effibot/thesis_latex/img/setup.jpeg

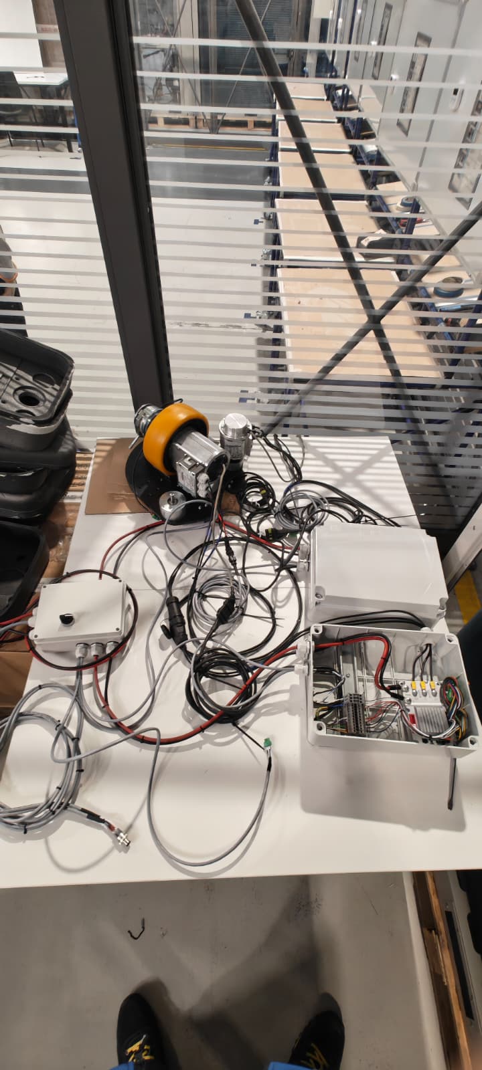
img/setup.jpeg
