effibot/thesis_latex/img/daikin/daikin_factory_ext.jpg

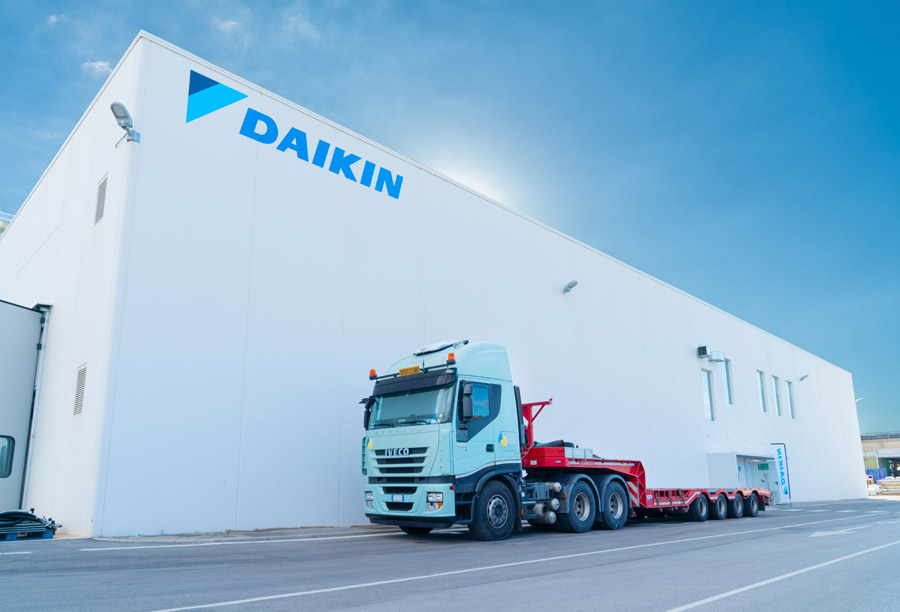
img/daikin/daikin_factory_ext.jpg
