effibot/thesis_latex/README.md

# master_thesis
 Repo for my Master Thesis in Robotics and Automation Engineering
