effibot/thesis_latex/sections/section2.tex

% Sezione 2: Robot Mobili e Algoritmi di Navigazione
\section{Stato dell'arte: robot mobili, navigazione e protocolli}

% Slide 1: Classificazione
\begin{frame}
    \frametitle{Classificazione dei Robot Mobili}

    \begin{block}{AMR vs AGV}
        \begin{itemize}
            \item \textbf{AGV}: Percorsi fissi, infrastruttura dedicata, bassa flessibilità.
            \item \textbf{AMR}: Navigazione autonoma, adattabilità, nessuna infrastruttura.
        \end{itemize}
    \end{block}

    \textbf{Tipologie di Locomozione}
    \begin{itemize}
        \item \textbf{Ruote}: Differential drive, omnidirezionali.
        \item \textbf{Cingoli}: Terreni irregolari.
        \item \textbf{Zampe}: Ambienti complessi.
        \item \textbf{Volanti}: Droni/UAV.
    \end{itemize}

\end{frame}

% Slide 2: Algoritmi di Navigazione
\begin{frame}
    \frametitle{Algoritmi di Navigazione}
    \begin{columns}
        \column{0.5\textwidth}
        \textbf{Path Planning (Globale)}
        \begin{itemize}
            \item \textbf{A*}: Ricerca ottima su griglia.
            \item \textbf{Dijkstra}: Ricerca esaustiva.
            \item \textbf{RRT}: Esplorazione probabilistica.
        \end{itemize}

        \column{0.5\textwidth}
        \textbf{Obstacle Avoidance (Locale)}
        \begin{itemize}
            \item \textbf{VFH}: Istogramma polare ostacoli.
            \item \textbf{DWA}: Ottimizzazione velocità ($v, \omega$).
            \item \textbf{Potential Fields}: Campi di forze.
        \end{itemize}
    \end{columns}
    \begin{block}{Localizzazione}
        Tecniche per stimare la posizione del robot nell'ambiente.
        \begin{itemize}
            \item \textbf{Odometry}: Basata su encoder e IMU, soggetta a deriva.
            \item \textbf{Beaconing}: Utilizzo di segnali esterni (es. RFID).
            \item \textbf{SLAM}: Simultaneous Localization and Mapping.
        \end{itemize}
    \end{block}
\end{frame}

% Slide 3: SLAM e FAST-LIO 2
\begin{frame}
    \frametitle{SLAM: FAST-LIO 2}
    \textbf{Problema}: Stimare posa e mappa simultaneamente in assenza di GPS.

    \vspace{0.5cm}
    \begin{block}{Perché FAST-LIO 2?}
        Algoritmo LiDAR-Inertial Odometry (LIO) allo stato dell'arte\footnote{Xu et al. "FAST-LIO2: Fast Direct LiDAR-Inertial Odometry", 2022;}.
        \begin{itemize}
            \item \textbf{Robustezza}: Funziona in ambienti spogli (corridoi lunghi) grazie alla \textit{registrazione diretta} (no feature extraction).
            \item \textbf{Efficienza}: Struttura \textbf{ikd-Tree} per aggiornamento mappa veloce ($>100$ Hz).
            \item \textbf{Accuratezza}: Fusione sensoriale (tightly-coupled) LiDAR + IMU.
            \item \textbf{Testato}: Già validato sul sensore acquistato (Livox Mid-360).
        \end{itemize}
    \end{block}
\end{frame}

% Slide 4: Architettura FAST-LIO 2
% \begin{frame}
%     \frametitle{Architettura FAST-LIO 2}
%     \begin{figure}[htbp]
%         \centering
%         \includegraphics[width=\textwidth]{2/fastlio2_block_diagram.png}
%         \caption{Schema semplificato: IMU $\to$ Predizione $\to$ Correzione (LiDAR) $\to$ Mappa.}
%     \end{figure}
% \end{frame}

% Slide 5: Protocolli Industriali - bus CAN
\begin{frame}
    \frametitle{Protocolli di Comunicazione: CAN Bus}
    \textbf{Controller Area Network (CAN)}: bus seriale multi-master per autoveicoli.
    \begin{block}{Caratteristiche Principali}
        \begin{itemize}
            \item \textbf{Architettura Multi-Master}: Tutti i nodi possono trasmettere.
            \item \textbf{Arbitraggio Non-Distruttivo}: Priorità basata su ID messaggio.
            \item \textbf{Rilevamento Errori}: CRC, bit stuffing, monitoraggio ACK.
            \item \textbf{Velocità}: Fino a 1 Mbps su brevi distanze.
        \end{itemize}
    \end{block}

    \begin{block}{Applicazioni Industriali}
        Utilizzato in automotive, automazione industriale, robotica mobile.
    \end{block}
\end{frame}
% Slide 5: Protocolli Industriali - CANopen
\begin{frame}
    \frametitle{Protocolli di Comunicazione: CANopen}
    \textbf{CANopen}: protocollo applicativo su CAN per automazione industriale.\\

    \begin{columns}
        \column{0.5\textwidth}
        \textbf{Componenti Principali}
        \begin{itemize}
            \item \textbf{Object Dictionary (OD)}: dizionario parametri dispositivo.
            \item \textbf{PDO}: messaggi real-time (velocità, encoder).
            \item \textbf{SDO}: configurazione parametri (client-server).
            \item \textbf{NMT}: gestione stati nodi.
        \end{itemize}

        \column{0.4\textwidth}
        \begin{block}{Estensione: Profilo CiA 402}
            \begin{itemize}
                \item Standard per azionamenti elettrici
                \item Macchina a stati
                \item Modalità: Velocity, Position, Torque
            \end{itemize}
        \end{block}
    \end{columns}
\end{frame}
% \begin{frame}
%     \frametitle{Protocolli di Comunicazione: CANopen}
%     \begin{block}{Scelta per il Progetto}
%         \begin{itemize}
%             \item Standardizzazione CiA 402 (driver Mini-Traction Power)
%             \item Determinismo temporale (PDO sincronizzati)
%             \item Diagnostica integrata (heartbeat, emergency)
%             \item Interoperabilità (batteria + driver compatibili)
%         \end{itemize}
%     \end{block}
% \end{frame}

% Slide 6: Panoramica Altri Protocolli
% \begin{frame}
%     \frametitle{Altri Protocolli Industriali}
%     \textbf{Alternative valutate} (non adottate per il progetto):

%     \vspace{0.3cm}
%     \begin{table}[htbp]
%         \centering
%         \small
%         \begin{tabular}{|l|p{6cm}|p{4cm}|}
%             \hline
%             \textbf{Protocollo} & \textbf{Caratteristiche}                             & \textbf{Limitazioni}                    \\
%             \hline
%             \textbf{EtherCAT}   & Ethernet industriale, latenze $<$ 1 ms, master-slave & Hardware dedicato, maggiore complessità \\
%             \hline
%             \textbf{PROFINET}   & Ethernet Siemens, alta integrazione IT               & Meno diffuso in robotica mobile         \\
%             \hline
%             \textbf{Modbus TCP} & Semplice, su TCP/IP                                  & Latenze non deterministiche             \\
%             \hline
%         \end{tabular}
%     \end{table}

%     \vspace{0.3cm}
%     \begin{alertblock}{Motivazione Scelta CANopen}
%         Miglior compromesso tra prestazioni, standardizzazione (profili CiA 402), disponibilità componenti compatibili e costi contenuti.
%     \end{alertblock}
% \end{frame}
