effibot/thesis_latex/chapters/frontespizio.tex

% Frontespizio - Template Università di Roma Tor Vergata
\begin{titlepage}
    \centering

    % Intestazione università e facoltà
    {\Large\bfseries UNIVERSITÀ DEGLI STUDI DI ROMA TOR VERGATA}\\[0.3cm]
    {\large MACROAREA DI INGEGNERIA}

    \vspace{1cm}

    % Logo università (inserisci il file logo_torvergata.png in img/)
    

    \vspace{1cm}

    % Corso di studio
    {\large\bfseries CORSO DI LAUREA MAGISTRALE IN}\\
    {\itshape Ingegneria dell'Automazione}

    \vspace{0.8cm}

    % Tesi di laurea
    {\large\bfseries TESI DI LAUREA IN}\\
    {\itshape Analisi e Sintesi di Sistemi Non Lineari}

    \vspace{0.8cm}

    % Titolo
    {\large\bfseries TITOLO}\\
    {\itshape Progettazione e Realizzazione di un \\Veicolo da Trasporto Teleoperato in CANOpen}

    \vspace{1.5cm}

    % Relatore e Laureando affiancati
    \begin{minipage}[t]{0.48\textwidth}
        \raggedright
        \textbf{Relatore:}\\
        Chiar.mo Prof.\\
        \textit{Daniele Carnevale}\\[0.8cm]
        \textbf{Correlatore:}\\
        \textit{Roberto Masocco}, Ph.D.\\
        Ing. \textit{Moreno Mattia}
    \end{minipage}
    \hfill
    \begin{minipage}[t]{0.48\textwidth}
        \raggedleft
        \textbf{Laureando:}\\
        \textit{Andrea Efficace}\\
        Matricola: 0300125
    \end{minipage}

    \vfill
    {\large\bfseries Anno Accademico 2024/2025}
\end{titlepage}
