effibot/thesis_latex/on_progress.pdf

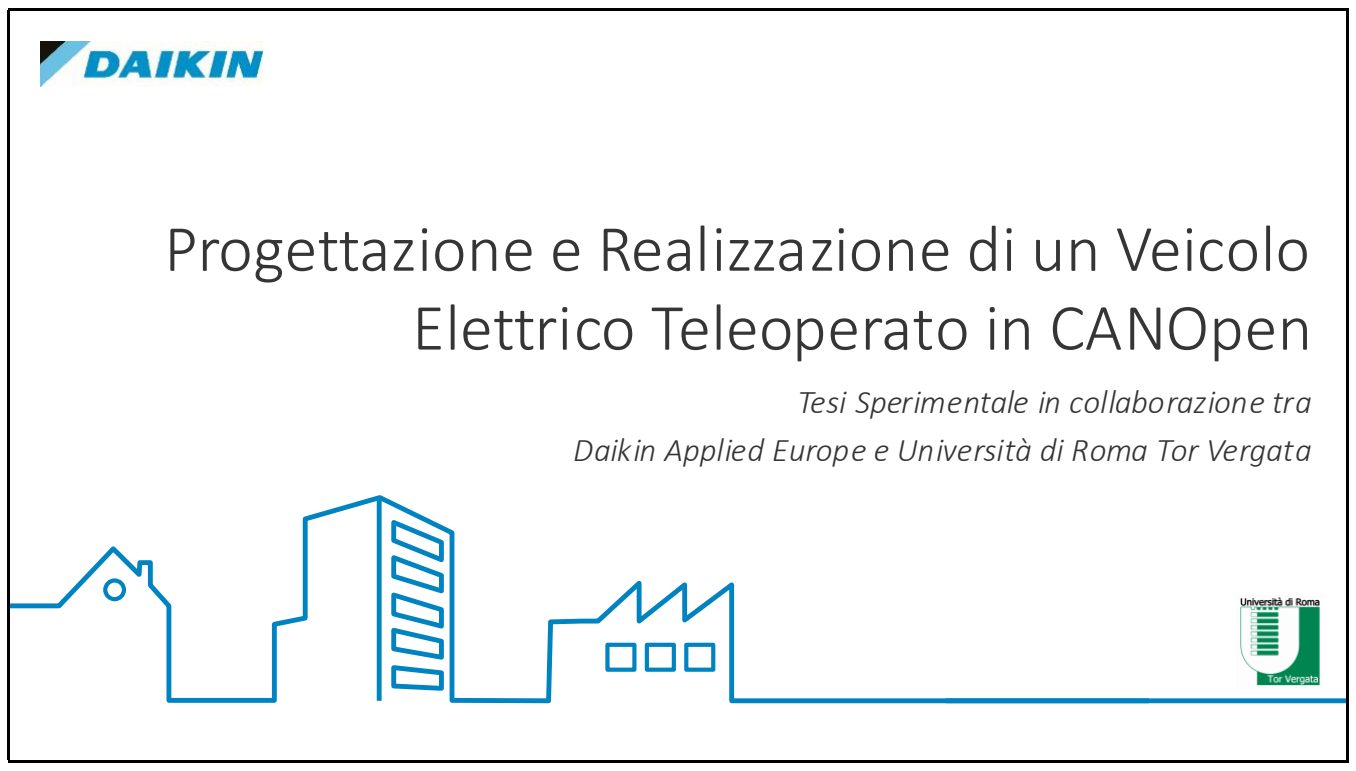
[picture p3: figure]
Top secret Secret Internal use only Public; Elettrico Teleoperato in CANOpen; Tesi Sperimentale in collaborazione tra

# Progettazione e Realizzazione di un Veicolo

Daikin Applied Europe e Università di Roma Tor Vergata

## 1. Introduzione

## 2. Definizione del Problema

## 3. Obiettivi di Progetto e Design

## 4. Selezione Componenti

## 5. Architettura di Comunicazione e Controllo

## 6. Stato dei Lavori

3

# Introduzione

## La realtà di DAE e l’importanza dell’automazione

1.

4 Introduzione

- Produzione di macchinari industriali per la climatizzazione
- Produzione Make-to-Order e poco standardizzata
- Forte crescita della domanda
- Espansione della produzione e del personale
- Scarsa digitalizzazione dei processi produttivi (non R&D)
- Grande necessità di automatizzazione:
- Gestione documenti
- Tracciabilità dei componenti
- Logistica

La Realtà di Daikin Applied Europe - Cecchina

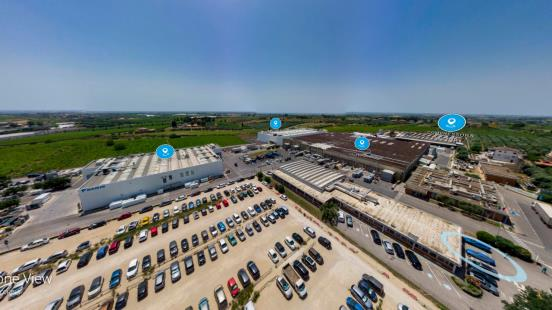
[picture p4: figure]

Fig. 1: Stabilimento di Cecchina (RM)

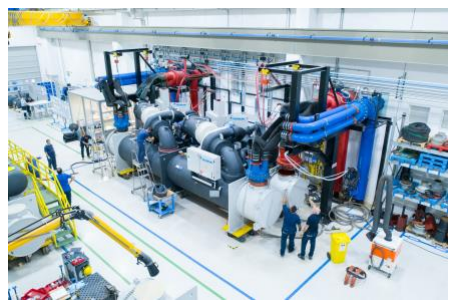
[picture p5: figure]

Fig. 2: Banco Prova Chiller

5 Introduzione

Tipologia di movimentazione ad Oggi:
- Manuale
- O tramite muletti
- Basata su richieste giornaliere dei responsabili di produzione
- Ad alto costo per la mano d’opera
- Con notevoli ritardi e rallentamenti di produzione dovuti alla ricerca del pezzo

Tipologia di Movimentazione Futura:
- Attuata con una flotta di veicoli elettrici
- Controllati tramite sistemi di guida autonoma / controllo remoto
- Mediante un sistema centralizzato di schedulazione e gestione della logistica
- Con un costo ammortizzabile negli anni
- Permettendo ottimizzazioni nei processi produttivi, dalla supply chain fino alla delivery

L’idea di un Veicolo Autonomo per il trasporto di sottoassiemi e semilavorati

6

# Definizione del Problema

# Realizzare da zero un veicolo autonomo

2.

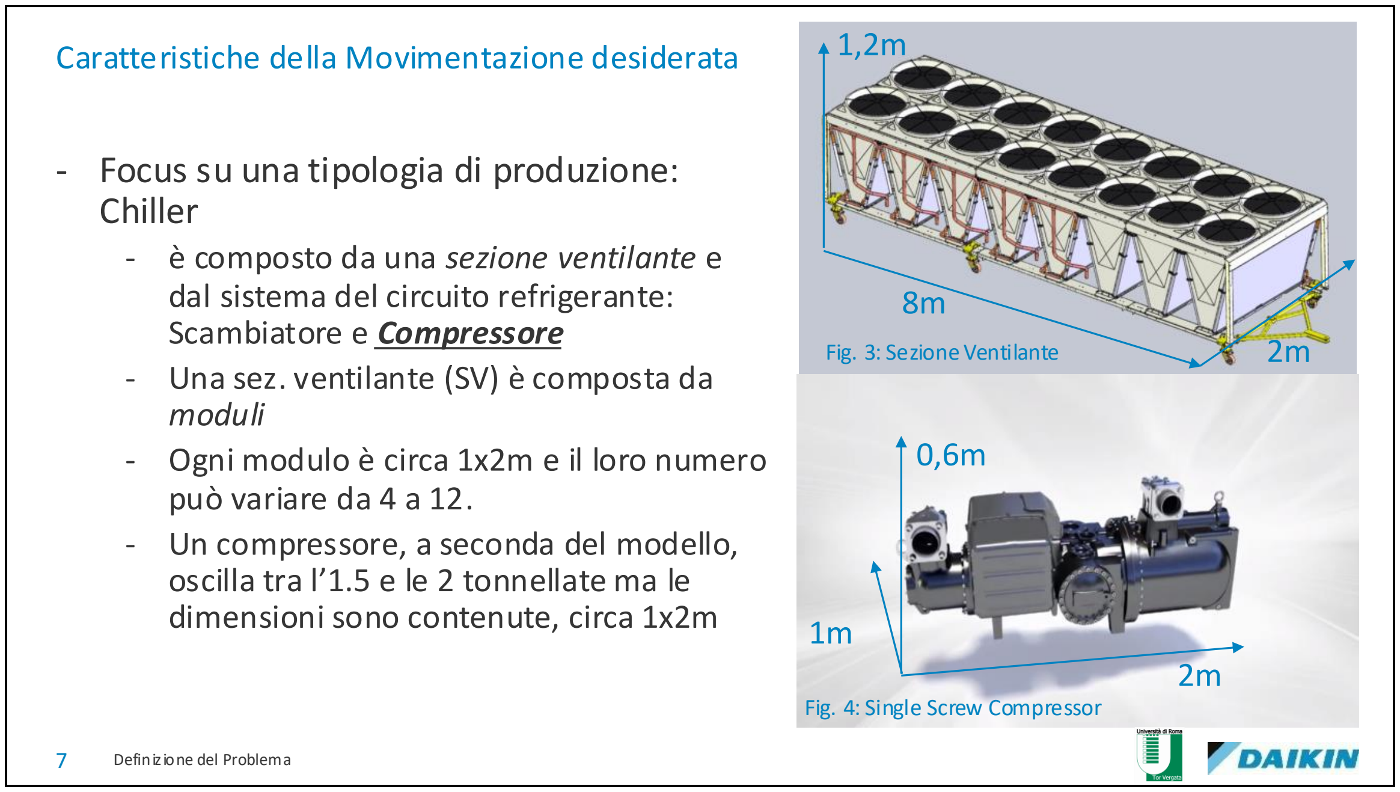
[picture p6: figure]
Definizione del Problema; Caratteristiche della Movimentazione desiderata; - Focus su una tipologia di produzione: Chiller; dal sistema del circuito refrigerante: Scambiatore e Compressore; moduli; può variare da 4 a 12.; dimensioni sono contenute, circa 1x2m; Fig. 3: Sezione Ventilante; Fig. 4: Single Screw Compressor

- è composto da una sezione ventilante e
- Una sez. ventilante (SV) è composta da
- Ogni modulo è circa 1x2m e il loro numero
- Un compressore, a seconda del modello, oscilla tra l’1.5 e le 2 tonnellate ma le

8 Definizione del Problema

Caratteristiche della Movimentazione desiderata

## - Focus su una tipologia di produzione: Chiller - Focus su un particolare sottoassieme: Compressore

- Supporti di appoggio standard con pedana
- Dimensioni contenute e fisse
- Carico elevato ma non eccessivo
- Semplice da caricare sul veicolo

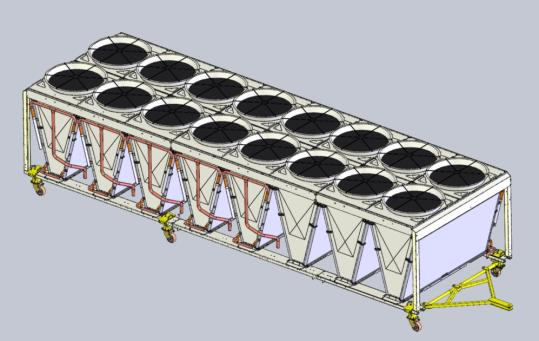
[picture p7: figure]

Fig. 3: Sezione Ventilante

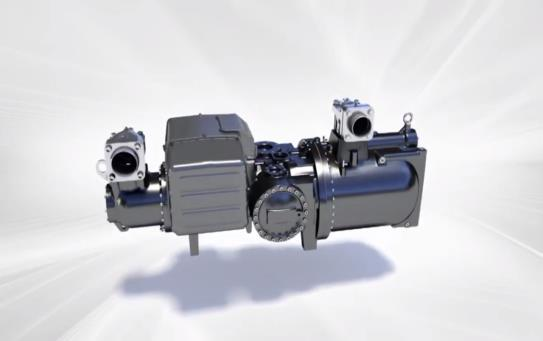
[picture p8: figure]

Fig. 4: Single Screw Compressor

9 Definizione del Problema

Caratteristiche della Movimentazione desiderata

- Focus su una tipologia di produzione: Chiller
- Focus su un particolare sottoassieme: Compressore
- Trasporto dalla piazza di stoccaggio fino alla linea:
1. Una volta prodotto viene stoccato all’aperto in una piazzola
2. Deve essere caricato sul veicolo
3. Trasportato verso il capannone Chiller, affrontando un percorso in esterna con dislivelli leggeri sotto i 10°
4. Posizionato nella stazione di montaggio per essere scaricato dal veicolo
5. Ritorno del veicolo alla stazione di attesa

Fig. 3: Sezione Ventilante

Fig. 4: Single Screw Compressor

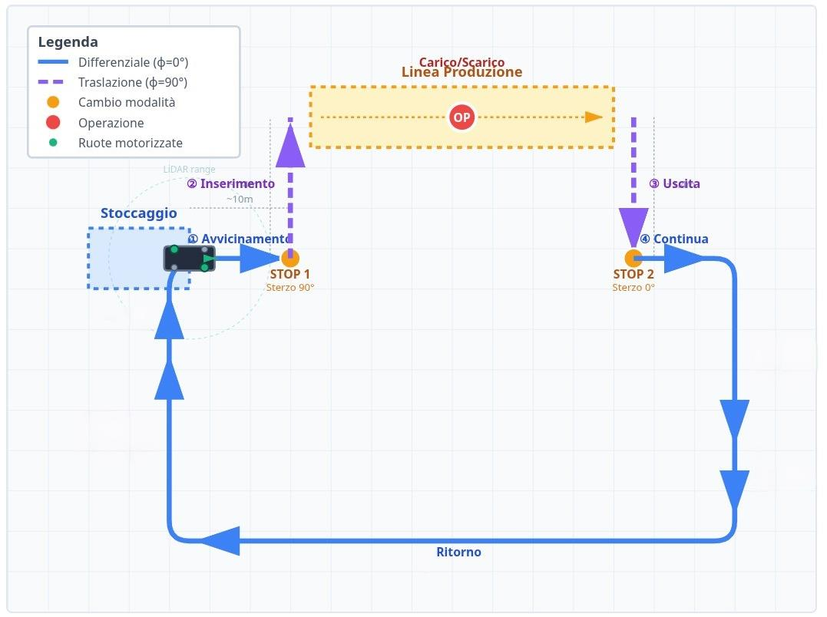
[picture p9: figure]

### 1. Avvicinamento dalla piattaforma di stoccaggio alla stazione della linea di produzione 2. Inserimento nella stazione di produzione mediante traslazione rigida 3. Uscita dalla stazione di produzione mediante stazione rigida 4. Proseguimento e/o ritorno alla piattaforma di stoccaggio

10 Design della Soluzione

Percorso Operativo previsto per il prototipo

11 Design della Soluzione

Requisiti di alto livello

- Intelaiatura adatta al trasporto di carichi elevati - Punti di ancoraggio per il payload - Motori con coppia sufficiente a trasportare i carichi richiesti - Meccanismi di sterzo - Rilevazione degli ostacoli e localizzazione - No telecamere (privacy) - Batteria ad alta capacità per offrire servizio continuativo - Velocità di crociera bassa (max 3 km/h) - Mantenere i costi più bassi possibili

12

# Obiettivi di progetto e Design

## Il prototipo, come farlo muovere e con cosa equipaggiarlo

3.

13 Obiettivi e Design

Obiettivi di progetto

### 1. Selezione Hardware 2. Modellazione Matematica 3. Progettazione Meccanica 4. Progettazione Elettrica 5. Progettazione Architettura di Controllo 6. Progettazione Architettura di Comunicazione 7. Selezione dei Fornitori 8. Messa in opera (in corso)

14 Obiettivi e Design

Design del Prototipo – Selezione Componenti
- Telaio con profilati in acciaio
- Ruote motorizzate sterzanti
- Solo 2 attuazioni, ognuna con motore di trazione e sterzo
- 4 driver per motori elettrici
- Encoder per ciascun motore
- Gomme in poliuretano
- LiDAR + IMU
- SLAM, feedback posa
- Batteria con chimica LiFePO4
- Sicurezza, alta efficienza e capacità
- On-Board PC con CPU x86
- Compatibilità con OS moderni
- Flessibilità per sviluppi futuri

15 Obiettivi e Design

- Biciclo con ruote attuate sulla diagonale del robot
- Gestione degli sterzi indipendente
- Gestione delle velocità tangenziali delle ruote indipendenti
- Vengono trascurati i disturbi causati dalle ruote passive
- Formulazione puramente cinematica
- Con alcune criticità

Design del Prototipo – Modellazione Matematica

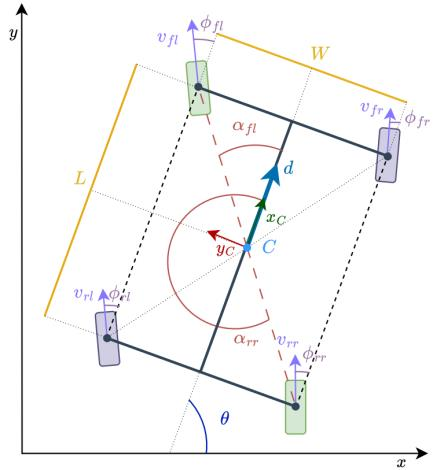
[picture p10: figure]

Fig. 7a: Schematizzazione del prototipo. In verde le ruote attuate

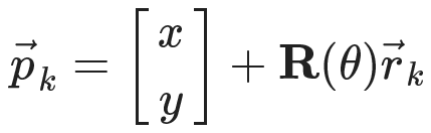
[picture p11: figure]

16 Obiettivi e Design

- Posizione del centro di una ruota

Design del Prototipo – Modellazione Matematica

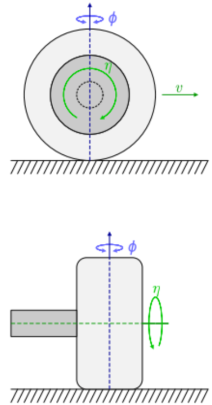
[picture p12: figure]

Fig. 7b: Cinematica di
una ruota sterzante
- Velocità del centro di una ruota

17 Obiettivi e Design

Design del Prototipo – Modellazione Matematica

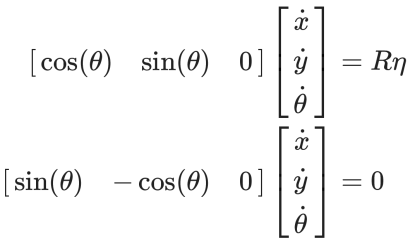
[picture p13: figure]

- Imponendo i vincoli | - Cinematica Diretta
- Vincoli:

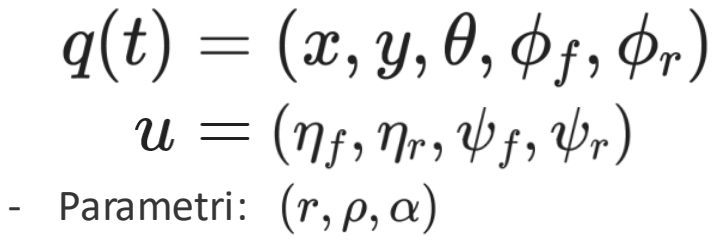
[picture p14: figure]
- Parametri:

18 Obiettivi e Design

Design del Prototipo – Modellazione Matematica

Fig. 7a: Schematizzazione del prototipo. In verde le ruote attuate

- Stato con due ruote
- Assunzioni:

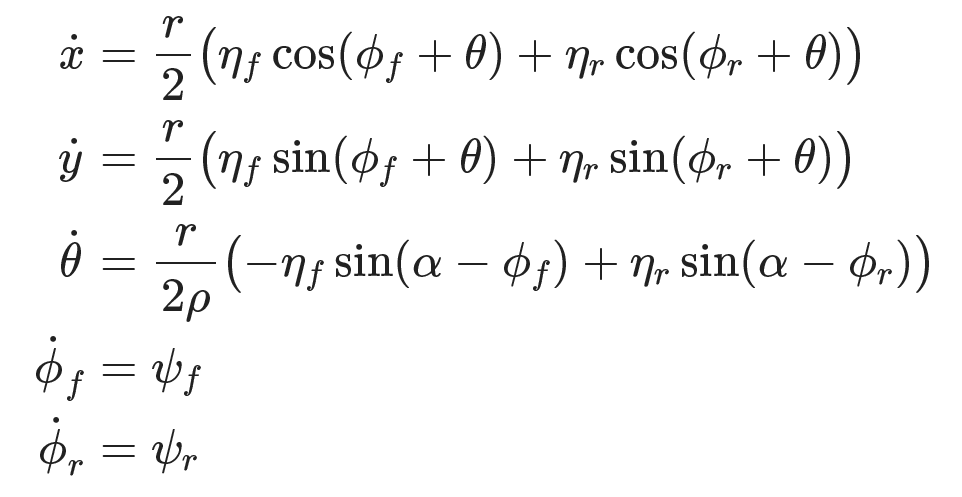
[picture p15: figure]

19 Obiettivi e Design

Design del Prototipo – Modellazione Matematica

Fig. 7a: Schematizzazione del prototipo. In verde le ruote attuate

- Rappresentazione nello spazio di stato

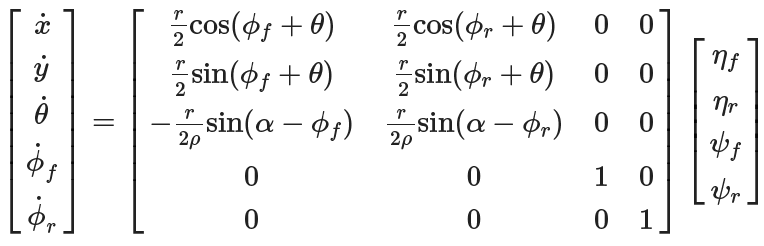
[picture p16: figure]

20 Obiettivi e Design

Design del Prototipo – Modellazione Matematica

Fig. 7a: Schematizzazione del prototipo. In verde le ruote attuate

- Equivalentemente
- E’ stata eseguita analisi della controllabilità costruendo l’algebra di Lie, impilando:
- E’ stata verificata la controllabilità con rango 5

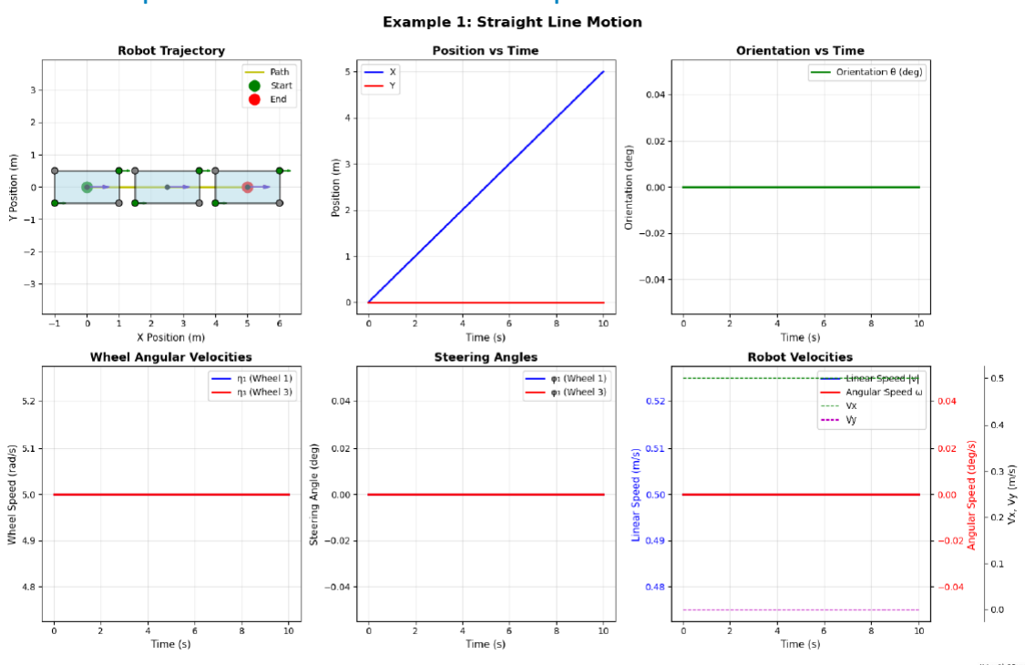
[picture p17: figure]

21 Obiettivi e Design

Design del Prototipo – Simulazione in Catena Aperta

Fig. 7c: Moto Rettilineo

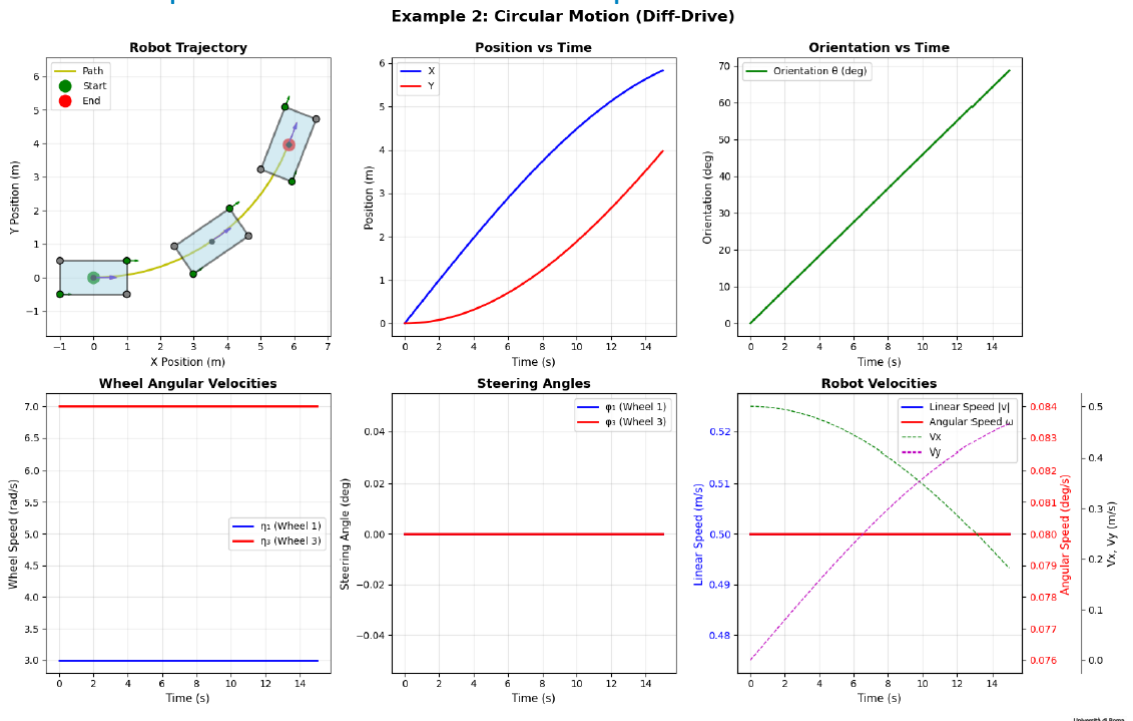
[picture p18: figure]

22 Obiettivi e Design

Design del Prototipo – Simulazione in Catena Aperta

Fig. 7d: Moto Curvilineo

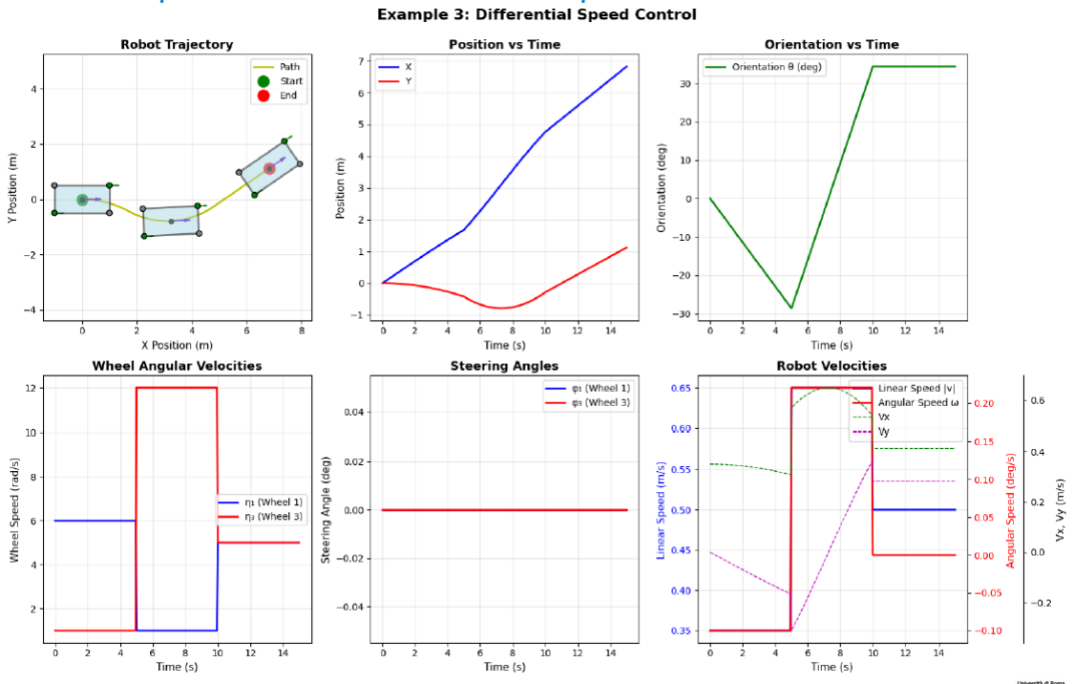
[picture p19: figure]

23 Obiettivi e Design

Design del Prototipo – Simulazione in Catena Aperta

Fig. 7e: Moto misto

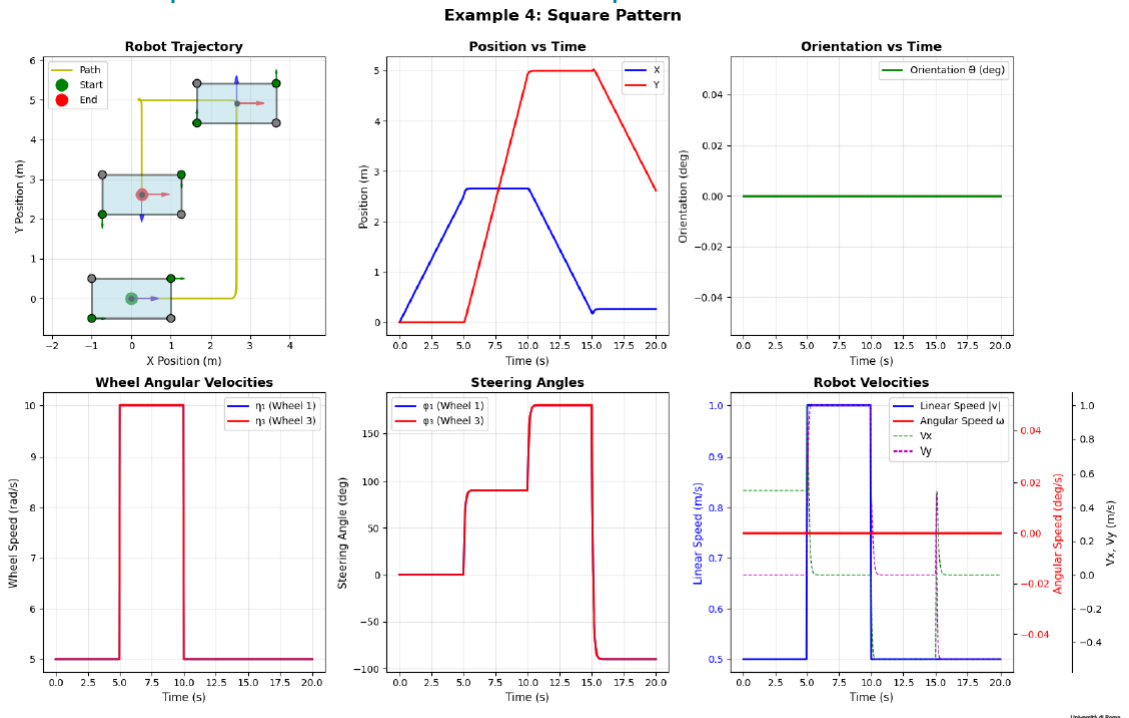
[picture p20: figure]

24 Obiettivi e Design

Design del Prototipo – Simulazione in Catena Aperta

Fig. 7f: Moto su traiettoria rettangolare

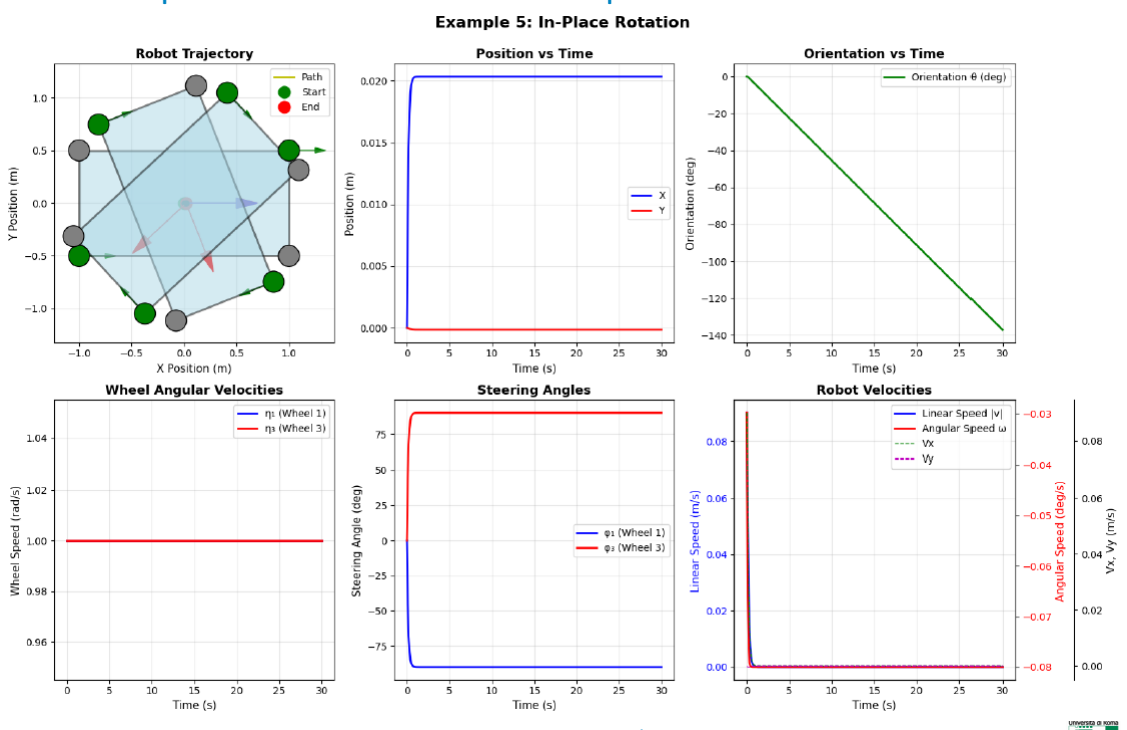
[picture p21: figure]

25 Obiettivi e Design

Design del Prototipo – Simulazione in Catena Aperta

Fig. 7g: Rotazione sul posto

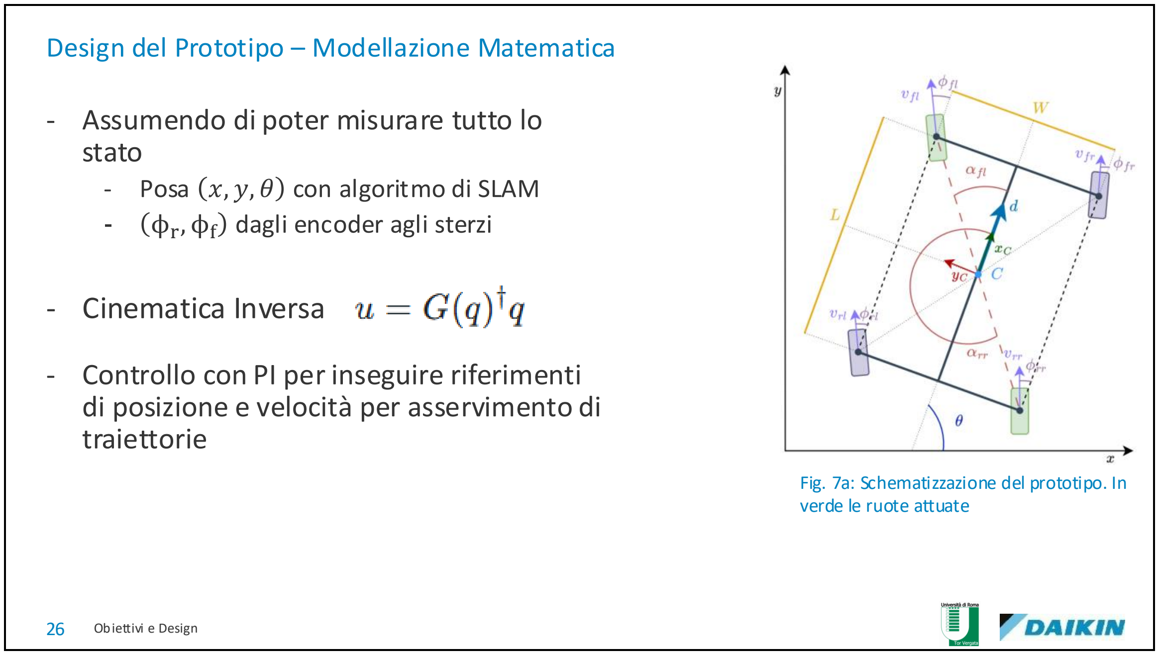
[picture p22: figure]
Obiettivi e Design; verde le ruote attuate; - Cinematica Inversa; - Assumendo di poter misurare tutto lo stato - Posa x, y, θ con algoritmo di SLAM - ϕr; , ϕf dagli encoder agli sterzi; traiettorie

Design del Prototipo – Modellazione Matematica

Fig. 7a: Schematizzazione del prototipo. In

- Controllo con PI per inseguire riferimenti di posizione e velocità per asservimento di

27 Obiettivi e Design

Design del Prototipo – Modellazione Matematica - Criticità

- I vincoli di non-slittamento non vengono sempre rispettati
- Non sono considerati limiti sulle variabili di controllo
- Non è tenuto conto di eventuali errori di misura
- Se la dimensione orizzontale del corpo è molto elevata rispetto quella verticale, il modello perde di senso
- Dinamiche degli sterzi semplificata
- E’ in corso lo sviluppo di un’approssimazione al primo ordine per considerare un ritardo di tempo
- Ci sono alcune configurazioni singolari non mappate (es: angoli uguali, velocità contrarie)
- Risolvendole in cinematica inversa: problemi di ottimizzazione vincolata su velocità di rotazione delle ruote e valore degli sterzi
- Risolvendole in cinematica diretta: modificare il modello cinematico inserendo sterzo di Ackermann o vincolando a priori le velocità tangenziali e gli orientamenti degli sterzi
- Risolvendole in generazione di traiettorie con ottimizzazione di vincoli
- Si assume che le condizioni operative non rientrino in queste casistiche

28 Obiettivi e Design

Design del Prototipo – Progettazione Meccanica

- Progettazione virtuale in 3D con Solidworks
- Caratteristiche principali:
- Dimensioni: 1x2x0.4 m
- Realizzato con profilati in acciaio a sez. quadrata da 20mm, saldati
- Peso complessivo di circa 500 kg
- Supporti extra:
- Lamiere per alloggiamento componenti
- Regolabili per l’alloggiamento del payload
- Progetto validato al sostegno dei carichi mediante analisi FEM
- Lavorazioni in acciaio realizzate da ditta fornitrice specializzata

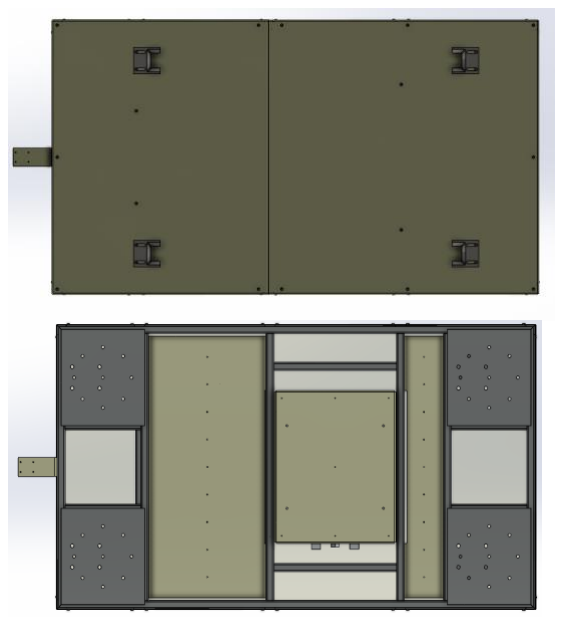
[picture p23: figure]

Obiettivi e Design

Fig. 5a 5b: Vista dall’alto e dal basso del telaio

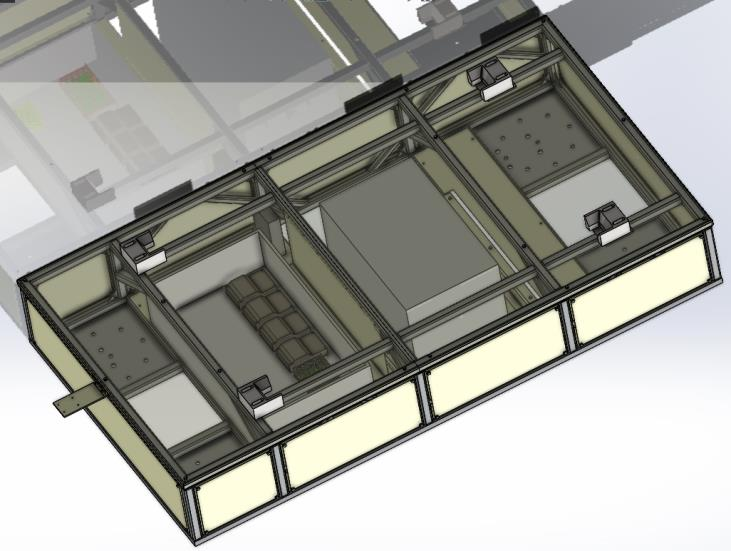
[picture p24: figure]

Fig. 6: Vista di taglio, senza i pannelli superiori. Si possono osservare la batteria e il quadro elettrico contente i driver e il computer di bordo

29

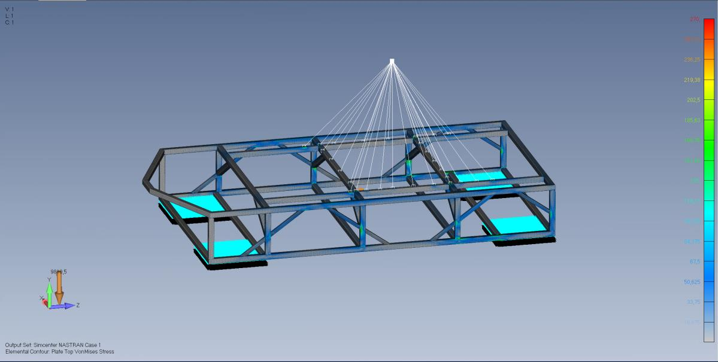
[picture p25: figure]

Obiettivi e Design

Fig. 6b: Simulazione FEM del telaio

30

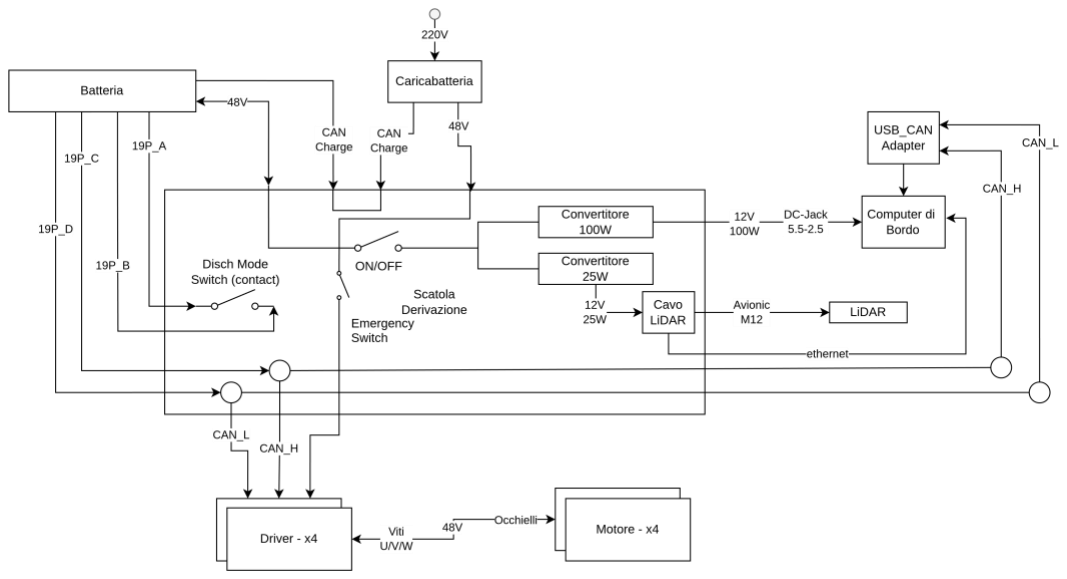
[picture p26: figure]

31 Obiettivi e Design

Design del Prototipo – Progettazione Elettrica

32

# 4. Selezione Componenti

33 Selezione Componenti

## - Compatte - Facilmente installabili sul telaio

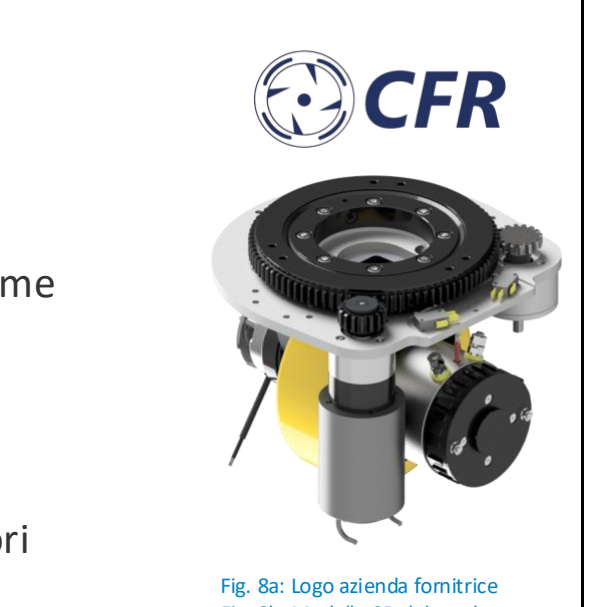
[picture p27: figure]
Fig. 8a: Logo azienda fornitrice

## - Un solo fornitore per attuatori e gomme - Encoder SIN/COS su ogni motore - Termoresistenze su ogni motore - Fine corsa per limiti di sterzo

### - Flessibilità di posizionamento attuatori

## per sperimentazioni future

Selezione Componenti – Motoruote

Fig. 8b: Modello 3D del prodotto

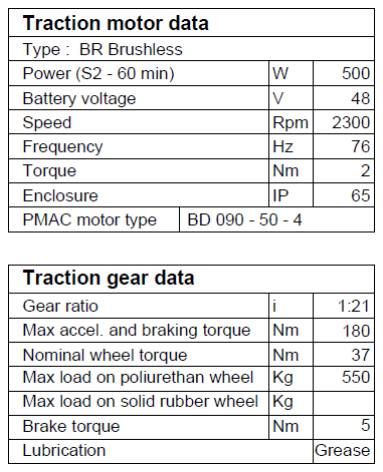
[picture p28: figure]

34 Selezione Componenti

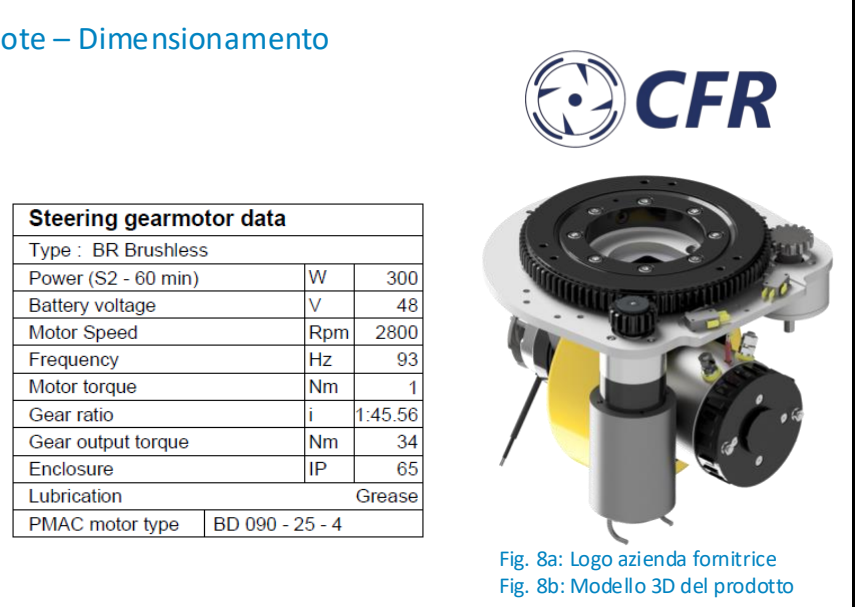
[picture p29: figure]
Fig. 8a: Logo azienda fornitrice Fig. 8b: Modello 3D del prodotto

Selezione Componenti – Motoruote – Dimensionamento

35 Selezione Componenti

## - Compatto: 65x48x60mm - Costo medio-basso - Field of View: 360° x 59 °

- Dotato di IMU
- SDK open source, attivamente sviluppato e integrato in algoritmi di SLAM

## - Cono cieco

- Posizionato verso il basso

Selezione Componenti – LiDAR

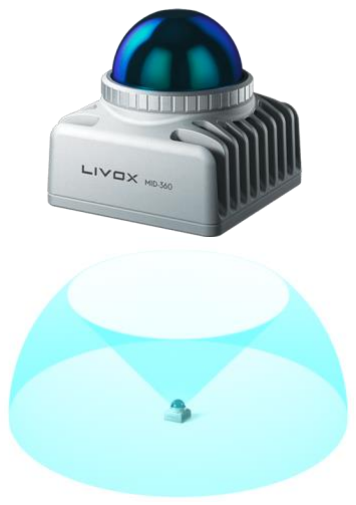
[picture p30: figure]

Fig. 10a: Dji LIVOX MID 360
Fig. 10b: Rappresentazione del campo visivo del sensore

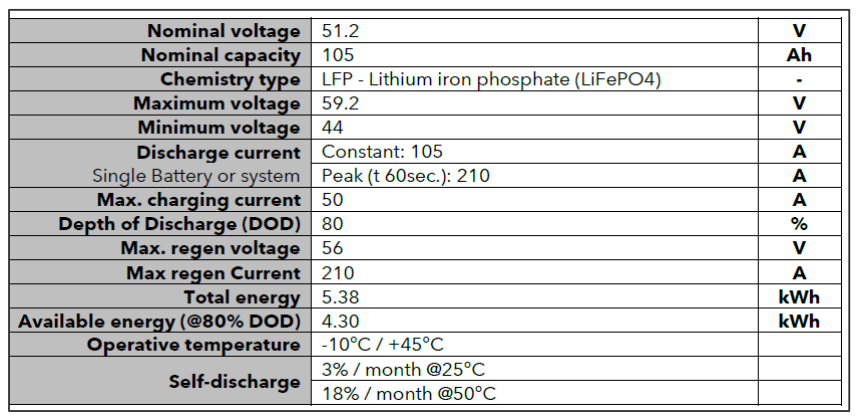
[picture p31: figure]

36 Selezione Componenti

- Batteria LiFePO4
- Agli ioni di litio
- Più sicuro delle normali batterie industriali
- Con Battery Management System comunicante in CANOpen
- Prodotta da una della aziende leader in Italia del settore

Selezione Componenti – Alimentazione

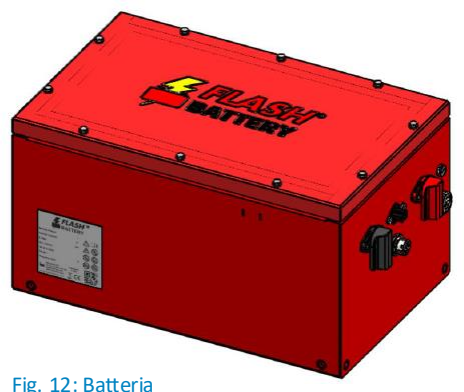
[picture p32: figure]

Fig. 12: Batteria

37 Selezione Componenti

- Alimentazione a 48V in linea con le specifiche
- Configurabili per accettare encoder Sin/Cos come segnali di ingresso
- Controllati ad alto livello tramite protocollo CANOpen
- Controllo delle fasi dei motori tramite PID
- Tuning effettuato dalla ditta in fase di acquisto

Selezione Componenti – Driver MicroPHASE Mini-Traction PWR

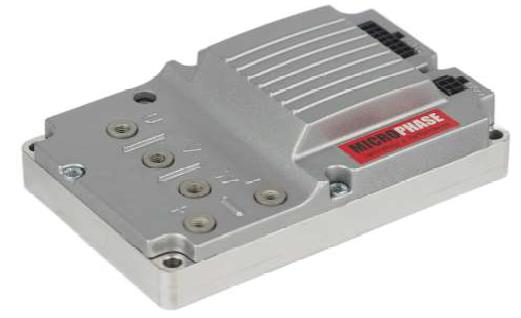
[picture p33: figure]

Fig. 11: Driver Microphase

38 Ricerca ed Acquisto Componenti

- LattePanda Sigma:
- Dimensioni contenute
- CPU x86, Intel Core i5-1340P: 12 core, 16 thread fino a 4.6Ghz
- 16 GB RAM
- Development board con GPIO
- Alimentazione contenuta tra i 12 e i 20V. Consumi medi attorno i 90W
- Compatibile con Windows e Linux
- Microcontrollore Arduino Mega accoppiato

Selezione Componenti – Computer di Bordo

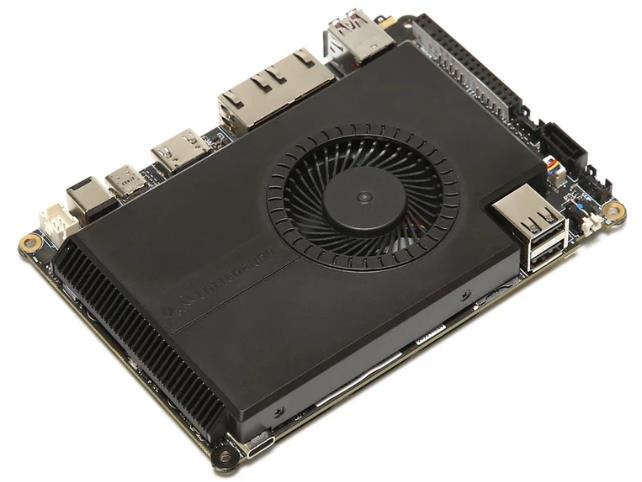
[picture p34: figure]

Fig. 13: Single board computer Lattepanda Sigma

39 Selezione Componenti

- Soluzione commerciale a basso costo
- Rapidamente reperibile

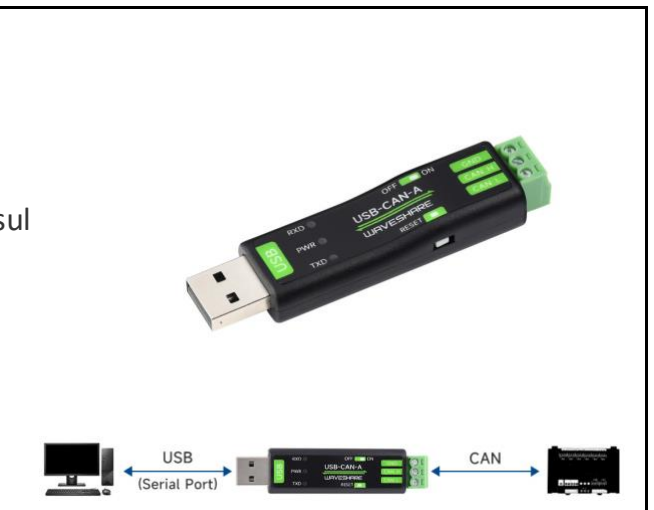
[picture p35: figure]

- Traduce messaggi seriali in segnali analogici sul bus di campo
- Non implementa protocollo CANOpen
- Non implementa il driver per il protocollo SocketCAN del kernel Linux

Adattatore USB-CANBus

Fig. 13a: Adattatore USB-CAN-A
Fig. 13b: Schema di connessione PC – Dispositivo CAN

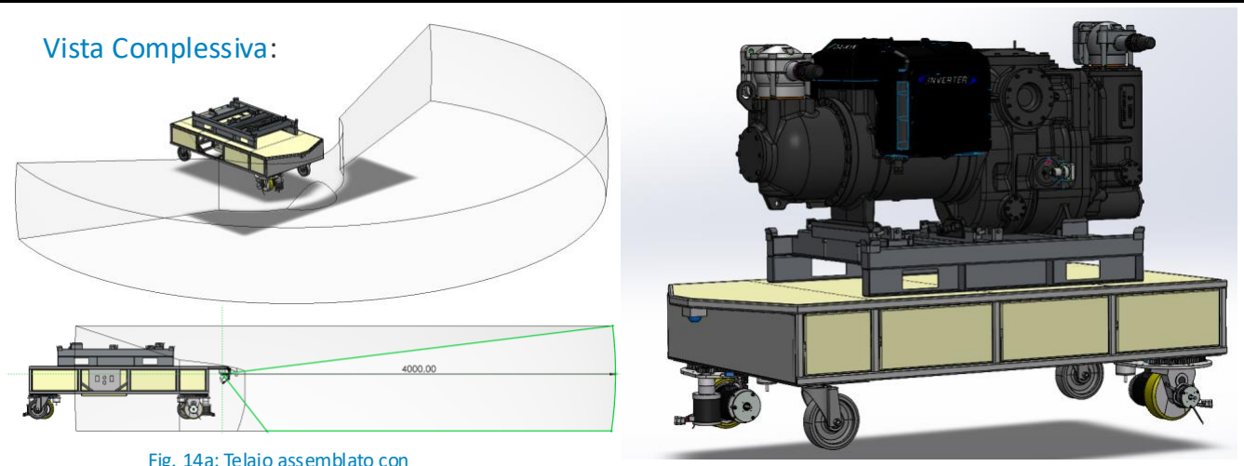
[picture p36: figure]
Vista Complessiva:

40 Title - Internal use only

Fig. 14a: Telaio assemblato con
motoruote e LiDAR montato.
Simulazione del campo visivo | Fig. 14b: Telaio assemblato con motoruote e LiDAR montato.
| Al di sopra, compressore con la sua pedana di stoccaggio

41

# Architettura di 5. Comunicazione e Controllo

### (un «file» sotto file-system Linux, disponibile sotto /dev/ttyUSB*)

42 Architettura di Comunicazione

Architettura di Comunicazione – Layer di Comunicazione

- Diversi device, con diverse interfacce:
- Driver: CANOpen, protocollo CIA 301 e CIA 402
- LiDAR: SDK, ROS2 wrapper. Connesso in sottorete con il PC
- USB-CAN-A adapter: Char Device, con protocollo proprietario ma integrabile
- BMS Batteria: CANOpen con implementazione parziale (solo errori e stato carica)
- Setup software sul SBC:
- Linux (Ubuntu 24.04)
- ROS2 come gestore dei task e dello strato applicativo
- Docker per lo sviluppo e il deployment in ambiente isolato
- Possibilità di integrazione di web-server per operazioni remote data la potenza della board

- Object Dictionary (OD): ad albero (id e sub-id) contenente i parametri del dispositivo, le configurazioni, i comandi e gli errori - Process Data Object (PDO): pacchetti per messaggi senza overhead per trasmissioni rapide (es. letture sensori, assorbimento corrente) per controllo real-time - Service Data Object (SDO): pacchetti per leggere/scrivere nelle aree di

memoria dell’OD, per configurazione, diagnostica e tuning.

### - Network Management (NMT): monitora lo stato dei nodi - Heartbeat: per la verifica della presenza di un nodo nella rete

43 Architettura di Comunicazione

- CAN (Controller Area Network): livello fisico e data-link del modello ISO/OSI, sviluppato da Bosch per il settore automotive.
- Garantisce alta affidabilità e velocità di comunicazione
- Fino a 1Mbit/s con protocollo classico, più elevate per le versioni avanzate (CAN FD)
- Multi-Master con auto arbitraggio per evitare collisioni basate su ID dei pacchetti
- Non contiene specifiche applicative
- Auto rilevamento e gestione degli errori con CRC e ACK
- Il protocollo CANOpen descrive lo strato applicativo sopra il CAN.
- Elementi fondamentali:
- Object Dictionary (OD)
- Process Data Object (PDO)
- Service Data Object (SDO)
- Network Management (NMT)
- Heartbeat
- Standardizza i profili di dispositivo:
- Con protocolli aggiuntivi (CiA 402 per i driver elettrici)
- Definendo gli Electrical Datasheets (EDS) che descrivono la mappatura degli indirizzi di memoria delle entry dell’OD

Architettura di Comunicazione – CAN vs CANOpen

44 Architettura di Comunicazione

- Framework software open-source per lo sviluppo di sistemi robotici
- Funzionamento distribuito tramite architettura a nodi e protocollo pub/sub
- Gestione di architetture più complesse come servizi
request/response e action server
- Gestione completa della
comunicazione

Architettura di Comunicazione – ROS2

Fig. 15: Logo ROS2

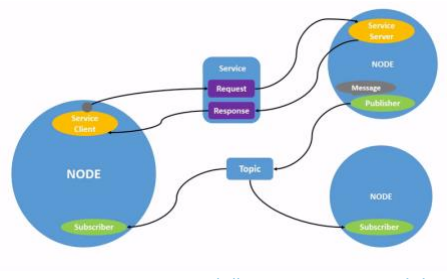
[picture p37: figure]

Fig. 16: Animazione della comunicazione di base tra nodi tramite topic mediante protocollo pub-sub

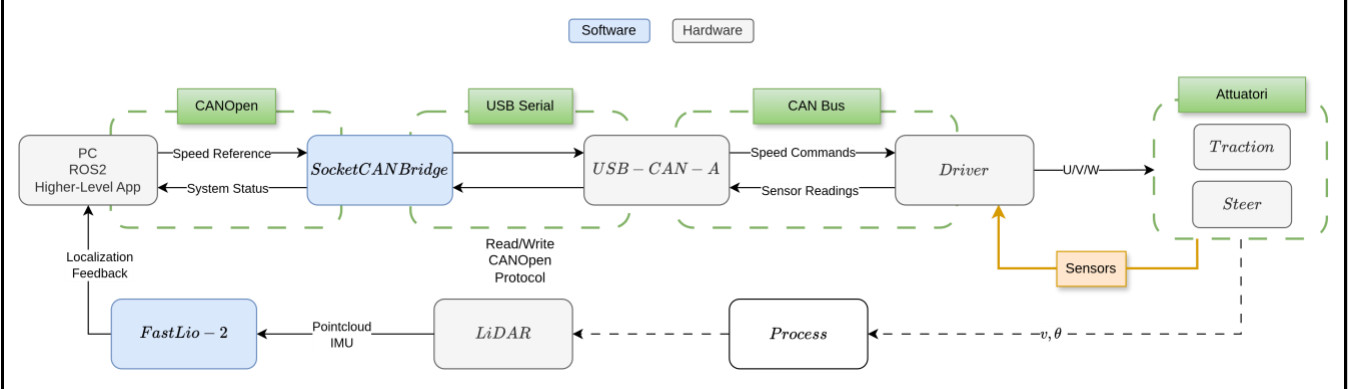
[picture p38: figure]

# - Il computer di bordo apre una CAN virtual network e si connette ad essa tramite il SocketCAN Bridge - Il bridge apre e gestisce in modo concorrente la porta seriale dove è collegato l’adattatore USB - Il computer, conoscendo la mappatura del driver, genera

messaggi usando protocollo CANOpen (CIA 301,

CIA402) che vengono «semplicemente» tradotti in un flusso di byte e inviati al driver tramite canale fisico - Il LiDAR produce misurazioni pointcloud e le invia al computer assieme alle rilevazioni inerziali dell’IMU interna - Driver e motori sono collegati tramite cavi di potenza e cavi per la lettura dei sensori

45 Architettura di Comunicazione

Architettura di Comunicazione – Vista ad alto livello

Fig. 17: Schema ad alto livello dell’architettura del sistema

- Il Driver riceve segnali di riferimento in protocollo CANOpen e li traduce in segnali di corrente per controllare le fasi dei motori elettrici - Le rilevazioni di velocità e di orientamento vengono usate dalla rappresentazione del modello per generare ulteriori riferimenti di velocità e orientamento

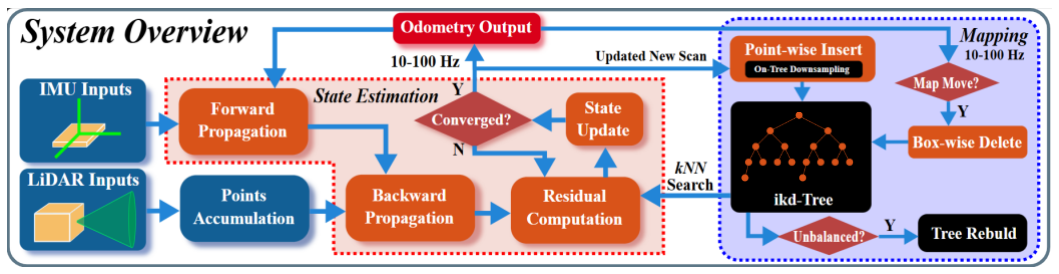
[picture p39: figure]

### Uso diretto delle feature del lidar: no identificazione geometrie

Durante la fase di Forward Propagation vengono integrate le misure dell’IMU per fare predizione sulla posa e la velocità del SDR del sensore, da un’istante t_k all’istante t_k+1. Viene letta accelerazione e velocità angolare tra i 200 e i 1000Hz ed eseguito un passo di integrazione usando un adeguato modello cinematico continuo, poi viene aggiornata la matrice della covarianza usando un modello

dinamico lineare.

Durante la fase di Backward Propagation si associano le predizioni grezze della posa a ogni punto rilevato in quel k-esimo istante e viene fatta un’operazione di motion-compensation facendo delle trasformazioni all’indietro per sincronizzare tutti i punti prodotti dall’ultima scansione prodotta dal LiDAR

### I punti vengono quindi registrati nell’albero, sul quale viene fatto kNN search per determinare per ogni punto quali sono i suoi vicini e identificare delle superfici

planari. Se necessario, viene aggiornato l’albero per bilanciarlo.

### Dopo la ricerca, vengono prodotte le informazioni necessarie al filtro di kalmann per stimare lo stato

46 Architettura di Controllo

- Algoritmo di LiDAR-Inertial Odometry per posa 3D, agnostico rispetto al sensore utilizzato
- No feature extraction
- Output fino a 100Hz
- Implementazione in ROS2 disponibile
- Adatto ad applicazione indoor e outdoor
- Con filtro di Kalman interno per correggere distorsione di movimento
- Ottimizzazione della memoria con struttura dati ad albero bilanciata
- Sviluppato dal laboratorio HKU-MARS dell’università di Hong-Kong

Architettura di Controllo - FastLIO-2

Fig. 20b: Pipeline di SLAM

Fig. 20a: Logo del
laboratorio

47 Architettura di Comunicazione

- SocketCAN: modulo del kernel Linux che implementa
- Un driver per un controller CAN
- Un’interfaccia di comunicazione basata su socket
- Strumenti user-space per e API comuni a ogni linguaggio di programmazione moderno
- Supporta protocolli più alti come CANOpen
- le cui librerie userspace usano gestiscono il canale come una socket
- L’adattatore utilizza un protocollo proprietario basato su frame
- ConfigFrame: per setup dei parametri seriali, del CANBus e del formato dati.
- DataFrame: per scambio dati, possono essere:
- Fixed: taglia di 20 byte, richiede calcolo checksum per l’integrità
- Variable: taglia variabile tra 5 e i 15 byte per scambio dati più veloce, accorpa più informazioni in un byte e ha un carattere di inizio e fine.
- Richiede configurazione diretta della porta seriale mediante librerie di sistema operativo

Architettura di Comunicazione – SocketCAN e Waveshare Protocol

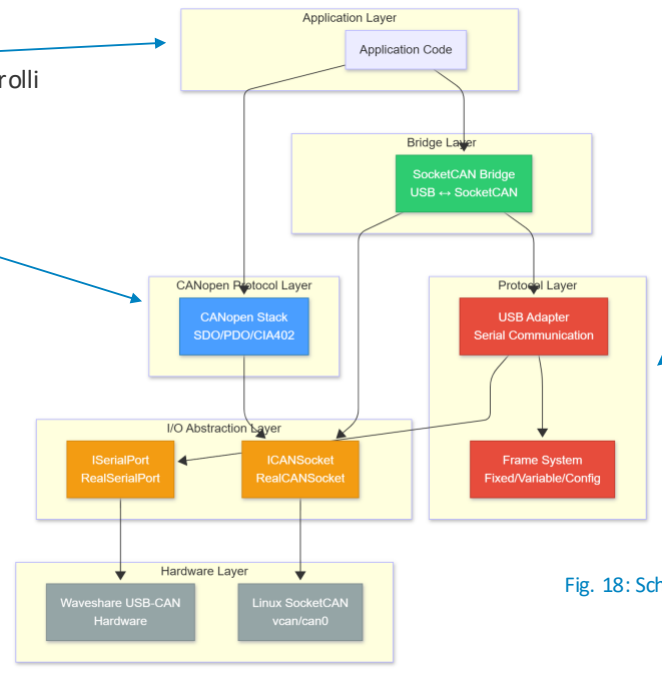
[picture p40: figure]

- Interamente sviluppato da zero a partire dal protocollo Waveshare, riscrivendo in C++ delle librerie per la gestione dei singoli frame - Gestisce una singola porta seriale in modo concorrente con un solo scrittore e molteplici lettori - Apre una socket alla rete CAN virtuale (VCAN) ed effettua un forwarding doppio: - USB -> VCAN - VCAN -> USB - Permette di rendere trasparente a qualsiasi programma user-space l’adattatore seriale e far diventare il PC a cui è connesso un nodo della rete CAN - Implementato con un’architettura che fa astrazione sia della porta fisica che della socket per opportuno unit-testing delle singole funzionalità - Sfrutta un sistema di callback per un’implementazione agnostica della gestione dei messaggi, lasciando all’utilizzatore la scelta di cosa fare quando si vuole inviare un messaggio e quando si vuole gestire un messaggio in arrivo - Wrappata in un nodo ROS2 che ne gestisce il lifecycle e attivando una serie di servizi e topic per il monitoraggio della rete CAN e per inviare e leggere messaggi - I comandi di controllo ai driver vengono inviati mediante opportuni nodi di

48 Architettura di Comunicazione

Architettura di Comunicazione – SocketCAN Bridge

Fig. 18: Schema strutturale del bridge

Altre applicazioni generiche
Es: radiocomando che invia controlli

Strato gestito dal Kernel

Implementazione
Protocollo
Waveshare

- interfaccia che forwardano ulteriormente i messaggi inviati a /cmd_vel (topic standard per l’invio di riferimento di velocità), trasformandoli in messaggi CAN - Una serie di nodi viene lanciata in automatico all’avvio del sistema, che interrogano la rete per recuperare stato e letture del singolo driver e pubblicarle secondo le convenzioni scelte da ROS2 (es: catena cinematica con /tf)

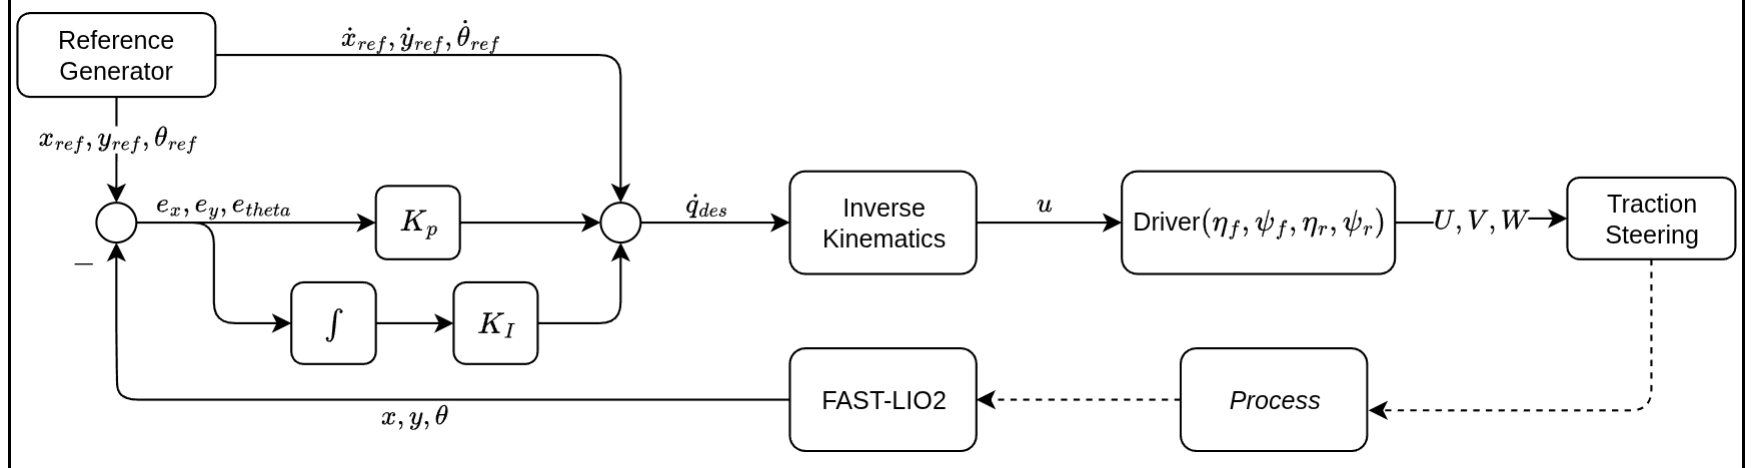
[picture p41: figure]

49 Architettura di Controllo

Architettura di Controllo – Trajectory Tracking con PI + FeedForward

Fig. 19: Diagramma a blocchi Architettura di Controllo

Obiettivo: Risolvere un problema di inseguimento di traiettorie

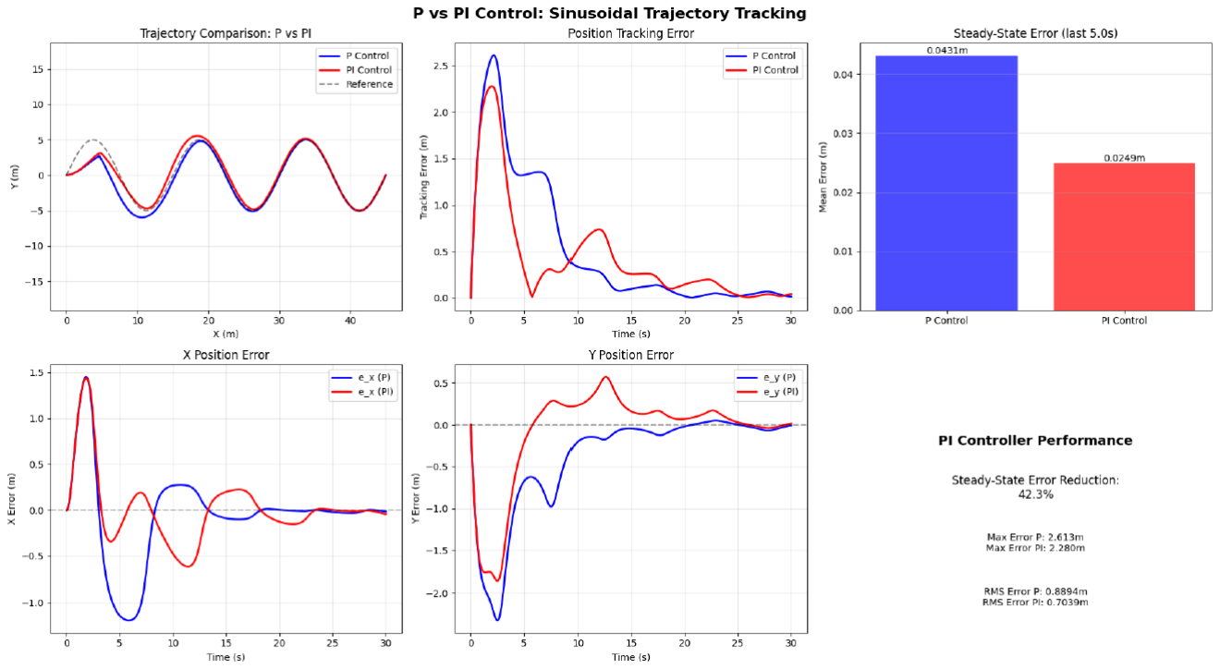
[picture p42: figure]

50 Architettura di Controllo

Architettura di Controllo – Trajectory Tracking con PI + FeedForward

Fig. 19: Inseguimento Traiettoria sinusoidale

51

# Stato dei Lavori

## Cosa è stato realizzato e target a breve termine

6.

52 Stato dei Lavori

- Progettazione meccanica in 3D con simulazioni FEM
- Progettazione schemi elettrici per il cablaggio
- Verificato il funzionamento dell’algoritmo FastLIO2 con LiDAR MID 360
- Implementazione di architettura di controllo su SBC

Cosa è stato realizzato fino ad ora

53 Stato dei Lavori

- Libreria waveshare_cpp per implementare il protocollo Waveshare in C++
- Libreria SocketCANBridge per fornire API per l’apertura e la gestione modulare del forwarding tra la CAN network del virtuale e il mezzo fisico
- Libreria che mappa la configurazione del file EDS (fornito dall’azienda) del driver per caricamento a run-time delle informazioni necessarie all’invio di messaggi

Cosa è stato realizzato fino ad ora

54 Stato dei Lavori

- Testata la comunicazione su CANBus tramite la libreria sviluppata, per il retrieving dello stato dei driver sia con messaggi CAN semplici che tramite SDO
- Testato l’invio di comandi ai driver per:
- Cambiare configurazione dello stato del driver da inattivo ad operativo
- Invio di set-point di posizione per angolo di sterzo, in open-loop
- Invio di set-point di velocità ai motori, in open-loop

Cosa è stato realizzato fino ad ora

55 Stato dei Lavori

- Debugging del meccanismo di controllo e raccolta del feedback mediante PDO
- Monitoraggio stato batteria in tempo reale
- Risoluzione criticità del modello
- Implementazione di un meccanismo di controllo del veicolo mediante l’invio di comandi da joystick e/o tastiera

Cosa è in lavorazione

56 Stato dei Lavori

- Integrare effettivamente meccanismi per la navigazione autonoma
- SLAM con FastLIO2
- EKF che fonde encoder e odometria da SLAM
- Path-planning
- Map-relocalization
- Obstacle-Avoidance
- Integrazione di sistemi di Visual-SLAM accoppiando telecamere al LiDAR e/o l’utilizzo di più LiDAR per coprire maggiore campo visivo
- Meccanismi di Safety e policy di recovery
- Controllo remoto tramite Web App
- Ottimizzazione del design
- Sviluppo di un sistema accoppiato di rover per il trasporto della sezione ventilante e/o dell’intera macchina con aggancio frontale e posteriore o sitema di Kart/Trail
- Integrazione nei processi aziendali per il trasporto materiali dai depositi di magazzino alla linea mediante sistemi MES (Manufacturing Execution System) e di schedulazione della produzione

Sviluppi Futuri

57

Grazie per l’attenzione

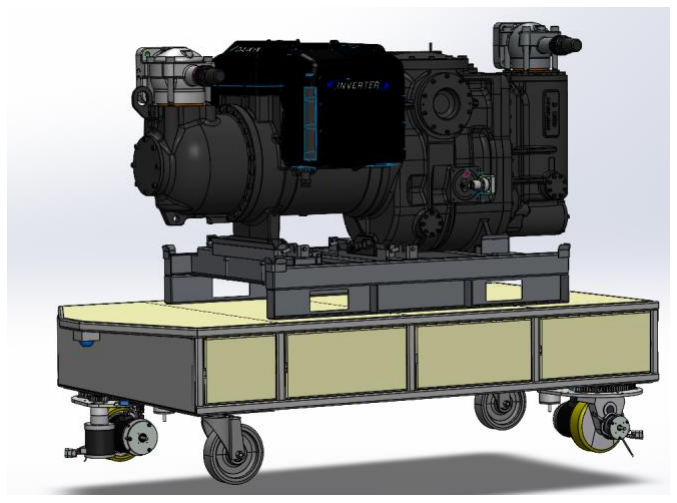
[picture p43: figure]
