effibot/thesis_latex/Datasheets/calcoli_traction.png

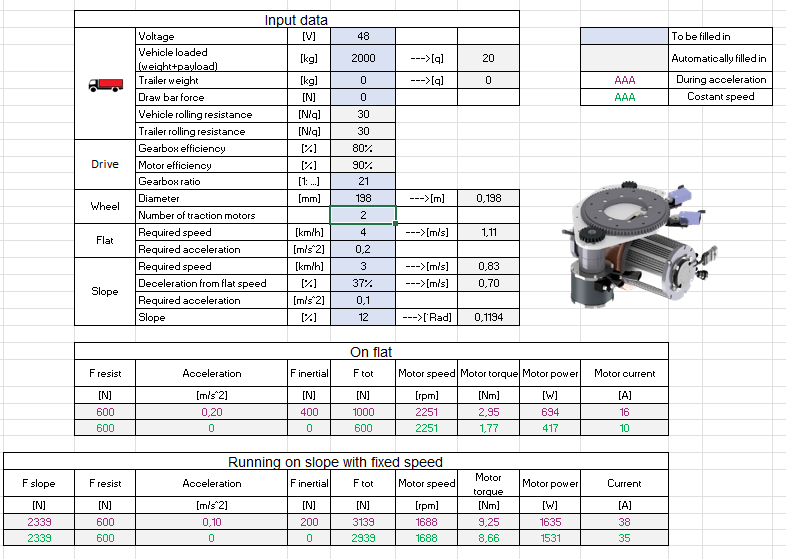
Datasheets/calcoli_traction.png
