effibot/thesis_latex/img/2/compressore_screw.png

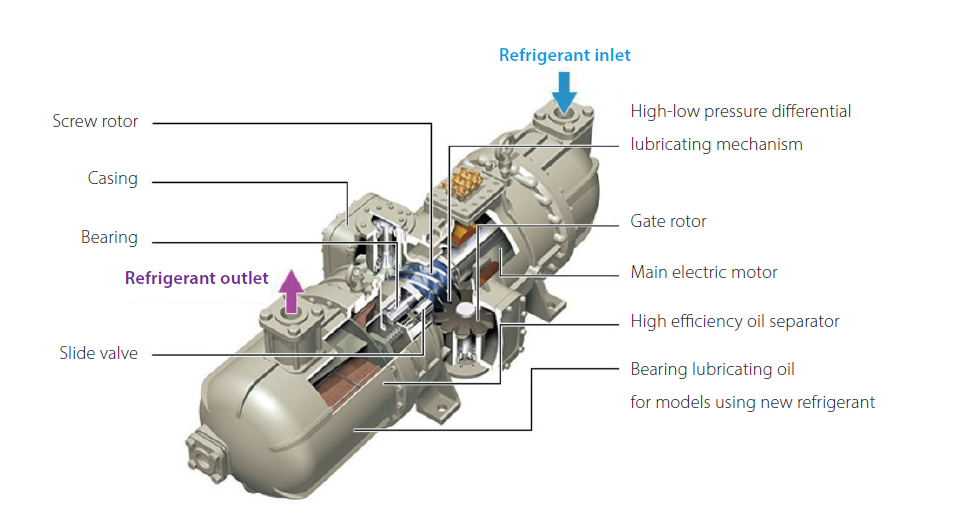
img/2/compressore_screw.png
