effibot/thesis_latex/img/2/fastlio2_block_diagram.png

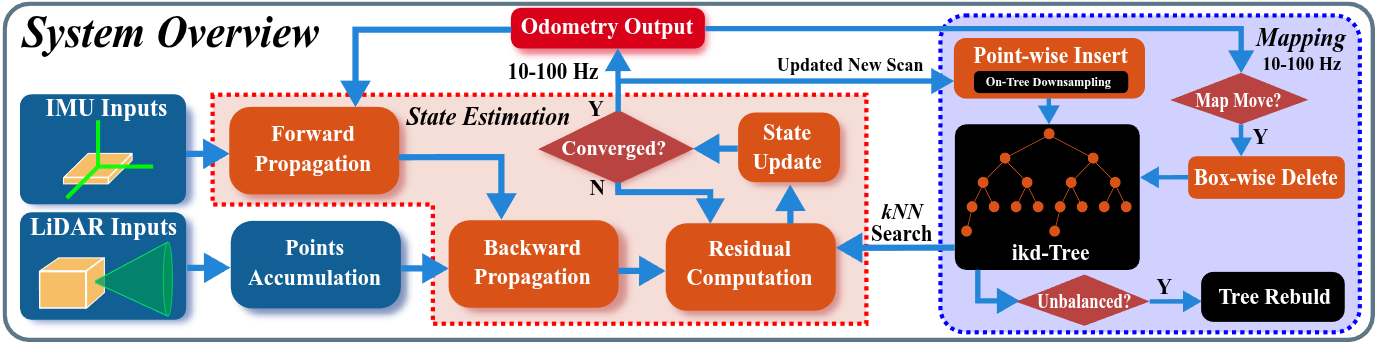
img/2/fastlio2_block_diagram.png
