effibot/thesis_latex/img/2/sv_chiller.png

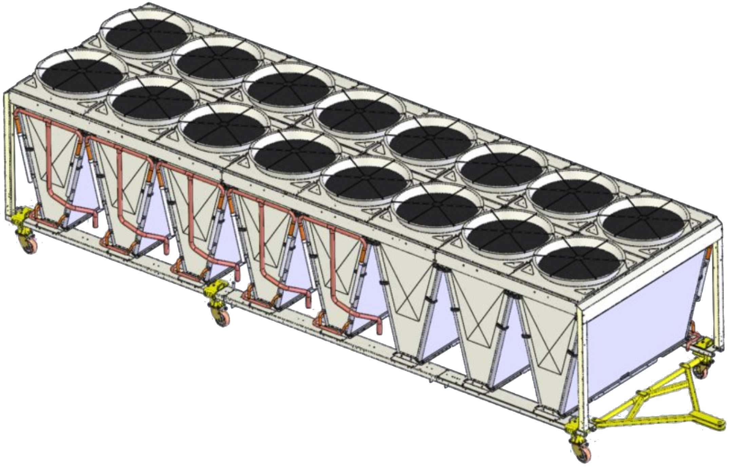
img/2/sv_chiller.png
