effibot/thesis_latex/img/2wd_steering.png

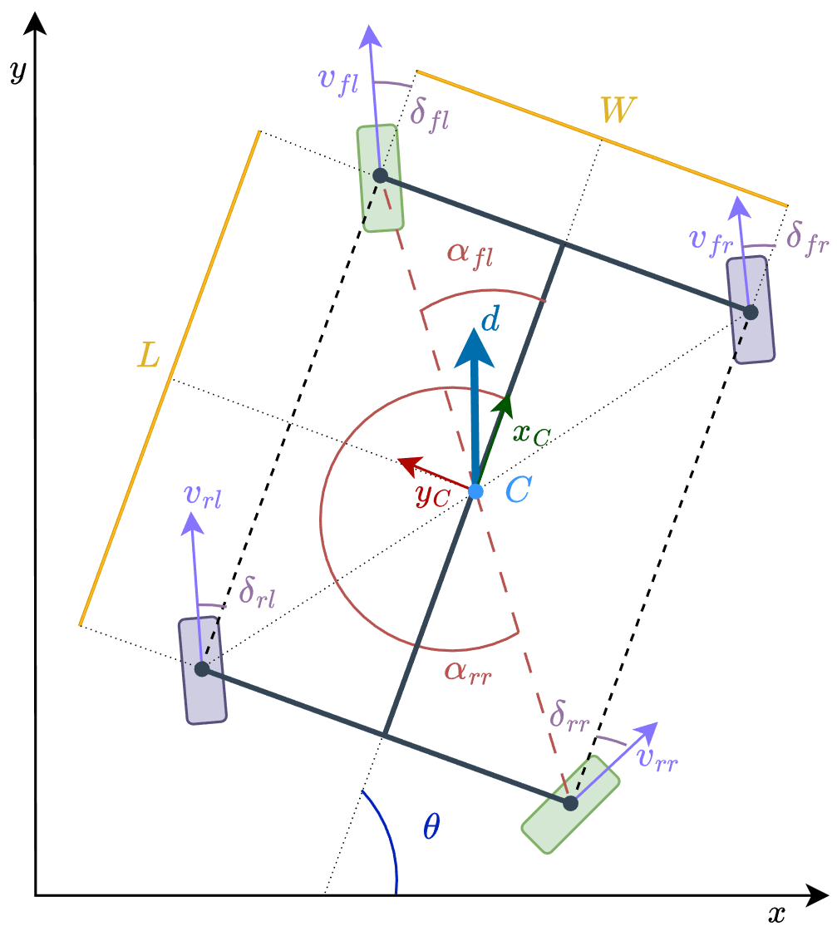
img/2wd_steering.png
