effibot/thesis_latex/img/3/lattepanda_sigma2.png

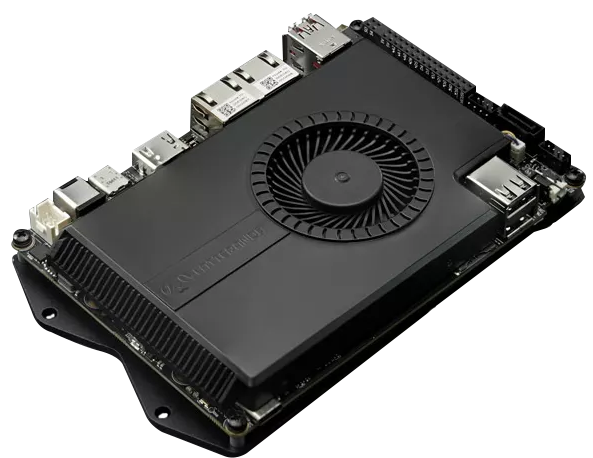
img/3/lattepanda_sigma2.png
