effibot/thesis_latex/img/3/lattepanda_sigma.png

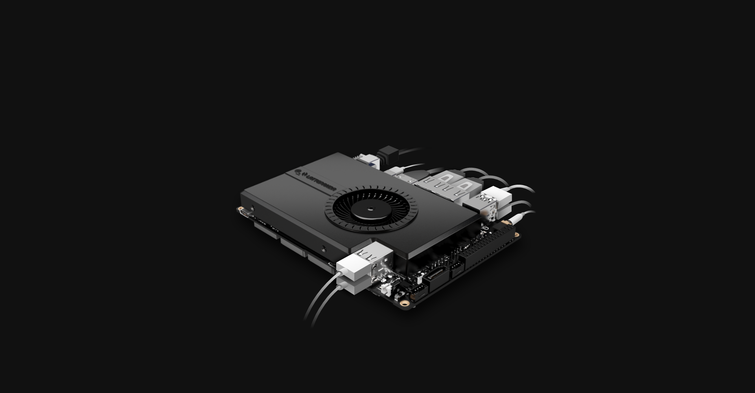
img/3/lattepanda_sigma.png
