effibot/thesis_latex/img/3/livox_mid360.png

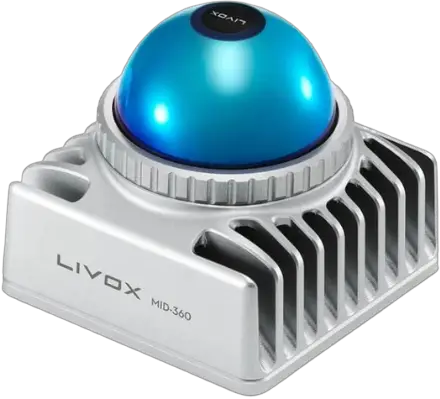
img/3/livox_mid360.png
