effibot/thesis_latex/img/3/livox_mid360_FOV.png

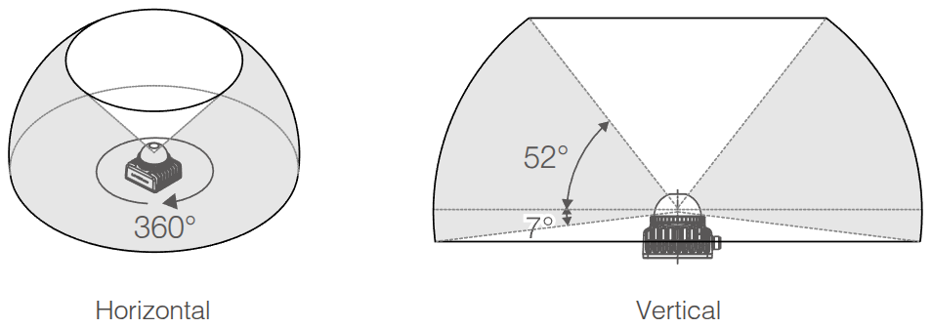
img/3/livox_mid360_FOV.png
