effibot/thesis_latex/img/3/mini-traction-power.png

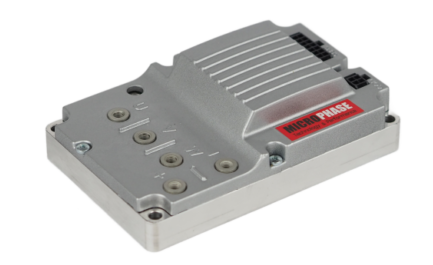
img/3/mini-traction-power.png
