effibot/thesis_latex/img/3/mockup_agv.jpeg

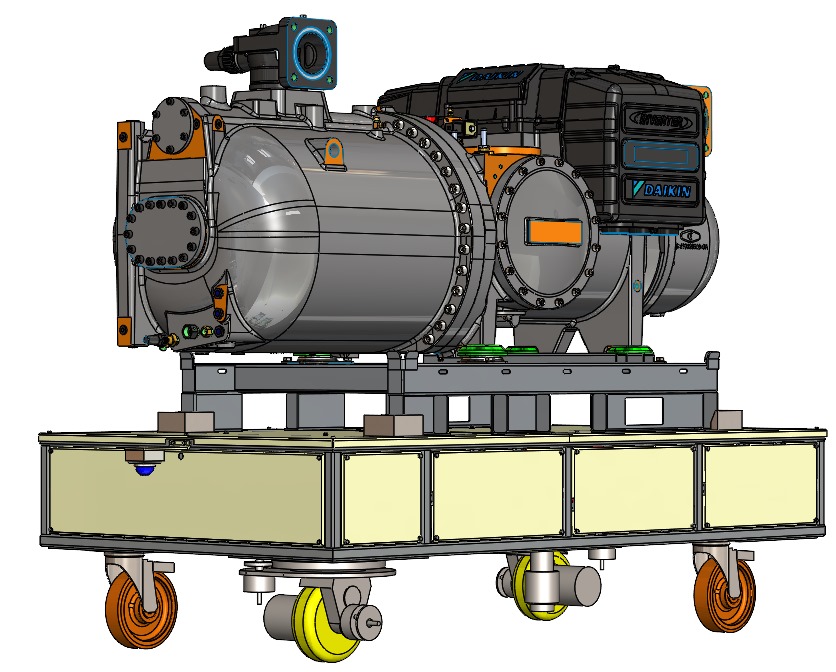
img/3/mockup_agv.jpeg
