effibot/thesis_latex/img/3/mockup_intern.jpeg

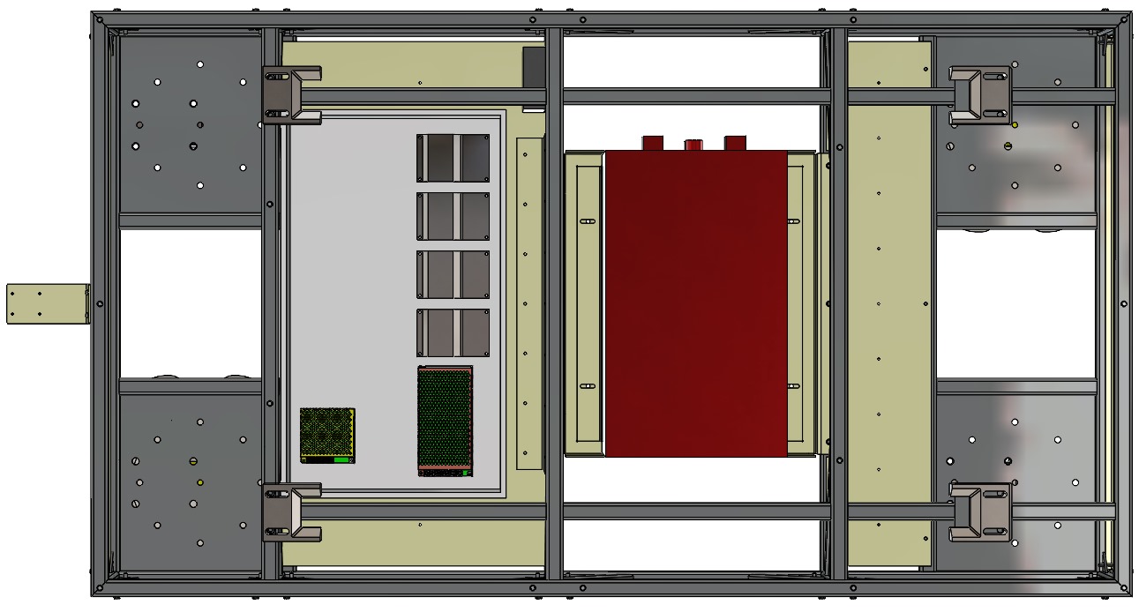
img/3/mockup_intern.jpeg
