effibot/thesis_latex/img/3/MRT05_render.png

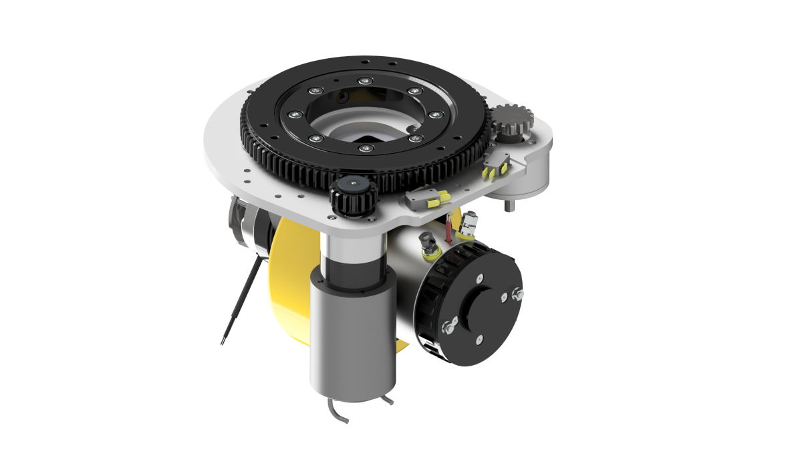
img/3/MRT05_render.png
