effibot/thesis_latex/img/3/mrt_connection_scheme.png

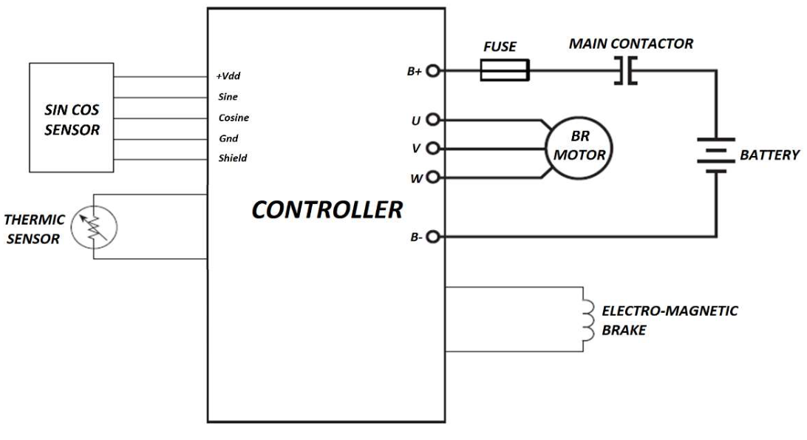
img/3/mrt_connection_scheme.png
