effibot/thesis_latex/img/3/piastra_supporto batteria.png

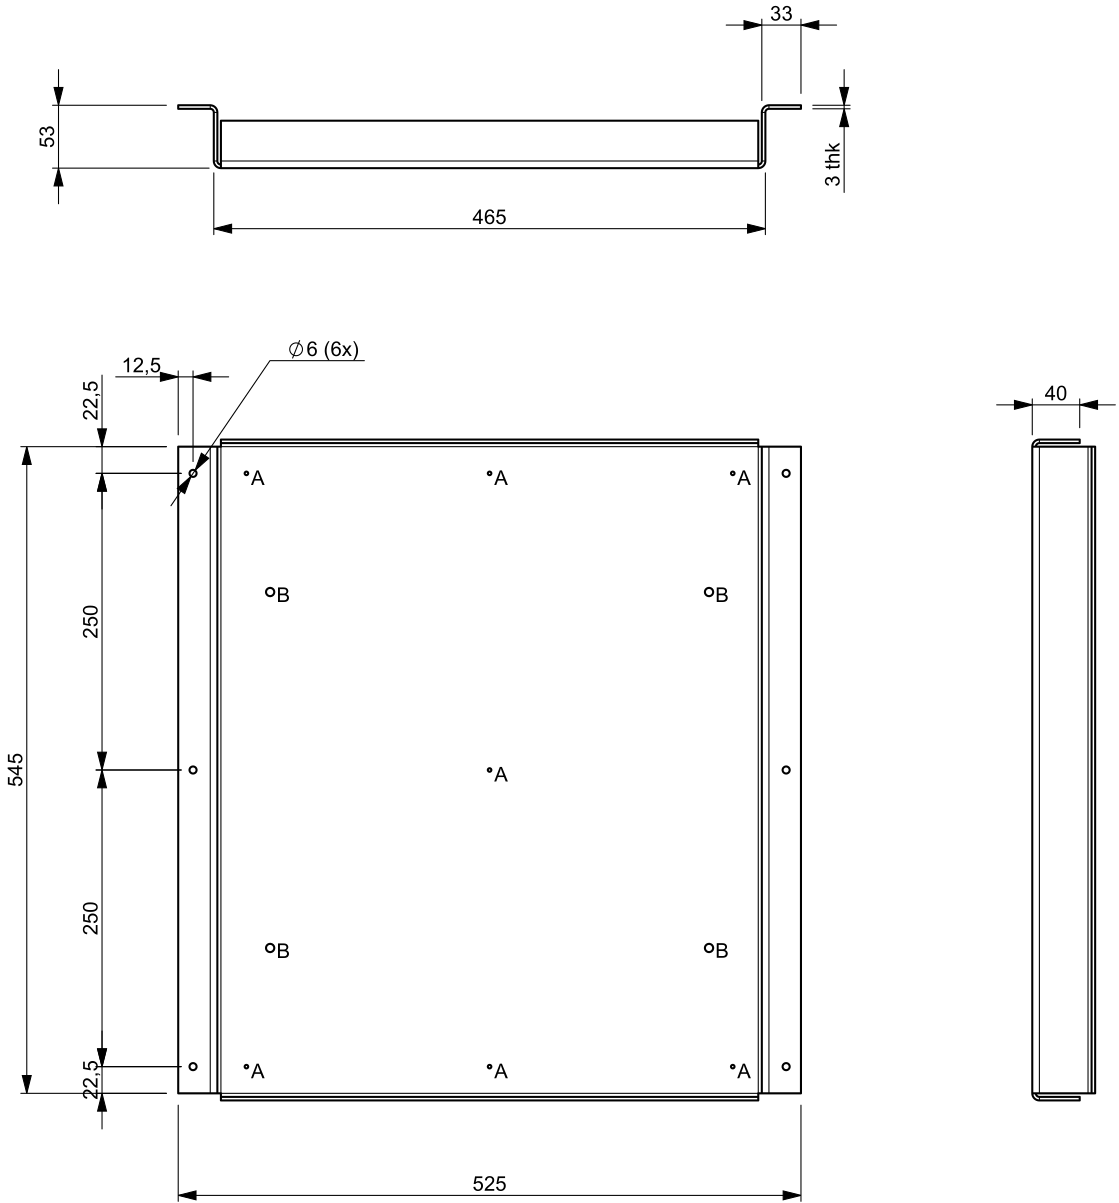
img/3/piastra_supporto batteria.png
