effibot/thesis_latex/img/3/piastra_supporto_lidar.png

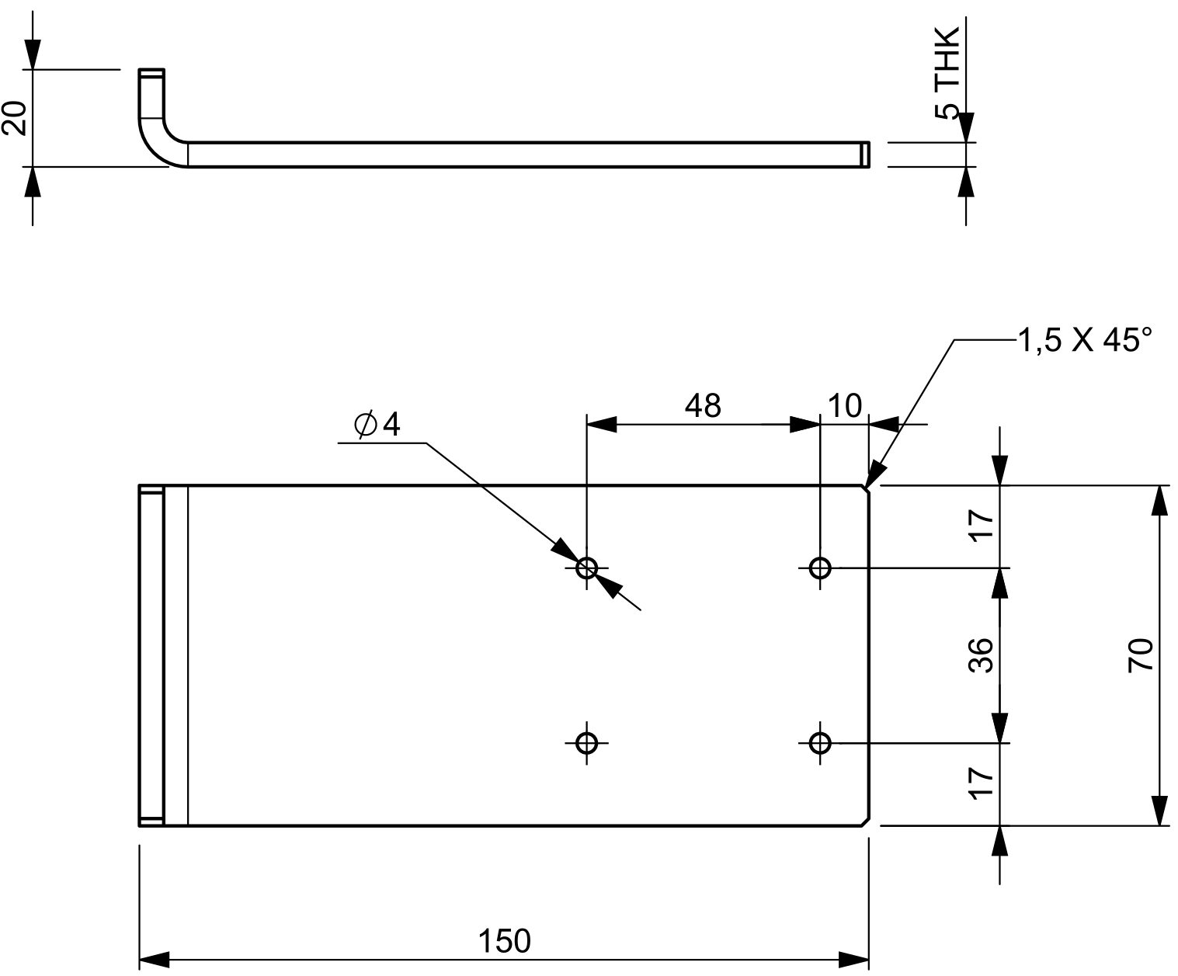
img/3/piastra_supporto_lidar.png
