effibot/thesis_latex/img/4/crabbing_north_feedforward_bicycle.png

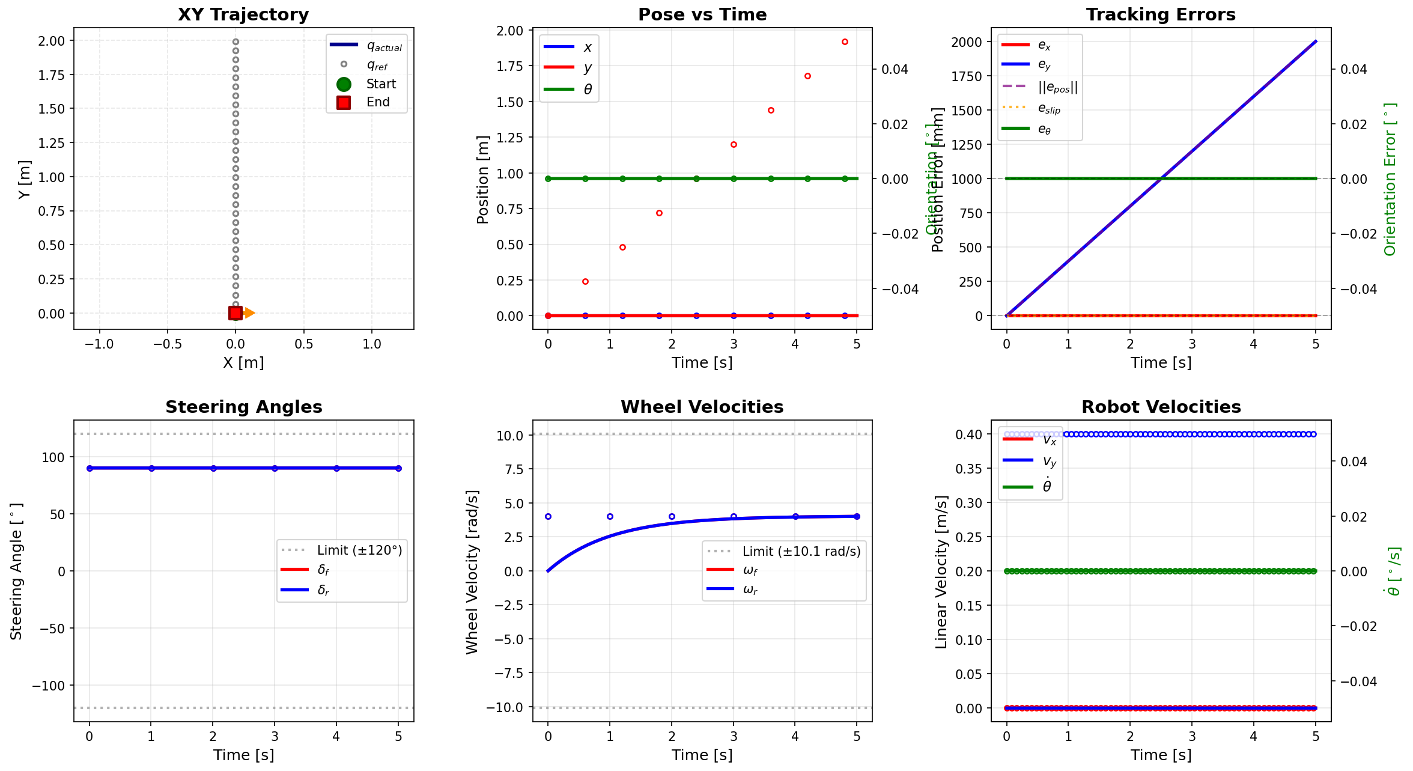
img/4/crabbing_north_feedforward_bicycle.png
