effibot/thesis_latex/img/4/curved_east_to_north_pid_bicycle.png

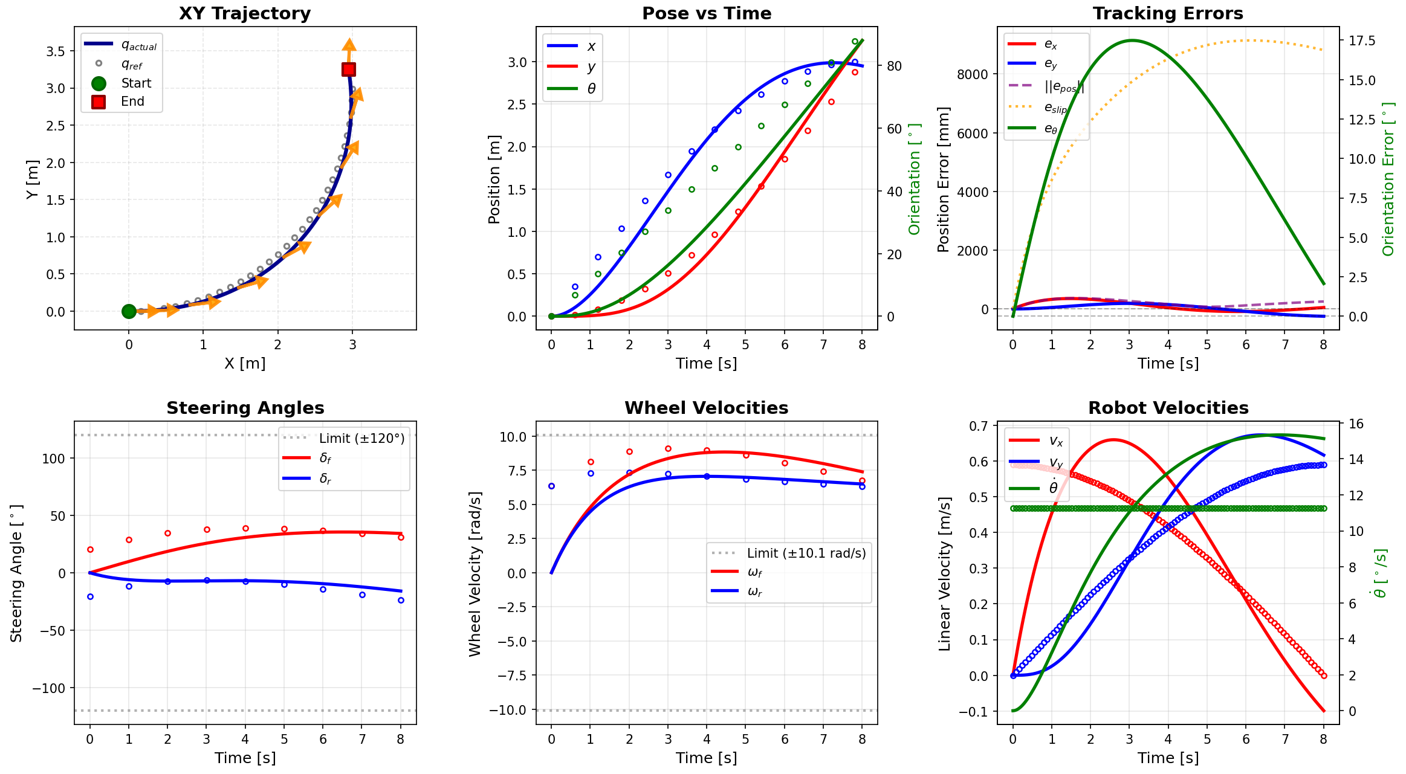
img/4/curved_east_to_north_pid_bicycle.png
