effibot/thesis_latex/img/4/spin_in_place_feedforward_bisteer.png

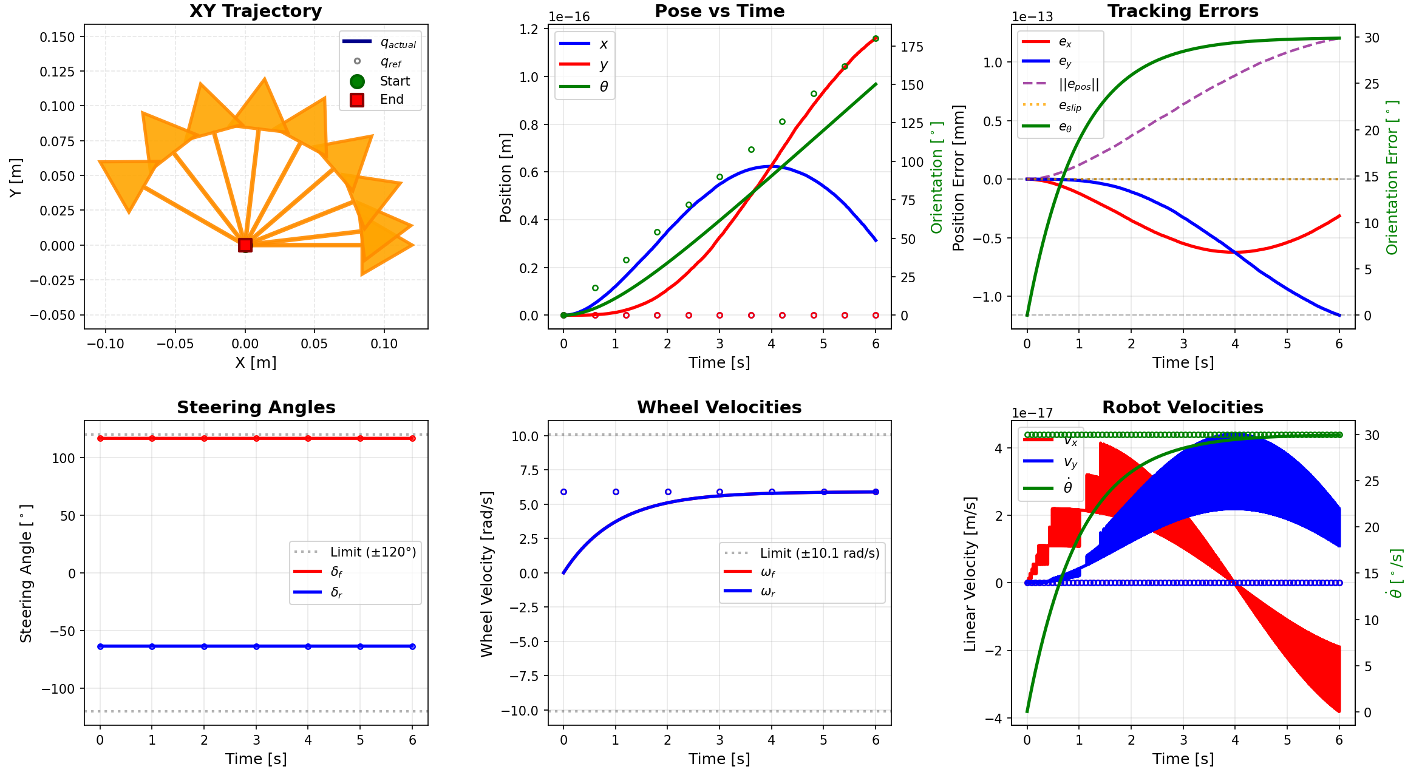
img/4/spin_in_place_feedforward_bisteer.png
