effibot/thesis_latex/img/4/straight_east_feedforward_bicycle.png

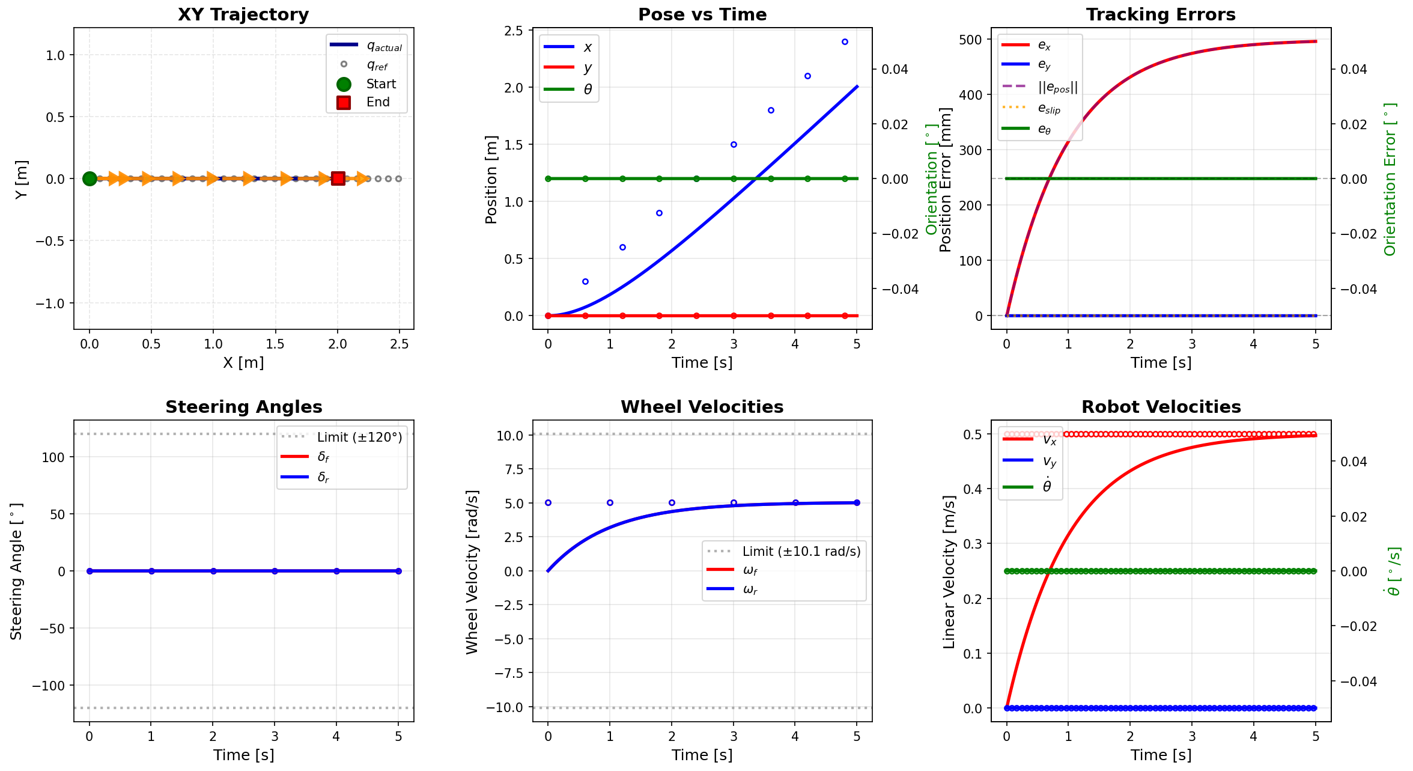
img/4/straight_east_feedforward_bicycle.png
