effibot/thesis_latex/img/4/straight_east_pid_bicycle.png

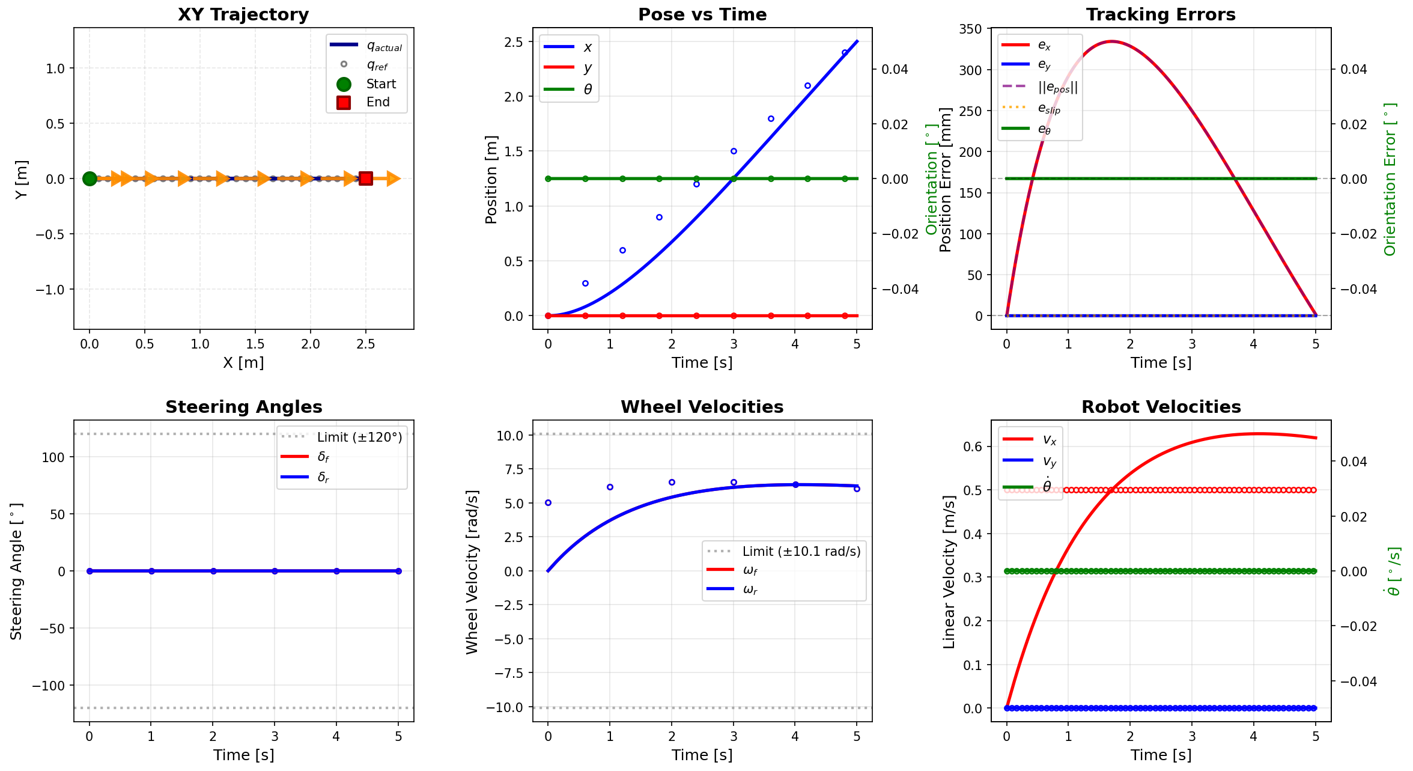
img/4/straight_east_pid_bicycle.png
