effibot/thesis_latex/img/5/comm_arch_sol_crop.png

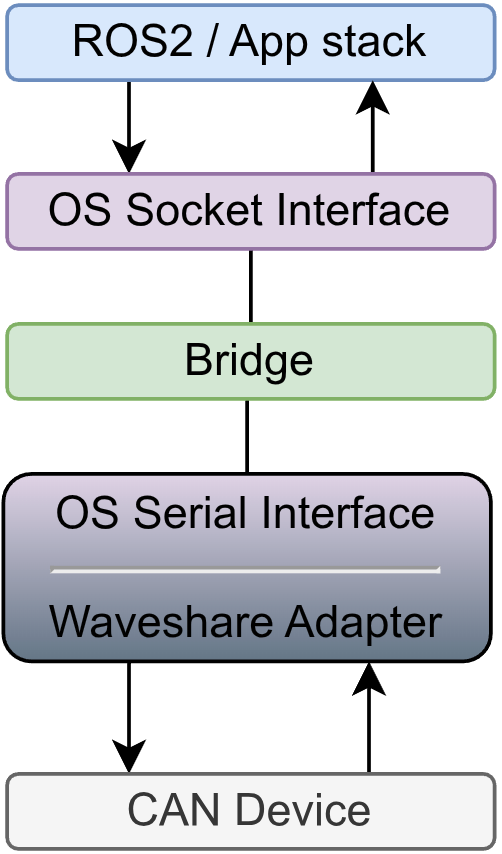
img/5/comm_arch_sol_crop.png
