effibot/thesis_latex/img/banco_prova.jpeg

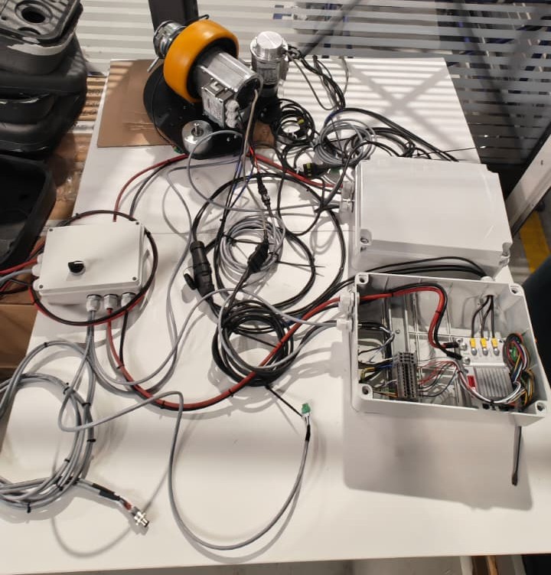
img/banco_prova.jpeg
