effibot/thesis_latex/img/batteria/front_view.jpeg

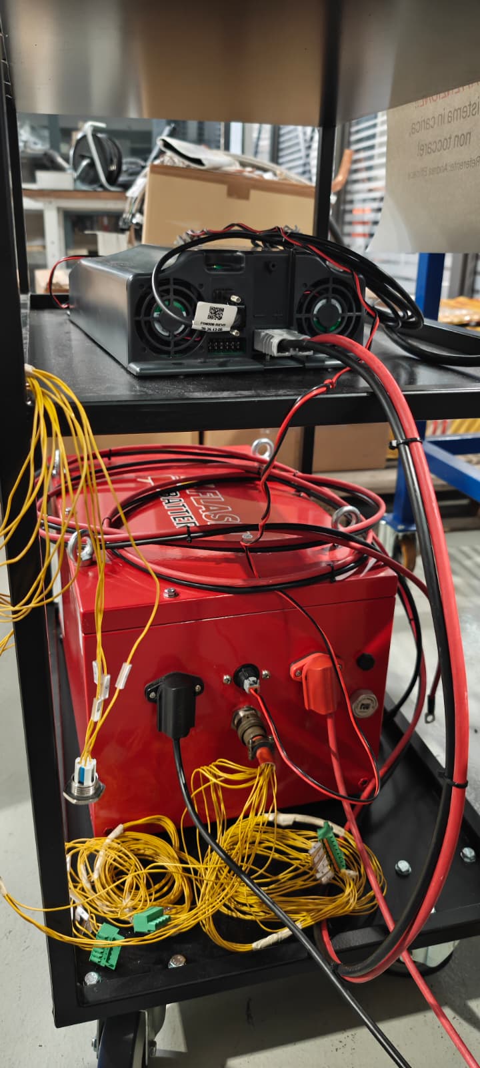
img/batteria/front_view.jpeg
