effibot/thesis_latex/img/biciclo.png

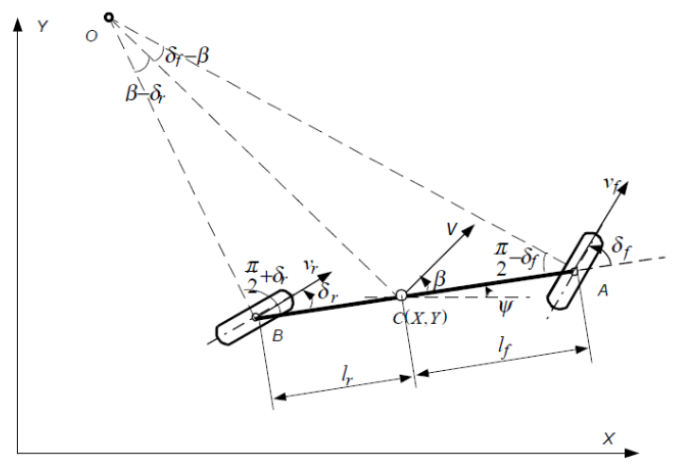
img/biciclo.png
