effibot/thesis_latex/img/carrello.jpeg

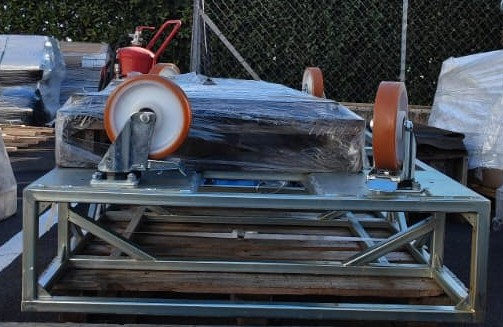
img/carrello.jpeg
