effibot/thesis_latex/img/daikin/35-A-CO1005.jpeg

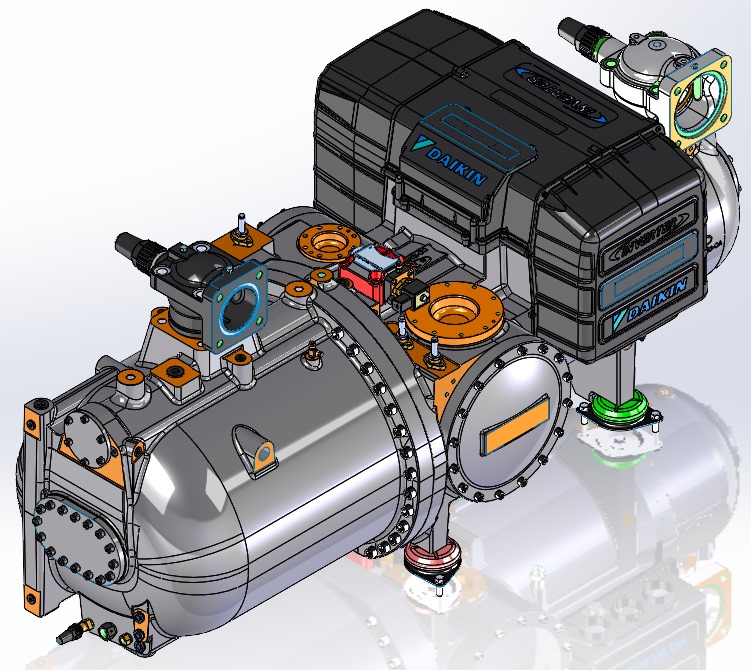
img/daikin/35-A-CO1005.jpeg
