effibot/thesis_latex/img/daikin/daikin_factory_intern.jpg

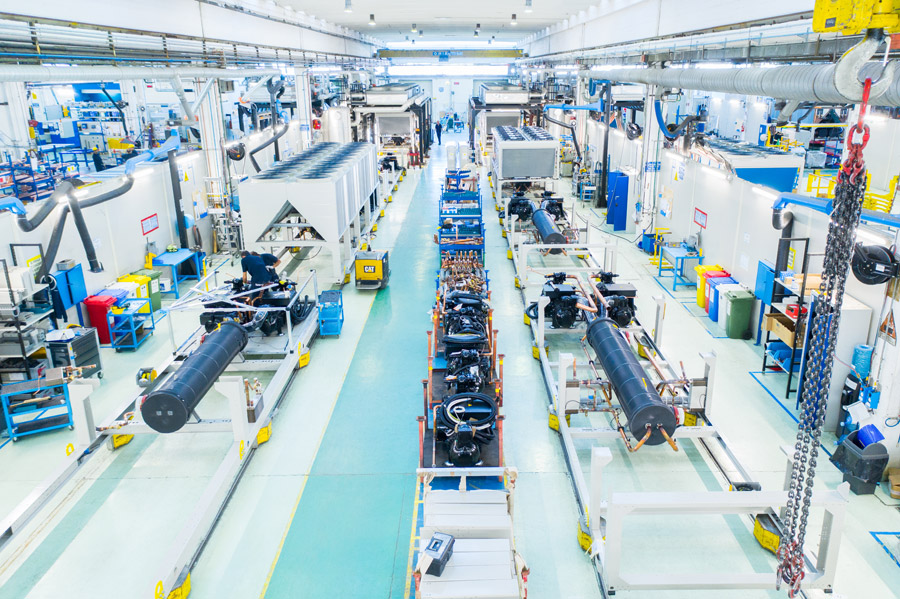
img/daikin/daikin_factory_intern.jpg
