effibot/thesis_latex/img/daikin/daikin_factory_intern_2.jpg

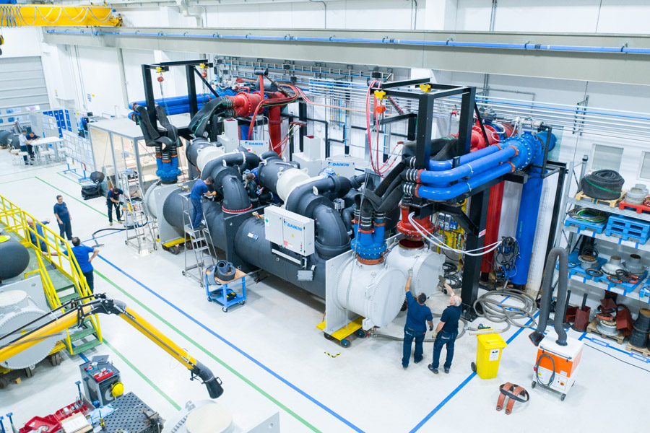
img/daikin/daikin_factory_intern_2.jpg
