effibot/thesis_latex/img/motore/front_view.jpeg

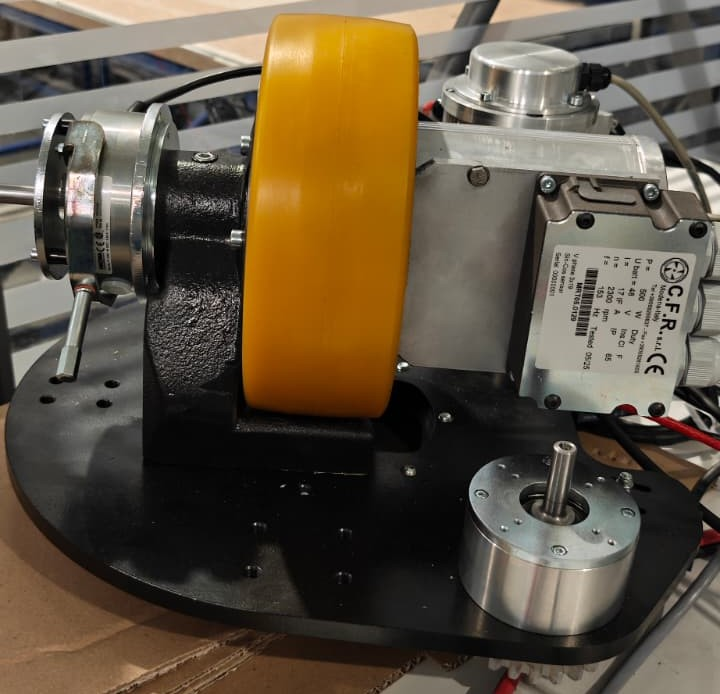
img/motore/front_view.jpeg
