effibot/thesis_latex/img/motore/side_view_1.jpeg

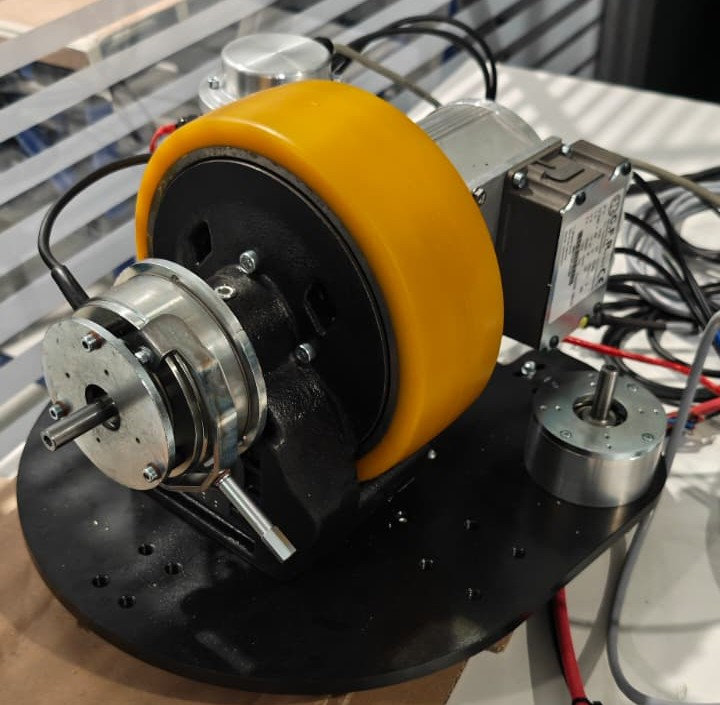
img/motore/side_view_1.jpeg
