effibot/thesis_latex/img/motore/side_view_2.jpeg

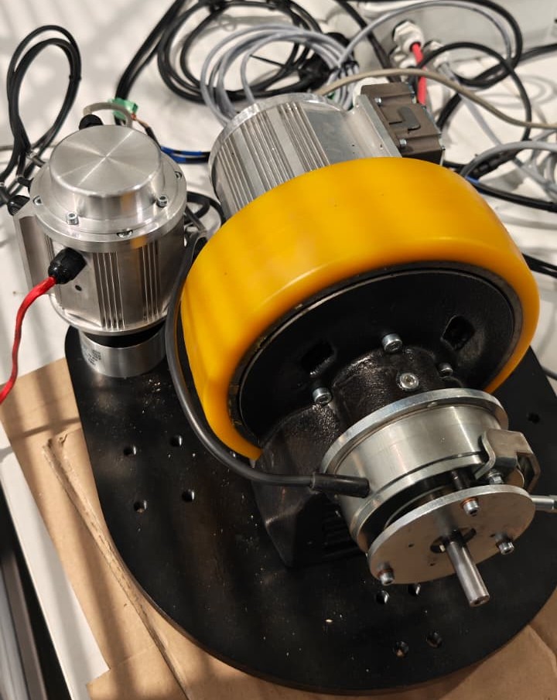
img/motore/side_view_2.jpeg
