effibot/thesis_latex/img/motore/top_view.jpeg

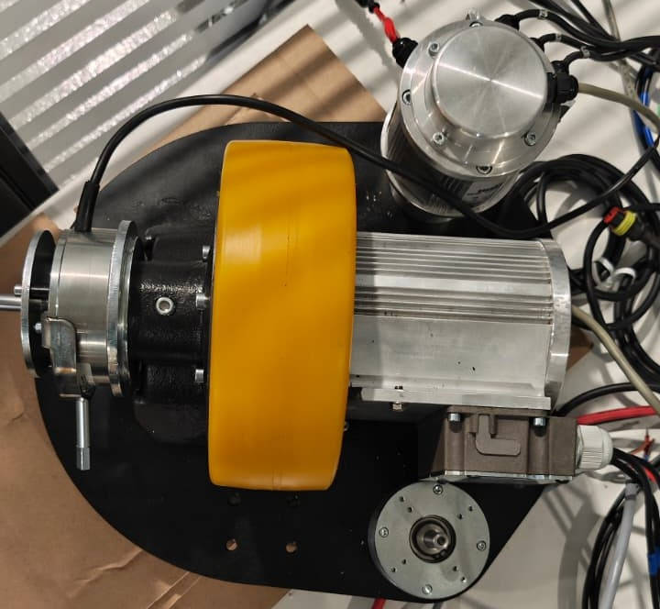
img/motore/top_view.jpeg
