effibot/thesis_latex/img/telaio/disegno_front_horiz.png

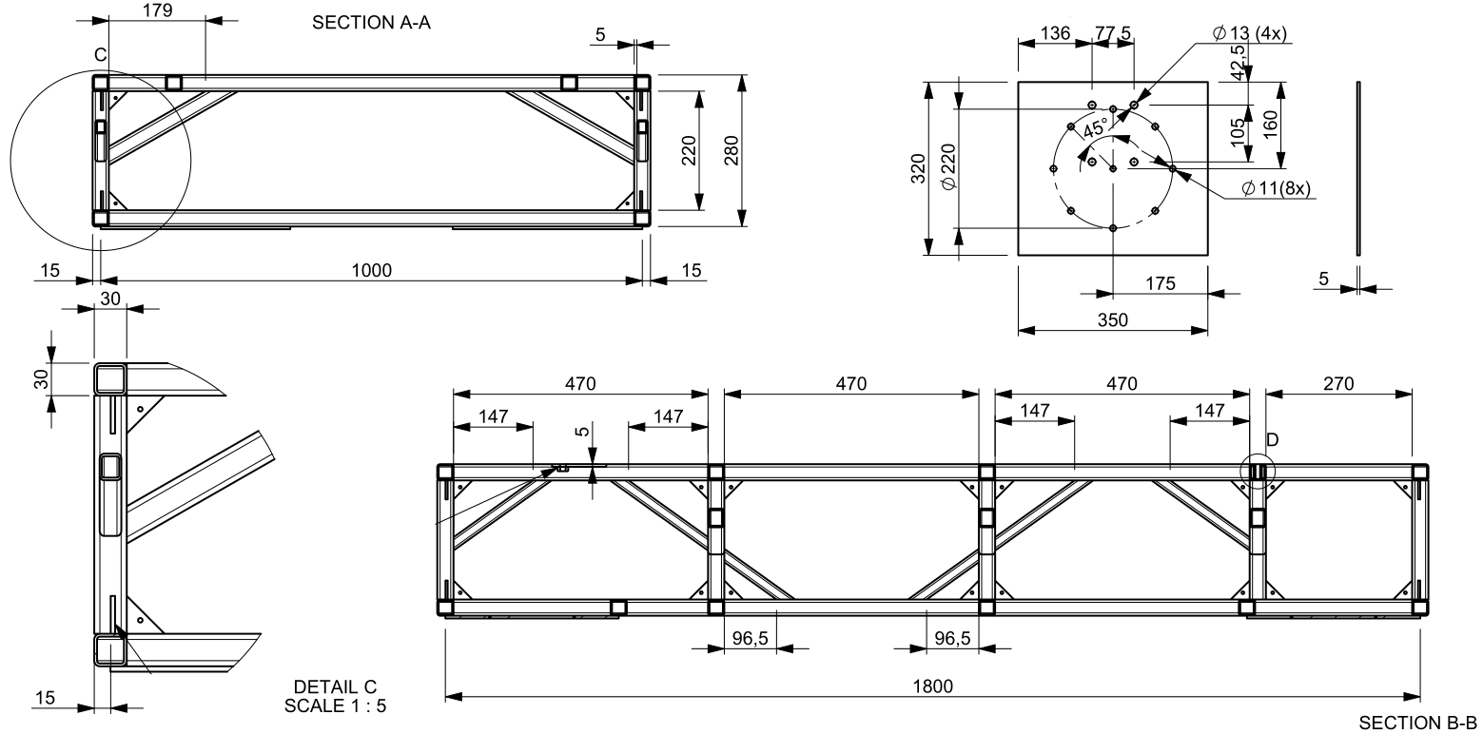
img/telaio/disegno_front_horiz.png
