effibot/thesis_latex/img/telaio/disegno_side.png

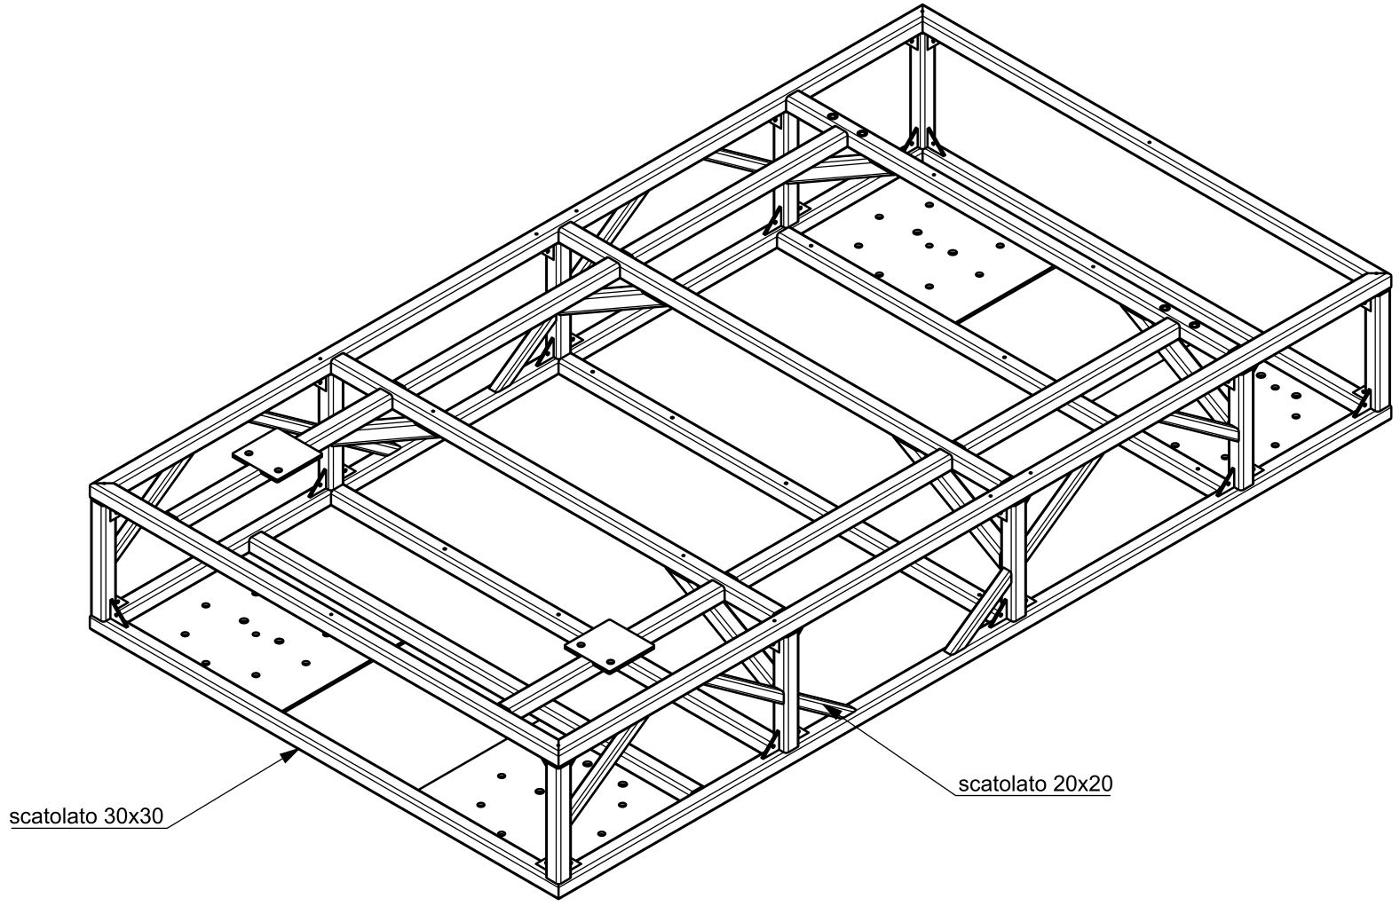
img/telaio/disegno_side.png
