effibot/thesis_latex/img/telaio/fem_telaio.png

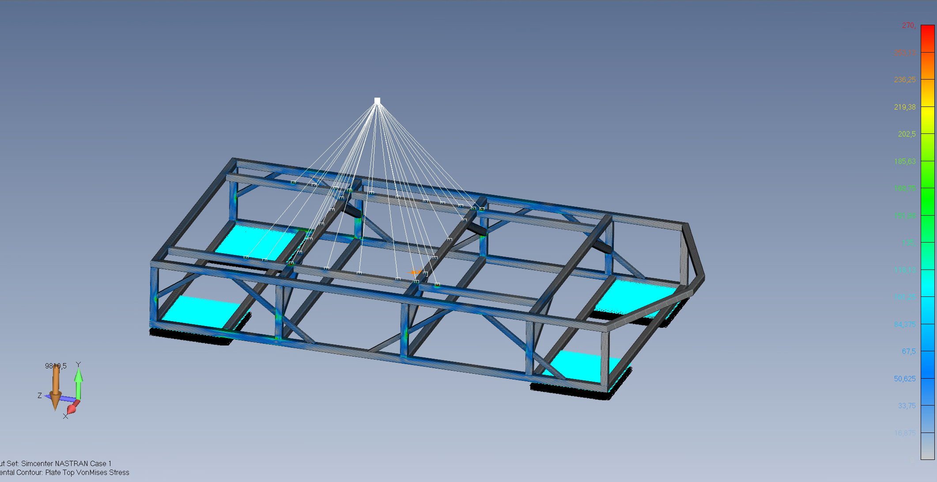
img/telaio/fem_telaio.png
