effibot/thesis_latex/img/telaio/fem_telaio_dettaglio_1.png

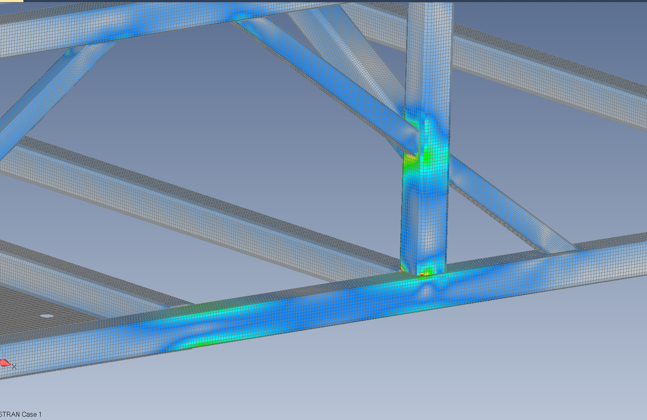
img/telaio/fem_telaio_dettaglio_1.png
