effibot/thesis_latex/img/telaio/fem_telaio_dettaglio_2.png

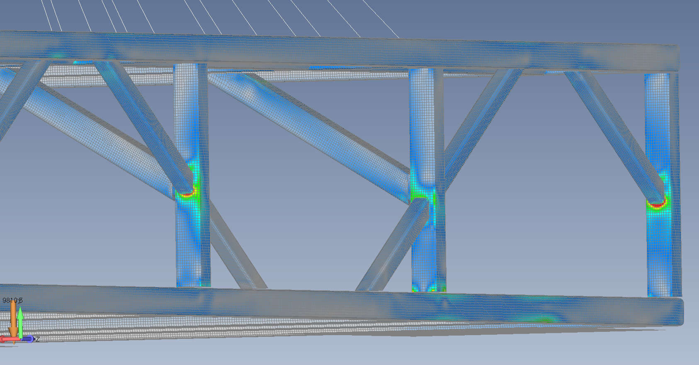
img/telaio/fem_telaio_dettaglio_2.png
