effibot/thesis_latex/img/telaio/fem_telaio_dettaglio_3.png

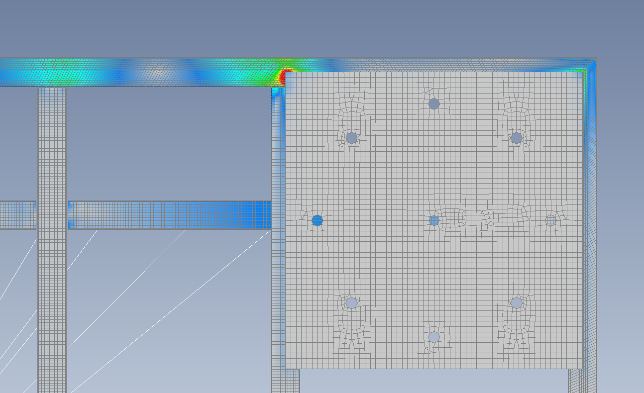
img/telaio/fem_telaio_dettaglio_3.png
