effibot/thesis_latex/img/telaio/front_view.jpeg

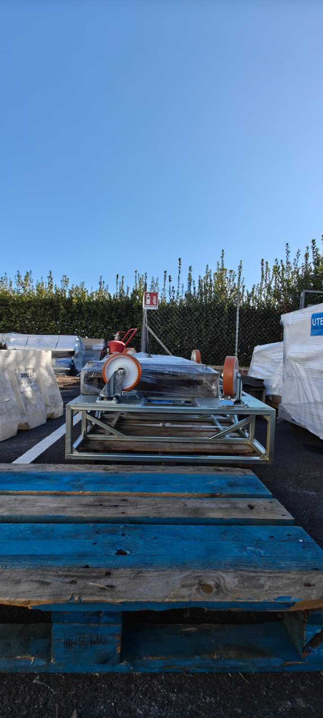
img/telaio/front_view.jpeg
