effibot/thesis_latex/img/telaio/side_view.jpeg

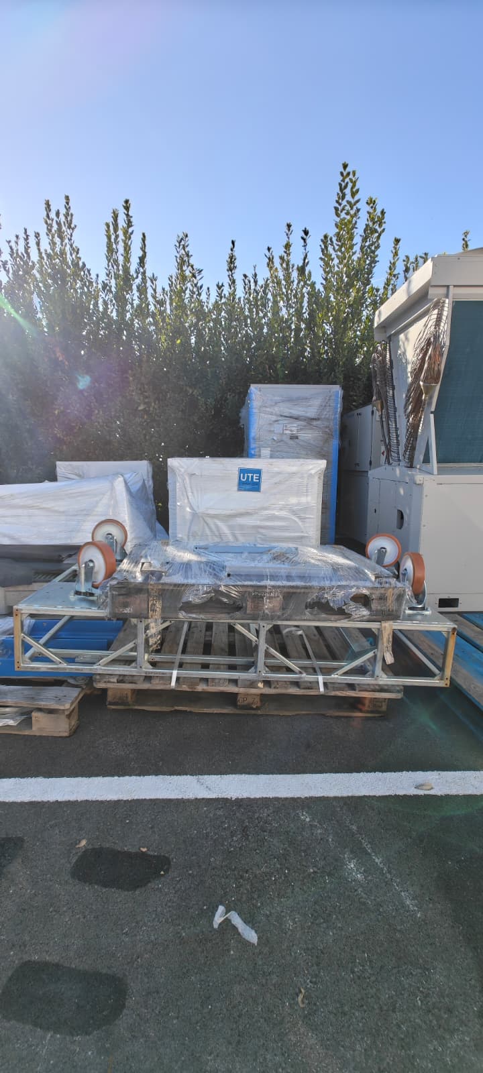
img/telaio/side_view.jpeg
