effibot/thesis_latex/img/telaio/top_view.jpeg

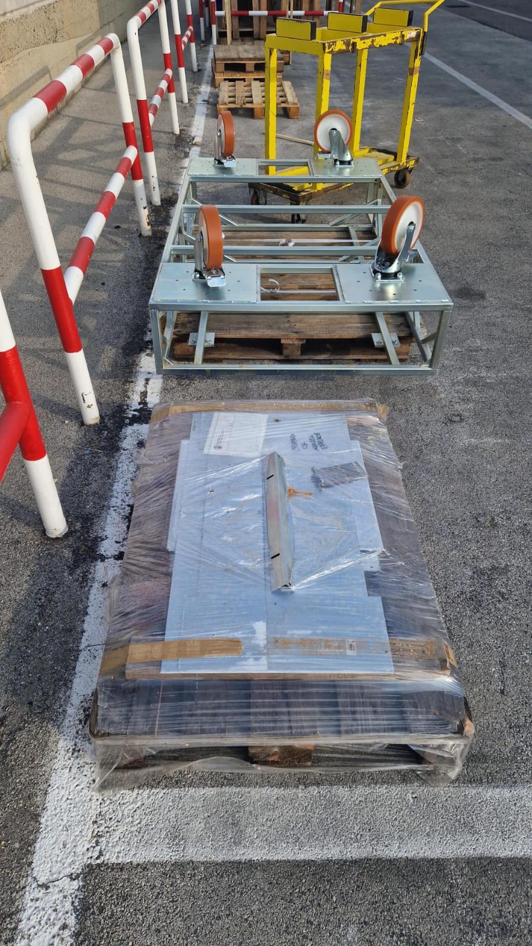
img/telaio/top_view.jpeg
