effibot/thesis_latex/img/telaio/vista_esplosa.png

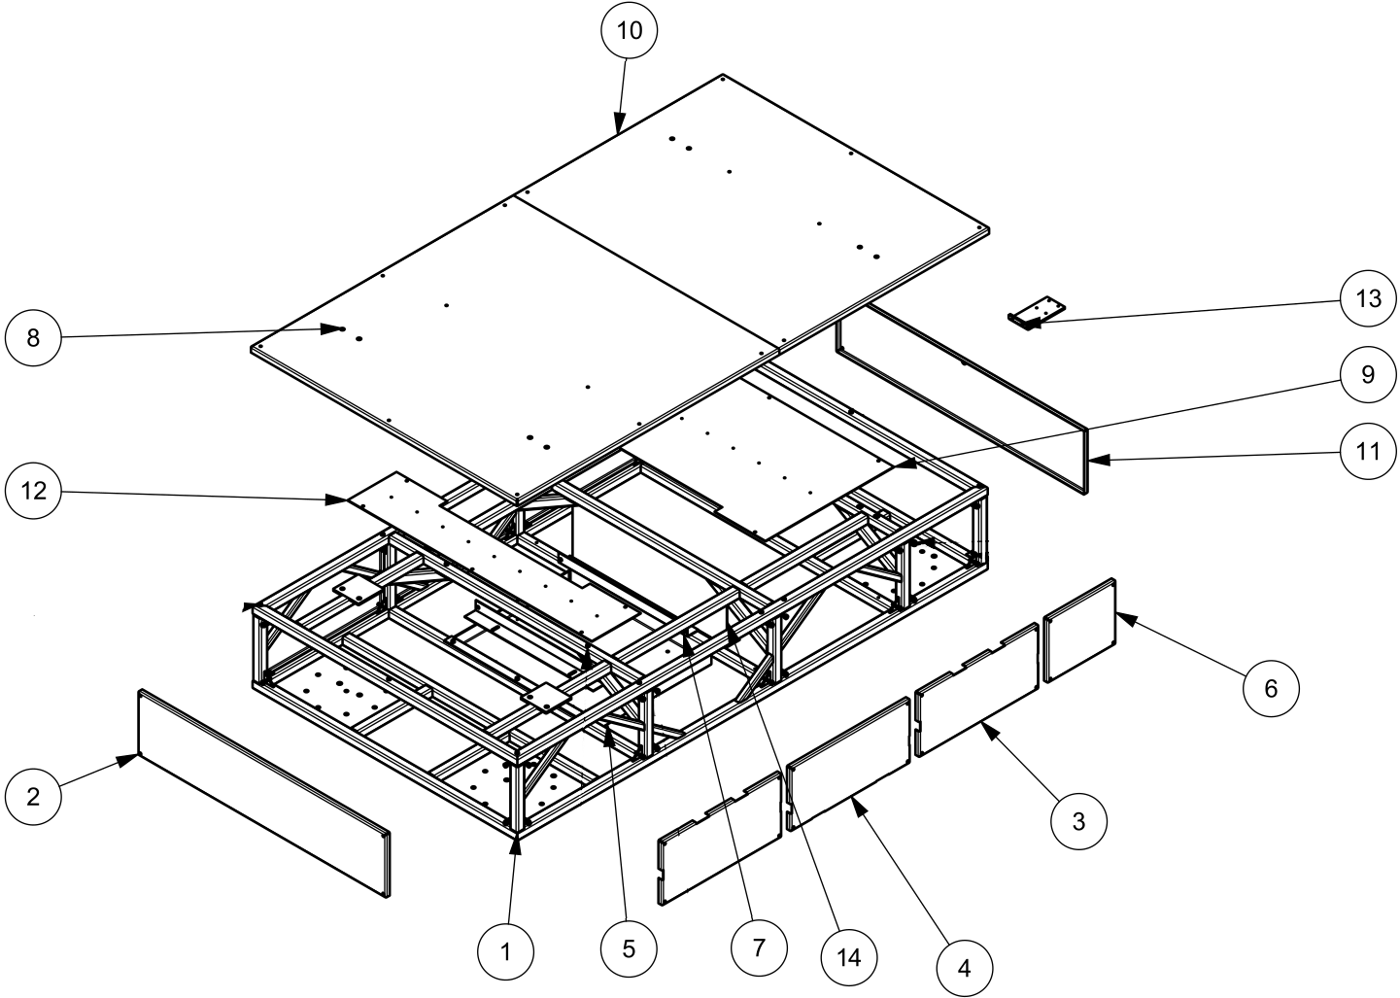
img/telaio/vista_esplosa.png
