effibot/thesis_latex/Solidworks/AGV/body.SLDASM

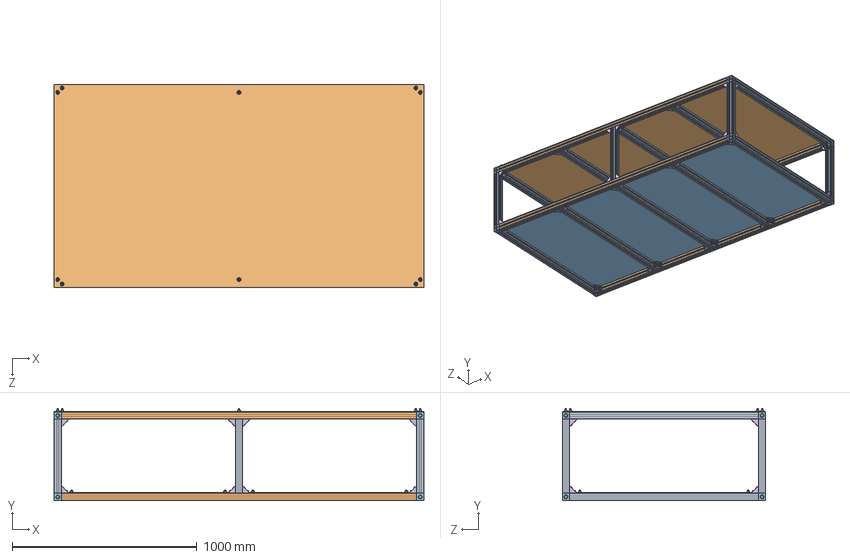
[picture p91: CAD file, 2025-12-09, last stored version]
Solidworks/AGV/body.SLDASM
2000.0 x 498.7 x 1100.0 mm
profilato_1020 x 10
profilato_1920 x 4
cubic_joint_3 x 8
CORE_SCREW_S12X30_T50 x 24
T_BOLT x 36
bracket_40_40 x 60
FLANGE_NUT_M8 x 144
T_BOLT_short x 120
profilato_400 x 6
lastra
lastra_down
