effibot/thesis_latex/Solidworks/Bosch Basics/Bracket/Assieme/Bracket_40_40_set_long.SLDASM

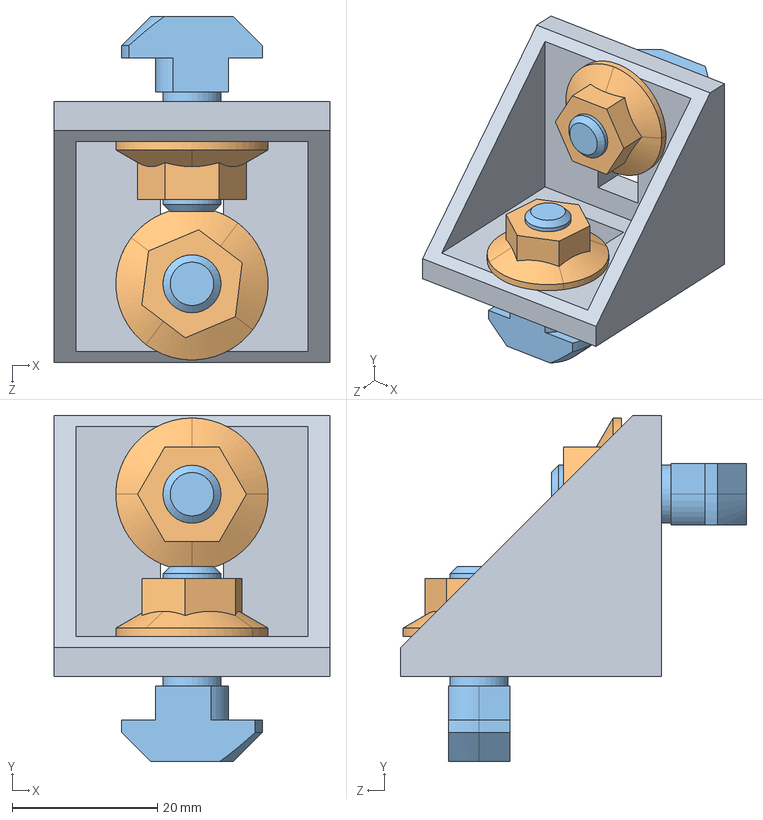
[picture p92: CAD file, 2025-12-09, last stored version]
Solidworks/Bosch Basics/Bracket/Assieme/Bracket_40_40_set_long.SLDASM
38.0 x 47.7 x 47.7 mm
bracket_40_40
FLANGE_NUT_M8 x 2
T_BOLT_short x 2
