effibot/thesis_latex/Solidworks/Bosch Basics/Profilati/Assieme/longherone_h.SLDASM

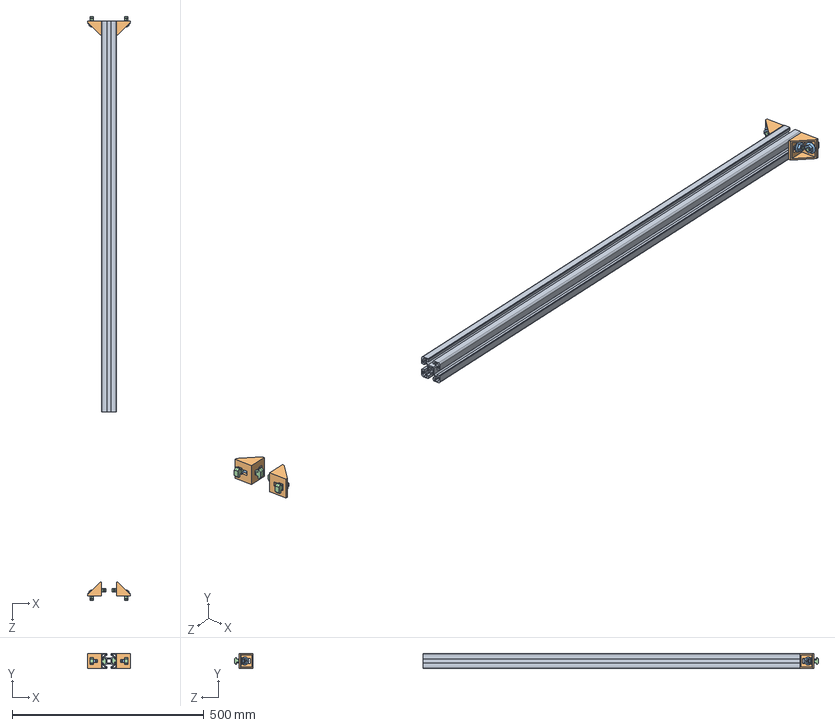
[picture p93: CAD file, 2025-12-09, last stored version]
Solidworks/Bosch Basics/Profilati/Assieme/longherone_h.SLDASM
112.0 x 40.0 x 1523.4 mm
profilato_1020
bracket_40_40 x 4
FLANGE_NUT_M8 x 8
T_BOLT_short x 8
