effibot/thesis_latex/Solidworks/Final Version/robot_body.SLDASM

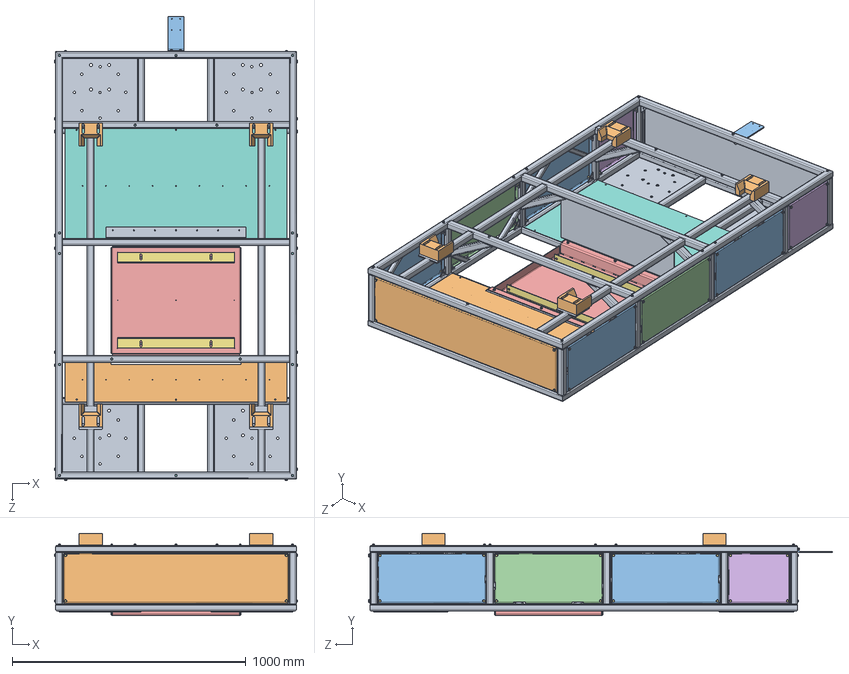
[picture p94: CAD file, 2025-12-09, last stored version]
Solidworks/Final Version/robot_body.SLDASM
1042.2 x 351.5 x 1986.1 mm
00-P-PT0151_Default_A macchina_.step
00-P-PT0177.step
00-P-PT0153.step x 4
00-P-PT0169.step x 2
00-P-PT0154.step
00-P-PT0168.step x 2
00-A-PT0167.step x 2
00-P-PT0173.step
00-p-pt0152.step
00-P-PT0175.step
00-p-pt0176.step
Rosetta Piana UNI6592_130909006.step x 37
Rosetta Piana UNI6592_130909005.step x 28
V.T.E. Zinc UNI 5739_130328056.step x 10
V.T.E. Zinc UNI 5739_130328089.step x 36
V.T.E. Zinc UNI 5739 M5_Vite TE M5X16.step x 18
00-P-PT0178.step
cuneo_pedana x 4
