effibot/thesis_latex/Solidworks/Mockup/agv_assembly.SLDASM

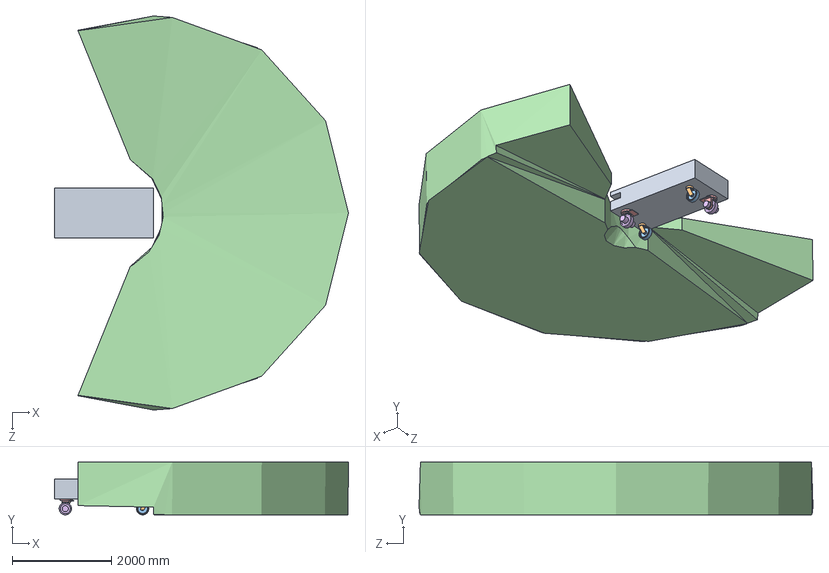
[picture p95: CAD file, 2025-12-09, last stored version]
Solidworks/Mockup/agv_assembly.SLDASM
5937.7 x 1065.3 x 7955.2 mm
base
castor_staff x 2
castor_wheel x 2
lidar
steer_motor_support x 2
traction_motor_wheel x 2
