effibot/thesis_latex/Solidworks/test_kart/LAG_20017FR.SLDASM

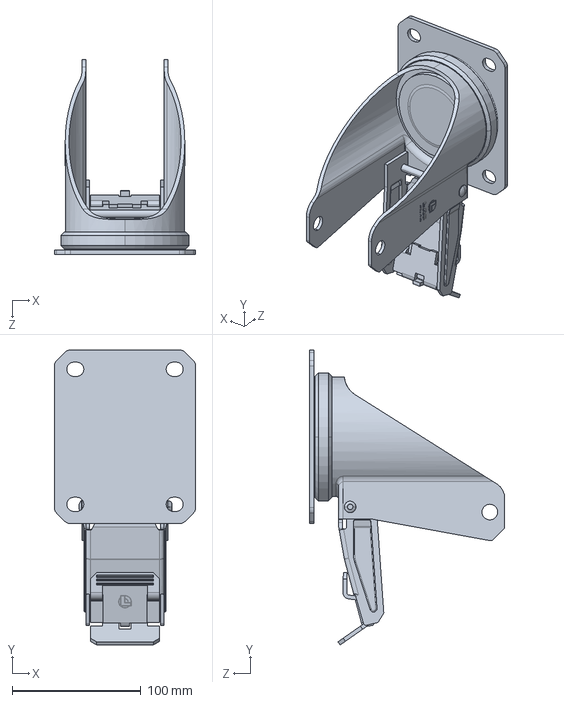
[picture p96: CAD file, 2025-12-09, last stored version]
Solidworks/test_kart/LAG_20017FR.SLDASM
110.0 x 229.4 x 152.0 mm
