effibot/thesis_latex/Solidworks/Bosch Basics/Profilati/Assieme/Piano_base.SLDASM

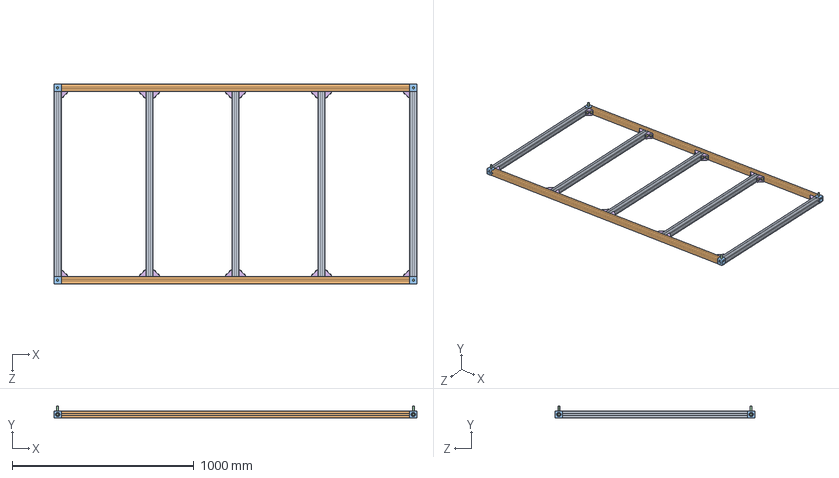
[picture p97: CAD file, 2025-12-09, last stored version]
Solidworks/Bosch Basics/Profilati/Assieme/Piano_base.SLDASM
2000.0 x 66.8 x 1100.0 mm
profilato_1020 x 5
profilato_1920 x 2
cubic_joint_3 x 4
CORE_SCREW_S12X30_T50 x 12
T_BOLT x 6
bracket_40_40 x 16
FLANGE_NUT_M8 x 32
T_BOLT_short x 32
