effibot/thesis_latex/Solidworks/Motore/mockup/Assieme.SLDASM

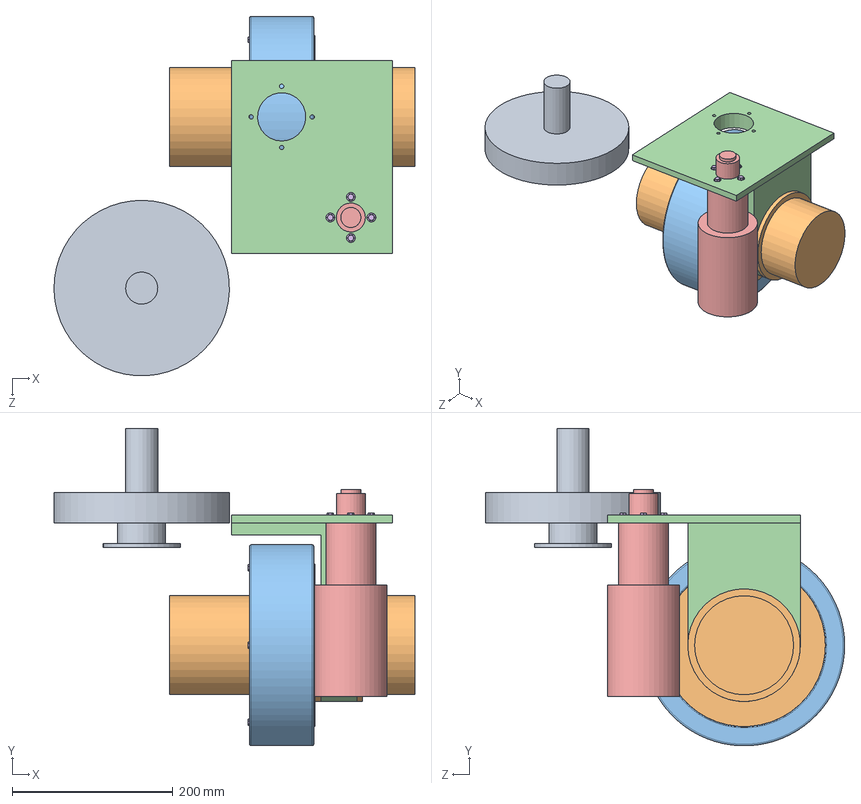
[picture p98: CAD file, 2025-12-09, last stored version]
Solidworks/Motore/mockup/Assieme.SLDASM
448.6 x 394.5 x 446.6 mm
trazione
wheel2
supporto_sterzo
sterzo
supporto_base
hex flange bolt small_iso x 8
