effibot/thesis_latex/Solidworks/Bosch Basics/Profilati/Assieme/body_skeleton.SLDASM

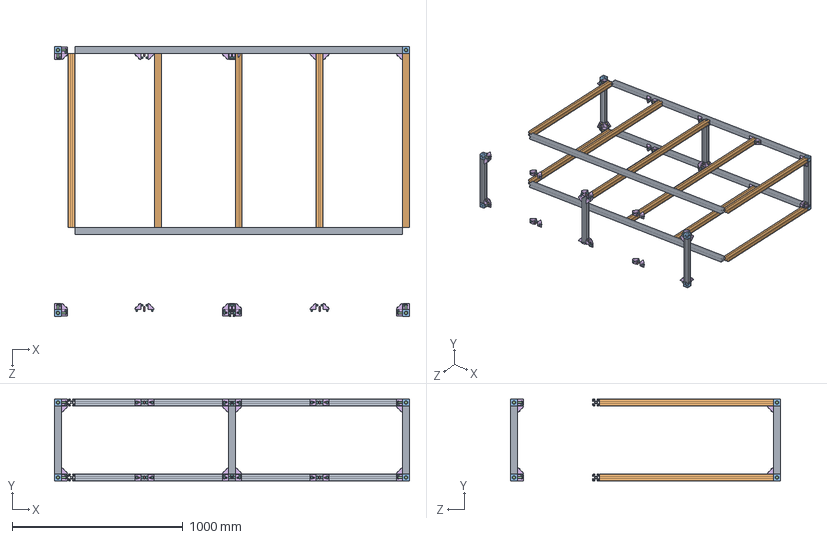
[picture p99: CAD file, 2025-12-09, last stored version]
Solidworks/Bosch Basics/Profilati/Assieme/body_skeleton.SLDASM
2080.0 x 480.0 x 1580.0 mm
profilato_1020 x 10
profilato_1920 x 4
cubic_joint_3 x 8
CORE_SCREW_S12X30_T50 x 24
T_BOLT x 12
bracket_40_40 x 60
FLANGE_NUT_M8 x 120
T_BOLT_short x 120
profilato_400 x 6
