effibot/thesis_latex/Solidworks/Mockup/castor/castor.SLDASM

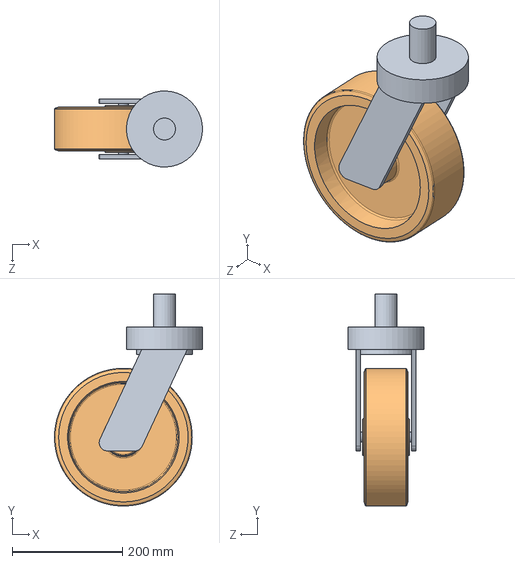
[picture p100: CAD file, 2025-12-09, last stored version]
Solidworks/Mockup/castor/castor.SLDASM
268.6 x 384.7 x 137.9 mm
castor_staff
castor_wheel
