effibot/thesis_latex/Solidworks/Mockup/FRS240/frs240v2.SLDASM

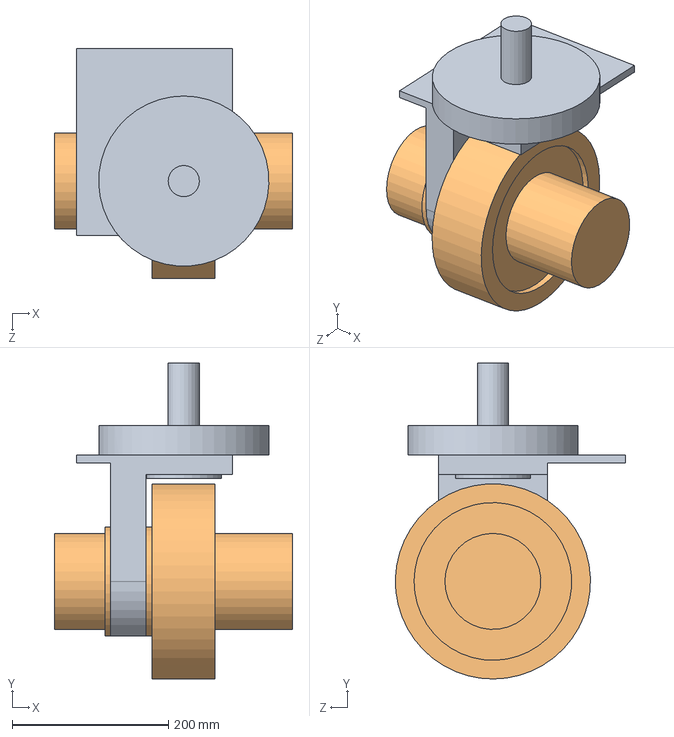
[picture p101: CAD file, 2025-12-09, last stored version]
Solidworks/Mockup/FRS240/frs240v2.SLDASM
305.0 x 404.8 x 294.9 mm
steer_motor_support
traction_motor_wheel
