effibot/thesis_latex/Solidworks/Final Version/MRT05.SLDASM

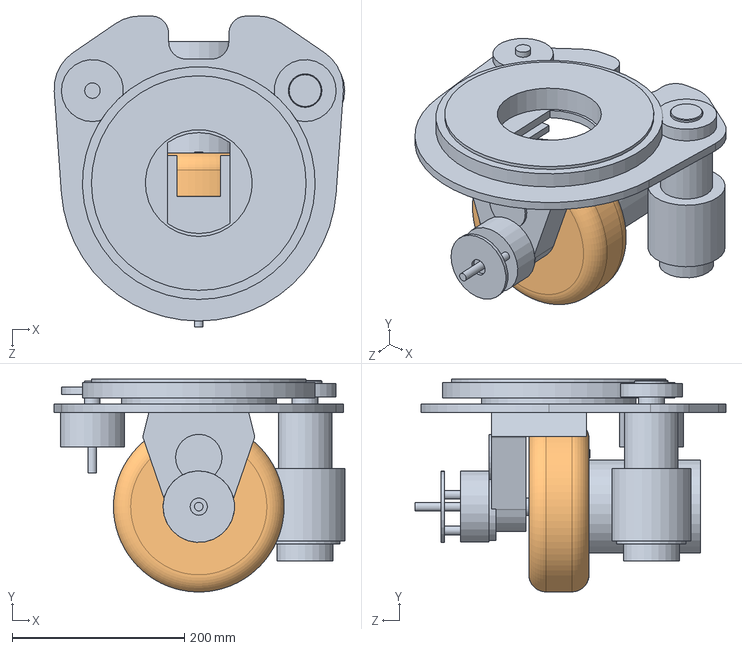
[picture p102: CAD file, 2025-12-09, last stored version]
Solidworks/Final Version/MRT05.SLDASM
337.1 x 246.9 x 360.8 mm
MRT05
MRT05_wheel
