effibot/thesis_latex/Solidworks/test_kart/castor.SLDASM

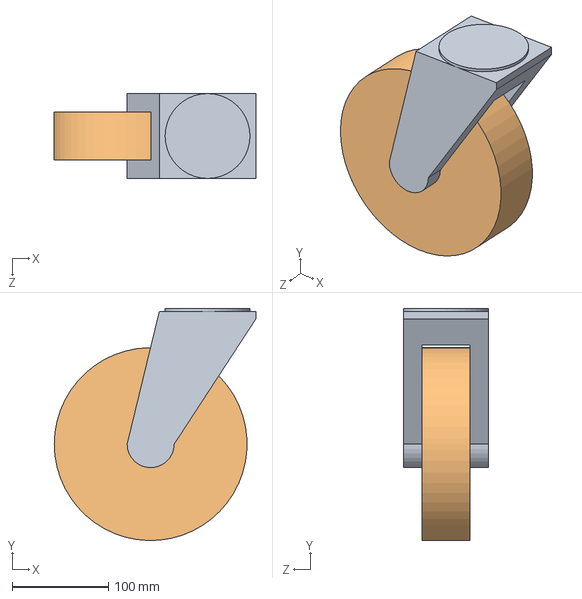
[picture p103: CAD file, 2025-12-09, last stored version]
Solidworks/test_kart/castor.SLDASM
209.0 x 240.6 x 88.0 mm
pivot
wheel
