effibot/thesis_latex/Solidworks/Final Version/SD-25C-12.SLDASM

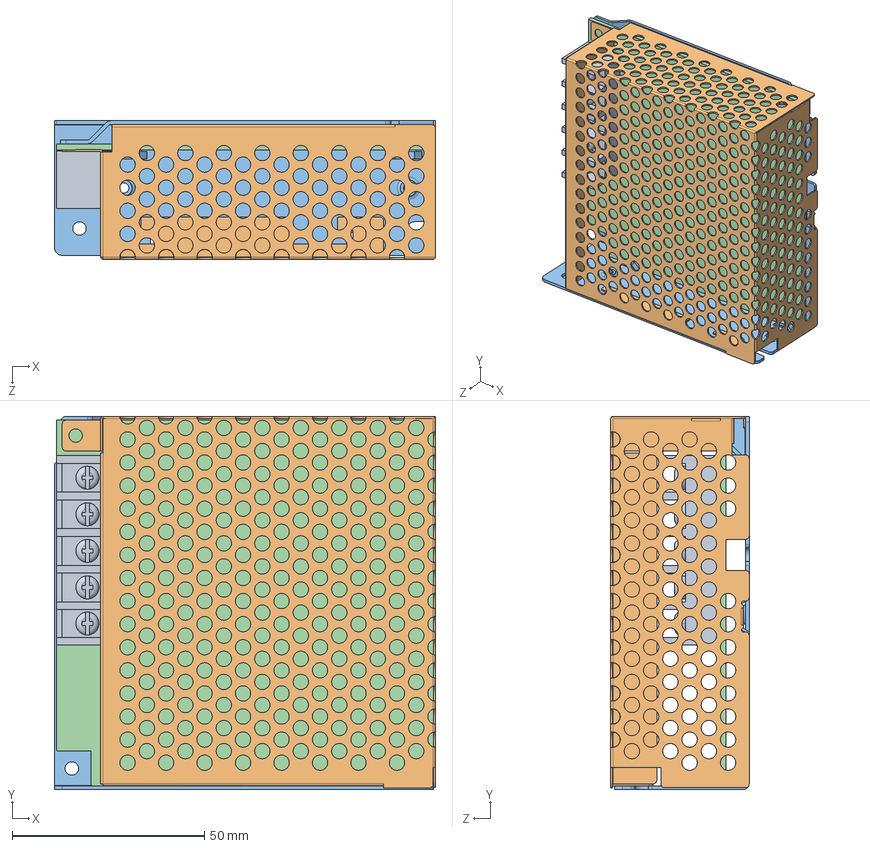
[picture p104: CAD file, 2025-12-09, last stored version]
Solidworks/Final Version/SD-25C-12.SLDASM
99.0 x 97.0 x 36.0 mm
TN1_2.PRT.stp
RS-50-CASE-T_21.PRT.stp
RS-50-CASE-D_28.PRT.stp
RS-50-PCB_2.PRT.stp
