effibot/thesis_latex/Solidworks/Mockup/FRS240/frs240.SLDASM

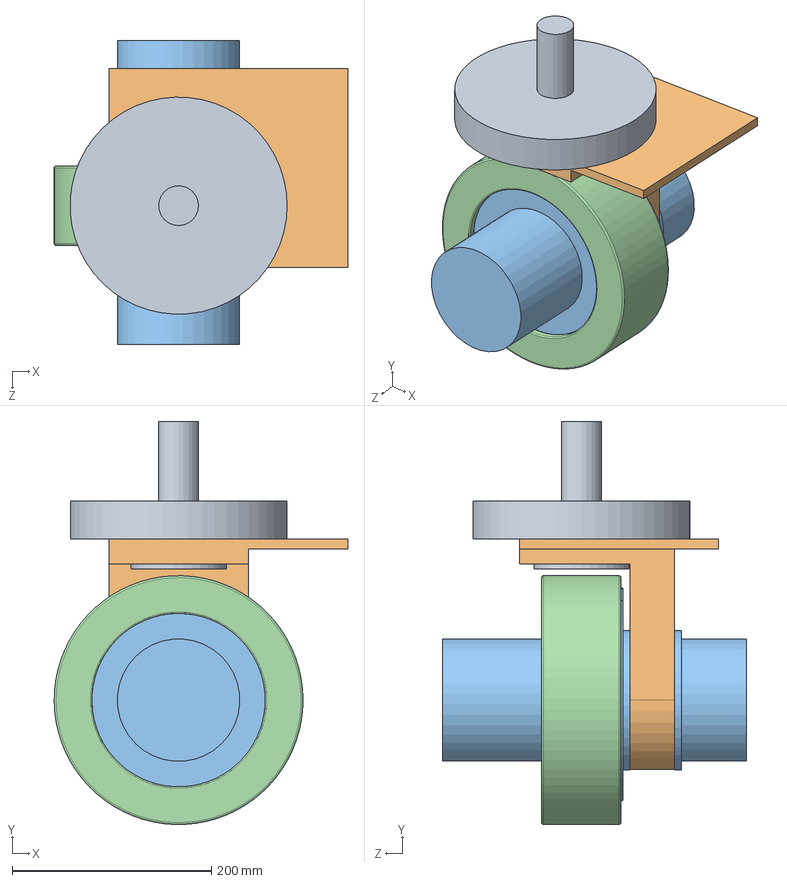
[picture p105: CAD file, 2025-12-09, last stored version]
Solidworks/Mockup/FRS240/frs240.SLDASM
295.0 x 404.7 x 305.0 mm
steer_fake_motor
steer_support
traction_motor
wheel
