effibot/thesis_latex/Solidworks/wheels/castor_250_manual.SLDASM

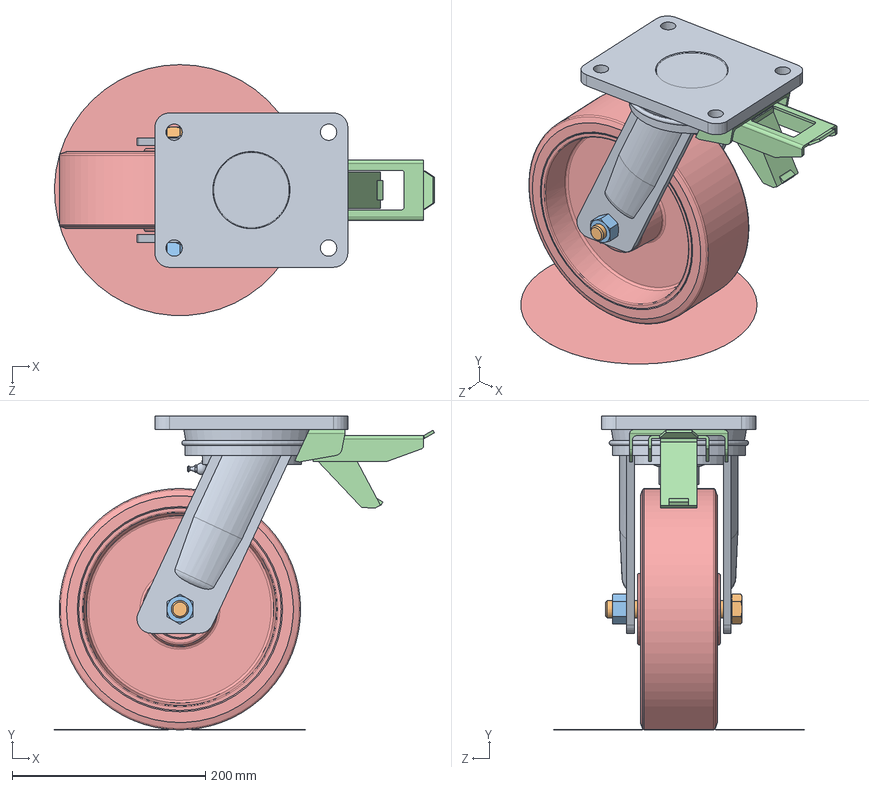
[picture p106: CAD file, 2025-12-09, last stored version]
Solidworks/wheels/castor_250_manual.SLDASM
393.7 x 325.0 x 259.8 mm
staffa
Bolt M18-130
Nut M18
freno
Mould-on polyurethane wheels RE.F4-250-RSL.stp
