effibot/thesis_latex/Solidworks/wheels/Mould-on polyurethane wheels RE.F4-250-SSF-WEH.stp.SLDASM

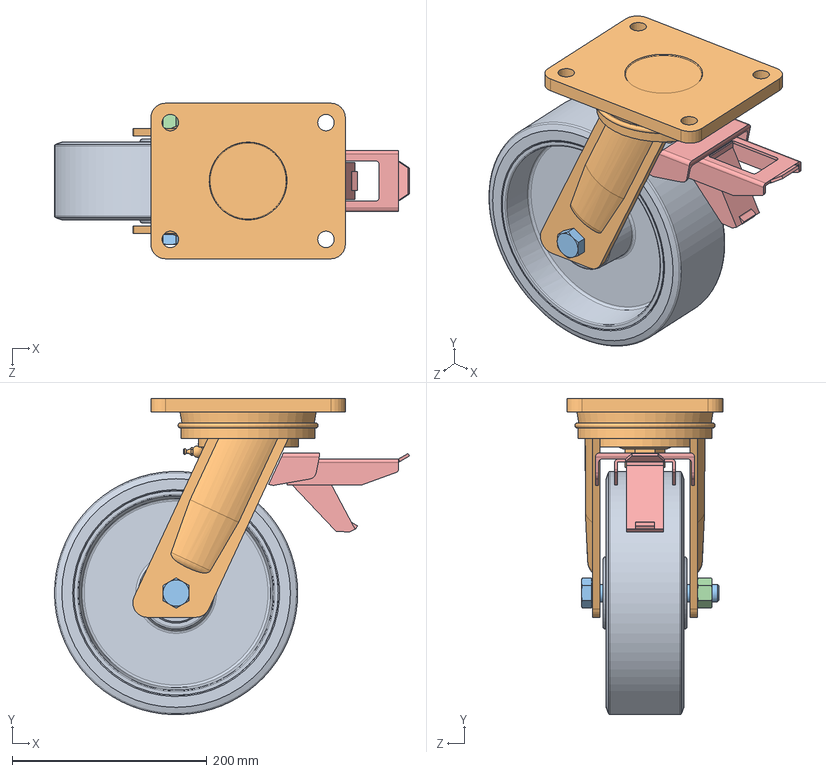
[picture p107: CAD file, 2025-12-09, last stored version]
Solidworks/wheels/Mould-on polyurethane wheels RE.F4-250-SSF-WEH.stp.SLDASM
364.9 x 324.9 x 160.0 mm
Mould-on polyurethane wheels RE.F4-250-RSL.stp
SRP_EE HD 250-80-200x160-b.stp
Bolt M18-130(GREY).stp
Nut M18(GREY).stp
re_f4_weh_20080-3-br.stp
