effibot/thesis_latex/Solidworks/Final Version/inverter_box.SLDASM

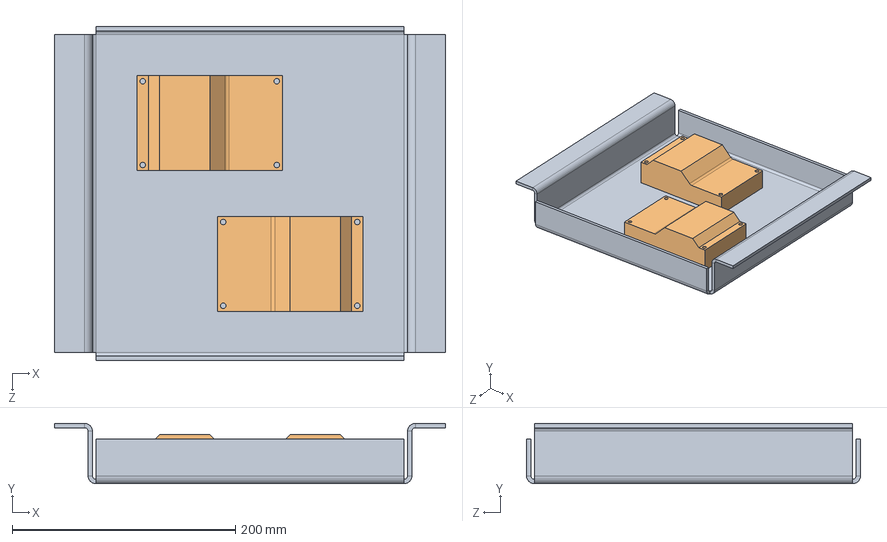
[picture p108: CAD file, 2025-12-09, last stored version]
Solidworks/Final Version/inverter_box.SLDASM
350.0 x 54.0 x 299.0 mm
00-P-PT0154-2
minitraction_power_mockup x 2
