effibot/thesis_latex/Solidworks/Final Version/LAG_19871.SLDASM

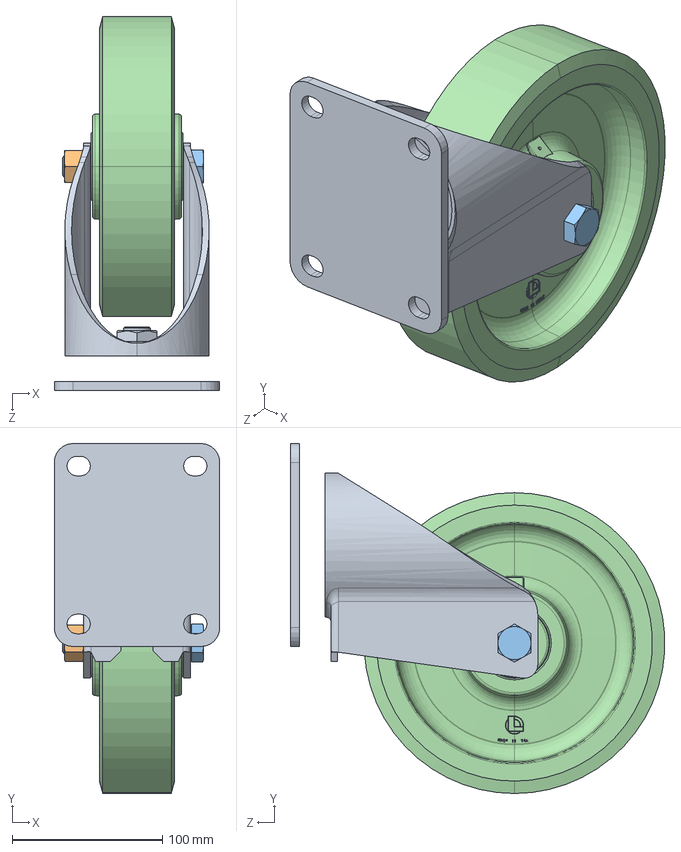
[picture p109: CAD file, 2025-12-09, last stored version]
Solidworks/Final Version/LAG_19871.SLDASM
110.0 x 232.7 x 248.8 mm
19871_CL.2^LAG_19871(2)_LAG_19871
19871_CL.4^LAG_19871(2)_LAG_19871
19871_CL.3^LAG_19871(2)_LAG_19871
19871_CL.1^LAG_19871(2)_LAG_19871
