effibot/thesis_latex/Solidworks/Final Version/LAG_21142FR.SLDASM

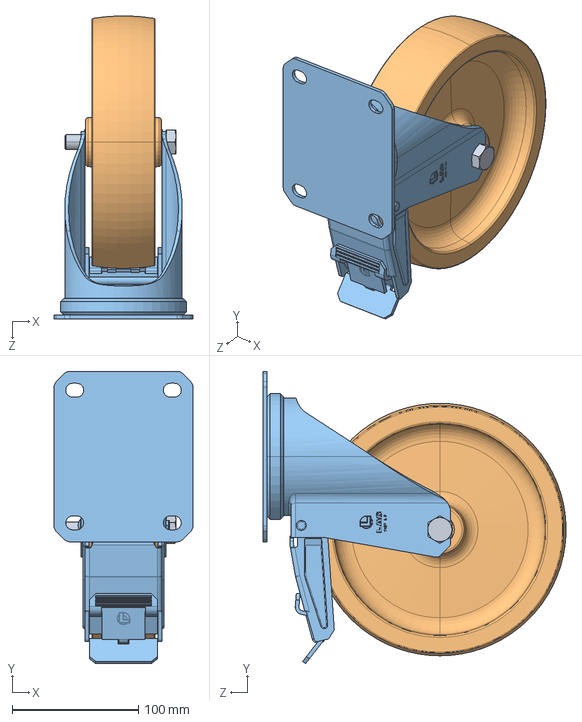
[picture p110: CAD file, 2025-12-09, last stored version]
Solidworks/Final Version/LAG_21142FR.SLDASM
110.0 x 231.5 x 239.8 mm
21142FR_CL.4.stp
21142FR_CL.2.stp
