effibot/thesis_latex/Solidworks/Final Version/castor_wheel.SLDASM

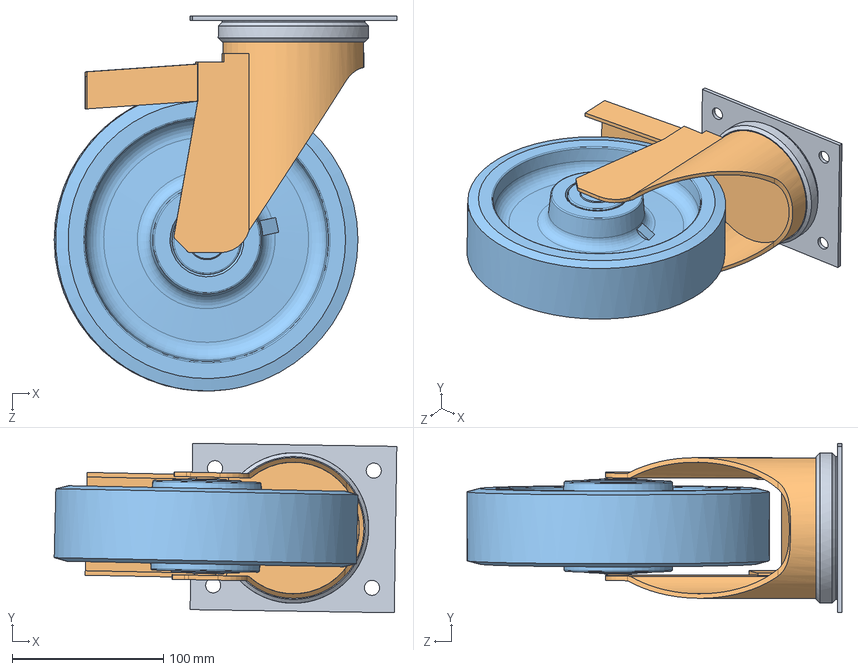
[picture p111: CAD file, 2025-12-09, last stored version]
Solidworks/Final Version/castor_wheel.SLDASM
226.6 x 112.1 x 247.9 mm
piastra_pivot
pivot
wheel_200
