effibot/thesis_latex/Solidworks/Final Version/castor_pivot.SLDASM

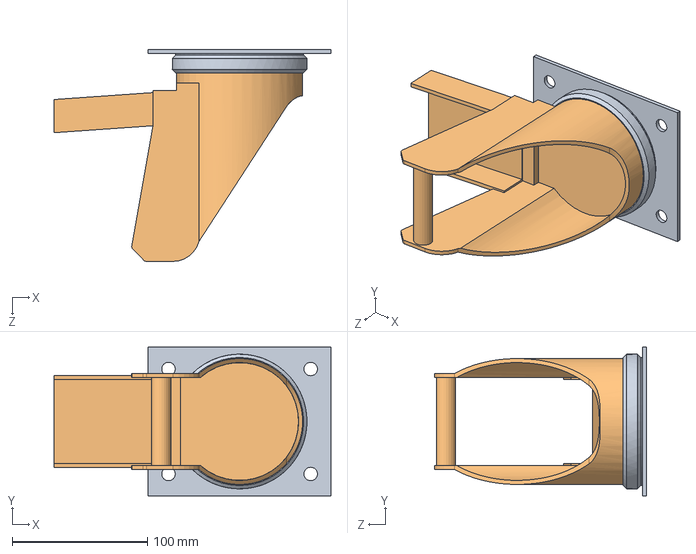
[picture p112: CAD file, 2025-12-09, last stored version]
Solidworks/Final Version/castor_pivot.SLDASM
204.6 x 110.0 x 156.5 mm
piastra_pivot
pivot
