effibot/thesis_latex/kart_urdf/meshes/wheel_br_link.STL

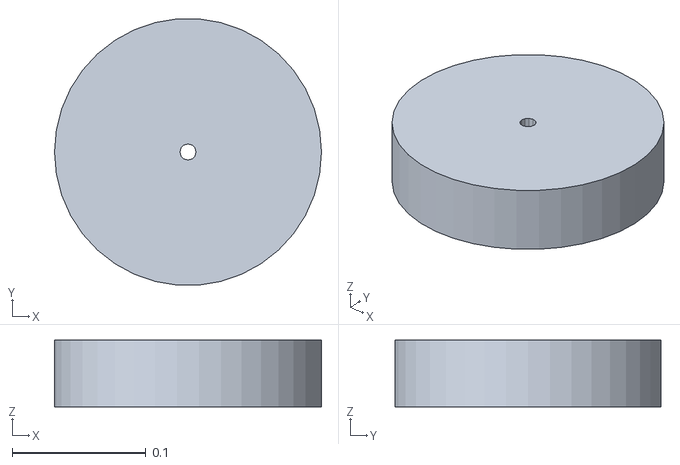
[picture p113: CAD file, 2025-12-09, last stored version]
kart_urdf/meshes/wheel_br_link.STL
0.2 x 0.199 x 0.05
