effibot/thesis_latex/Solidworks/Bosch Basics/Bracket/bracket_40_40.SLDPRT

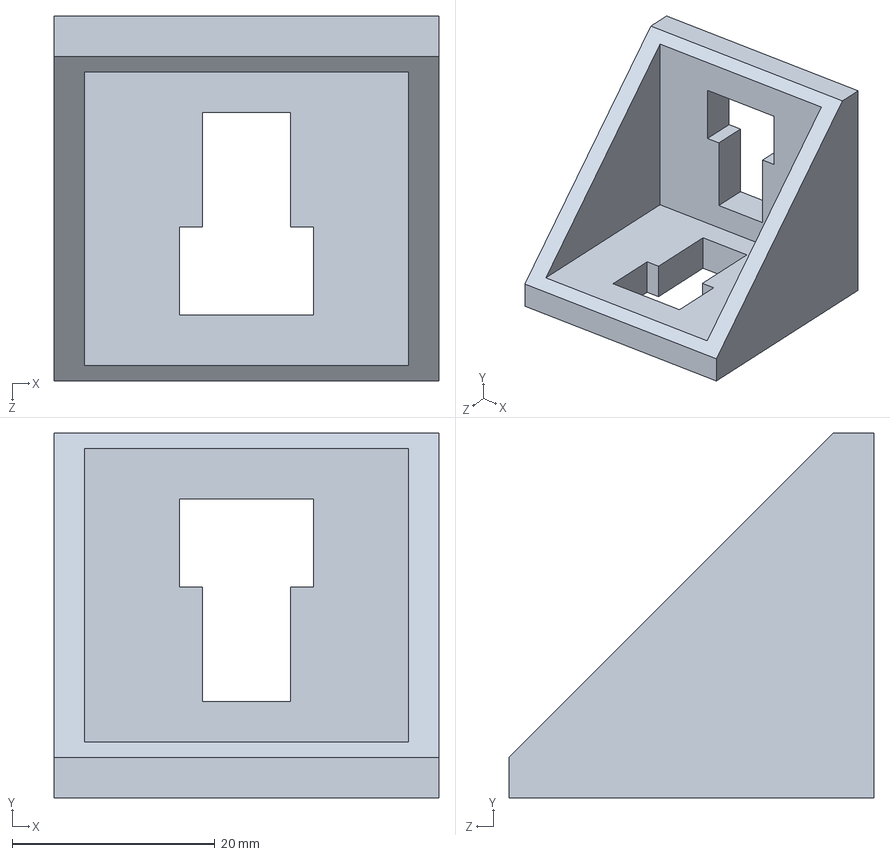
[picture p114: CAD file, 2025-12-09, last stored version]
Solidworks/Bosch Basics/Bracket/bracket_40_40.SLDPRT
38.0 x 36.0 x 36.0 mm
