effibot/thesis_latex/Solidworks/Bosch Basics/Dadi&Viti&Giunti/cubic_joint_3.SLDPRT

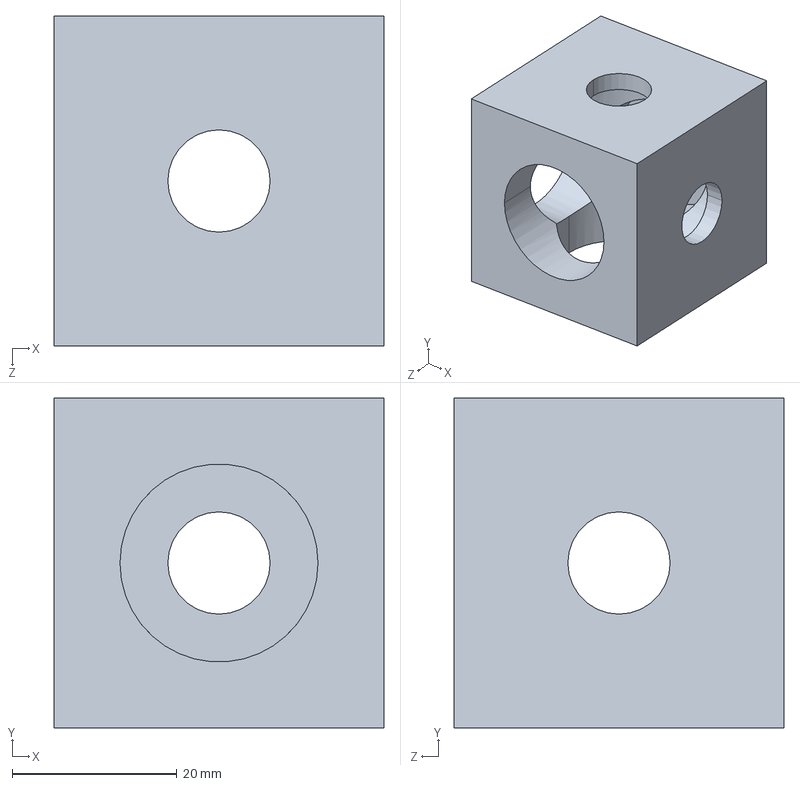
[picture p115: CAD file, 2025-12-09, last stored version]
Solidworks/Bosch Basics/Dadi&Viti&Giunti/cubic_joint_3.SLDPRT
40.0 x 40.0 x 40.0 mm
