effibot/thesis_latex/Solidworks/Bosch Basics/Lamiere/supporto_motore.SLDPRT

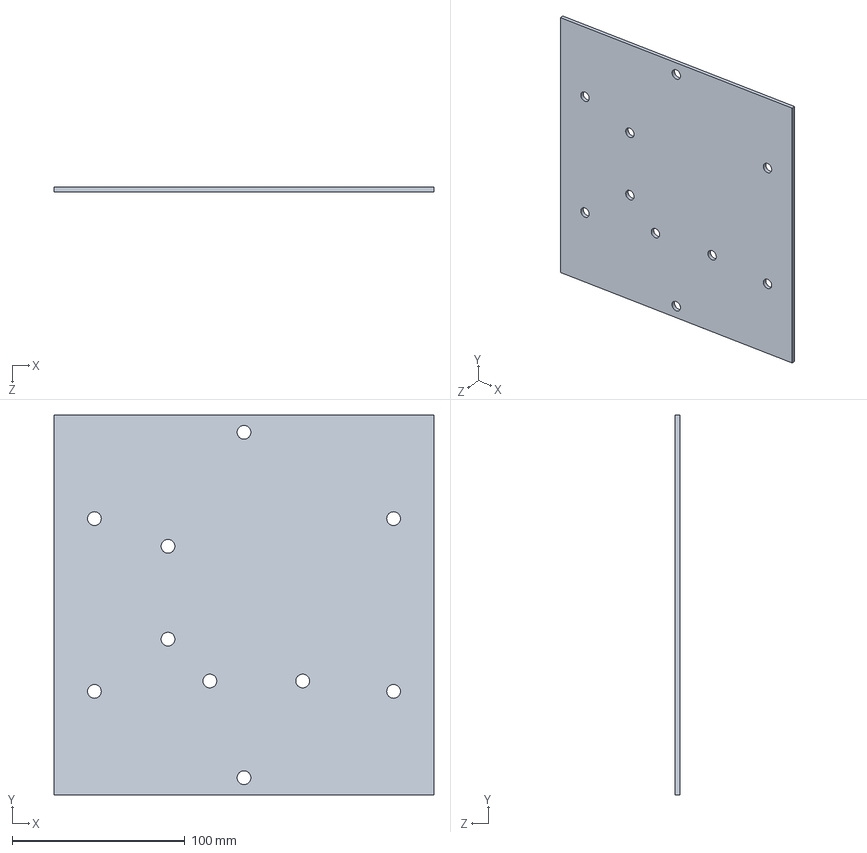
[picture p116: CAD file, 2025-12-09, last stored version]
Solidworks/Bosch Basics/Lamiere/supporto_motore.SLDPRT
220.0 x 220.0 x 3.00 mm
