effibot/thesis_latex/Solidworks/Bosch Basics/Profilati/profilato_1020.SLDPRT

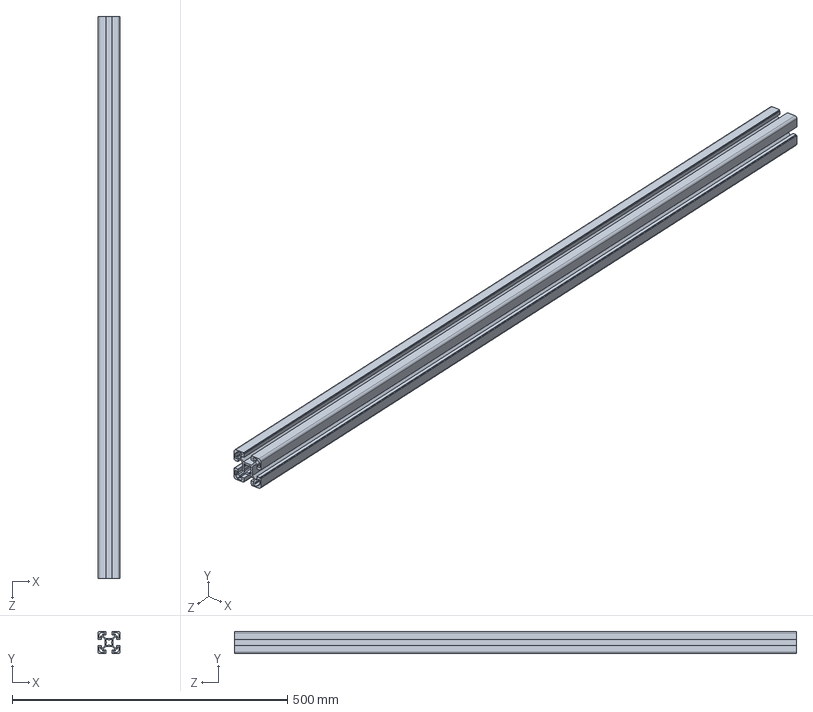
[picture p117: CAD file, 2025-12-09, last stored version]
Solidworks/Bosch Basics/Profilati/profilato_1020.SLDPRT
40.0 x 40.0 x 1020.0 mm
