effibot/thesis_latex/Solidworks/Mockup/agv_urdf/meshes/castor_b_w_link.STL

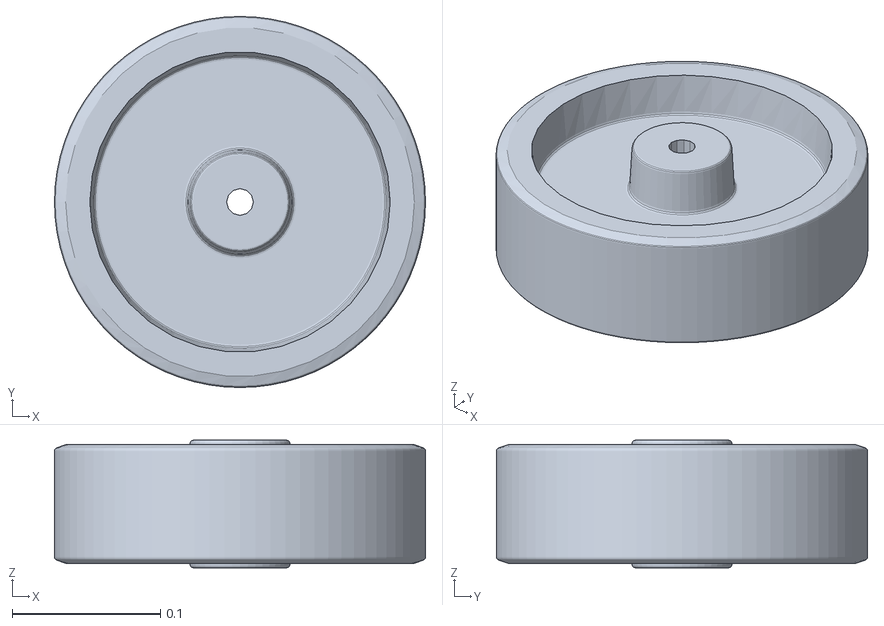
[picture p118: CAD file, 2025-12-09, last stored version]
Solidworks/Mockup/agv_urdf/meshes/castor_b_w_link.STL
0.25 x 0.25 x 0.086
