effibot/thesis_latex/Solidworks/Mockup/castor/castor_wheel.SLDPRT

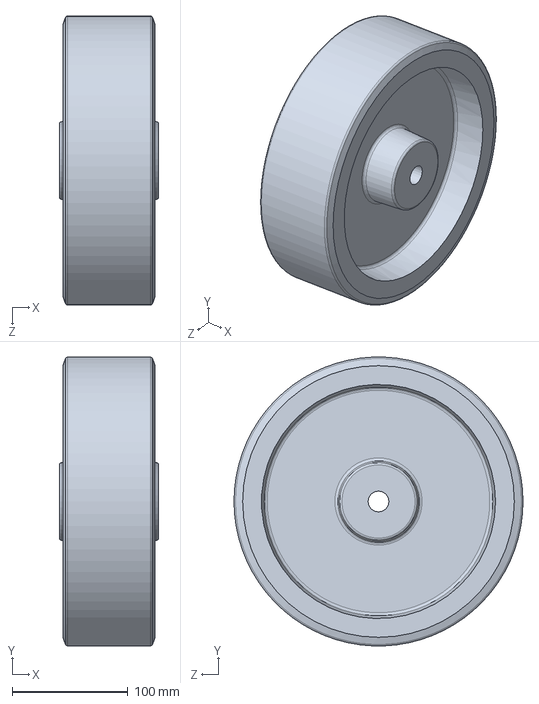
[picture p119: CAD file, 2025-12-09, last stored version]
Solidworks/Mockup/castor/castor_wheel.SLDPRT
86.0 x 249.8 x 250.0 mm
