effibot/thesis_latex/Solidworks/Mockup/FRS240/steer_motor_support.SLDPRT

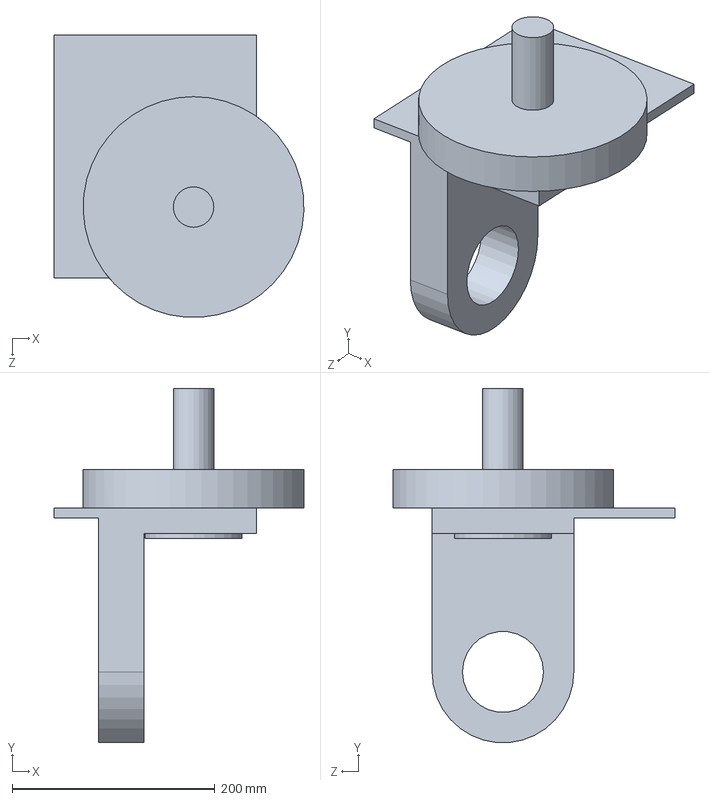
[picture p120: CAD file, 2025-12-09, last stored version]
Solidworks/Mockup/FRS240/steer_motor_support.SLDPRT
246.6 x 349.5 x 278.7 mm
