effibot/thesis_latex/Solidworks/Mockup/Mid360/lidar_fov.SLDPRT

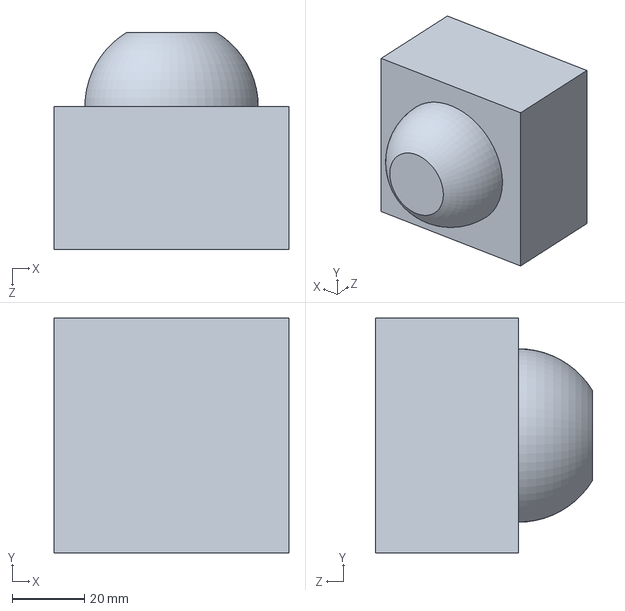
[picture p121: CAD file, 2025-12-09, last stored version]
Solidworks/Mockup/Mid360/lidar_fov.SLDPRT
65.0 x 65.0 x 60.0 mm
