effibot/thesis_latex/Solidworks/Mockup/v2/base_v2.SLDPRT

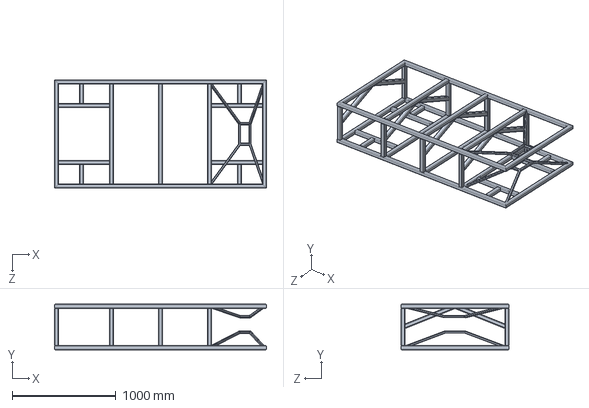
[picture p122: CAD file, 2025-12-09, last stored version]
Solidworks/Mockup/v2/base_v2.SLDPRT
2040.0 x 440.0 x 1040.0 mm
