effibot/thesis_latex/Solidworks/Motore/mockup/wheel.SLDPRT

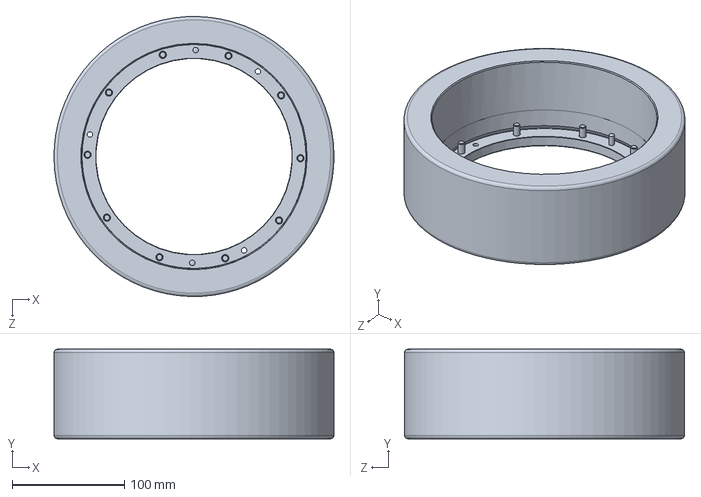
[picture p123: CAD file, 2025-12-09, last stored version]
Solidworks/Motore/mockup/wheel.SLDPRT
250.0 x 80.0 x 249.9 mm
