effibot/thesis_latex/Solidworks/Motore/sterzo.SLDPRT

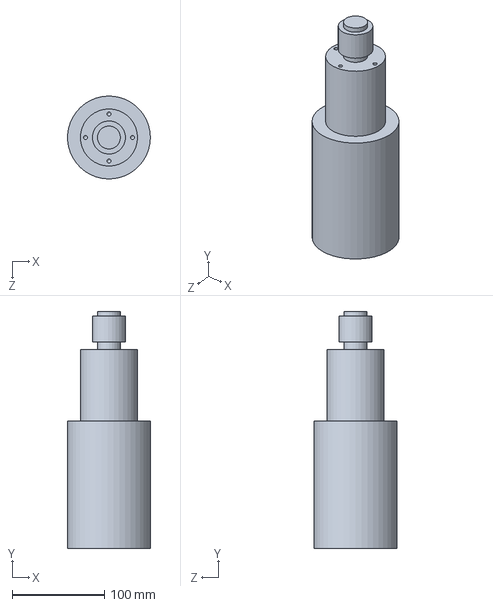
[picture p124: CAD file, 2025-12-09, last stored version]
Solidworks/Motore/sterzo.SLDPRT
89.9 x 257.3 x 89.9 mm
