effibot/thesis_latex/kart_urdf/meshes/battery_link.STL

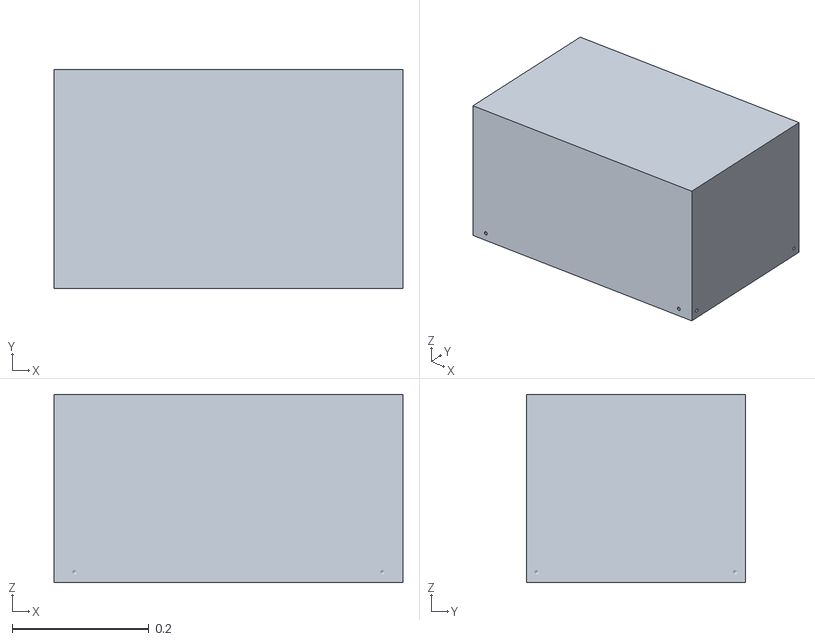
[picture p125: CAD file, 2025-12-09, last stored version]
kart_urdf/meshes/battery_link.STL
0.51 x 0.32 x 0.275
