effibot/thesis_latex/Solidworks/Bosch Basics/Lamiere/lastra_down.SLDPRT

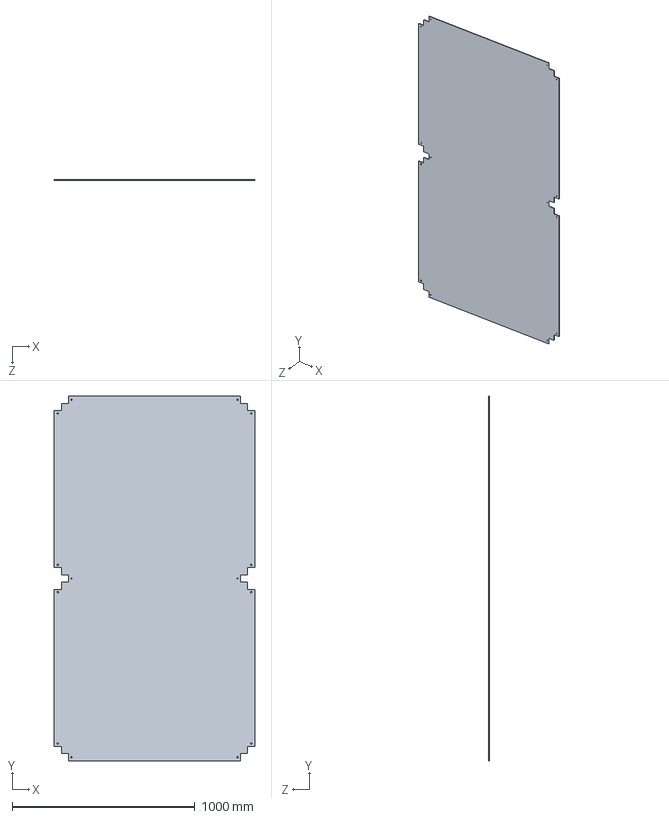
[picture p126: CAD file, 2025-12-09, last stored version]
Solidworks/Bosch Basics/Lamiere/lastra_down.SLDPRT
1100.0 x 2000.0 x 3.00 mm
