effibot/thesis_latex/Solidworks/Final Version/00-P-PT0154-2.SLDPRT

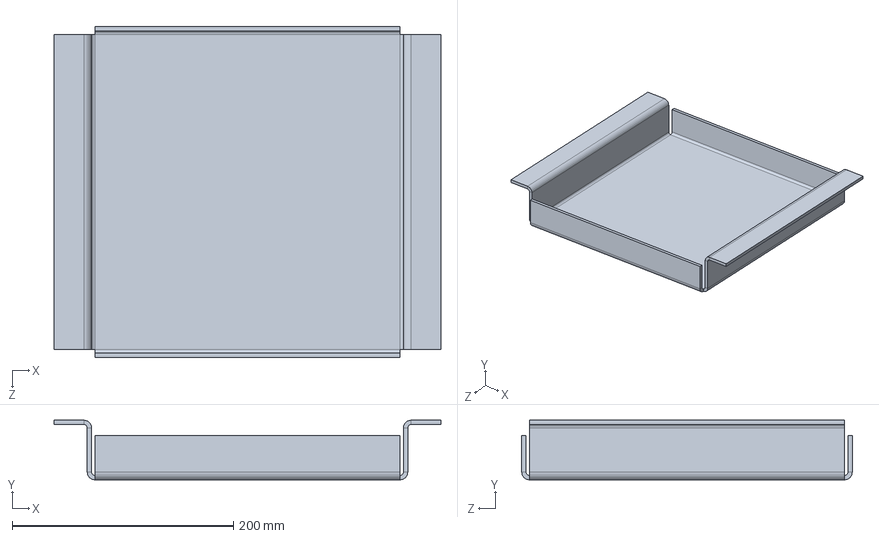
[picture p127: CAD file, 2025-12-09, last stored version]
Solidworks/Final Version/00-P-PT0154-2.SLDPRT
350.0 x 54.0 x 299.0 mm
