effibot/thesis_latex/Solidworks/Mockup/base.SLDPRT

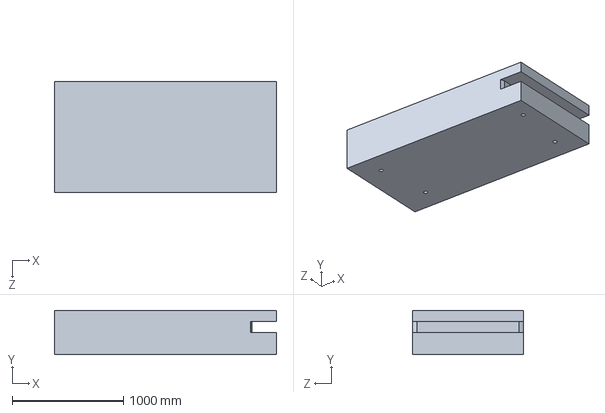
[picture p128: CAD file, 2025-12-09, last stored version]
Solidworks/Mockup/base.SLDPRT
2000.0 x 400.0 x 1000.0 mm
