effibot/thesis_latex/Solidworks/Mockup/castor/castor_base.SLDPRT

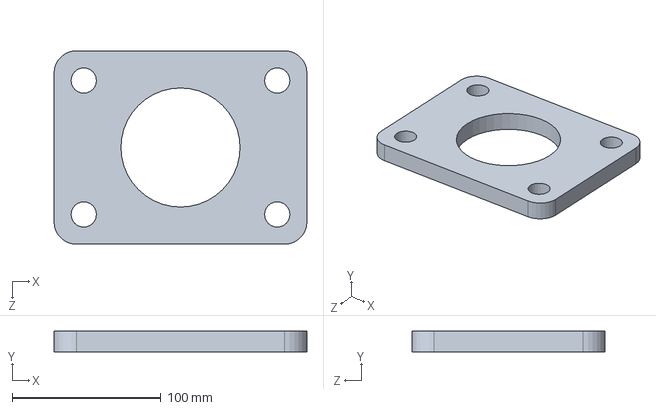
[picture p129: CAD file, 2025-12-09, last stored version]
Solidworks/Mockup/castor/castor_base.SLDPRT
170.0 x 14.0 x 130.0 mm
