effibot/thesis_latex/Solidworks/Mockup/Mid360/lidar.SLDPRT

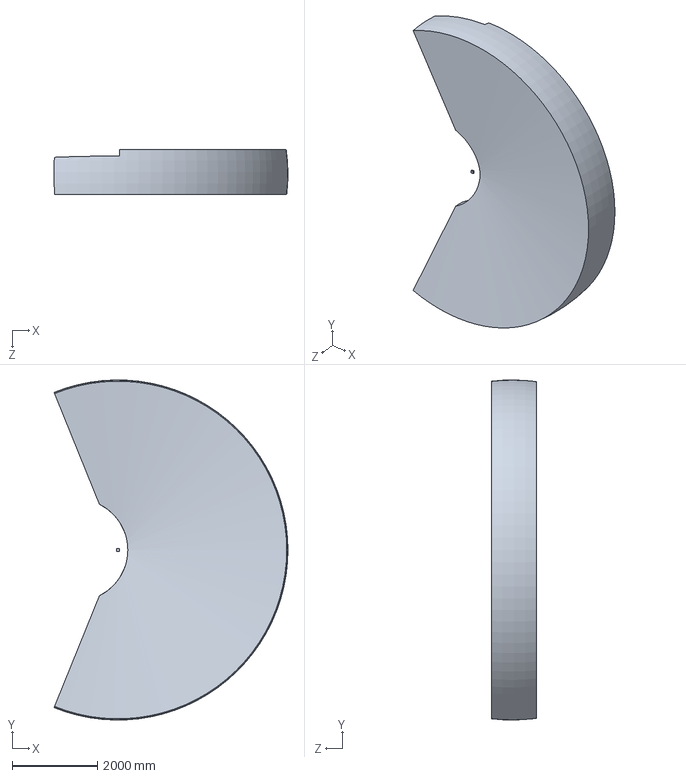
[picture p130: CAD file, 2025-12-09, last stored version]
Solidworks/Mockup/Mid360/lidar.SLDPRT
5502.3 x 7997.4 x 1065.3 mm
