effibot/thesis_latex/Solidworks/Motore/trazione.SLDPRT

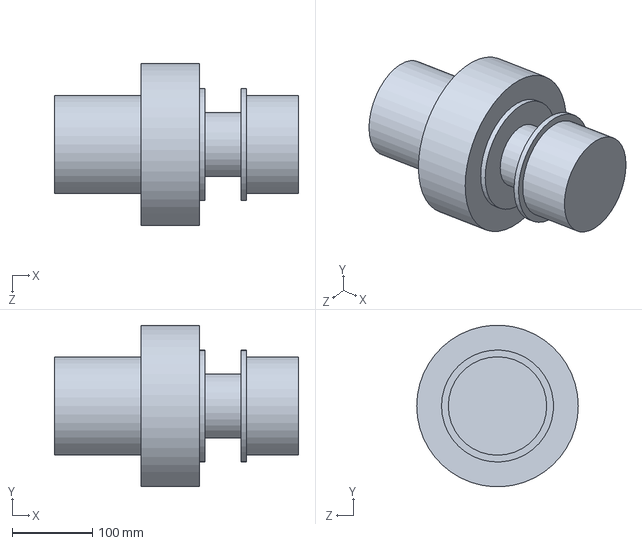
[picture p131: CAD file, 2025-12-09, last stored version]
Solidworks/Motore/trazione.SLDPRT
305.0 x 201.5 x 202.0 mm
