effibot/thesis_latex/Solidworks/test_kart/wheel.SLDPRT

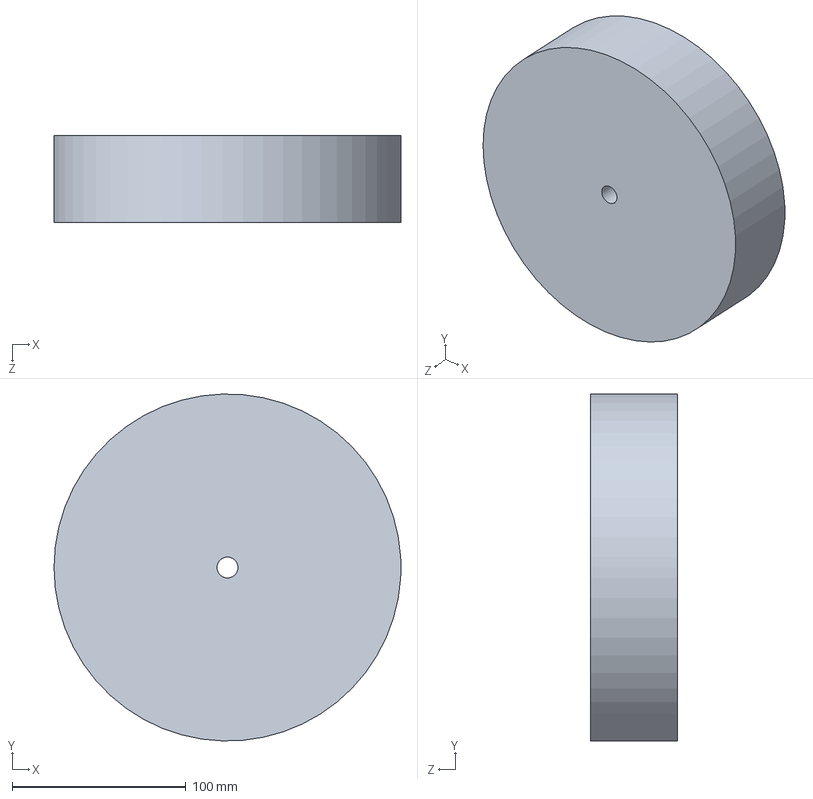
[picture p132: CAD file, 2025-12-09, last stored version]
Solidworks/test_kart/wheel.SLDPRT
200.0 x 199.9 x 50.0 mm
