effibot/thesis_latex/kart_urdf/meshes/pivot_fr_link.STL

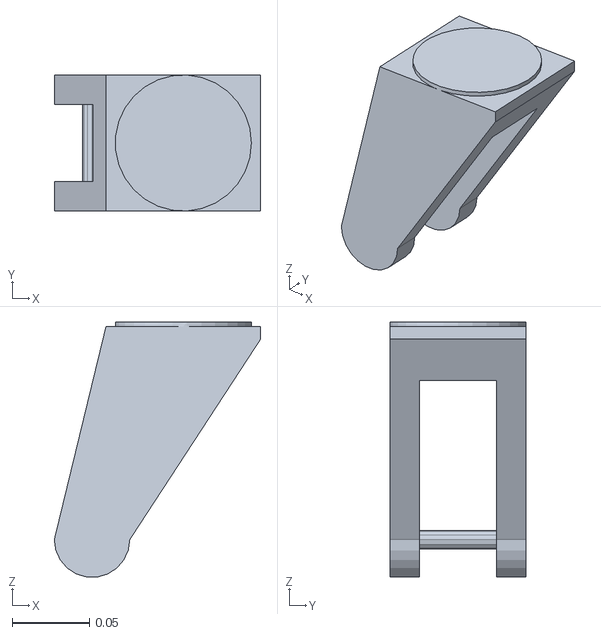
[picture p133: CAD file, 2025-12-09, last stored version]
kart_urdf/meshes/pivot_fr_link.STL
0.133 x 0.088 x 0.165
