effibot/thesis_latex/Solidworks/Bosch Basics/Dadi&Viti&Giunti/distanziale.SLDPRT

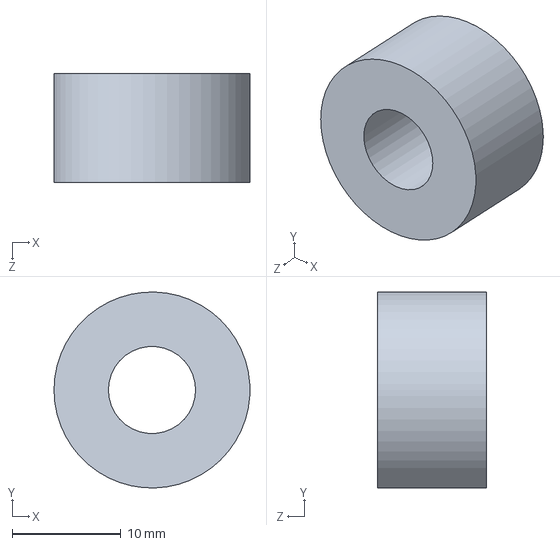
[picture p134: CAD file, 2025-12-09, last stored version]
Solidworks/Bosch Basics/Dadi&Viti&Giunti/distanziale.SLDPRT
18.0 x 18.0 x 10.0 mm
