effibot/thesis_latex/Solidworks/Bosch Basics/Profilati/profilato_400.SLDPRT

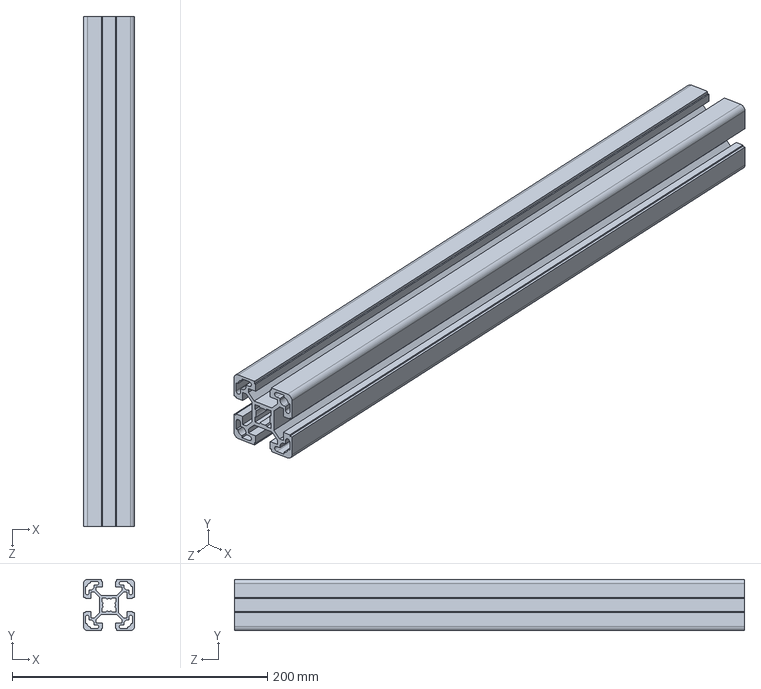
[picture p135: CAD file, 2025-12-09, last stored version]
Solidworks/Bosch Basics/Profilati/profilato_400.SLDPRT
40.0 x 40.0 x 400.0 mm
