effibot/thesis_latex/Solidworks/Final Version/00-P-PT0152.SLDPRT

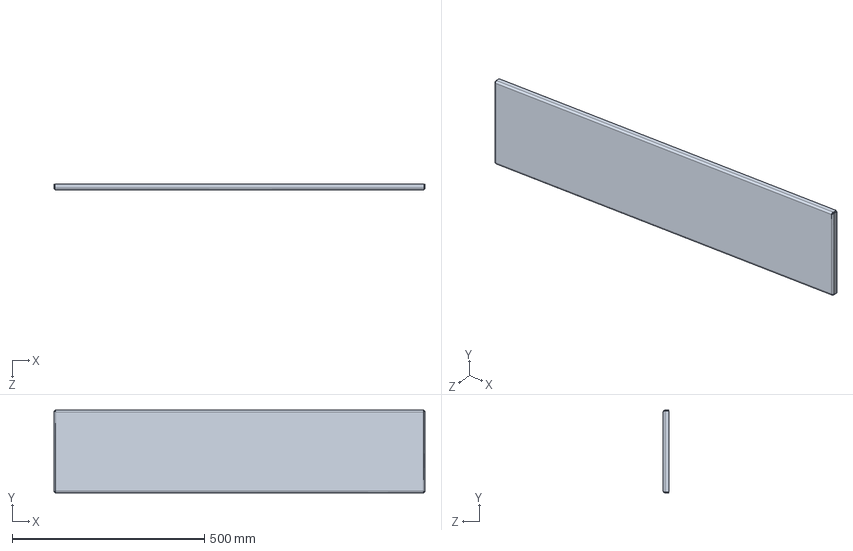
[picture p136: CAD file, 2025-12-09, last stored version]
Solidworks/Final Version/00-P-PT0152.SLDPRT
965.0 x 215.0 x 15.0 mm
