effibot/thesis_latex/Solidworks/Mockup/agv_urdf/meshes/steer_f_link.STL

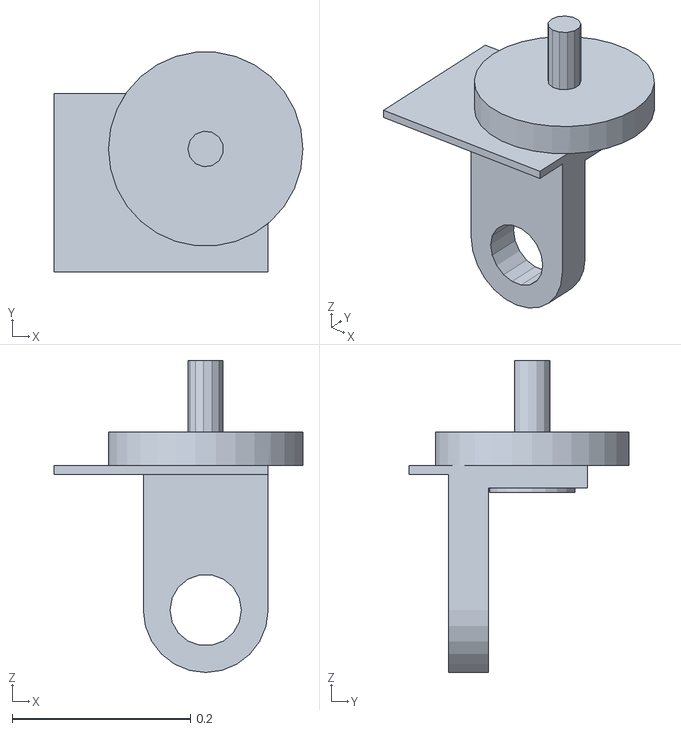
[picture p137: CAD file, 2025-12-09, last stored version]
Solidworks/Mockup/agv_urdf/meshes/steer_f_link.STL
0.279 x 0.246 x 0.35
