effibot/thesis_latex/Solidworks/Motore/mockup/supporto_base.SLDPRT

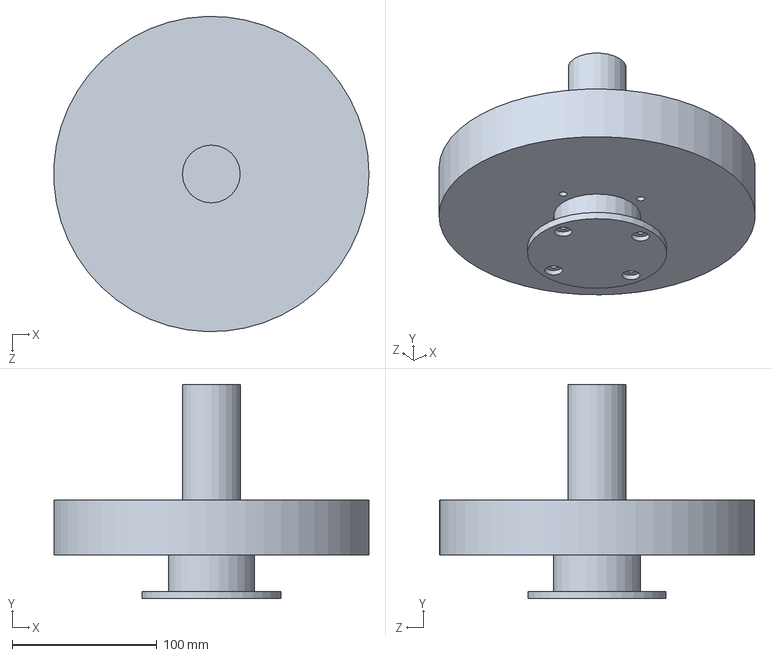
[picture p138: CAD file, 2025-12-09, last stored version]
Solidworks/Motore/mockup/supporto_base.SLDPRT
217.8 x 148.0 x 217.9 mm
