effibot/thesis_latex/Solidworks/test_kart/lidar.SLDPRT

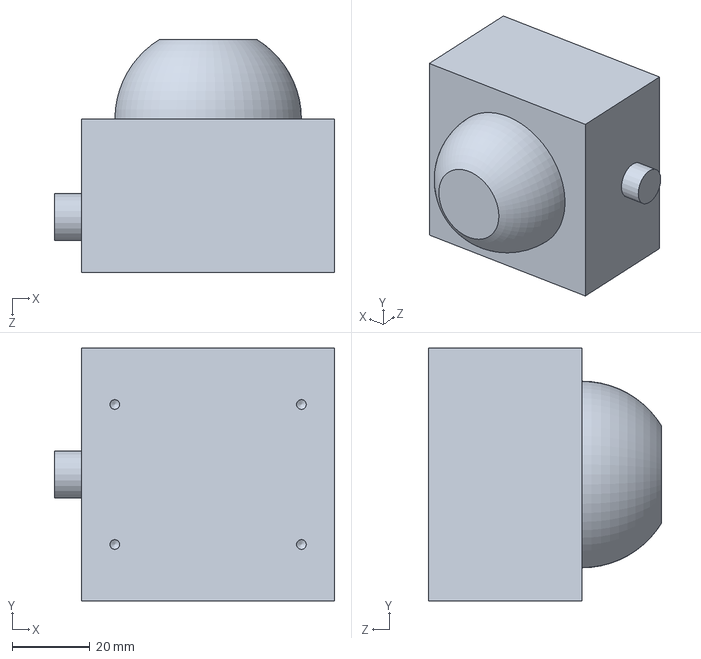
[picture p139: CAD file, 2025-12-09, last stored version]
Solidworks/test_kart/lidar.SLDPRT
72.0 x 65.0 x 60.0 mm
