effibot/thesis_latex/Solidworks/wheels/staffa.SLDPRT

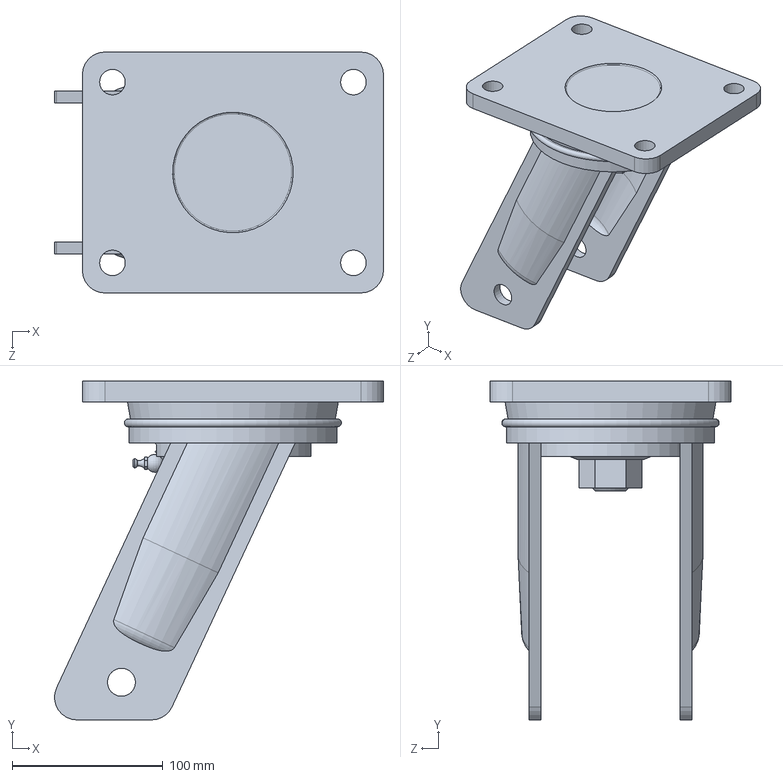
[picture p140: CAD file, 2025-12-09, last stored version]
Solidworks/wheels/staffa.SLDPRT
218.5 x 225.0 x 160.0 mm
