effibot/thesis_latex/kart_urdf/meshes/plate_r_link.STL

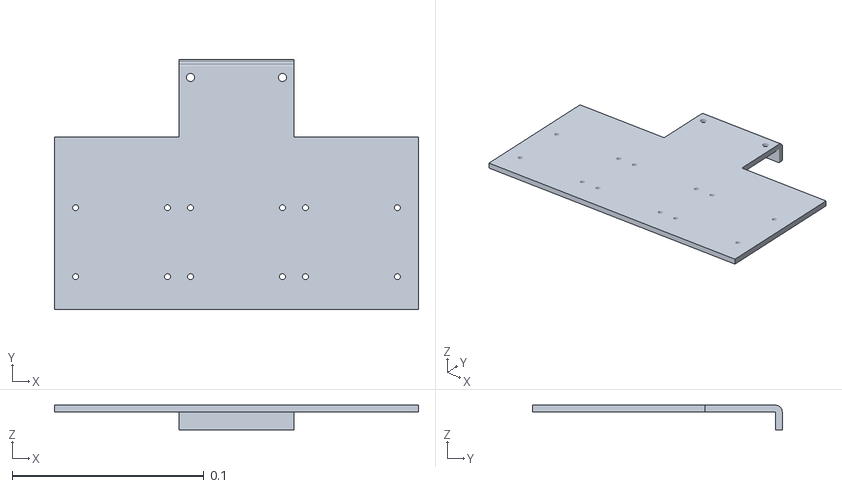
[picture p141: CAD file, 2025-12-09, last stored version]
kart_urdf/meshes/plate_r_link.STL
0.19 x 0.13 x 0.013
