effibot/thesis_latex/Solidworks/Bosch Basics/Profilati/profilato_2000.SLDPRT

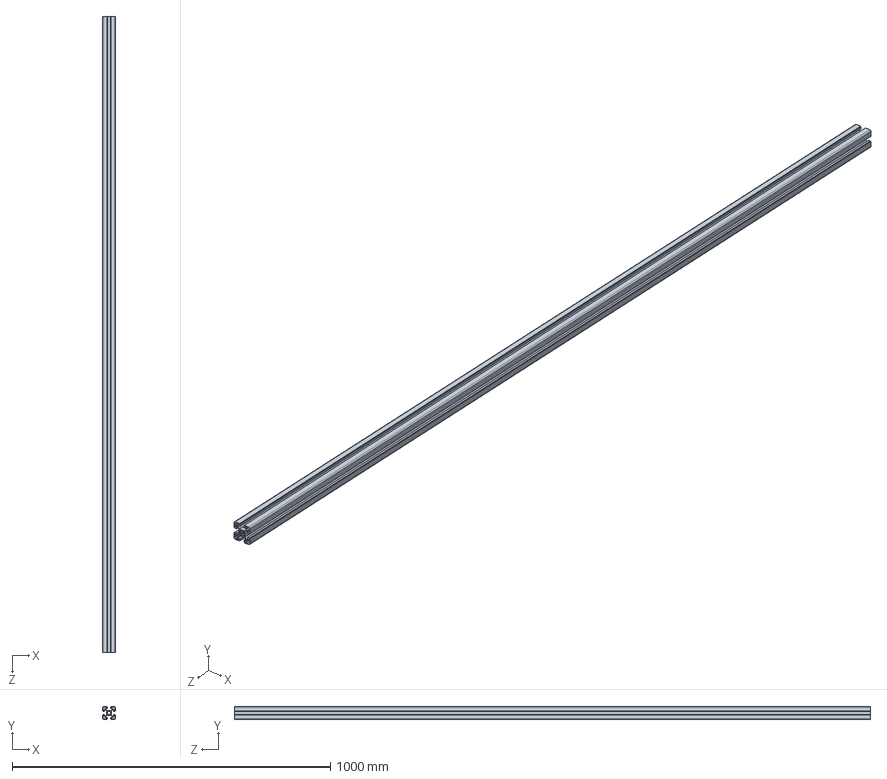
[picture p142: CAD file, 2025-12-09, last stored version]
Solidworks/Bosch Basics/Profilati/profilato_2000.SLDPRT
40.0 x 40.0 x 2000.0 mm
