effibot/thesis_latex/Solidworks/Final Version/00-P-PT0172.step.SLDPRT

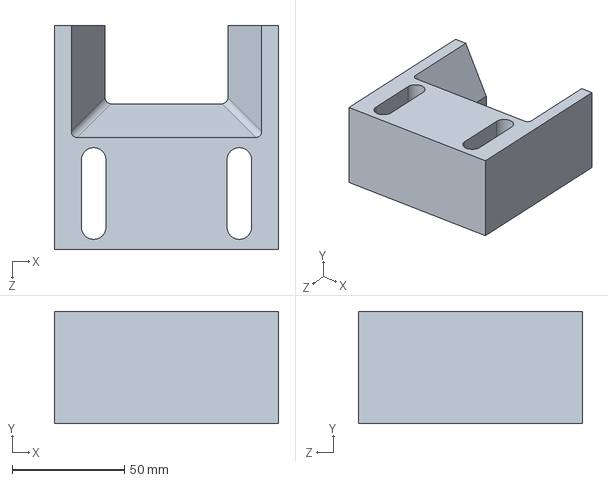
[picture p143: CAD file, 2025-12-09, last stored version]
Solidworks/Final Version/00-P-PT0172.step.SLDPRT
100.0 x 50.0 x 100.0 mm
