effibot/thesis_latex/Solidworks/Mockup/agv_urdf/meshes/lidar_link.STL

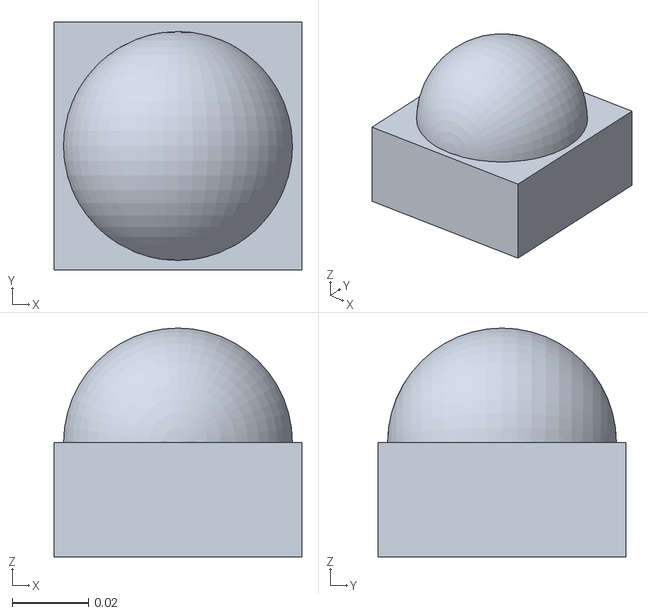
[picture p144: CAD file, 2025-12-09, last stored version]
Solidworks/Mockup/agv_urdf/meshes/lidar_link.STL
0.065 x 0.065 x 0.06
