effibot/thesis_latex/Solidworks/Mockup/castor/castor_staff.SLDPRT

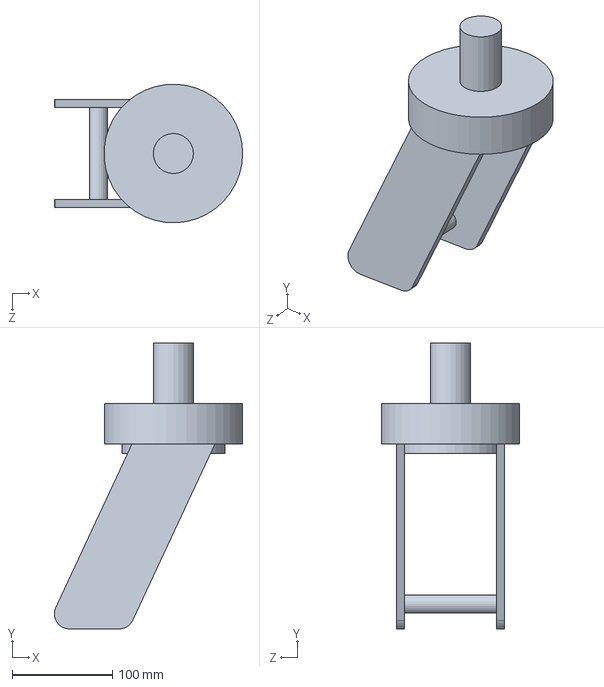
[picture p145: CAD file, 2025-12-09, last stored version]
Solidworks/Mockup/castor/castor_staff.SLDPRT
187.5 x 284.8 x 137.9 mm
