effibot/thesis_latex/Solidworks/Mockup/FRS240/steer_support.SLDPRT

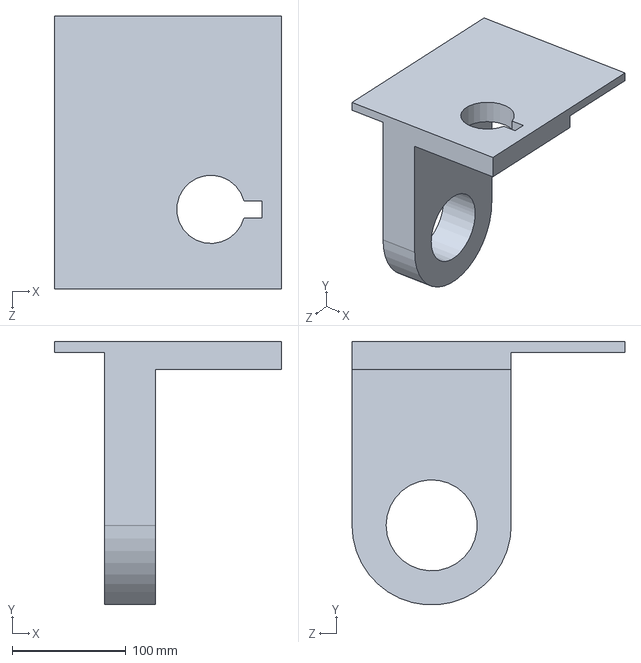
[picture p146: CAD file, 2025-12-09, last stored version]
Solidworks/Mockup/FRS240/steer_support.SLDPRT
200.0 x 231.6 x 240.0 mm
