effibot/thesis_latex/Solidworks/Motore/mockup/wheel2.SLDPRT

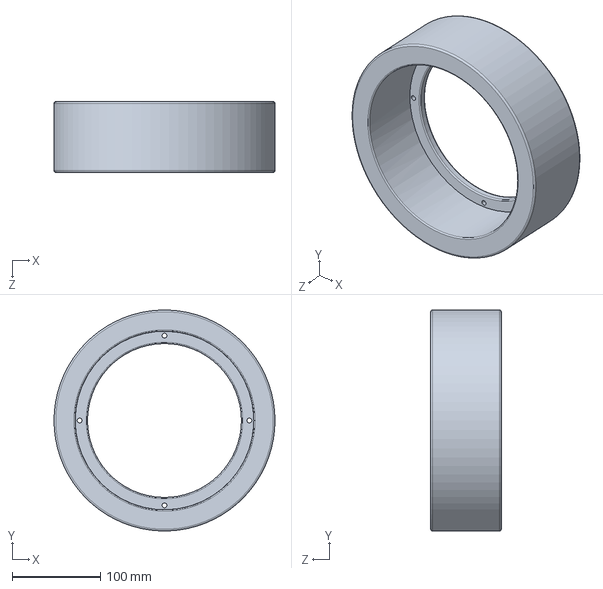
[picture p147: CAD file, 2025-12-09, last stored version]
Solidworks/Motore/mockup/wheel2.SLDPRT
250.0 x 249.8 x 80.0 mm
