effibot/thesis_latex/Solidworks/test_kart/lidar_plate_T.SLDPRT

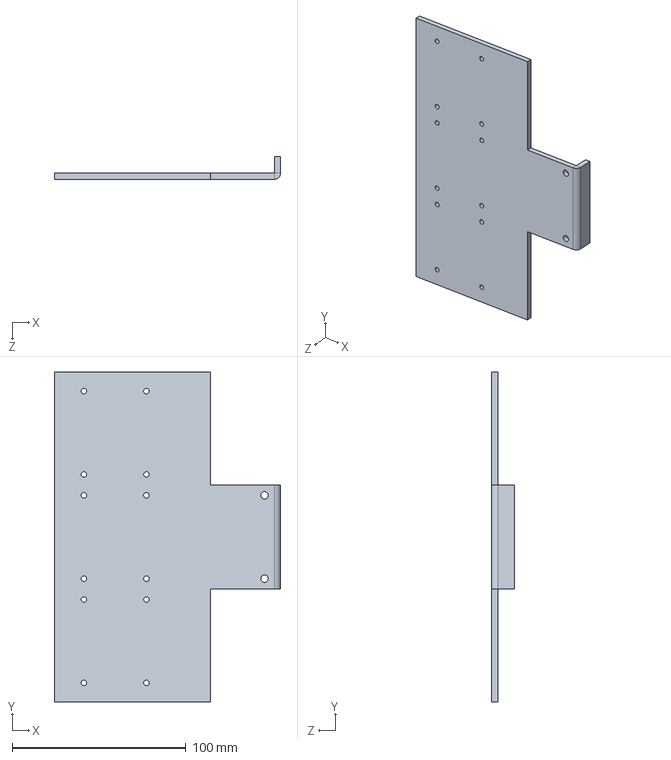
[picture p148: CAD file, 2025-12-09, last stored version]
Solidworks/test_kart/lidar_plate_T.SLDPRT
130.3 x 190.0 x 13.0 mm
