effibot/thesis_latex/Solidworks/wheels/Mould-on polyurethane wheels RE.F4-250-RSL.stp.SLDPRT

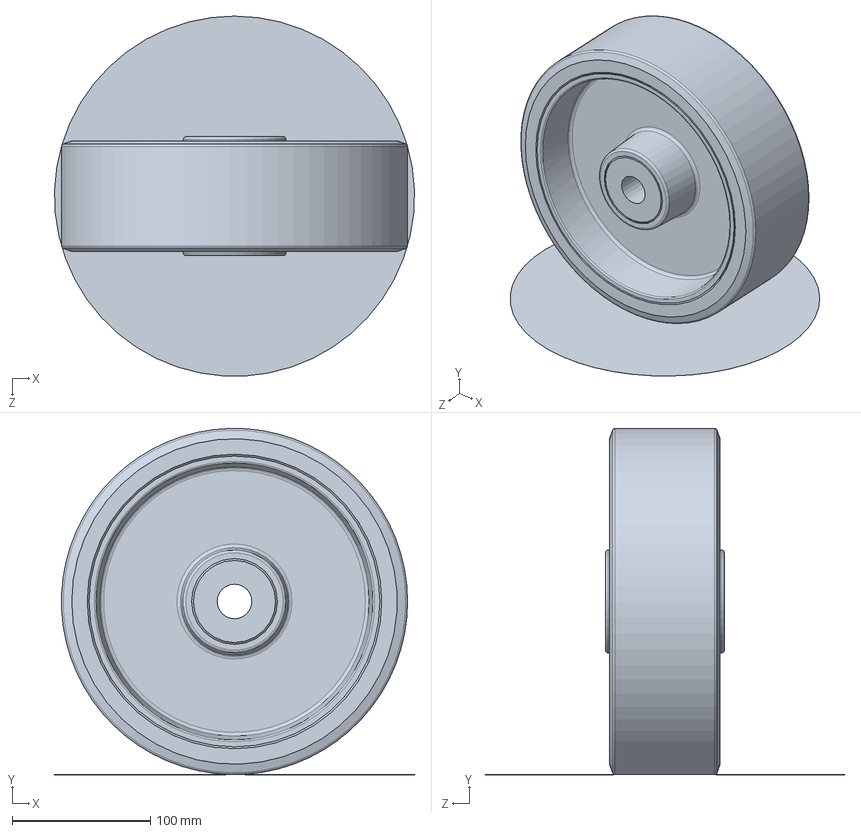
[picture p149: CAD file, 2025-12-09, last stored version]
Solidworks/wheels/Mould-on polyurethane wheels RE.F4-250-RSL.stp.SLDPRT
260.0 x 250.0 x 259.8 mm
