effibot/thesis_latex/Solidworks/Bosch Basics/Profilati/profilato_base.SLDPRT

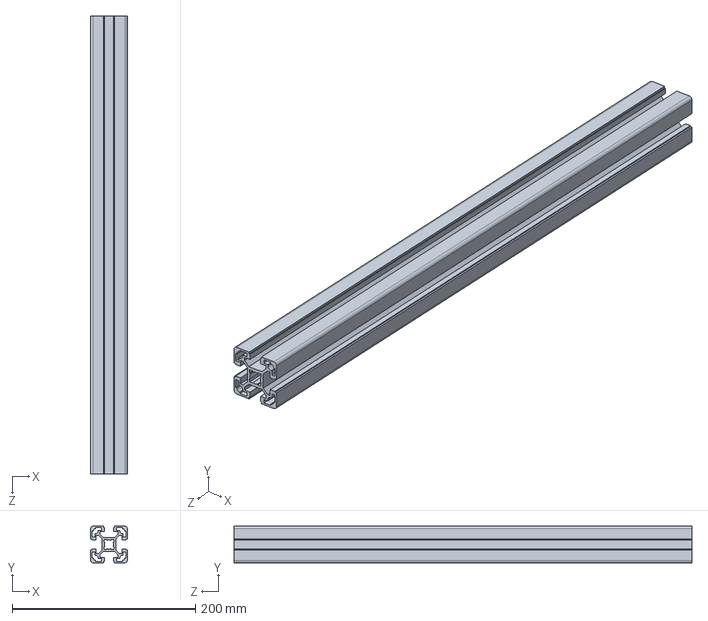
[picture p150: CAD file, 2025-12-09, last stored version]
Solidworks/Bosch Basics/Profilati/profilato_base.SLDPRT
40.0 x 40.0 x 500.0 mm
