effibot/thesis_latex/Solidworks/Mockup/agv_urdf/meshes/castor_b_link.STL

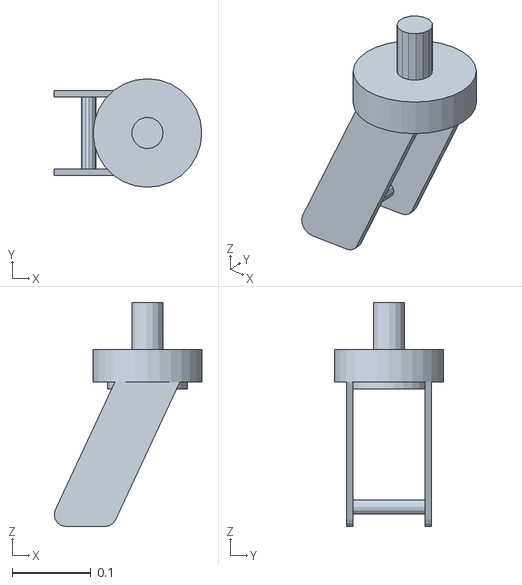
[picture p151: CAD file, 2025-12-09, last stored version]
Solidworks/Mockup/agv_urdf/meshes/castor_b_link.STL
0.188 x 0.138 x 0.285
