effibot/thesis_latex/Solidworks/Mockup/FRS240/motorwheel_base.SLDPRT

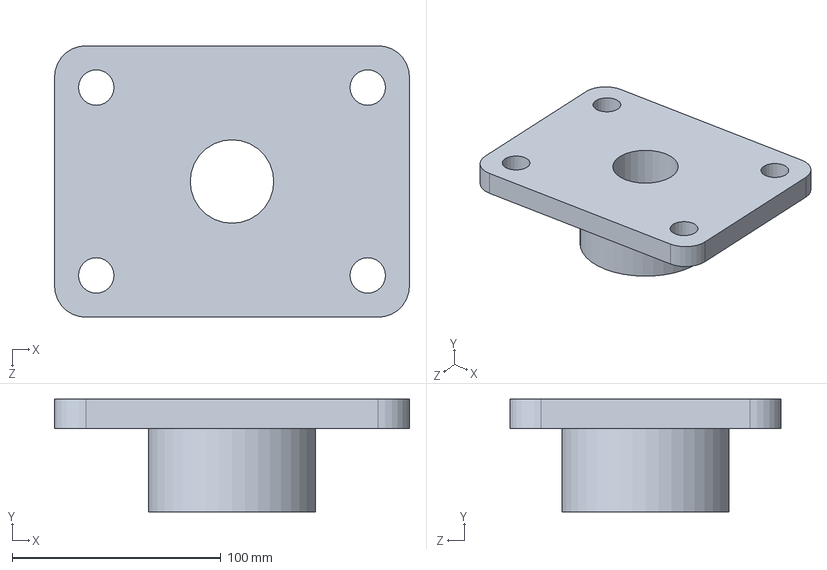
[picture p152: CAD file, 2025-12-09, last stored version]
Solidworks/Mockup/FRS240/motorwheel_base.SLDPRT
170.0 x 54.0 x 130.0 mm
