effibot/thesis_latex/Solidworks/test_kart/battery_mockup.SLDPRT

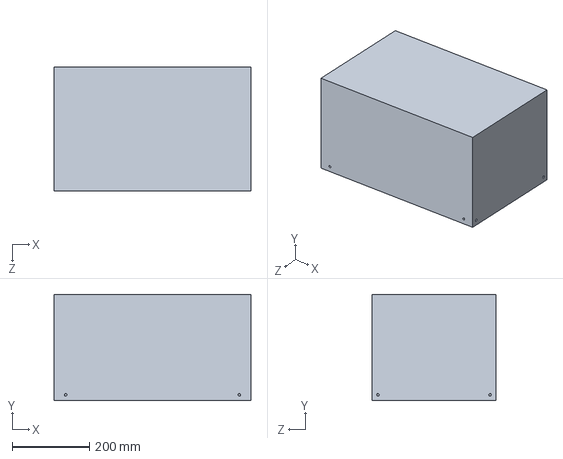
[picture p153: CAD file, 2025-12-09, last stored version]
Solidworks/test_kart/battery_mockup.SLDPRT
510.0 x 275.0 x 320.0 mm
