effibot/thesis_latex/Solidworks/Bosch Basics/Profilati/profilato_1920.SLDPRT

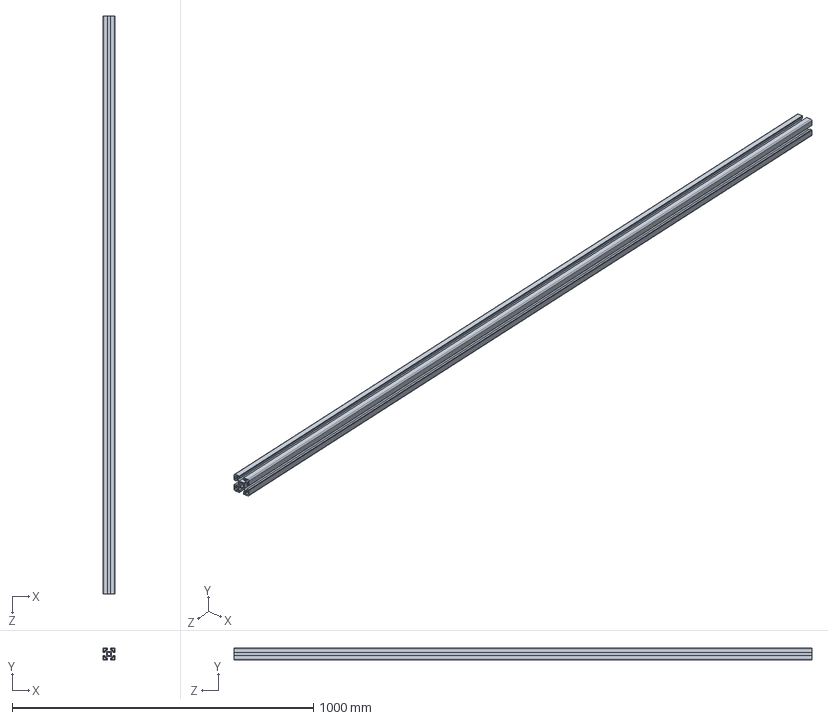
[picture p154: CAD file, 2025-12-09, last stored version]
Solidworks/Bosch Basics/Profilati/profilato_1920.SLDPRT
40.0 x 40.0 x 1920.0 mm
