effibot/thesis_latex/Solidworks/Final Version/Parte13.SLDPRT

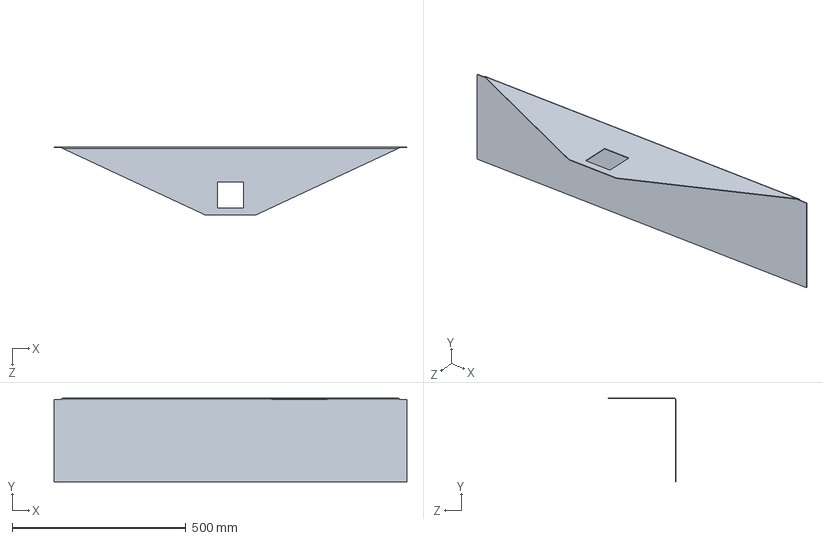
[picture p155: CAD file, 2025-12-09, last stored version]
Solidworks/Final Version/Parte13.SLDPRT
1015.0 x 241.5 x 195.0 mm
