effibot/thesis_latex/Solidworks/Motore/mockup/supporto_sterzo.SLDPRT

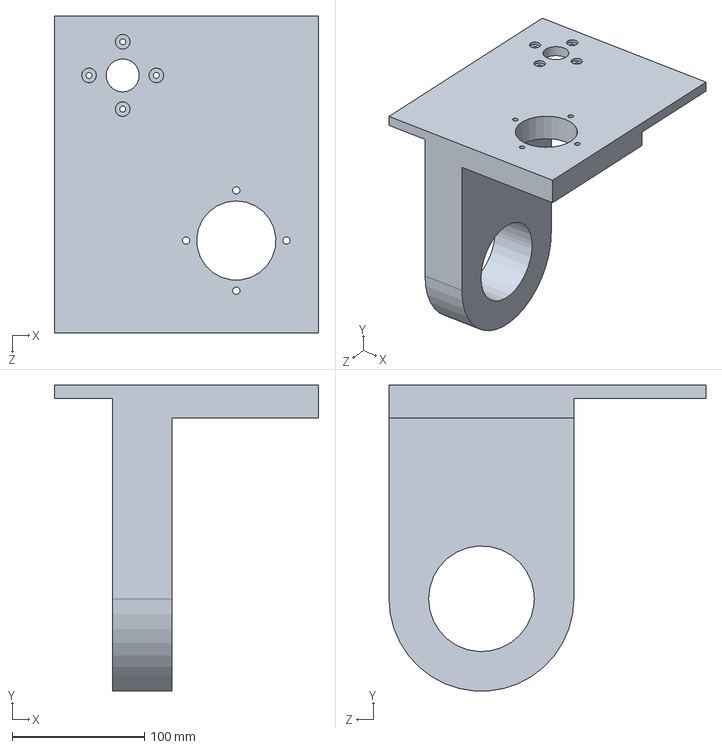
[picture p156: CAD file, 2025-12-09, last stored version]
Solidworks/Motore/mockup/supporto_sterzo.SLDPRT
200.0 x 231.6 x 240.0 mm
