effibot/thesis_latex/kart_urdf/meshes/pivot_br_link.STL

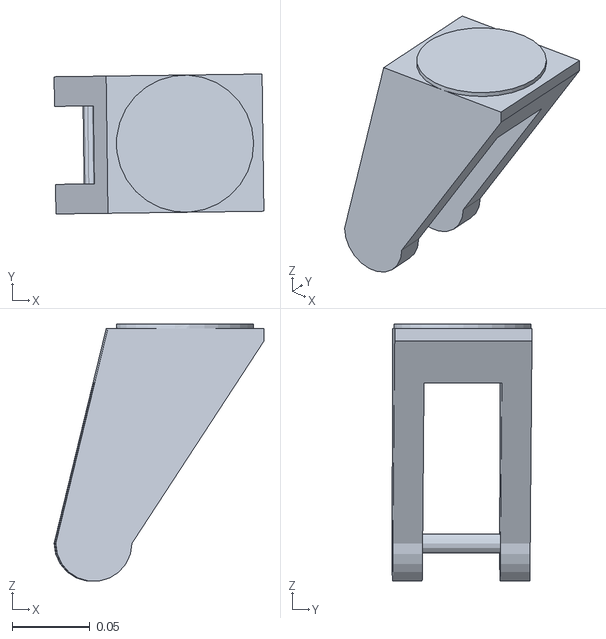
[picture p157: CAD file, 2025-12-09, last stored version]
kart_urdf/meshes/pivot_br_link.STL
0.135 x 0.0898 x 0.165
