effibot/thesis_latex/Solidworks/Mockup/agv_urdf/meshes/base_link.STL

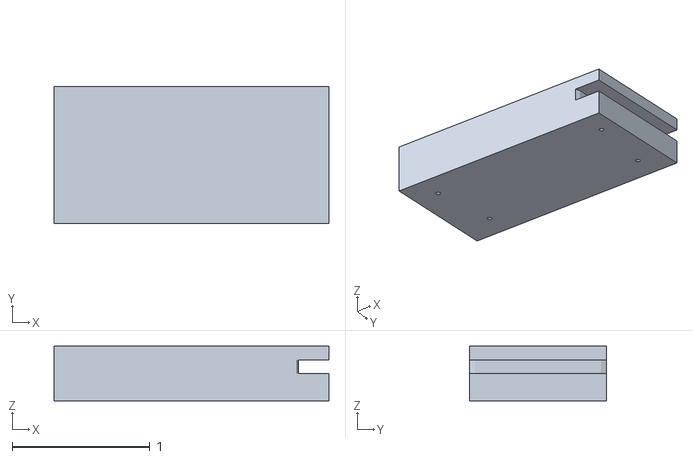
[picture p158: CAD file, 2025-12-09, last stored version]
Solidworks/Mockup/agv_urdf/meshes/base_link.STL
2.00 x 1.00 x 0.4
