effibot/thesis_latex/Solidworks/Mockup/FRS240/traction_motor.SLDPRT

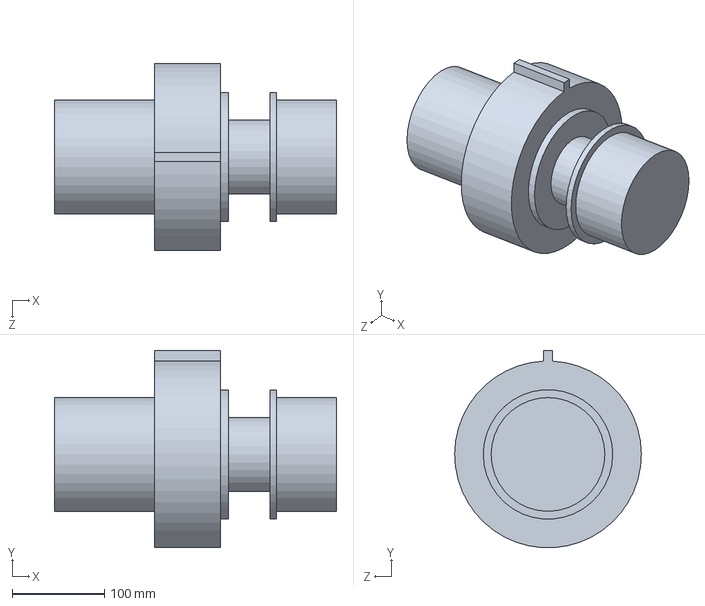
[picture p159: CAD file, 2025-12-09, last stored version]
Solidworks/Mockup/FRS240/traction_motor.SLDPRT
305.0 x 213.3 x 202.0 mm
