effibot/thesis_latex/Solidworks/test_kart/pivot.SLDPRT

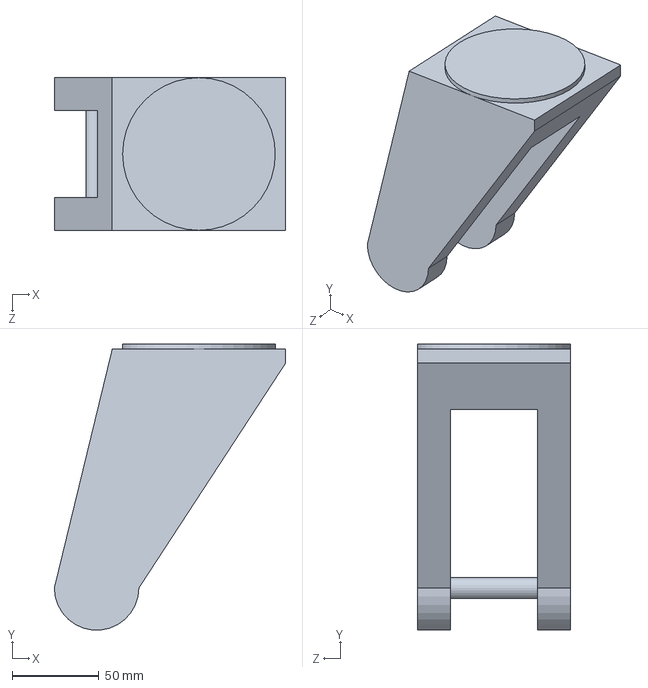
[picture p160: CAD file, 2025-12-09, last stored version]
Solidworks/test_kart/pivot.SLDPRT
133.4 x 164.9 x 88.0 mm
