effibot/thesis_latex/kart_urdf/meshes/base_link.STL

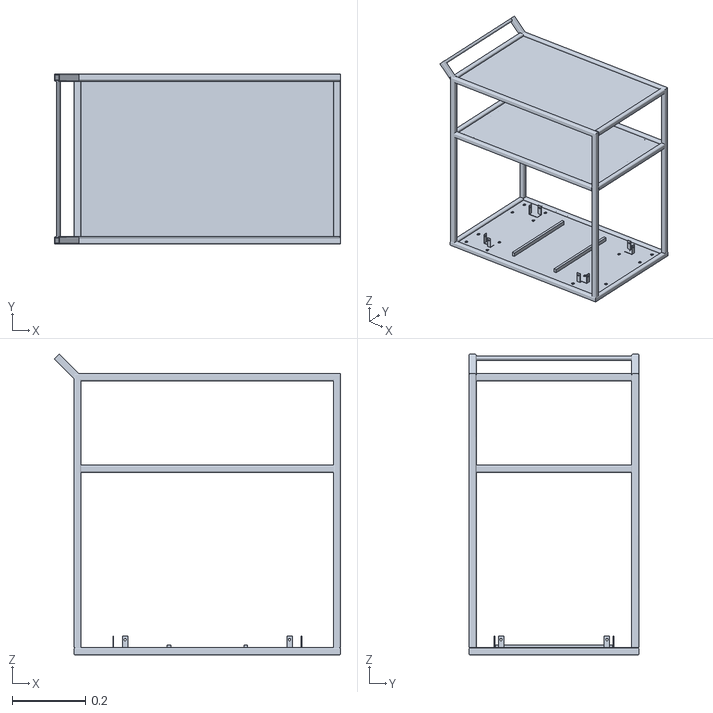
[picture p161: CAD file, 2025-12-09, last stored version]
kart_urdf/meshes/base_link.STL
0.784 x 0.465 x 0.824
