effibot/thesis_latex/Solidworks/Mockup/agv_urdf/meshes/traction_f_link.STL

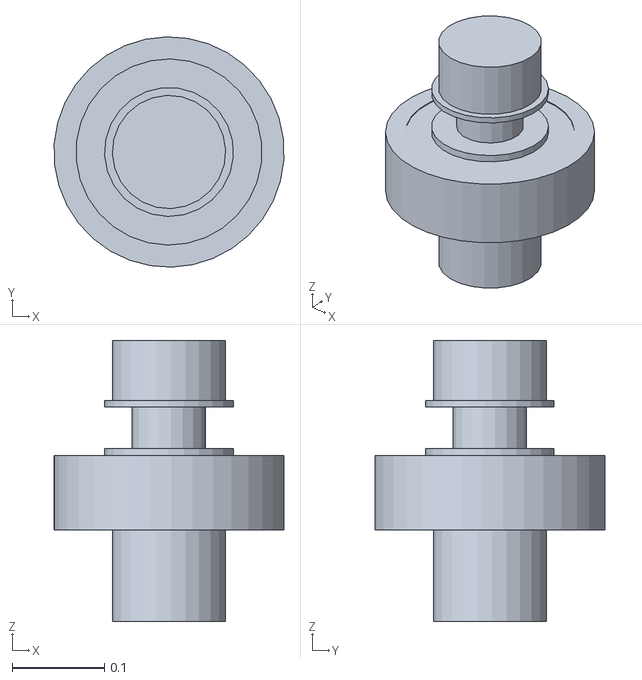
[picture p162: CAD file, 2025-12-09, last stored version]
Solidworks/Mockup/agv_urdf/meshes/traction_f_link.STL
0.249 x 0.25 x 0.305
