effibot/thesis_latex/Solidworks/test_kart/kart_skeleton.STEP

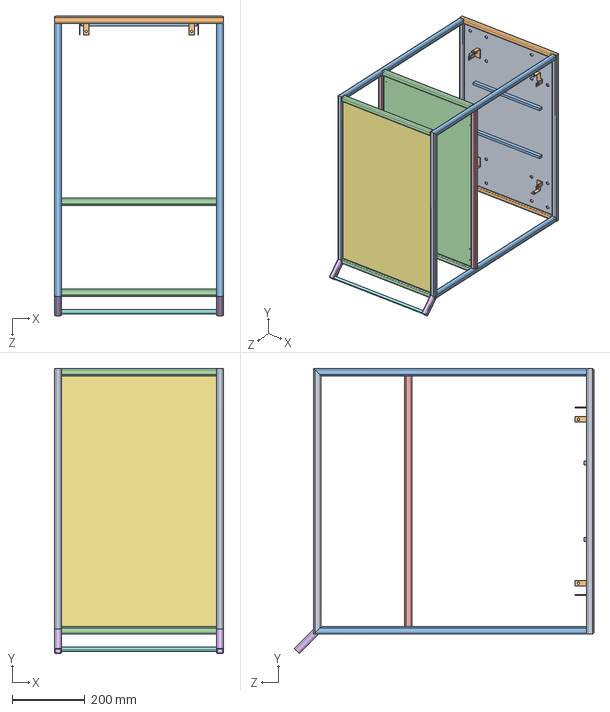
[picture p163: CAD file, 2025-12-09, last stored version]
Solidworks/test_kart/kart_skeleton.STEP
465.5 x 783.6 x 823.6 mm
