effibot/thesis_latex/Solidworks/wheels/freno.SLDPRT

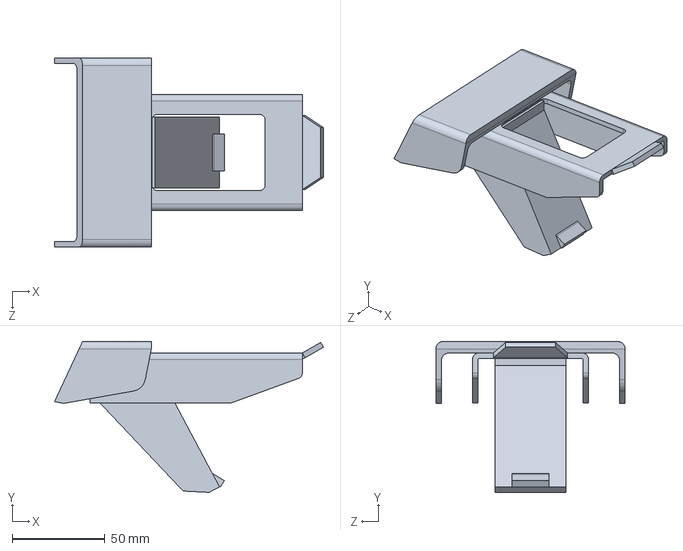
[picture p164: CAD file, 2025-12-09, last stored version]
Solidworks/wheels/freno.SLDPRT
144.8 x 81.4 x 102.0 mm
