effibot/thesis_latex/Solidworks/Final Version/batteria.SLDPRT

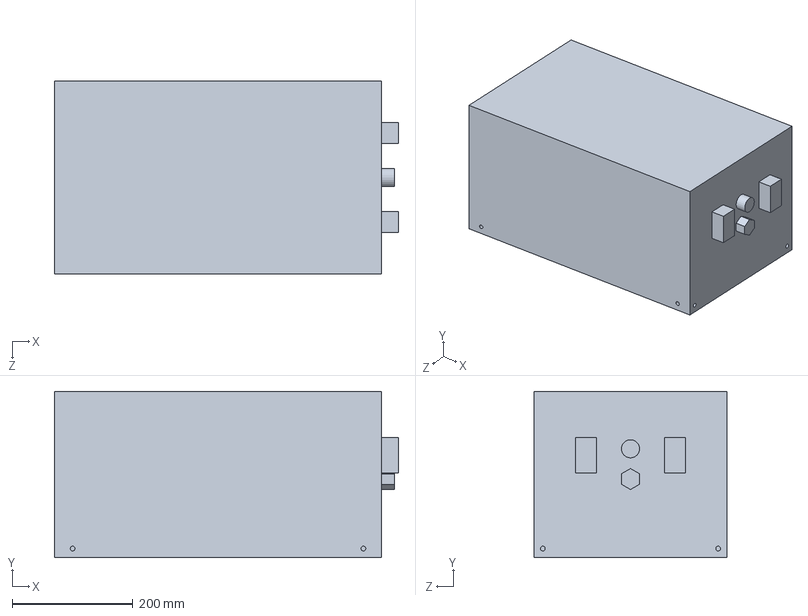
[picture p165: CAD file, 2025-12-09, last stored version]
Solidworks/Final Version/batteria.SLDPRT
569.0 x 275.0 x 320.0 mm
