effibot/thesis_latex/Solidworks/test_kart/kart_battery_staff.SLDPRT

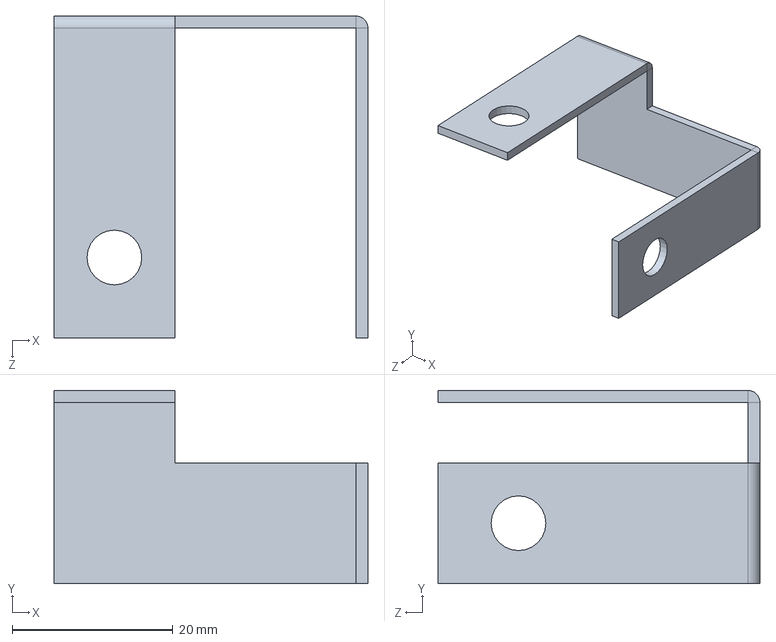
[picture p166: CAD file, 2025-12-09, last stored version]
Solidworks/test_kart/kart_battery_staff.SLDPRT
39.0 x 24.0 x 40.0 mm
