effibot/thesis_latex/Solidworks/Final Version/wheel_200.SLDPRT

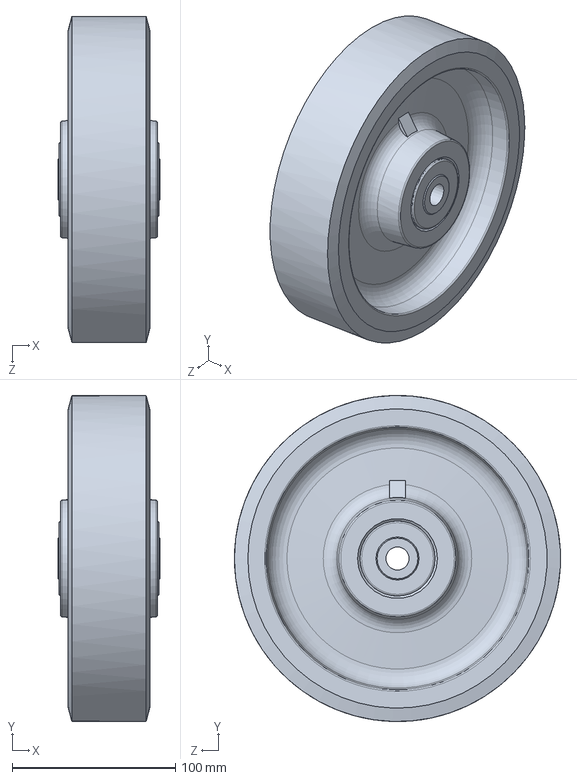
[picture p167: CAD file, 2025-12-09, last stored version]
Solidworks/Final Version/wheel_200.SLDPRT
62.5 x 199.9 x 200.0 mm
