effibot/thesis_latex/Solidworks/Mockup/FRS240/traction_motor_wheel.SLDPRT

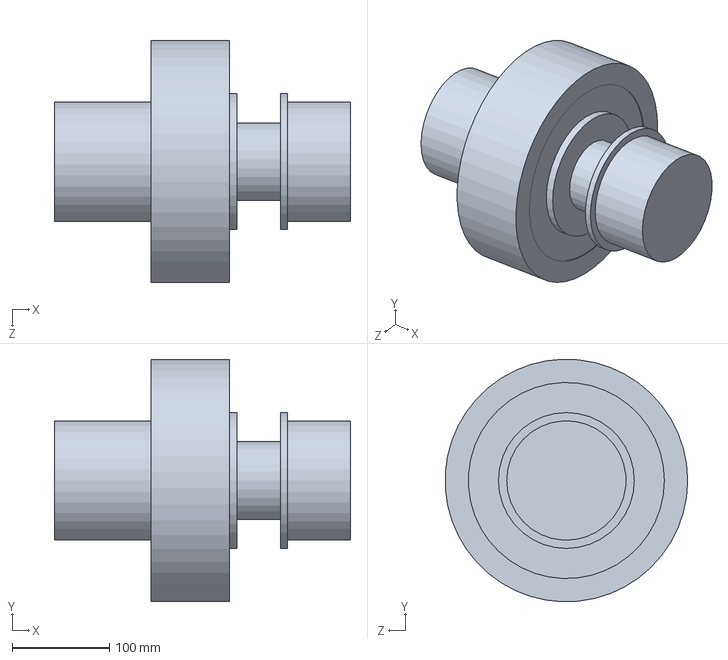
[picture p168: CAD file, 2025-12-09, last stored version]
Solidworks/Mockup/FRS240/traction_motor_wheel.SLDPRT
305.0 x 249.9 x 249.7 mm
