effibot/thesis_latex/kart_urdf/meshes/lidar_link.STL

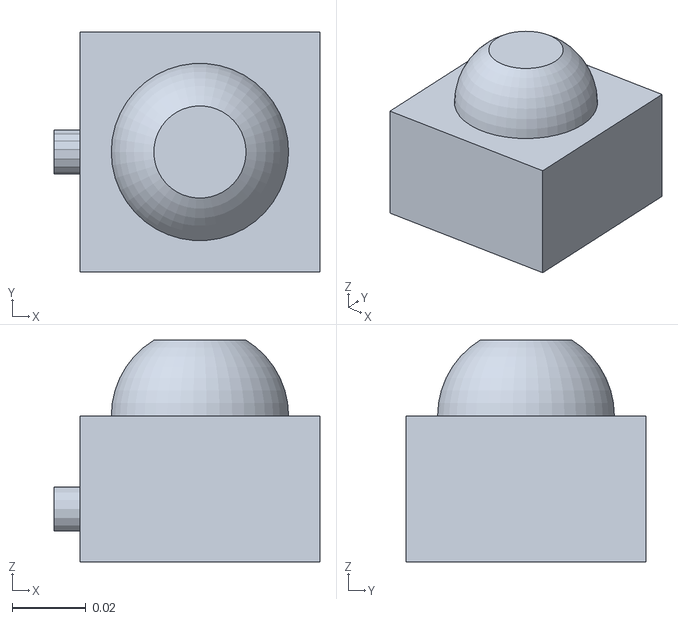
[picture p169: CAD file, 2025-12-09, last stored version]
kart_urdf/meshes/lidar_link.STL
0.072 x 0.065 x 0.06
