effibot/thesis_latex/Solidworks/Final Version/00-P-PT0153.SLDPRT

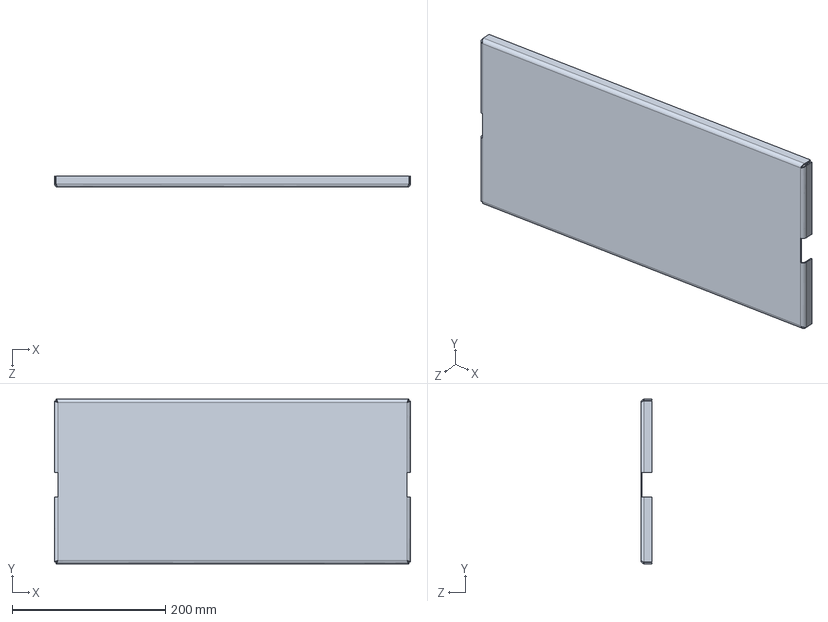
[picture p170: CAD file, 2025-12-09, last stored version]
Solidworks/Final Version/00-P-PT0153.SLDPRT
465.0 x 215.0 x 15.0 mm
