effibot/thesis_latex/Solidworks/Final Version/panda_mockup.SLDPRT

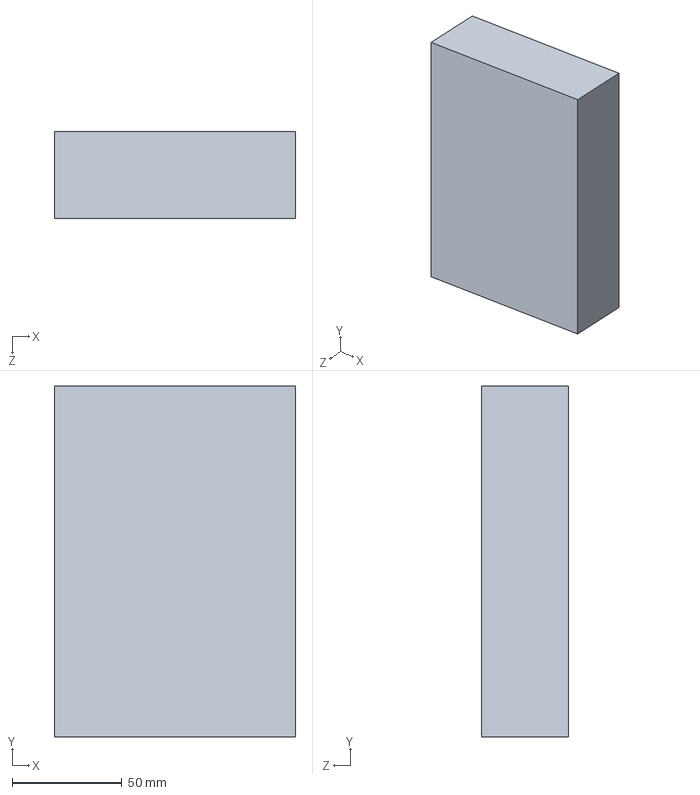
[picture p171: CAD file, 2025-12-09, last stored version]
Solidworks/Final Version/panda_mockup.SLDPRT
110.0 x 160.0 x 39.6 mm
