effibot/thesis_latex/Solidworks/Final Version/quadro_elettrico.SLDPRT

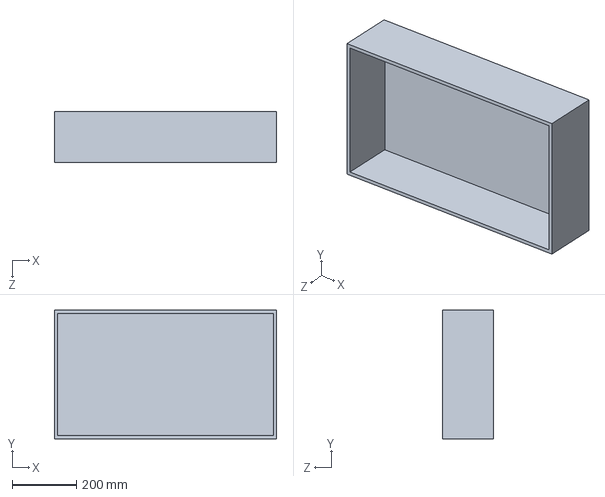
[picture p172: CAD file, 2025-12-09, last stored version]
Solidworks/Final Version/quadro_elettrico.SLDPRT
690.0 x 400.0 x 160.0 mm
