effibot/thesis_latex/Solidworks/Final Version/minitraction_power_mockup.SLDPRT

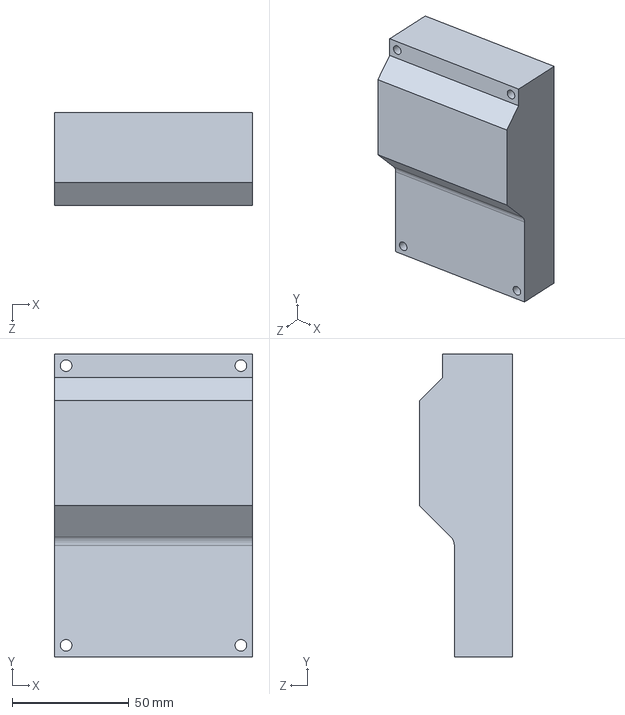
[picture p173: CAD file, 2025-12-09, last stored version]
Solidworks/Final Version/minitraction_power_mockup.SLDPRT
85.0 x 130.0 x 40.0 mm
