effibot/thesis_latex/Solidworks/Final Version/pivot.SLDPRT

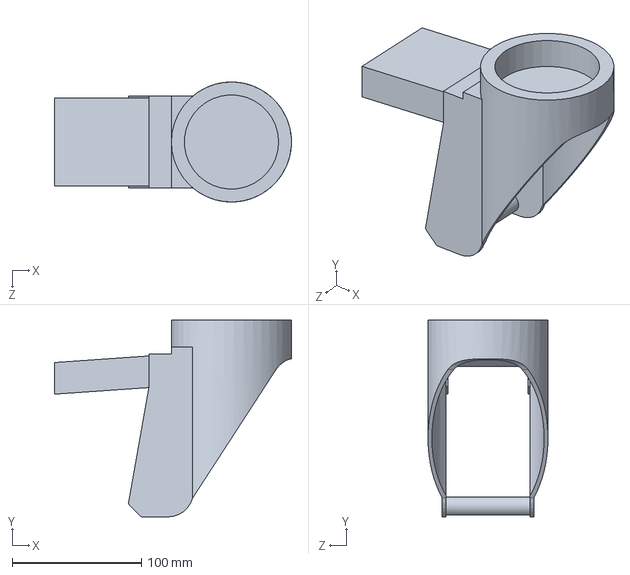
[picture p174: CAD file, 2025-12-09, last stored version]
Solidworks/Final Version/pivot.SLDPRT
183.6 x 152.5 x 92.9 mm
