effibot/thesis_latex/Solidworks/Final Version/00-P-PT0154-3.SLDPRT

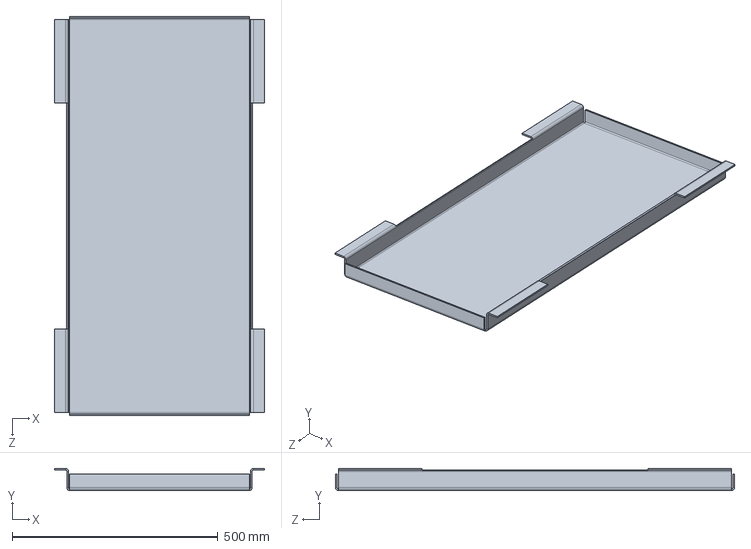
[picture p175: CAD file, 2025-12-09, last stored version]
Solidworks/Final Version/00-P-PT0154-3.SLDPRT
510.0 x 54.0 x 969.0 mm
