effibot/thesis_latex/Solidworks/Final Version/MRT05_wheel.SLDPRT

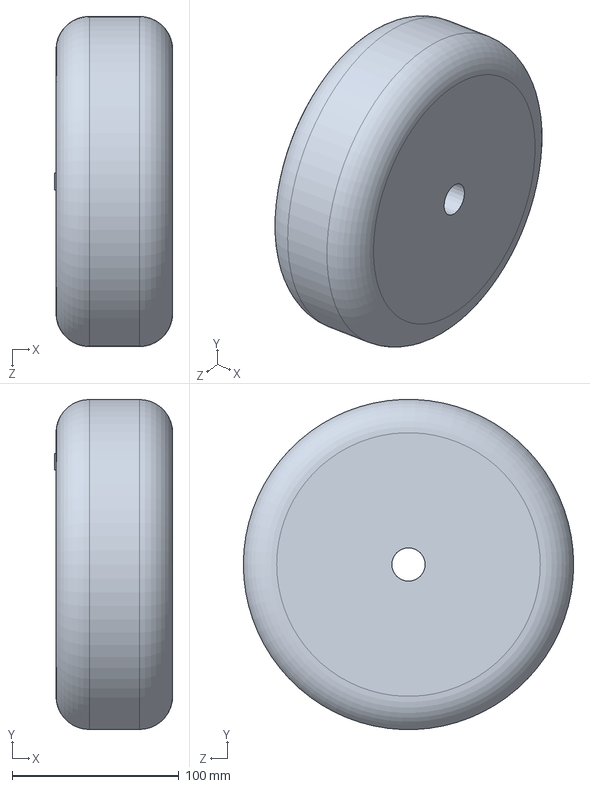
[picture p176: CAD file, 2025-12-09, last stored version]
Solidworks/Final Version/MRT05_wheel.SLDPRT
71.0 x 197.8 x 198.0 mm
