effibot/thesis_latex/Solidworks/Final Version/Parte17.SLDPRT

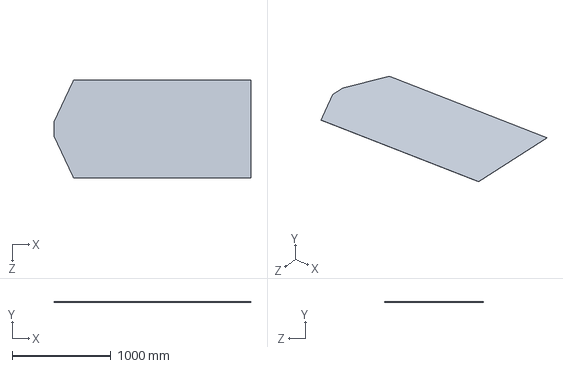
[picture p177: CAD file, 2025-12-09, last stored version]
Solidworks/Final Version/Parte17.SLDPRT
2000.0 x 1.50 x 1000.0 mm
