effibot/thesis_latex/Solidworks/Final Version/00-P-PT0151.SLDPRT

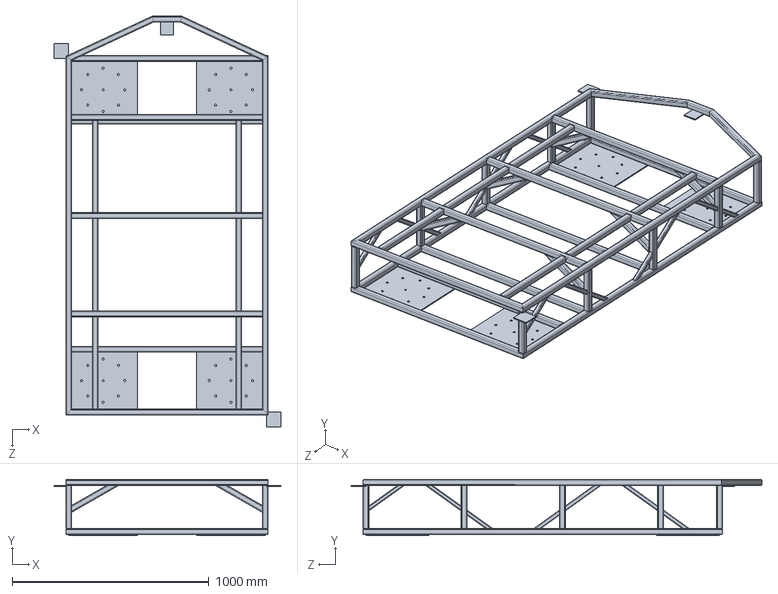
[picture p178: CAD file, 2025-12-09, last stored version]
Solidworks/Final Version/00-P-PT0151.SLDPRT
1155.0 x 285.0 x 2090.0 mm
