effibot/thesis_latex/Solidworks/Final Version/00-P-PT0154.SLDPRT

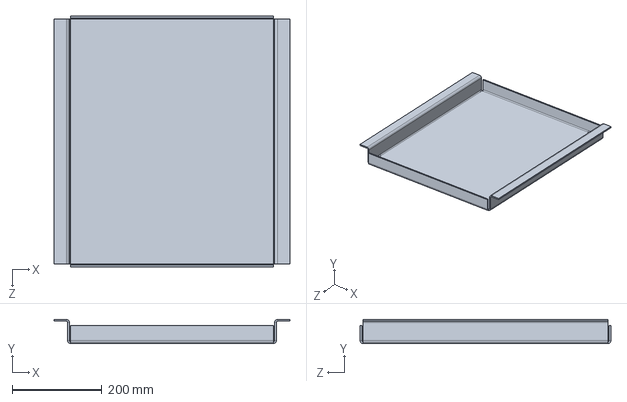
[picture p179: CAD file, 2025-12-09, last stored version]
Solidworks/Final Version/00-P-PT0154.SLDPRT
525.0 x 54.0 x 559.0 mm
