effibot/thesis_latex/Solidworks/Final Version/Parte14.SLDPRT

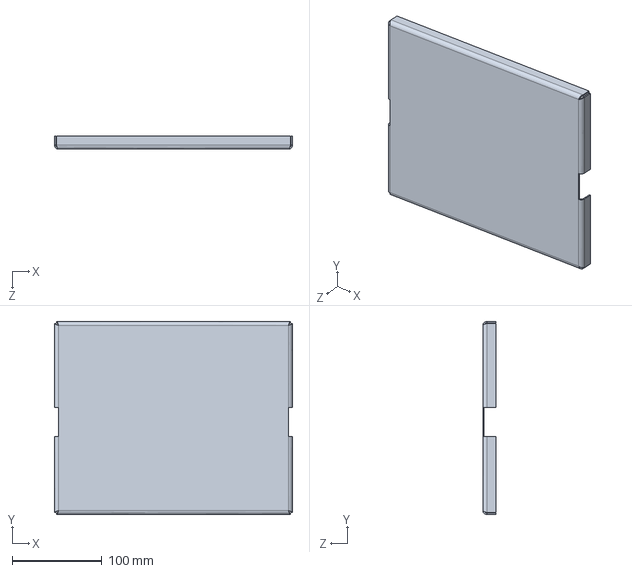
[picture p180: CAD file, 2025-12-09, last stored version]
Solidworks/Final Version/Parte14.SLDPRT
265.0 x 215.0 x 15.0 mm
