effibot/thesis_latex/Solidworks/Final Version/lidar.SLDPRT

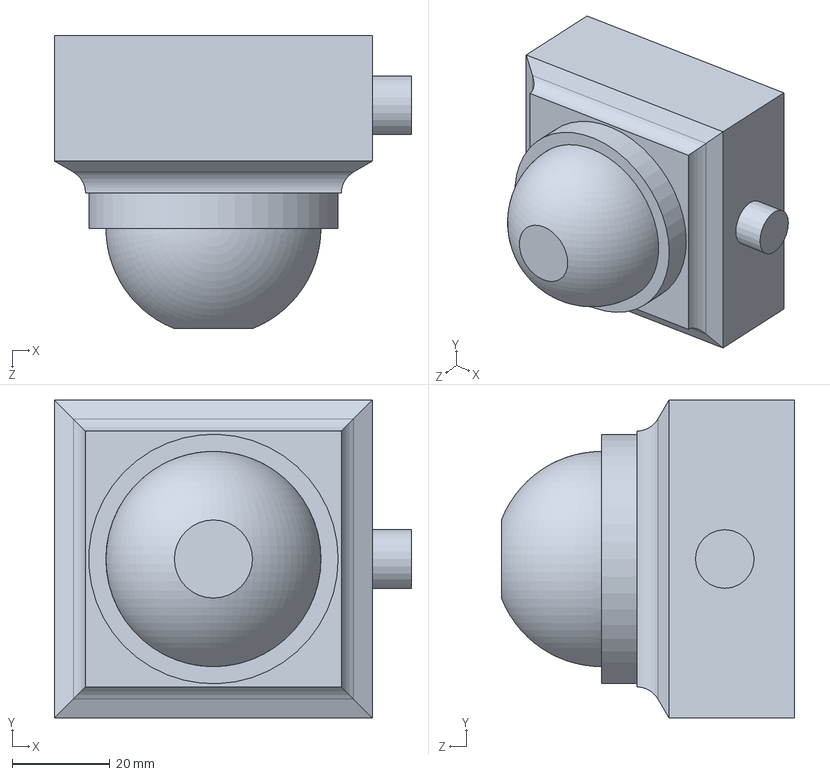
[picture p181: CAD file, 2025-12-09, last stored version]
Solidworks/Final Version/lidar.SLDPRT
73.0 x 65.0 x 60.0 mm
