effibot/thesis_latex/Solidworks/Final Version/piastra_pivot.SLDPRT

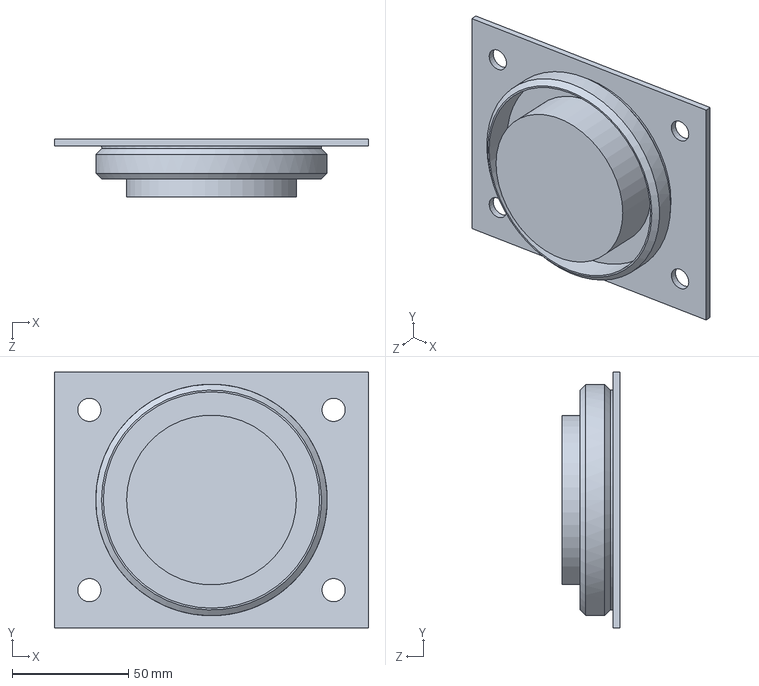
[picture p182: CAD file, 2025-12-09, last stored version]
Solidworks/Final Version/piastra_pivot.SLDPRT
135.0 x 110.0 x 24.8 mm
