effibot/thesis_latex/(list of files, cad)

Other CAD files:
Solidworks/Bosch Basics/Bracket/Assieme/Bracket_40_40_set.SLDASM
Solidworks/wheels/castor_250.SLDASM
Solidworks/LAG_19871FR.stp/disegni3d/LAG_19871FR.stp
Solidworks/wheels/re_f4_weh_20080-3-br.stp.SLDPRT
Solidworks/Bosch Basics/Profilati/profilato_1500.SLDPRT
Solidworks/Mockup/FRS240/steer_motor.SLDPRT
Solidworks/Mockup/v2/lamiera_ext_test.SLDPRT
Solidworks/Bosch Basics/Lamiere/lastra.SLDPRT
kart_urdf/meshes/plate_f_link.STL
kart_urdf/meshes/pivot_fl_link.STL
Solidworks/Mockup/agv_urdf/meshes/steer_b_link.STL
Solidworks/Mockup/FRS240/steer_fake_motor.SLDPRT
Solidworks/wheels/SRP_EE HD 250-80-200x160-b.stp.SLDPRT
Solidworks/Final Version/cuneo_pedana.SLDPRT
kart_urdf/meshes/pivot_bl_link.STL
Solidworks/Mockup/agv_urdf/meshes/traction_b_link.STL
Solidworks/Mockup/FRS240/wheel.SLDPRT
kart_urdf/meshes/wheel_fr_link.STL
kart_urdf/meshes/wheel_fl_link.STL
Solidworks/Final Version/AGV_no_piastre_superiori.DWG
kart_urdf/meshes/wheel_bl_link.STL
Solidworks/Final Version/LAG_19871FR.stp
Solidworks/Final Version/AGV_body.DWG
Solidworks/Bosch Basics/Dadi&Viti&Giunti/Assieme/cubic_joint_screws.SLDASM
Solidworks/Bosch Basics/Dadi&Viti&Giunti/Assieme/cubuc_joint_screws.SLDASM
Solidworks/Bosch Basics/Dadi&Viti&Giunti/CORE_SCREW_S12X30_T50.SLDPRT
Solidworks/Bosch Basics/Dadi&Viti&Giunti/FLANGE_NUT_M8.SLDPRT
Solidworks/Bosch Basics/Dadi&Viti&Giunti/T_BOLT.SLDPRT
Solidworks/Bosch Basics/Dadi&Viti&Giunti/T_BOLT_60.SLDPRT
Solidworks/Bosch Basics/Dadi&Viti&Giunti/T_BOLT_short.SLDPRT
Solidworks/Final Version/D001562-OB_pEDANA COMPRESSORE.SLDASM
Solidworks/Final Version/MRT05.SLDPRT
Solidworks/Mockup/castor/castor_wheel.SLDDRW
Solidworks/Motore/mockup/wheel.SLDDRW
Solidworks/test_kart/LAG_20017FR.SLDDRW
Solidworks/test_kart/kart_skeleton.SLDDRW
Solidworks/test_kart/kart_skeleton.SLDPRT
Solidworks/test_kart/lidar_plate_T.SLDDRW
Solidworks/wheels/Bolt M18-130(GREY).stp.SLDPRT
Solidworks/wheels/Bolt M18-130.SLDPRT
Solidworks/wheels/Bolt M18-130SLDPRT.SLDPRT
Solidworks/wheels/Nut M18(GREY).stp.SLDPRT
Solidworks/wheels/Nut M18.SLDPRT
Solidworks/wheels/Nut M18SLDPRT.SLDPRT
Solidworks/wheels/staffa.SLDDRW
