effibot/thesis_latex/build/beamer_template.pdf

### Progettazione e Realizzazione di un Veicolo da Trasporto Teleoperato in CANopen

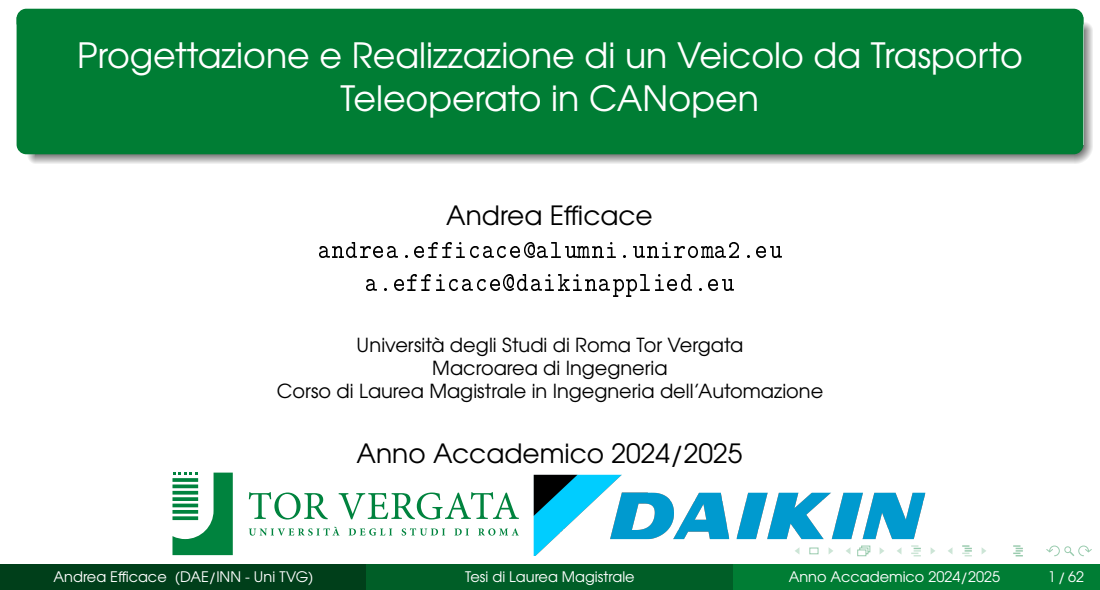
[picture p183: page 1]
Andrea Efficace; Anno Accademico 2024/2025; Andrea Efficace (DAE/INN - Uni TVG); Tesi di Laurea Magistrale

andrea.efficace@alumni.uniroma2.eu
a.efficace@daikinapplied.eu

Università degli Studi di Roma Tor Vergata

Macroarea di Ingegneria

Corso di Laurea Magistrale in Ingegneria dell’Automazione

### Roadmap

1 | Introduzione
2 | Stato dell’arte: robot mobili, navigazione e protocolli
3 | Requisiti e Componenti
4 | Modellazione Cinematica e Controllo
5 | Architettura Software e Comunicazione
6 | Conclusioni e Sviluppi Futuri
Andrea Efficace (DAE/INN - Uni TVG) | Tesi di Laurea Magistrale | Anno Accademico 2024/2025 | 2 / 62

### Roadmap

1 | Introduzione
2 | Stato dell’arte: robot mobili, navigazione e protocolli
3 | Requisiti e Componenti
4 | Modellazione Cinematica e Controllo
5 | Architettura Software e Comunicazione
6 | Conclusioni e Sviluppi Futuri
Andrea Efficace (DAE/INN - Uni TVG) | Tesi di Laurea Magistrale | Anno Accademico 2024/2025 | 3 / 62

### Contesto Aziendale: Daikin Applied Europe

Daikin Applied Europe (DAE):
- Sede di Ariccia (Roma).


Leader nel settore HVAC (Heating, Ventilation, Air Conditioning).

Produzione Make-to-Order:
- Unità Trattamento Aria (UTA) e Chiller.
- Prodotti personalizzati per il mercato europeo.

Driver: Crescente domanda per soluzioni in ambiti industriali rilevanti nel momento
storico attuale (es: datacenter).
Andrea Efficace (DAE/INN - Uni TVG) | Tesi di Laurea Magistrale | Anno Accademico 2024/2025 | 4 / 62

### Il Reparto Industrial Innovation

Obiettivo: Ottimizzazione dei processi produttivi verso l’Industria 5.0.

Progetti Chiave
MES (Manufacturing Execution System): Monitoraggio produzione in tempo reale.

Test-bench automatici: Collaudo sottoassiemi e prodotti finiti.

Visione Artificiale: Controllo qualità e ispezione.

Robotica Mobile: Integrazione robot per movimentazione materiali.

Andrea Efficace (DAE/INN - Uni TVG) | Tesi di Laurea Magistrale | Anno Accademico 2024/2025 | 5 / 62

### Motivazioni e Problematiche

Attualmente la movimentazione è manuale (muletti, carrelli), con costi elevati in termini di tempo e risorse.

Sfide della Produzione Make-to-Order
Percorsi Variabili: Destinazioni cambiano in base alle esigenze giornaliere.

Layout Dinamico: Disposizione spazi variabile per necessità logistiche.

Ostacoli Dinamici: Presenza costante di operatori e altri mezzi.

Andrea Efficace (DAE/INN - Uni TVG) | Tesi di Laurea Magistrale | Anno Accademico 2024/2025 | 6 / 62

### Obiettivo della Tesi

Progettazione e realizzazione di un Veicolo Autonomo (AMR) per lo stabilimento di Ariccia.
Dimostratore Tecnologico:
- Realizzazione di un prototipo a basso costo.
- Valutazione fattibilità in ambiente industriale reale, all’aperto e poco strutturato.

Transizione all’Automazione:
- Sostituzione movimentazione manuale.
- Integrazione futura con sistemi WMS (Warehouse Management System) ed ERP (Enterprise Resource Planning).
Andrea Efficace (DAE/INN - Uni TVG) | Tesi di Laurea Magistrale | Anno Accademico 2024/2025 | 7 / 62

### Roadmap

1 | Introduzione
2 | Stato dell’arte: robot mobili, navigazione e protocolli
3 | Requisiti e Componenti
4 | Modellazione Cinematica e Controllo
5 | Architettura Software e Comunicazione
6 | Conclusioni e Sviluppi Futuri
Andrea Efficace (DAE/INN - Uni TVG) | Tesi di Laurea Magistrale | Anno Accademico 2024/2025 | 8 / 62

### Classificazione dei Robot Mobili

AMR vs AGV
AGV: Percorsi fissi, infrastruttura dedicata, bassa flessibilità.

AMR: Navigazione autonoma, adattabilità, nessuna infrastruttura.

Tipologie di Locomozione
Ruote: Differential drive, omnidirezionali.

Cingoli: Terreni irregolari.

Zampe: Ambienti complessi.

Volanti: Droni/UAV.

Andrea Efficace (DAE/INN - Uni TVG) | Tesi di Laurea Magistrale | Anno Accademico 2024/2025 | 9 / 62

### Algoritmi di Navigazione

Path Planning (Globale)
A*: Ricerca ottima su griglia.

Dijkstra: Ricerca esaustiva.

RRT: Esplorazione probabilistica.

Obstacle Avoidance (Locale)
VFH: Istogramma polare ostacoli.

DWA: Ottimizzazione velocità (v, ω).

Potential Fields: Campi di forze.

Localizzazione
Tecniche per stimare la posizione del robot nell’ambiente. Odometry: Basata su encoder e IMU, soggetta a deriva.

Beaconing: Utilizzo di segnali esterni (es. RFID).

SLAM: Simultaneous Localization and Mapping.

Andrea Efficace (DAE/INN - Uni TVG) | Tesi di Laurea Magistrale | Anno Accademico 2024/2025 | 10 / 62

### SLAM: FAST-LIO 2

Problema: Stimare posa e mappa simultaneamente in assenza di GPS.

Perché FAST-LIO 2?
Algoritmo LiDAR-Inertial Odometry (LIO) allo stato dell’artea. Robustezza: Funziona in ambienti spogli (corridoi lunghi) grazie alla registrazione diretta (no feature extraction).

Efficienza: Struttura ikd-Tree per aggiornamento mappa veloce (> 100 Hz).

Accuratezza: Fusione sensoriale (tightly-coupled) LiDAR + IMU.

Testato: Già validato sul sensore acquistato (Livox Mid-360).

aXu et al. "FAST-LIO2: Fast Direct LiDAR-Inertial Odometry", 2022;

Andrea Efficace (DAE/INN - Uni TVG) | Tesi di Laurea Magistrale | Anno Accademico 2024/2025 | 11 / 62

### Protocolli di Comunicazione: CAN Bus

Controller Area Network (CAN): bus seriale multi-master per autoveicoli.

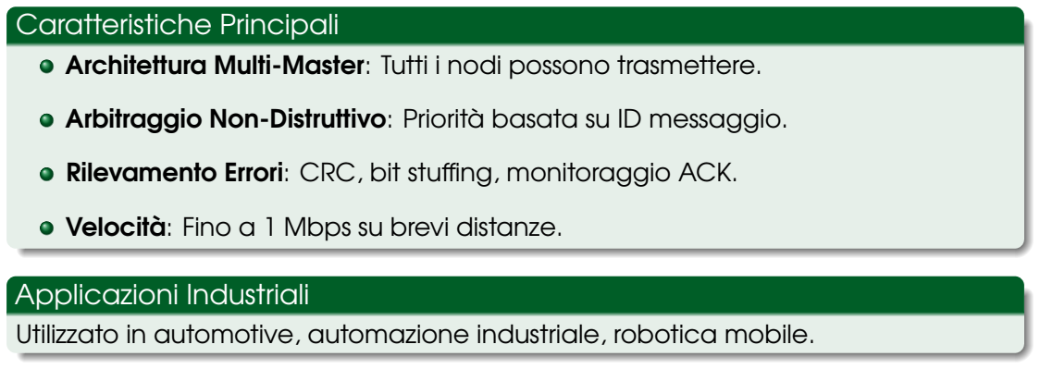
[picture p184: figure]
Caratteristiche Principali; Applicazioni Industriali

Architettura Multi-Master: Tutti i nodi possono trasmettere.

Arbitraggio Non-Distruttivo: Priorità basata su ID messaggio.

Rilevamento Errori: CRC, bit stuffing, monitoraggio ACK.

Velocità: Fino a 1 Mbps su brevi distanze.

Utilizzato in automotive, automazione industriale, robotica mobile.

Andrea Efficace (DAE/INN - Uni TVG) | Tesi di Laurea Magistrale | Anno Accademico 2024/2025 | 12 / 62

### Protocolli di Comunicazione: CANopen

CANopen: protocollo applicativo su CAN per automazione industriale. Componenti Principali
Object Dictionary (OD): dizionario
parametri dispositivo.

PDO: messaggi real-time (velocità, encoder).

SDO: configurazione parametri (client-server).

NMT: gestione stati nodi.

Estensione: Profilo CiA 402 Standard per azionamenti
elettrici

Macchina a stati

Modalità: Velocity, Position, Torque

Andrea Efficace (DAE/INN - Uni TVG) | Tesi di Laurea Magistrale | Anno Accademico 2024/2025 | 13 / 62

### Roadmap

1 | Introduzione
2 | Stato dell’arte: robot mobili, navigazione e protocolli
3 | Requisiti e Componenti
4 | Modellazione Cinematica e Controllo
5 | Architettura Software e Comunicazione
6 | Conclusioni e Sviluppi Futuri
Andrea Efficace (DAE/INN - Uni TVG) | Tesi di Laurea Magistrale | Anno Accademico 2024/2025 | 14 / 62

### Selezione Payload

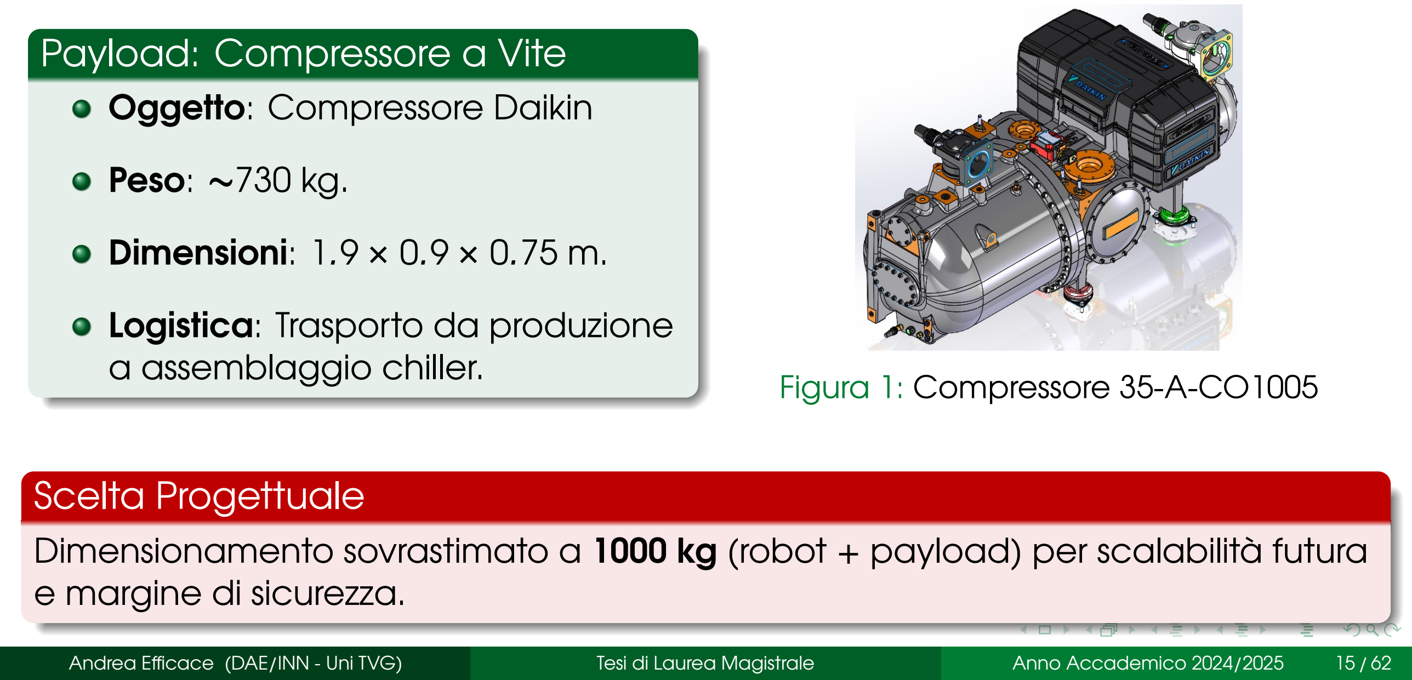
[picture p185: figure]
Payload: Compressore a Vite; Oggetto: Compressore Daikin; Peso: ∼730 kg.; Dimensioni: 1.9 × 0.9 × 0.75 m.; Logistica: Trasporto da produzione; a assemblaggio chiller.; Figura 1: Compressore 35-A-CO1005; Scelta Progettuale; e margine di sicurezza.

Dimensionamento sovrastimato a 1000 kg (robot + payload) per scalabilità futura

Andrea Efficace (DAE/INN - Uni TVG) | Tesi di Laurea Magistrale | Anno Accademico 2024/2025 | 15 / 62

### Requisiti Veicolo

Requisiti Veicolo
Capacità Carico: 1000 kg.

Velocità Max: 1 m/s (sicurezza).

Autonomia: 4 ore operative.

Ambiente: Indoor/Outdoor (asfalto, cemento).

Manovrabilità: Omnidirezionale (parcheggio parallelo).

Economico: Costo contenuto per dimostratore tecnologico.

Andrea Efficace (DAE/INN - Uni TVG) | Tesi di Laurea Magistrale | Anno Accademico 2024/2025 | 16 / 62

### Dimensionamento Potenza

Calcolo forza di trazione necessaria (m = 1000 kg, vmax = 1 m/s):
Parametri: μr = 0.03 (attrito volvente), μs = 0.5 (attrito statico), a = 0.333 m/s²

In Piano:

Fr = μr

- m · g = 294 N
Fa = m · a = 333 N
Ftot = 627 N

Ppiano ≈ 627 W

Pendenza 10% (θ = 5.7

◦
):

F∥ = mg sin θ = 974 N
Fr = μrmg cos θ = 293 N
Fa = 333 N
Ftot = 1600 N

Psalita ≈ 1.6 kW

Andrea Efficace (DAE/INN - Uni TVG) | Tesi di Laurea Magistrale | Anno Accademico 2024/2025 | 17 / 62

### Selezione Batteria

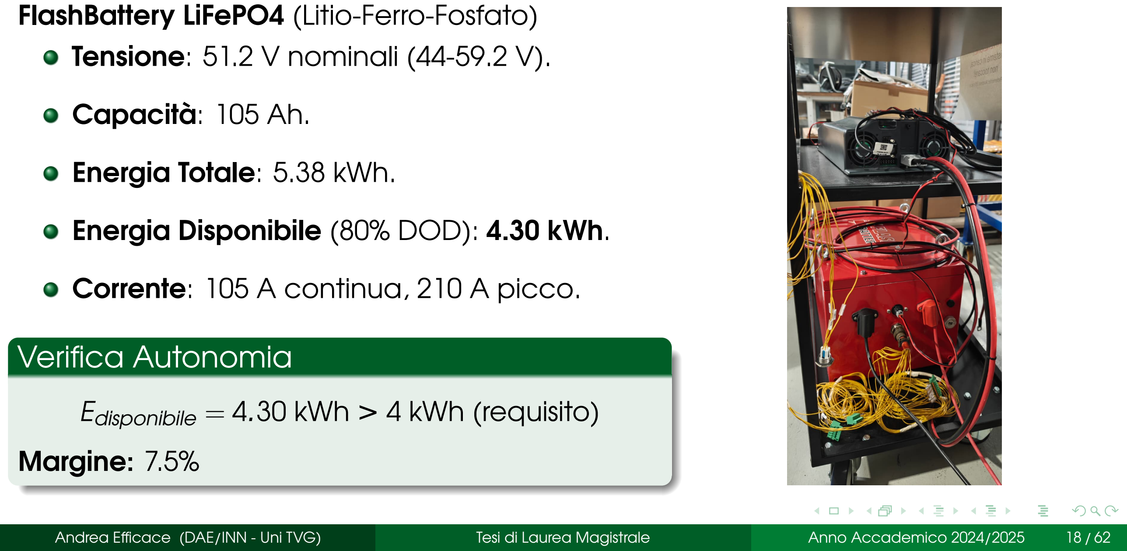
[picture p186: figure]
FlashBattery LiFePO4 (Litio-Ferro-Fosfato); Tensione: 51.2 V nominali (44-59.2 V).; Capacità: 105 Ah.; Energia Totale: 5.38 kWh.; Corrente: 105 A continua, 210 A picco.; Verifica Autonomia; Margine: 7.5%

Energia Disponibile (80% DOD): 4.30 kWh.

Edisponibile = 4.30 kWh > 4 kWh (requisito)

Andrea Efficace (DAE/INN - Uni TVG) | Tesi di Laurea Magistrale | Anno Accademico 2024/2025 | 18 / 62

### Selezione Motori: CFR MRT05

Configurazione: 2 Ruote Motrici Sterzanti (Motorwheels) + 2 Caster (diagonali). Specifiche per ruota:
Trazione:
- Potenza: 500 W (S2-60min)
- Coppia Nom.: 37 Nm
- Coppia Picco: 180 Nm
- Rapporto riduzione: 1:21

Sterzo:
- Potenza: 300 W
- Coppia: 34 Nm
- Rapporto riduzione: 1:45.56

Encoder: SIN/COS (FTS1)

Verifica Coppia

Raggio ruota: r = 0.099 m
Piano:
τtot = Ftot · r ≈ 62 Nm

τruota = τtot/2 ≈ 31 Nm

τnom = 37 Nm ⇒ Margine 18%

Salita 10%:
τtot ≈ 159 Nm

τruota ≈ 79.5 Nm

τpicco = 180 Nm ⇒ OK

Andrea Efficace (DAE/INN - Uni TVG) | Tesi di Laurea Magistrale | Anno Accademico 2024/2025 | 19 / 62

### Selezione Motori: CFR MRT05

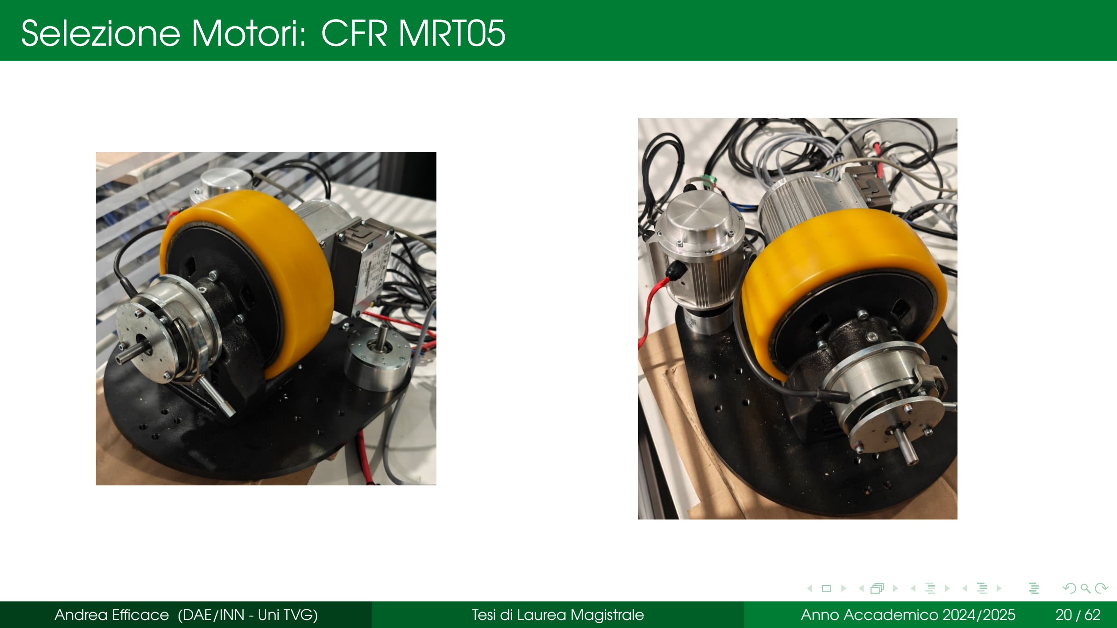
[picture p187: page 20]

Andrea Efficace (DAE/INN - Uni TVG) | Tesi di Laurea Magistrale | Anno Accademico 2024/2025 | 20 / 62

### Architettura Hardware: Computazione e Sensoristica

Computer di Bordo: LattePanda Sigma
- Intel Core i5-1340P (12 core, 16 thread)
- 32GB RAM LPDDR5-6400
- Ubuntu 24.04 + ROS 2 Jazzy

LiDAR: Livox Mid-360
- FOV: 360° × 59° (-7° a +52°)
- 200k pts/s, portata 70m
- IMU 6-assi integrata (ICM40609)

Encoder: SIN/COS (FTS1) integrati nelle motoruote

Sonde Temperatura: RTD (STS1) per monitoraggio termico motori

Andrea Efficace (DAE/INN - Uni TVG) | Tesi di Laurea Magistrale | Anno Accademico 2024/2025 | 21 / 62

### Architettura Hardware: Alimentazione e Controllo

Driver Motori: MicroPhase Mini-Traction Power (4×)
- Supporto CANopen CiA 402
- 48V, 75A continua, 120A boost (5s)
- Controllo motori PMAC

Comunicazione: Waveshare USB-CAN-A
- CAN 2.0A/B, velocità fino a 1 Mbps
- Resistenza terminazione 120Ω commutabile

Convertitori DC-DC: Meanwell
- SD-25B-12: 48V → 12V, 25W (LiDAR)
- SD-100D-12: 48V → 12V, 102W (SBC)

Caricabatterie: Zivan NG3
- 48V, 60A configurabile, profilo CC-CV per LiFePO4
- Comunicazione CAN con BMS, tempo ricarica: 2-3h
Andrea Efficace (DAE/INN - Uni TVG) | Tesi di Laurea Magistrale | Anno Accademico 2024/2025 | 22 / 62

### Componenti Hardware

LattePanda Sigma

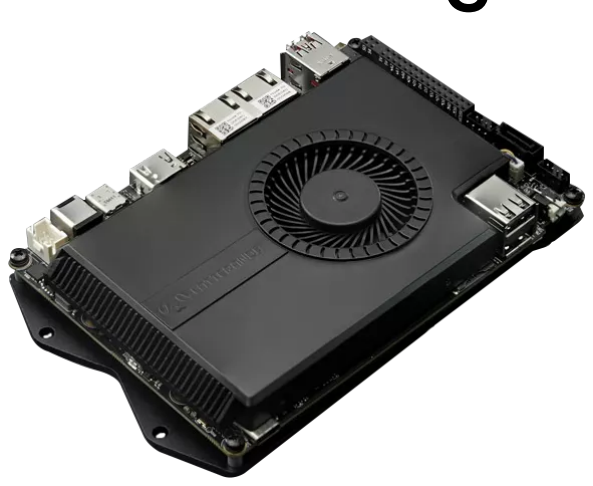
[picture p188: figure]

Driver Mini-Traction
Power

Livox Mid-360

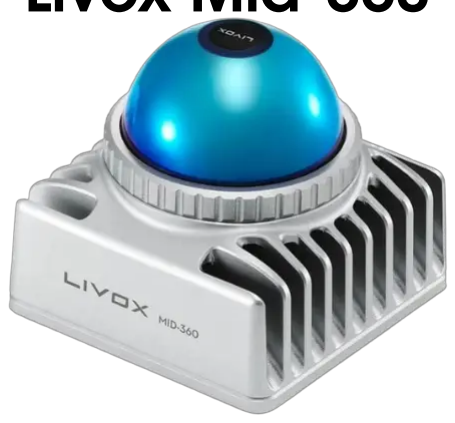
[picture p189: figure]

USB-CAN-A Adapter

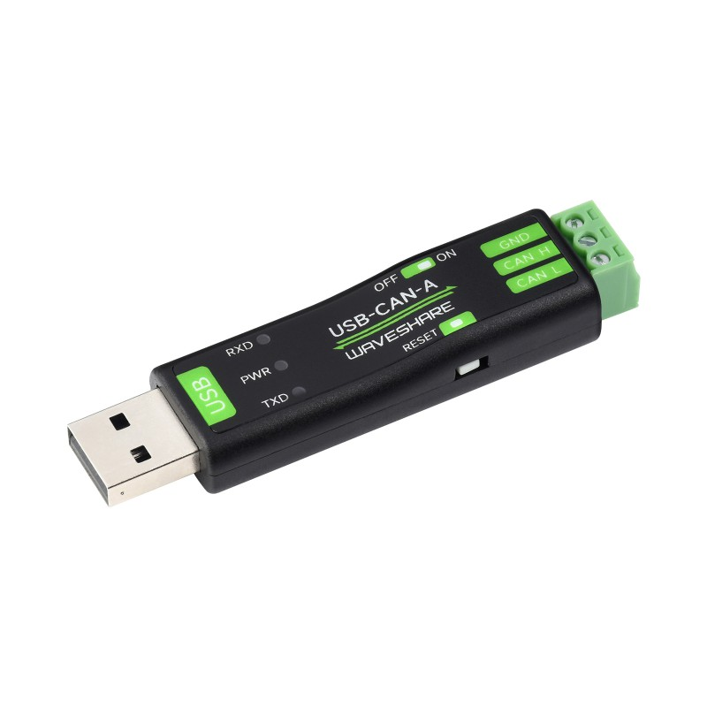
[picture p190: figure]
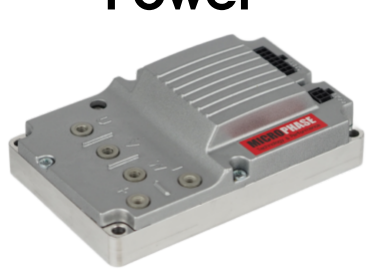
[picture p191: figure]

Andrea Efficace (DAE/INN - Uni TVG) | Tesi di Laurea Magistrale | Anno Accademico 2024/2025 | 23 / 62

### Telaio e Struttura Meccanica

Caratteristiche:
Massa: ∼70 kg


Profili acciaio 30 × 30 × 2.6 mm

Rinforzi 20 × 20 × 2 mm

Dimensioni: 1.8 × 1.0 m

Piastre montaggio 5 mm

Trattamento: zincatura

Progettazione:
CAD: SolidWorks

Analisi FEM: FASTRAN

Andrea Efficace (DAE/INN - Uni TVG) | Tesi di Laurea Magistrale | Anno Accademico 2024/2025 | 24 / 62

### Analisi agli Elementi Finiti (FEM)

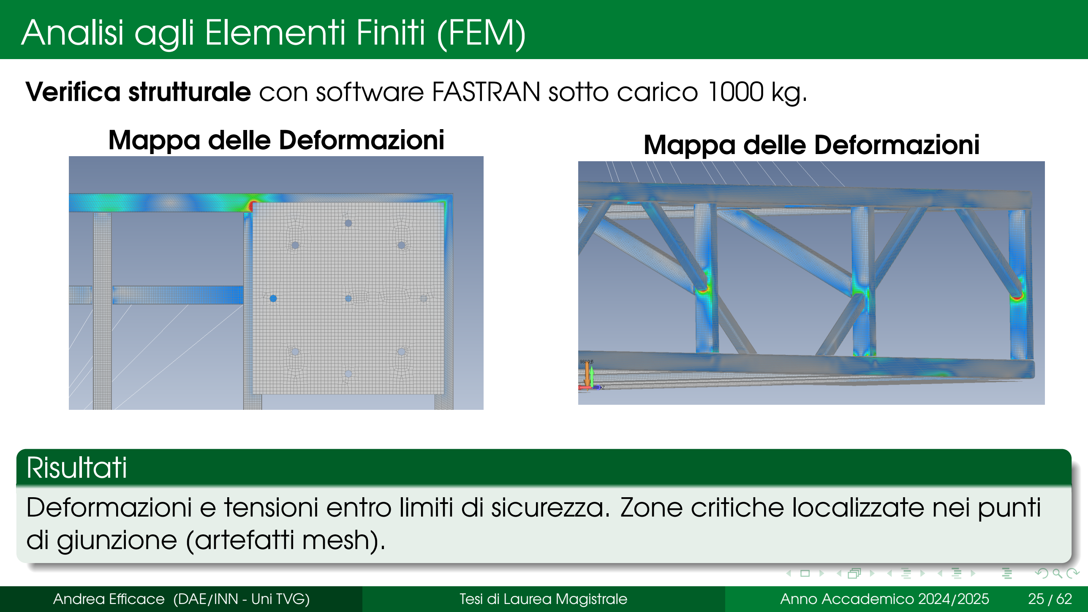
[picture p192: page 25]

Verifica strutturale con software FASTRAN sotto carico 1000 kg.

Mappa delle Deformazioni | Mappa delle Deformazioni

Risultati
Deformazioni e tensioni entro limiti di sicurezza. Zone critiche localizzate nei punti di giunzione (artefatti mesh).
Andrea Efficace (DAE/INN - Uni TVG) | Tesi di Laurea Magistrale | Anno Accademico 2024/2025 | 25 / 62

### Analisi dei Costi

Componente | Costo (€)
Motoruote CFR MRT05 (2×) | 5.480
Driver Mini-Traction Power (4×) | 1.640
Batteria FlashBattery | 3.950
Caricabatterie Zivan NG3 | 355
LattePanda Sigma | 563
Livox Mid-360 | 659
Telaio, lamierati e caster | 2.356
Cablaggi e messa in opera | 1.800
Accessori (DC-DC, USB-CAN, SSD) | 429
Totale | 17.232

Costo contenuto rispetto a soluzioni commerciali (ordine di grandezza inferiore). Dimostratore tecnologico economico per validazione concetto.

Andrea Efficace (DAE/INN - Uni TVG) | Tesi di Laurea Magistrale | Anno Accademico 2024/2025 | 26 / 62

### Roadmap

1 | Introduzione
2 | Stato dell’arte: robot mobili, navigazione e protocolli
3 | Requisiti e Componenti
4 | Modellazione Cinematica e Controllo
5 | Architettura Software e Comunicazione
6 | Conclusioni e Sviluppi Futuri
Andrea Efficace (DAE/INN - Uni TVG) | Tesi di Laurea Magistrale | Anno Accademico 2024/2025 | 27 / 62

### Modelli e Notazione Usata

Confrontati due modelli cinematici: Biciclo Sterzante: Preso dalla letteratura¹
. Approssima un veicolo con quattro ruote sterzanti.

Doppia Ruota Sterzante: proposta basata su vincoli non-olonomi, senza approssimazioni geometriche.

Stato: q =

x y θ

⊤
,

Dimensioni: L,W, L > W,

Posizioni delle Ruote:

p

b
f

=

L/2 W/2

⊤

p

b
r

= −

L/2 W/2

⊤

Input di Controllo:
u =
ωf | ωr | δf | δr

⊤
,

Velocità Angolare Ruote: ωf , ωr

,

Angoli di Sterzo: δf
, δr
,

Raggio Ruote: r.

1
Tourajizadeh et al., “Modeling and Optimal Control of 4 Wheel Steering Vehicle Using LQR”, 2020;
Andrea Efficace (DAE/INN - Uni TVG) | Tesi di Laurea Magistrale | Anno Accademico 2024/2025 | 28 / 62

### Ancora sulla notazione

Vel. Centro Robot (body frame): x˙

b
c

, y˙

b
c
Assunzione: simmetria geometrica
- Centro geometrico coincide con centro di massa
- Distanza tra centro e asse ruote: lf = lr = L/2 ⇒ lf + lr = L

Convenzioni: angoli positivi in senso antiorario
- θ zero quando asse longitudinale parallelo a asse x globale
- Sterzi zero quando ruote parallele all’asse longitudinale

Velocità angolari positive: rotazione in avanti (avanzamento)

Andrea Efficace (DAE/INN - Uni TVG) | Tesi di Laurea Magistrale | Anno Accademico 2024/2025 | 29 / 62

### Modello a Biciclo Sterzante

Semplificazione: ruote sullo stesso asse → ruota virtuale unica per asse

Equazioni Cinematiche

x˙ = v cos(θ + β)
y˙ = v sin(θ + β)
θ˙ =

v cos(β)
lf +lr

(tan(δf) − tan(δr))

(1)

dove:

v =

r(ωf cos δf + ωr cos δr)

2 cos(β)

(2)

β = tan⁻¹

lf tan(δr) + lr tan(δf)

lf + lr

(side-slip)

(3)

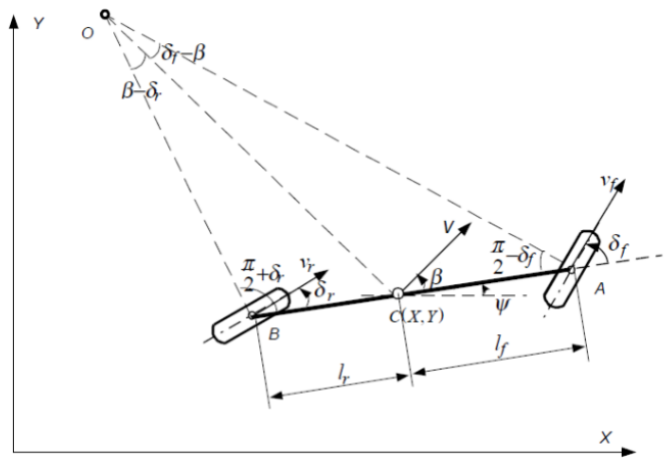
[picture p193: figure]

Figura 2: Modello a Biciclo Sterzante

Andrea Efficace (DAE/INN - Uni TVG) | Tesi di Laurea Magistrale | Anno Accademico 2024/2025 | 30 / 62

### Modello a Biciclo Sterzante: Osservazioni

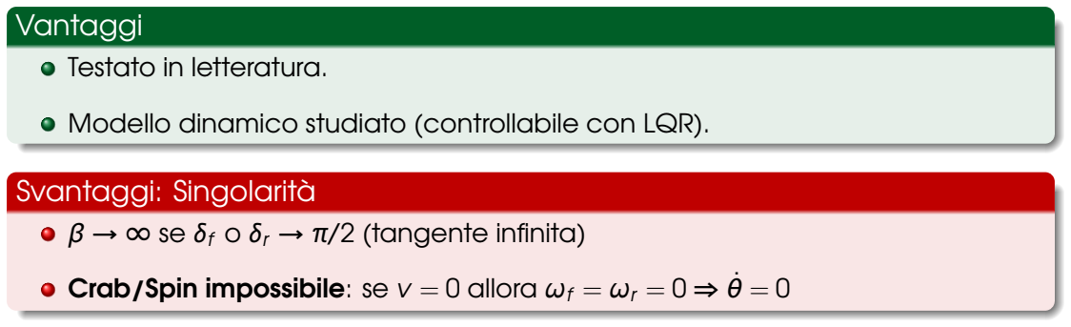
[picture p194: figure]
Vantaggi; Testato in letteratura.; Svantaggi: Singolarità

Modello dinamico studiato (controllabile con LQR).

β → ∞ se δf o δr → π/2 (tangente infinita)

Crab/Spin impossibile: se v = 0 allora ωf = ωr = 0 ⇒ θ˙ = 0

Andrea Efficace (DAE/INN - Uni TVG) | Tesi di Laurea Magistrale | Anno Accademico 2024/2025 | 31 / 62

### Modello a Doppia Ruota Sterzante

Soluzione finale nel body frame:

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
cos(δf) cos(δr)
sin(δf) sin(δr)
a13 | a23
ωf
ωr
(4)

dove i coefficienti a13, a23 dipendono da
δf

, δr
, L, W:

a13 =

2(L sin(δf) − W cos(δf))

L

2 + W²

(5)

a23 =

2(W cos(δr) − L sin(δr))

L

2 + W²


(6) Figura 3: Ruote motrici in verde, passive in viola.
Andrea Efficace (DAE/INN - Uni TVG) | Tesi di Laurea Magistrale | Anno Accademico 2024/2025 | 32 / 62

### Modello a Doppia Ruota Sterzante: Osservazioni

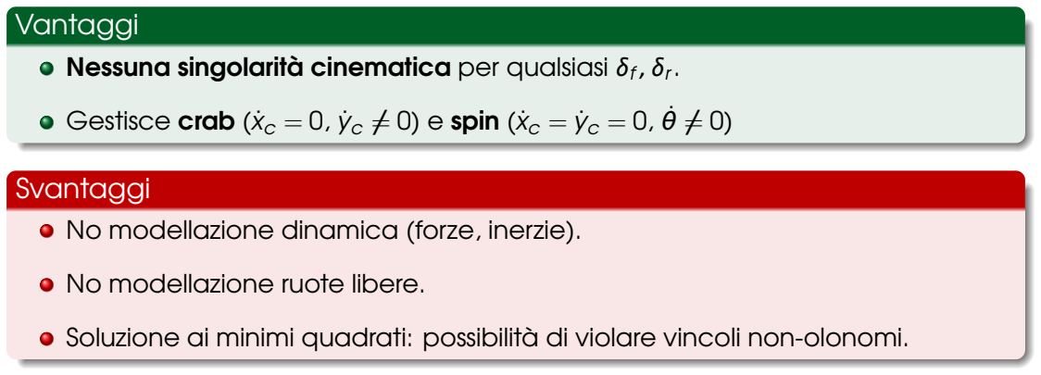
[picture p195: figure]
Vantaggi; Svantaggi; No modellazione dinamica (forze, inerzie).; No modellazione ruote libere.

Nessuna singolarità cinematica per qualsiasi δf, δr

Gestisce crab (x˙c = 0, y˙c ̸= 0) e spin (x˙c = y˙c = 0, θ˙ ̸= 0)

Soluzione ai minimi quadrati: possibilità di violare vincoli non-olonomi.

Andrea Efficace (DAE/INN - Uni TVG) | Tesi di Laurea Magistrale | Anno Accademico 2024/2025 | 33 / 62

### Setup Simulazioni

Parametri Robot e Attuatori
Dimensioni: L = 2 m, W = 1 m, d = 0.198 ⇒ r = 0.099 m

Dinamica attuatori: modello 1◦ ordine P(s) = K
τs+1
- Trazione: Kω = 1, τω = 1 s, ωmax = 10 rad/s
- Sterzo: Kδ = 1, τδ = 2 s, δmax = ±120◦

Traiettorie di Test
1 | Straight: linea retta verso Est (vref = 0.5 m/s, T = 5 s)
2 | Arc: arco circolare (R = 3 m, vref = 0.6 m/s, ω = 0.2 rad/s, T = 8 s)
3 | Crab: traslazione laterale Nord (vref = 0.4 m/s, T = 5 s)
4 | Spin: rotazione sul posto (ωref = π/6 rad/s, T = 6 s)

Metrica: RMSE posizione e orientamento vs. traiettoria desiderata

Andrea Efficace (DAE/INN - Uni TVG) | Tesi di Laurea Magistrale | Anno Accademico 2024/2025 | 34 / 62

### Schema di Controllo: Feedforward (Catena Aperta)

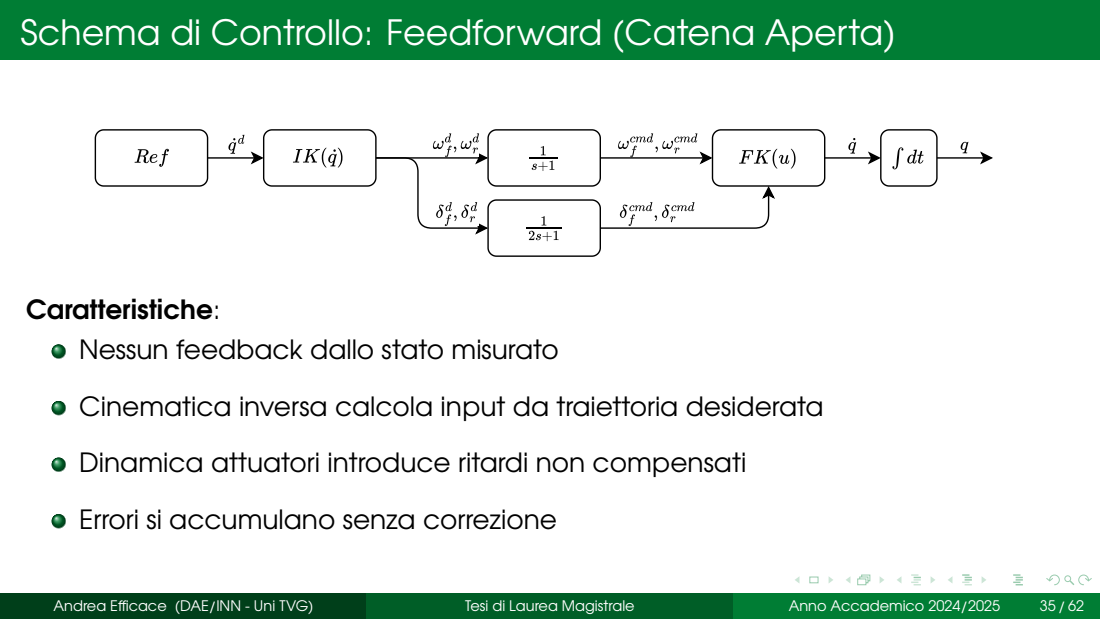
[picture p196: page 35]
Andrea Efficace (DAE/INN - Uni TVG); Tesi di Laurea Magistrale; Anno Accademico 2024/2025

Caratteristiche:
Nessun feedback dallo stato misurato

Cinematica inversa calcola input da traiettoria desiderata

Dinamica attuatori introduce ritardi non compensati

Errori si accumulano senza correzione

### Risultati Feedforward: Traiettoria Arc – Biciclo


Andrea Efficace (DAE/INN - Uni TVG) | Tesi di Laurea Magistrale | Anno Accademico 2024/2025 | 36 / 62

### Risultati Feedforward: Traiettoria Arc – Doppio Sterzo

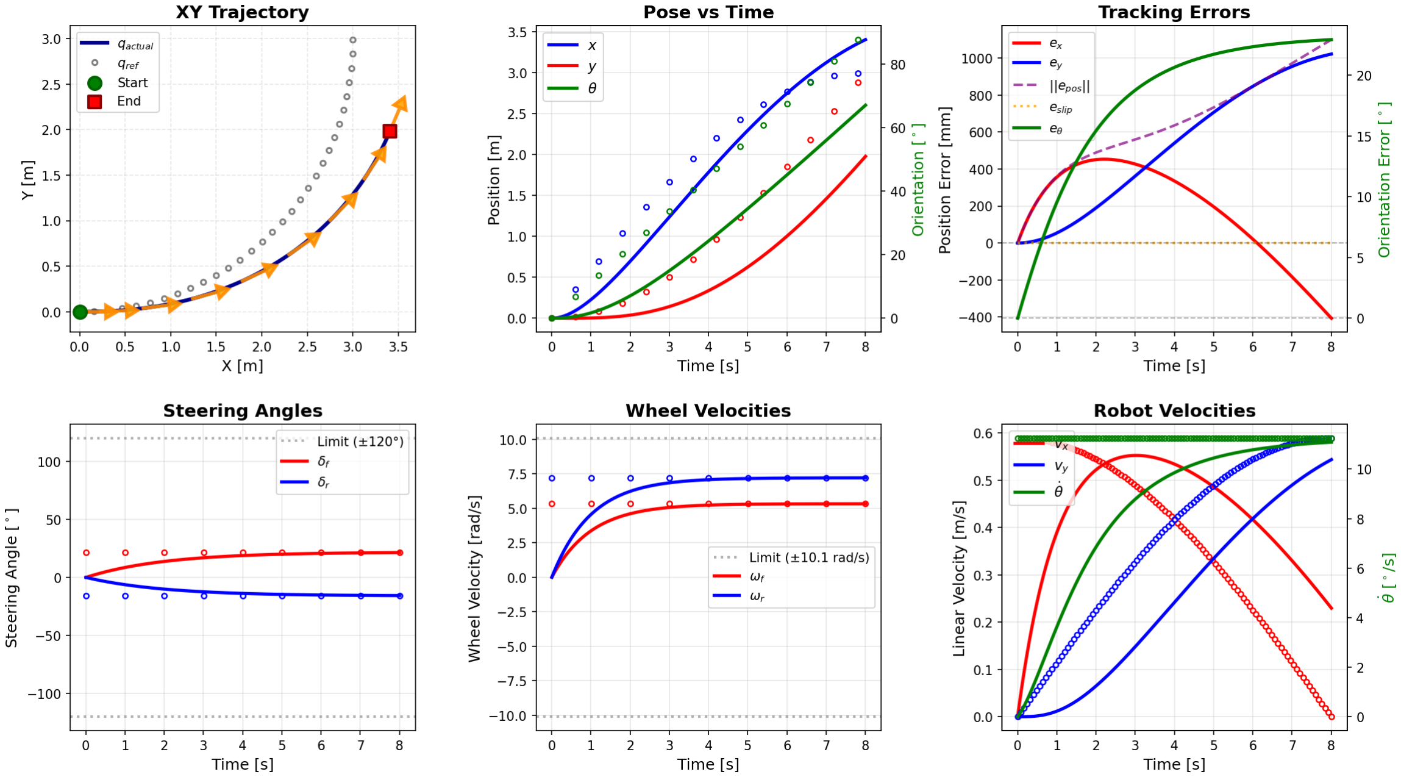
[picture p197: figure]

Andrea Efficace (DAE/INN - Uni TVG) | Tesi di Laurea Magistrale | Anno Accademico 2024/2025 | 37 / 62

### Risultati Feedforward

Traiett. | Mod. | Supp. | Pos. [mm] | Orient. [◦
]
Str. | Bic. | x | 418.05 | 0.00
| Bis. | x | 418.05 | 0.00
Arc | Bic. | x | 749.92 | 20.80
| Bis. | x | 694.70 | 18.85
Cra. | Bic. | – | 1154.82 | 0.00
| Bis. | x | 334.44 | 0.00
Spi. | Bic. | – | 0.00 | 103.93
| Bis. | x | 0.00 | 25.93

Osservazioni:
Biciclo FALLISCE su Crab e Spin (singolarità)

Doppio Sterzo gestisce tutte le manovre

Errori elevati per assenza di feedback

Andrea Efficace (DAE/INN - Uni TVG) | Tesi di Laurea Magistrale | Anno Accademico 2024/2025 | 38 / 62

### Schema di Controllo: PID + Feedforward

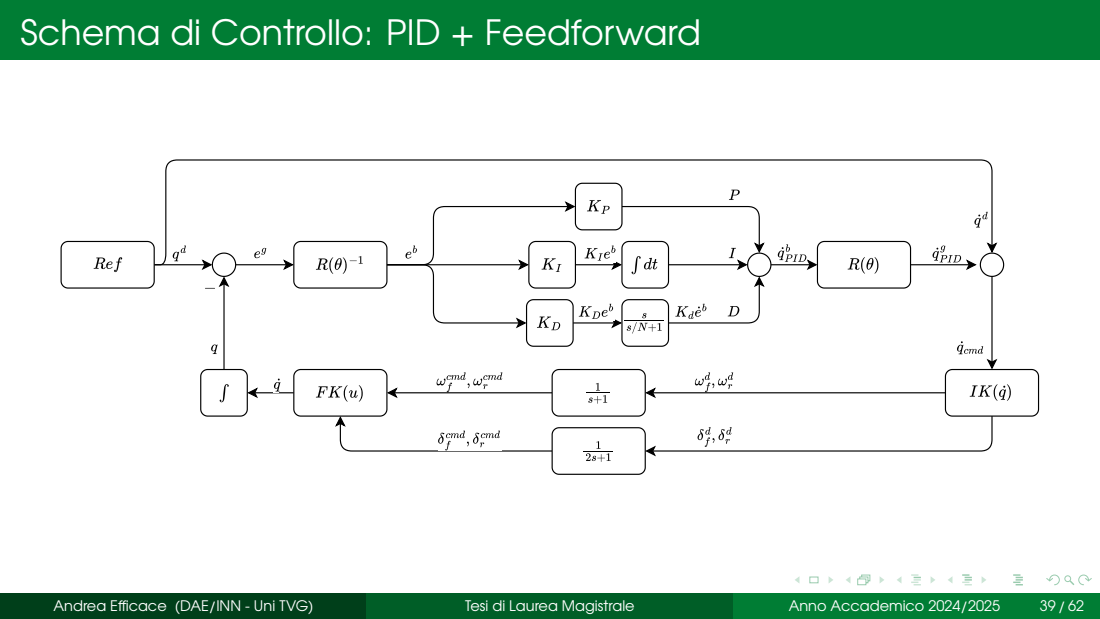
[picture p198: page 39]
Andrea Efficace (DAE/INN - Uni TVG); Tesi di Laurea Magistrale; Anno Accademico 2024/2025

### Dettagli Implementazione PID

Legge di controllo:

e

b = R

−1
(θ)

xd − x
yd − y
θd − θ
- (errore in body frame) | (7)

q˙

b
iPID
(t) = Kp,ie

b
i

+ Ki,i

Z
e

b
i

dτ + Kd,i

deb
i
dt
, | i ∈ {x, y, θ} | (8)

q˙ cmd = q˙

d + R(θ)q˙

b
iPID
| | (9)
u = IK(q˙ cmd) | (10)
Andrea Efficace (DAE/INN - Uni TVG) | Tesi di Laurea Magistrale | Anno Accademico 2024/2025 | 40 / 62

### Dettagli Implementazione PID

Guadagni utilizzati:

Comp. | Kp | Ki | Kd | Imax | N
x, y | 0.3 | 0.05 | 0.1 | 2 | 20
θ | 0.2 | 0.02 | 0.05 | 1 | 20

Accorgimenti implementativi: Derivata filtrata: D(s) = Kds
s/N+1

(riduce rumore)

Anti-windup: saturazione integrale per evitare wind-up

Scaling proporzionale: mantiene rapporto tra ux , uy sotto vmax

Saturazione angolare: |uθ| ≤ ωmax

Andrea Efficace (DAE/INN - Uni TVG) | Tesi di Laurea Magistrale | Anno Accademico 2024/2025 | 41 / 62

### Risultati PID+FF: Traiettoria Arc – Biciclo

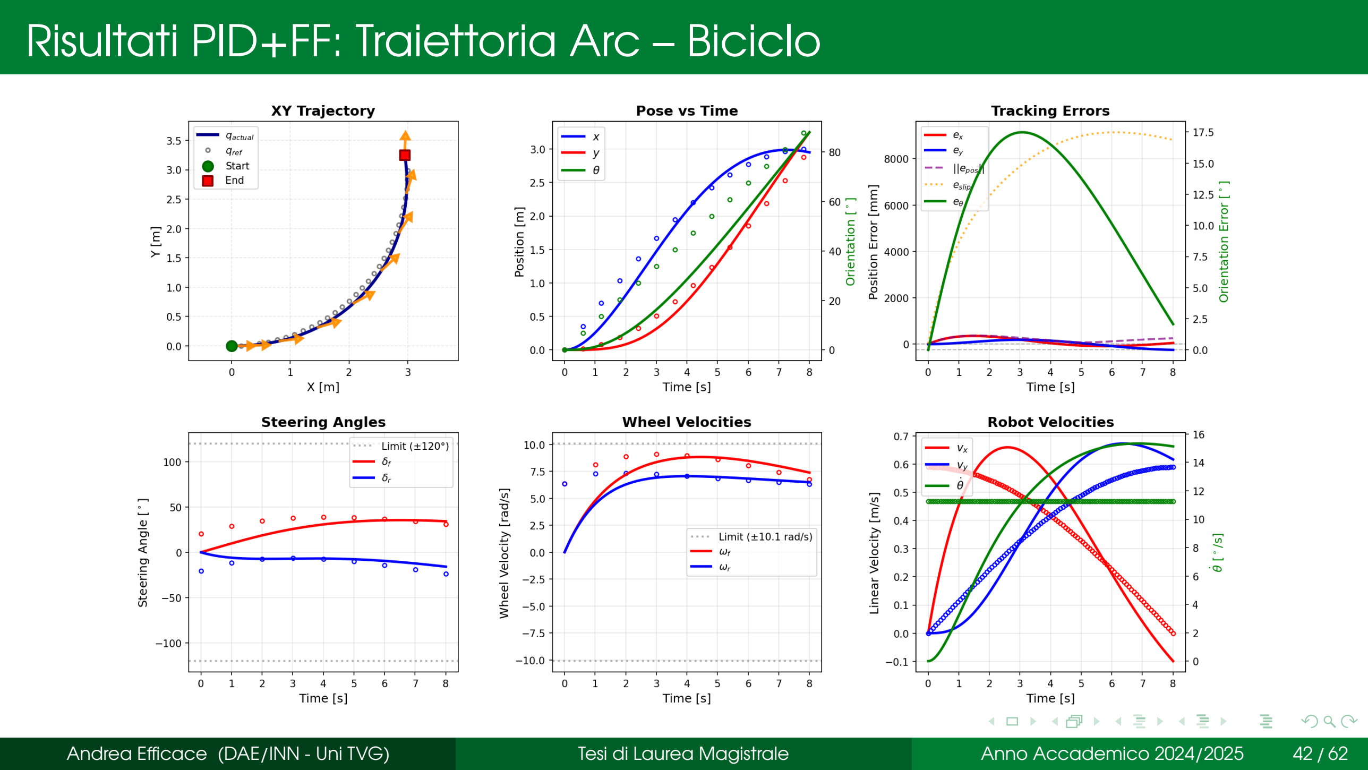
[picture p199: page 42]

Andrea Efficace (DAE/INN - Uni TVG) | Tesi di Laurea Magistrale | Anno Accademico 2024/2025 | 42 / 62

### Risultati PID+FF: Traiettoria Arc – Doppio Sterzo

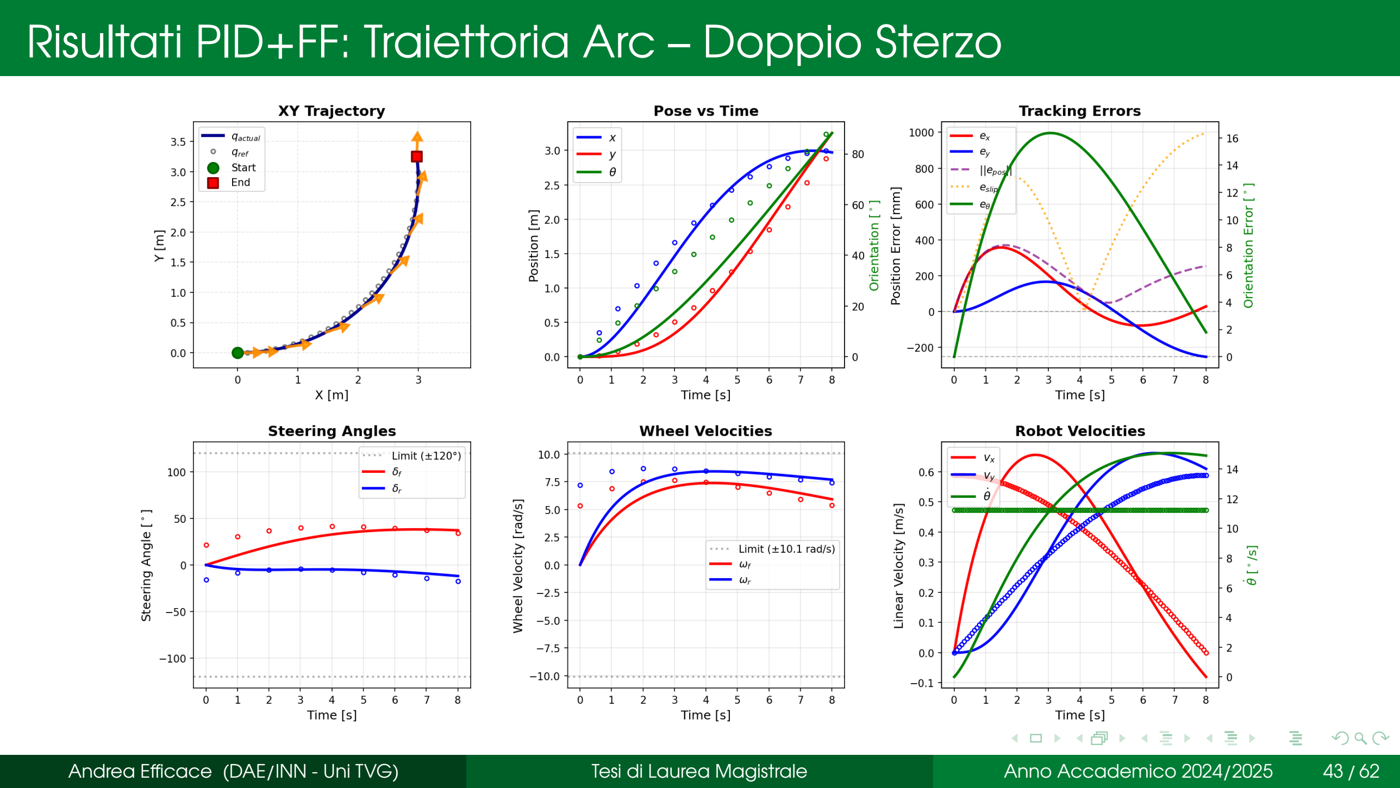
[picture p200: page 43]

Andrea Efficace (DAE/INN - Uni TVG) | Tesi di Laurea Magistrale | Anno Accademico 2024/2025 | 43 / 62

### Risultati PID+FF: Confronto e Miglioramenti

Traiett. | Mod. | Supp. | Pos. [mm] | Orient. [◦
]
Str. | Bic. | x | 233.96 | 0.00
| Bis. | x | 233.96 | 0.00
Arc | Bic. | x | 231.27 | 12.53
| Bis. | x | 229.57 | 11.66
Cra. | Bic. | – | 1154.82 | 0.00
| Bis. | x | 187.17 | 0.00
Spi. | Bic. | – | 0.00 | 103.93
| Bis. | x | 0.00 | 16.14

Miglioramenti vs FF:
Str: 418 → 234 mm

Arc: 695 → 230 mm

Crab: 334 → 187 mm

Spin: 26◦ → 16◦

Andrea Efficace (DAE/INN - Uni TVG) | Tesi di Laurea Magistrale | Anno Accademico 2024/2025 | 44 / 62

### Conclusioni: Confronto Modelli Cinematici

Modello Biciclo
+ Testato in letteratura

+ Estensione dinamica disponibile

- Singolarità: Crab e Spin impossibili
- β → ∞ per δ → π/2

Modello Doppio Sterzo
+ Nessuna singolarità

+ Supporta tutte le manovre

+ Prestazioni migliori con PID

! Pseudoinversa può violare vincoli

Scelta finale: Modello Doppio Sterzo per maggiore versatilità.

Andrea Efficace (DAE/INN - Uni TVG) | Tesi di Laurea Magistrale | Anno Accademico 2024/2025 | 45 / 62

### Roadmap

1 | Introduzione
2 | Stato dell’arte: robot mobili, navigazione e protocolli
3 | Requisiti e Componenti
4 | Modellazione Cinematica e Controllo
5 | Architettura Software e Comunicazione
6 | Conclusioni e Sviluppi Futuri
Andrea Efficace (DAE/INN - Uni TVG) | Tesi di Laurea Magistrale | Anno Accademico 2024/2025 | 46 / 62

### Problema di Integrazione Hardware-Software

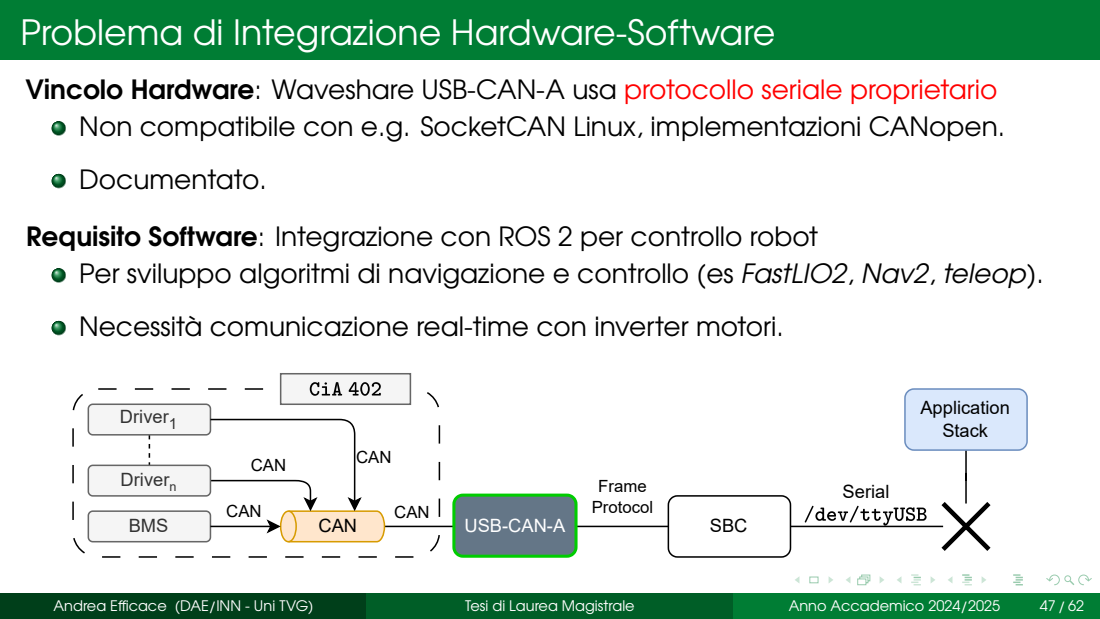
[picture p201: page 47]
Documentato.; Driver1; CAN; Frame Protocol; USB-CAN-A; SBC; Drivern; BMS; Serial; Application Stack; CAN CAN; Andrea Efficace (DAE/INN - Uni TVG); Tesi di Laurea Magistrale; Anno Accademico 2024/2025

Vincolo Hardware: Waveshare USB-CAN-A usa protocollo seriale proprietario
Non compatibile con e.g. SocketCAN Linux, implementazioni CANopen.

Requisito Software: Integrazione con ROS 2 per controllo robot
Per sviluppo algoritmi di navigazione e controllo (es FastLIO2, Nav2, teleop).

Necessità comunicazione real-time con inverter motori.

### Architettura Software: SocketCAN Bridge

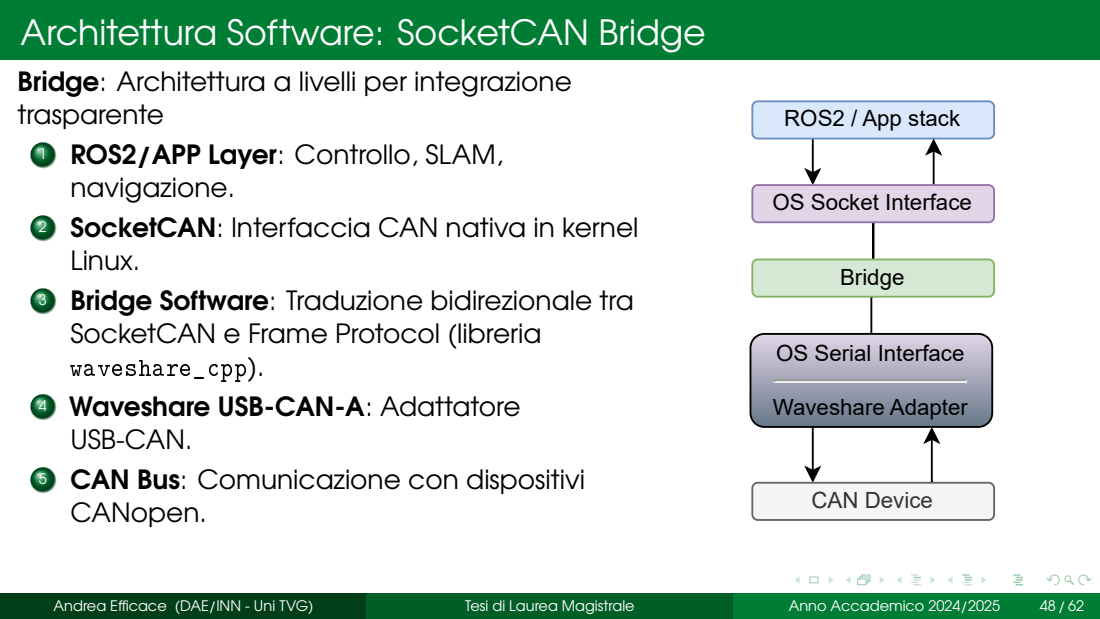
[picture p202: page 48]
ROS2/APP Layer: Controllo, SLAM,; SocketCAN: Interfaccia CAN nativa in kernel; Bridge Software: Traduzione bidirezionale tra; Waveshare USB-CAN-A: Adattatore; CAN Bus: Comunicazione con dispositivi; ROS2 / App stack; Bridge; Waveshare Adapter; CAN Device; Andrea Efficace (DAE/INN - Uni TVG); Tesi di Laurea Magistrale; Anno Accademico 2024/2025

Bridge: Architettura a livelli per integrazione
trasparente
navigazione.
Linux.
SocketCAN e Frame Protocol (libreria
waveshare_cpp).
USB-CAN.
CANopen.

OS Socket Interface

OS Serial Interface

Libreria waveshare_cpp

Scopo: Gestione protocollo proprietario USB-CAN-A (Waveshare) per (de)serializzare frame CAN su USB.

Funzionalità principali:
Encoding/decoding frame CAN
- Standard ID (11-bit) ed Extended ID (29-bit).
- Payload fino a 8 byte per frame.

Configurazione adapter e interfaccia seriale
- Baud rate CAN bus (50 kbps – 1 Mbps).
- Filtri e maschere per ricezione ID-based.

Gestione thread-safe
- Accesso concorrente lettura/scrittura.
- Sincronizzazione automatica
Andrea Efficace (DAE/INN - Uni TVG) | Tesi di Laurea Magistrale | Anno Accademico 2024/2025 | 49 / 62

### Bridge USB ↔ SocketCAN

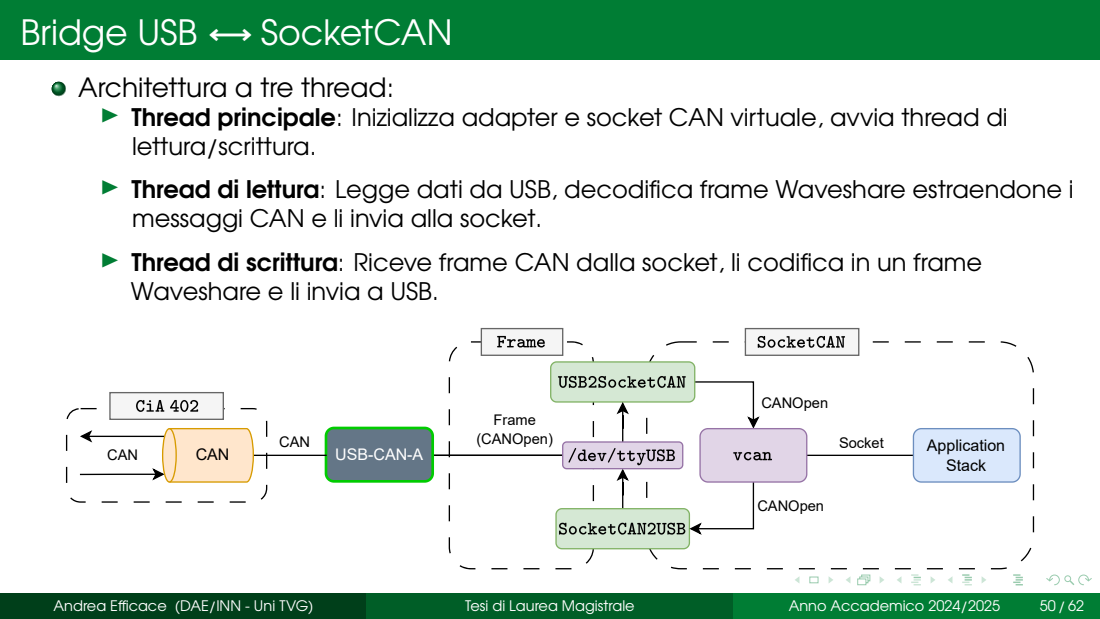
[picture p203: page 50]
CAN; USB-CAN-A; Socket; Application; Stack CAN; Frame (CANOpen); CANOpen; Andrea Efficace (DAE/INN - Uni TVG); Tesi di Laurea Magistrale; Anno Accademico 2024/2025

Architettura a tre thread:
▶ Thread principale: Inizializza adapter e socket CAN virtuale, avvia thread di
lettura/scrittura.
▶ Thread di lettura: Legge dati da USB, decodifica frame Waveshare estraendone i
messaggi CAN e li invia alla socket.
▶ Thread di scrittura: Riceve frame CAN dalla socket, li codifica in un frame
Waveshare e li invia a USB.

### Stack Completo di Comunicazione e Controllo

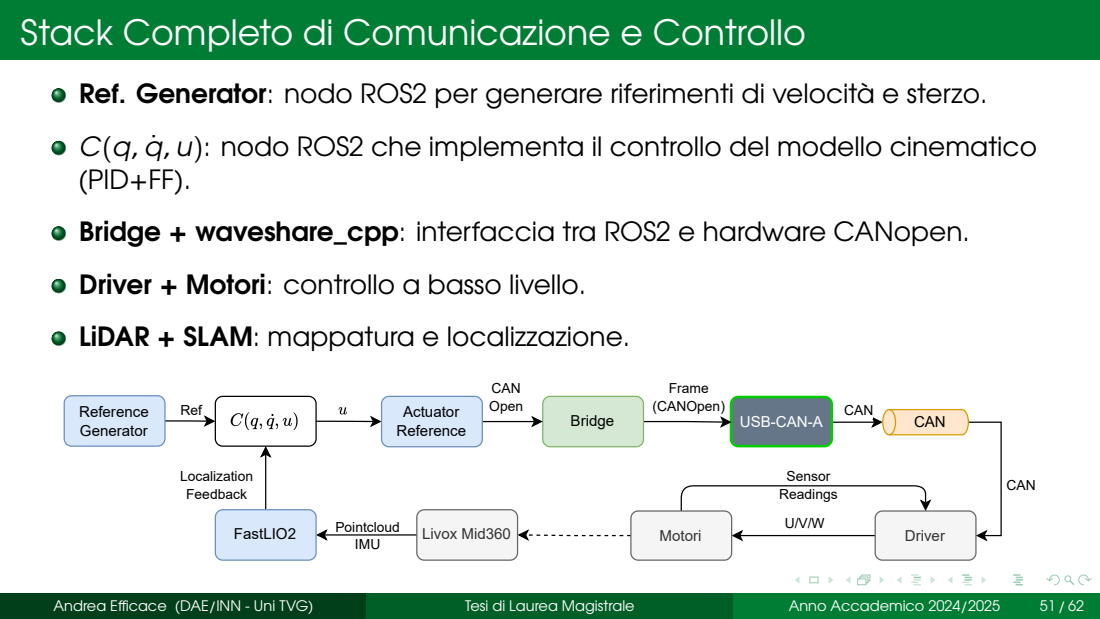
[picture p204: page 51]
Pointcloud IMU; Sensor Readings; Driver; CAN; USB-CAN-A; Ref; Livox Mid360; Reference Generator; Frame (CANOpen); Bridge; CAN Open Actuator Reference; FastLIO2; Motori; Localization Feedback; Andrea Efficace (DAE/INN - Uni TVG); Tesi di Laurea Magistrale; Anno Accademico 2024/2025

Ref. Generator: nodo ROS2 per generare riferimenti di velocità e sterzo.

C(q,q˙ , u): nodo ROS2 che implementa il controllo del modello cinematico
(PID+FF).

Bridge + waveshare_cpp: interfaccia tra ROS2 e hardware CANopen.

Driver + Motori: controllo a basso livello.

LiDAR + SLAM: mappatura e localizzazione.

### Roadmap

1 | Introduzione
2 | Stato dell’arte: robot mobili, navigazione e protocolli
3 | Requisiti e Componenti
4 | Modellazione Cinematica e Controllo
5 | Architettura Software e Comunicazione
6 | Conclusioni e Sviluppi Futuri
Andrea Efficace (DAE/INN - Uni TVG) | Tesi di Laurea Magistrale | Anno Accademico 2024/2025 | 52 / 62

### Conclusioni

Rispetto ai requisiti iniziali, il progetto proposto ha raggiunto i seguenti obiettivi: Dimensionamento dei componenti meccanici ed elettrici rispetto alle specifiche di carico e prestazioni richieste.

Selezione e acquisto dei materiali da diversi fornitori, acquisendo contatti per collaborazioni future.

Progettazione e realizzazione di un dimostratore, con predisposizione per diversi layout di configurazione.

Proposta di un’architettura di controllo per l’inseguimento di traiettorie.

Sviluppo di un’architettura software per la comunicazione con gli inverter delle motoruote mediante adattatore USB, trasparente ad implementazioni CANOpen.

Andrea Efficace (DAE/INN - Uni TVG) | Tesi di Laurea Magistrale | Anno Accademico 2024/2025 | 53 / 62

### Stato Attuale: Software

Libreria di comunicazione con adattatore USB-CAN-A ampiamente testata.

Architettura software definita e parzialmente implementata.
- Mancanti: Nodi ROS2 per generazione traiettorie e invio comandi.

Nodi ROS2 per l’avvio e la gestione dell’architettura di comunicazione, con pubblicazione dello stato dei motori e lettura dei sensori.

Simulazione in Python dell’architettura di controllo per l’inseguimento di traiettorie.

Andrea Efficace (DAE/INN - Uni TVG) | Tesi di Laurea Magistrale | Anno Accademico 2024/2025 | 54 / 62

### Stato Attuale: Hardware

Acquisto di tutto l’hardware elencato completato.

Proposto schema di cablaggio per l’integrazione dei sistemi su un banco di prova.

Realizzazione del banco di prova per la validazione dei sistemi e dell’architettura software.


Figura 4: Banco di test per una motoruota.

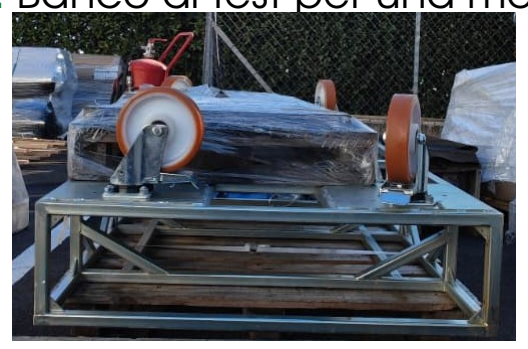
[picture p205: figure]

Figura 5: Carrello e lamiere

Andrea Efficace (DAE/INN - Uni TVG) | Tesi di Laurea Magistrale | Anno Accademico 2024/2025 | 55 / 62

### Sviluppi Futuri

1 | Implementazione Hardare e Software
| ▶ Completare e integrare lo stack software completo su robot fisico,
| ▶ Assemblaggio e cablaggio dei componenti hardware.
2 | Validazione Sperimentale
| ▶ Test su campo presso stabilimento Daikin Ariccia,
| ▶ Misurazione prestazioni: precisione tracking, autonomia, affidabilità,
| ▶ Ottimizzazione parametri controllo su dati reali,
3 | Estensioni
| ▶ Fleet management per coordinamento multi-robot,
| ▶ Integrazione con MES aziendale per pianificazione trasporti,
| ▶ Sensori addizionali: telecamere RGB-D, safety laser scanner.
| ▶ Test di altri modelli cinematici e/o dinamici e architetture di controllo avanzate.
Andrea Efficace (DAE/INN - Uni TVG) | Tesi di Laurea Magistrale | Anno Accademico 2024/2025 | 56 / 62

### Grazie per l’attenzione!


Figura 6: Mockup del veicolo progettato; nome in codice: Cocco

Andrea Efficace (DAE/INN - Uni TVG) | Tesi di Laurea Magistrale | Anno Accademico 2024/2025 | 57 / 62

### Appendice: IK Biciclo – Centro Inst. di Rotazione (ICR)

Concetto: punto attorno al quale il veicolo sta ruotando in un dato istante

L’ICR si trova all’intersezione degli assi di rotazione delle ruote (perpendicolari alla direzione di avanzamento):
xICR

yICR
= p

b
f

+ sf

− sin(δf)
cos(δf)
= p

b
r

+ sr

− sin(δr)
cos(δr)
(11)

Risolvendo per sf

, sr si trovano i raggi di curvatura delle ruote:

Rf =

vu
t
xICR −

L

2

2
+ (yICR)

2
, Rr =

vu
t
xICR +

L

2

2
+ (yICR)

2
(12)

Condizione di compatibilità (moto senza slittamento):

θ˙ = r

ωf

Rf

= r

ωr

Rr

⇒ | Rrωf = Rf ωr | (13)

Caso δf = δr

: ICR → ∞, traslazione pura con ωf = ωr

Andrea Efficace (DAE/INN - Uni TVG) | Tesi di Laurea Magistrale | Anno Accademico 2024/2025 | 58 / 62

### Appendice: IK Biciclo

Problema: dato (x˙d, y˙d, θ˙
d), calcolare (δf, δr, ωf, ωr)

Passo 1: Calcolare velocità e side-slip desiderati

vd =

Ç
x˙

2
d

+ y˙

2
d

(14)

βd = atan2 (y˙d, x˙d) − θ | (15)

Passo 2: Definendo S = tan(βd), D =

lθ˙
d
vd cos(βd)

, da (1) e (3):
¨
lS = lf tan(δr) + lr tan(δf) D = tan(δf) − tan(δr)

⇒

δf = arctan
S +

lf

l

D

δr = arctan
S −

lr

l

D

| (16)

Passo 3: Calcolare ωf

, ωr da raggi ICR Rf

, Rr e condizione di compatibilità

Andrea Efficace (DAE/INN - Uni TVG) | Tesi di Laurea Magistrale | Anno Accademico 2024/2025 | 59 / 62

### Appendice: IK Biciclo – Caso θ˙ d = 0 (Parte 1)

Derivazione per traslazione pura

Quando θ˙
d = 0, l’ICR → ∞ e le direzioni di avanzamento delle ruote diventano parallele.
Step 1: Imporre δf = δr = δ (sterzi paralleli)
Step 2: Dalla relazione del side-slip angle:

βd = tan⁻¹

lf + lr

lf + lr

tan(δ)

= δ | (17)

Quindi il side-slip angle coincide con l’angolo di sterzo quando le ruote sono parallele.

Andrea Efficace (DAE/INN - Uni TVG) | Tesi di Laurea Magistrale | Anno Accademico 2024/2025 | 60 / 62

### Appendice: IK Biciclo – Caso θ˙ d = 0 (Parte 2)

Calcolo angoli di sterzo e velocità

Step 3: Combinando βd = δ con βd = atan2 (y˙d, x˙d) − θ:
δf = δr = δ = atan2 (y˙d, x˙d) − θ | (18)
Step 4: Le velocità angolari sono uguali (condizione di compatibilità per ICR → ∞):

ωf = ωr =

vd

r

=

q
x˙

2
d

+ y˙

2
d
r

(19)

Andrea Efficace (DAE/INN - Uni TVG) | Tesi di Laurea Magistrale | Anno Accademico 2024/2025 | 61 / 62

### Appendice: IK Doppia Ruota Sterzante

Problema: dato (x˙d, y˙d, θ˙
d), calcolare (δf, δr, ωf, ωr) ⇒Soluzione diretta dai vincoli di non-slittamento e puro rotolaento: Angoli di sterzo (dalle eq. non-slip):

δf = atan2
y˙d + θ˙
d

L

2

, x˙d − θ˙
d

W

2

(20)

δr = atan2
y˙d − θ˙
d

L

2

, x˙d + θ˙
d

W

2

(21)

Velocità angolari ruote (dalle eq. rotolamento):

ωf =

(y˙d + θ˙
d

L
2

) sin(δf) + (x˙d − θ˙
d

W
2

) cos(δf)

r

(22)

ωr =

(y˙d − θ˙
d

L
2

) sin(δr) + (x˙d + θ˙
d

W
2

) cos(δr)

r

(23)

Caso speciale θ˙
d = 0: δf = δr = atan2 (y˙d, x˙d), ωf = ωr =

vd
r
Andrea Efficace (DAE/INN - Uni TVG) | Tesi di Laurea Magistrale | Anno Accademico 2024/2025 | 62 / 62
