effibot/thesis_latex/img/comm/comm_arch_problem.pdf

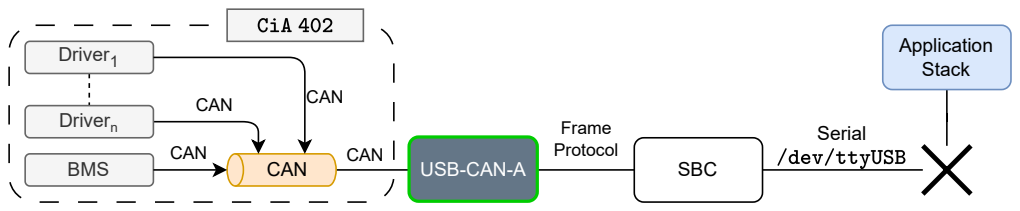
[picture p206: page 1]
Driver 1; CAN; Frame Protocol; USB-CAN-A; SBC; Driver n; BMS; Serial; Application Stack; CAN CAN
