effibot/thesis_latex/img/comm/bridge_scheme.pdf

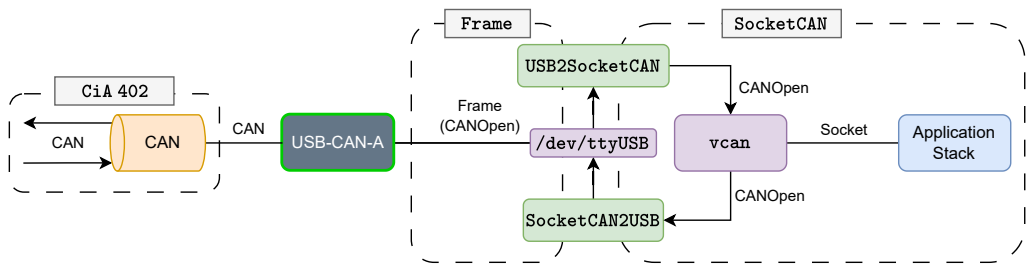
[picture p207: page 1]
CAN; USB-CAN-A; Socket; Application; Stack CAN; Frame (CANOpen); CANOpen
