effibot/thesis_latex/img/comm/comm_arch_sol.pdf

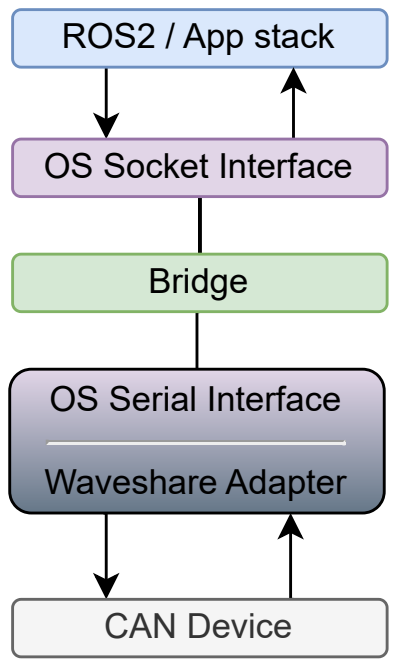
[picture p208: page 1]
ROS2 / App stack; Bridge; Waveshare Adapter; CAN Device

OS Socket Interface

OS Serial Interface
