effibot/thesis_latex/img/4/FF_PID.pdf

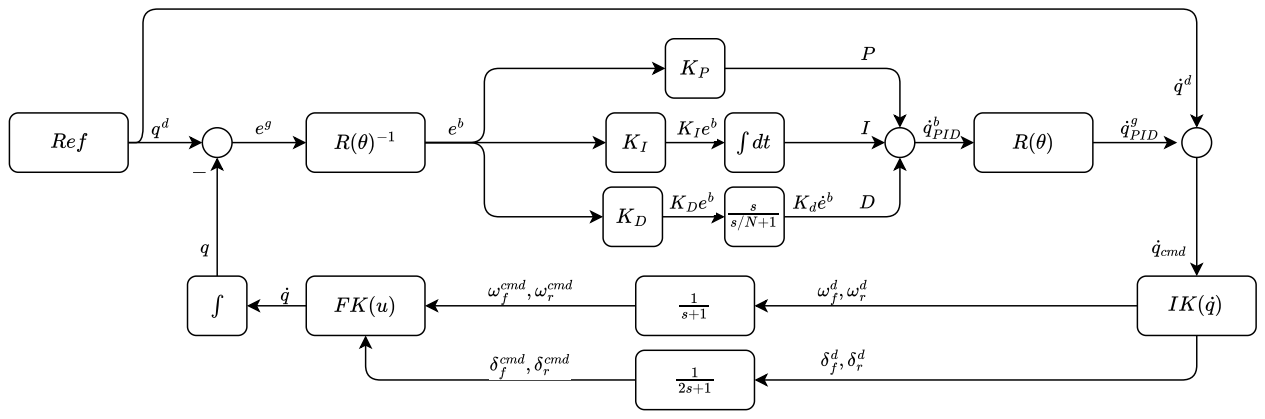
[picture p209: page 1]
