effibot/thesis_latex/img/4/schema_modello.pdf

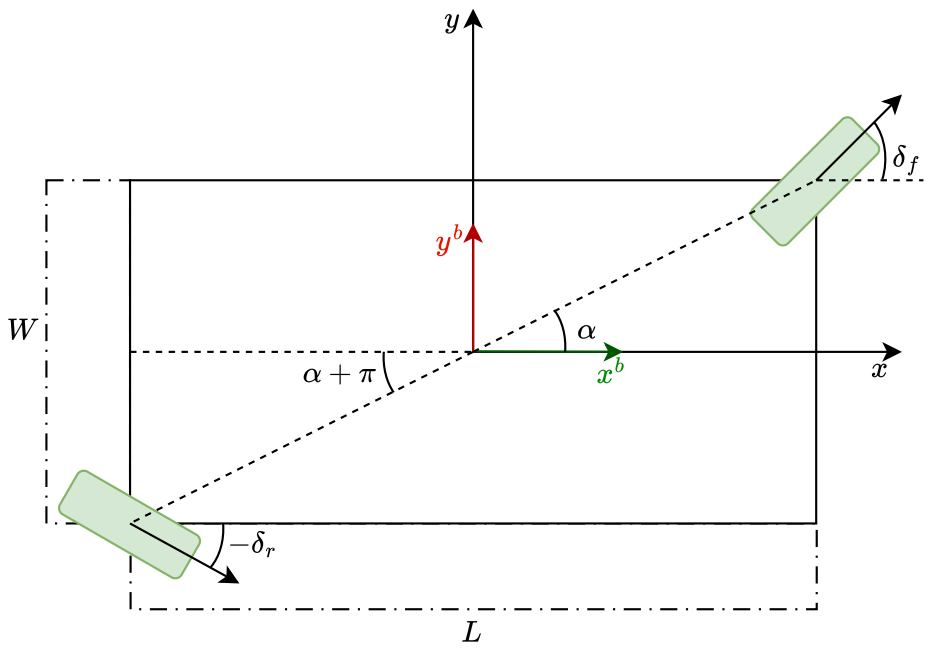
[picture p210: page 1]
