effibot/thesis_latex/img/4/schema_modello_2.pdf

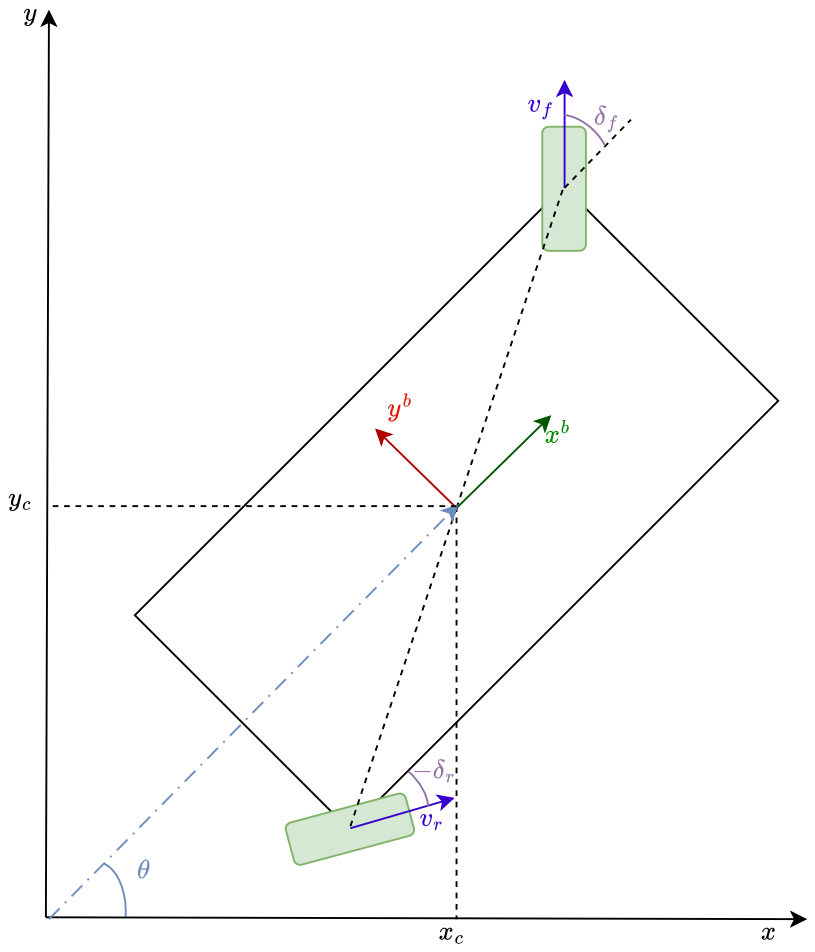
[picture p211: page 1]
