effibot/thesis_latex/img/3/2wd_steering.pdf

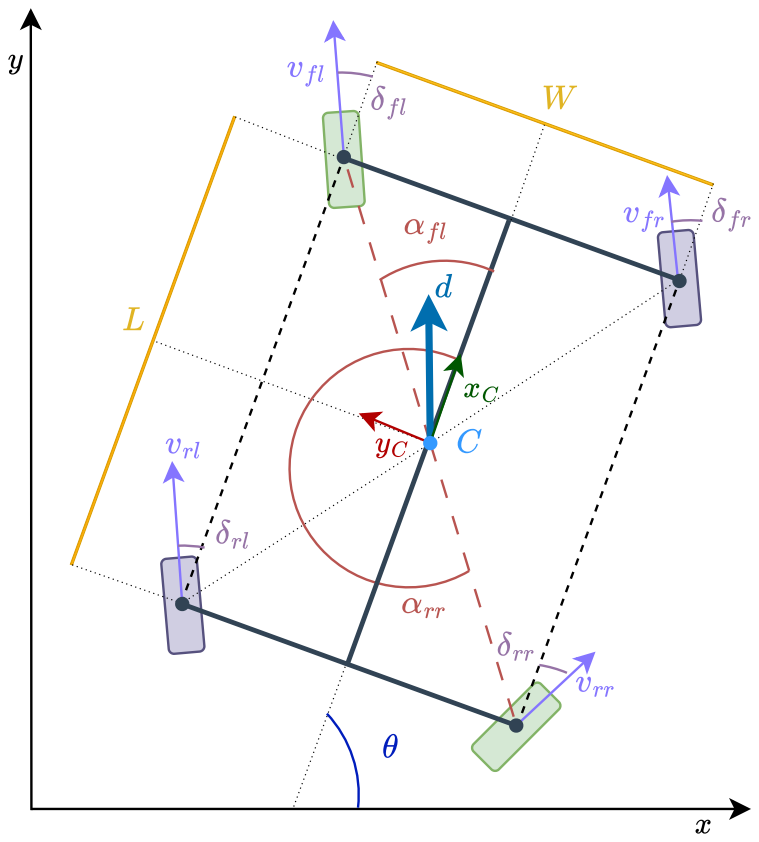
[picture p212: page 1]
