effibot/thesis_latex/(commit log)

2025-12-09 porting from old repo
    [00-P-PT0151.SLDPRT, 00-P-PT0152.SLDPRT, 00-P-PT0153.SLDPRT, 00-P-PT0154-2.SLDPRT, 00-P-PT0154-3.SLDPRT, 00-P-PT0154.SLDPRT, 00-P-PT0172.step.SLDPRT, AGV_body.DWG]
2025-12-09 images and battery
2025-12-09 computer di bordo, driver e sensoristica
